PaxInstruments/t400-electronics/eagle/T400 Panel recommendation.pptx

Slot for USB connector

Slot for LCD cable

Slot for USB connector

V groove
