PaxInstruments/t400-electronics/documentation/enclosure-front-default.png

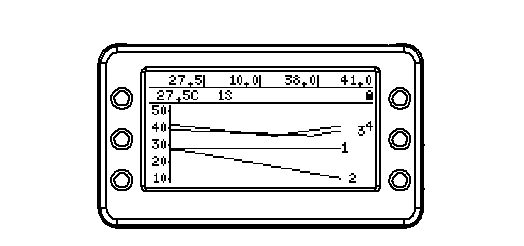
documentation/enclosure-front-default.png
