PaxInstruments/t400-electronics/documentation/u8g_font_fur42n.png

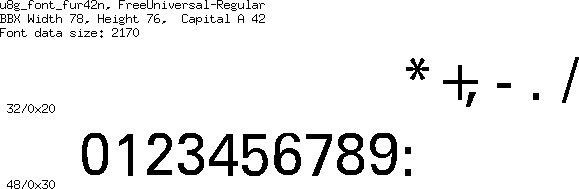
documentation/u8g_font_fur42n.png
