PaxInstruments/t400-electronics/eagle/ProductionNotes.png

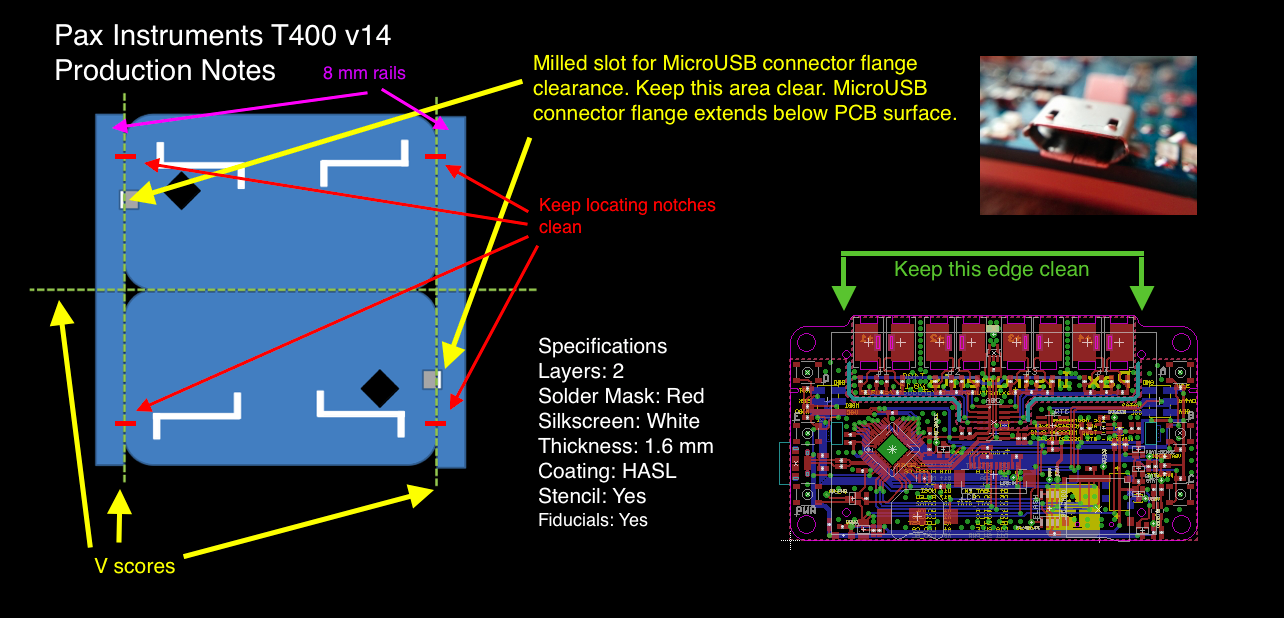
eagle/ProductionNotes.png
