PaxInstruments/t400-electronics/eagle/T400 Rev 0.14/IMG_20151219_102409.jpg

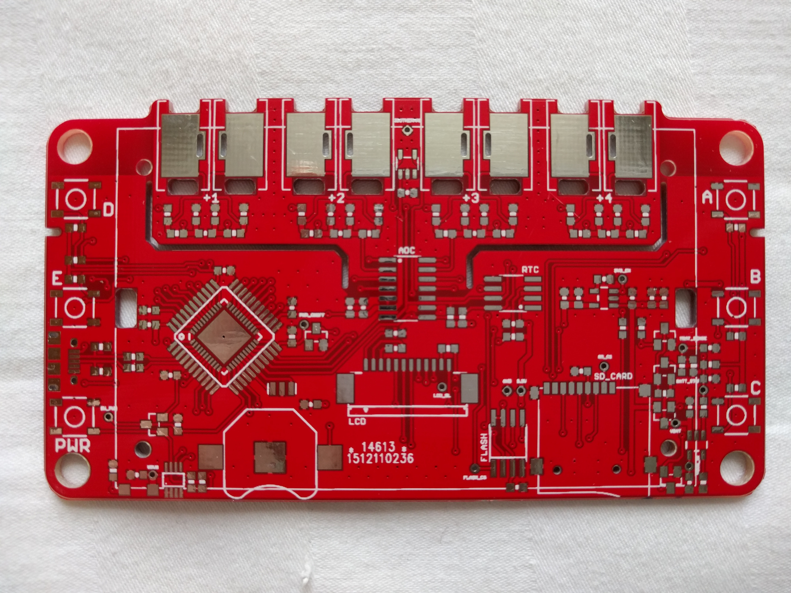
eagle/T400 Rev 0.14/IMG_20151219_102409.jpg
