PaxInstruments/t400-electronics/eagle/T400 Rev 0.14/PaxInstrument-T400-location.png

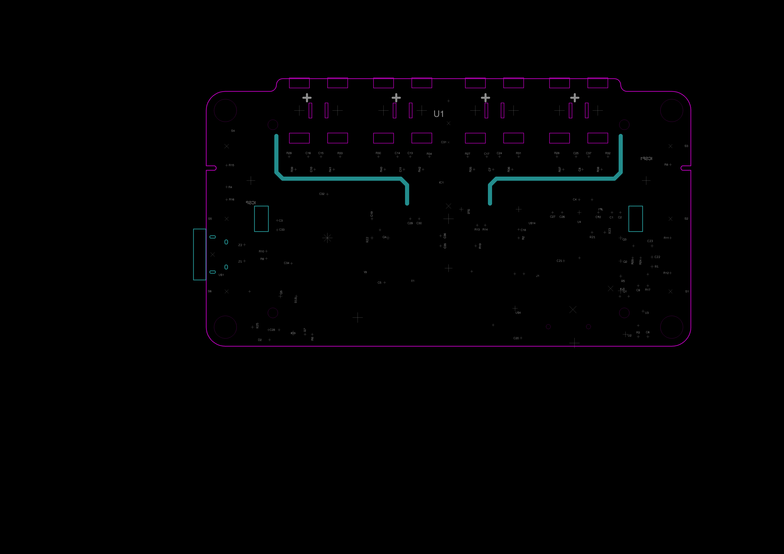
eagle/T400 Rev 0.14/PaxInstrument-T400-location.png
