PaxInstruments/t400-electronics/referenceDesigns/Arduino-leonardo-photo-back-headers.jpg

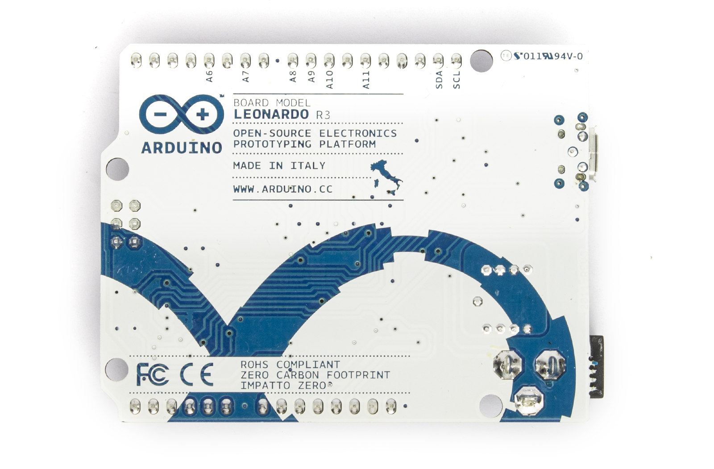
referenceDesigns/Arduino-leonardo-photo-back-headers.jpg
