PaxInstruments/t400-electronics/referenceDesigns/Arduino-leonardo-photo-front-headers.jpg

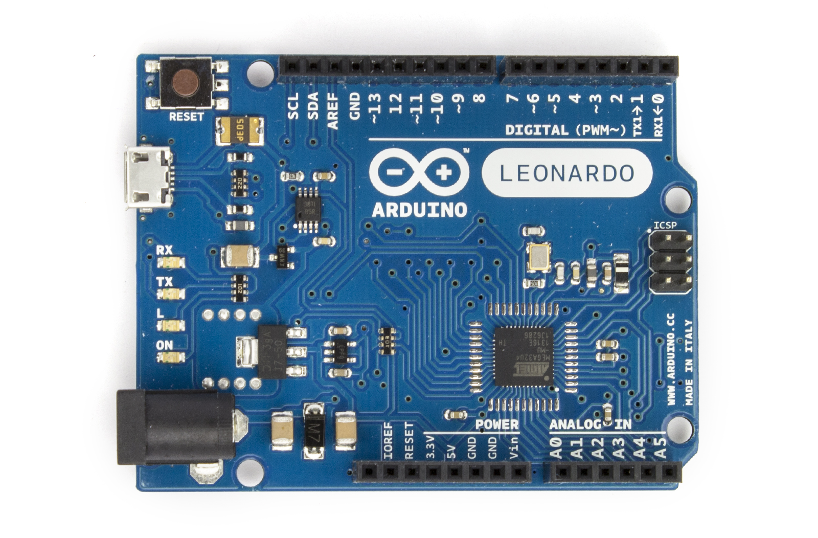
referenceDesigns/Arduino-leonardo-photo-front-headers.jpg
