PaxInstruments/t400-electronics/referenceDesigns/Arduino-leonardo-photo-front-noheaders.jpg

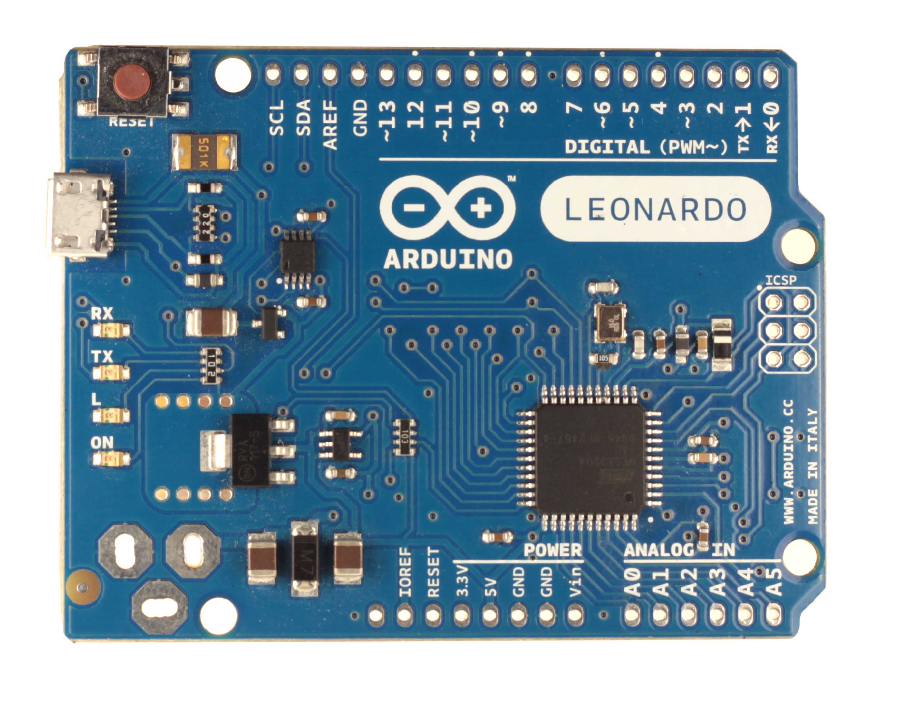
referenceDesigns/Arduino-leonardo-photo-front-noheaders.jpg
