PaxInstruments/t400-electronics/referenceDesigns/Arduino-lilypad-USB-photo-back.jpg

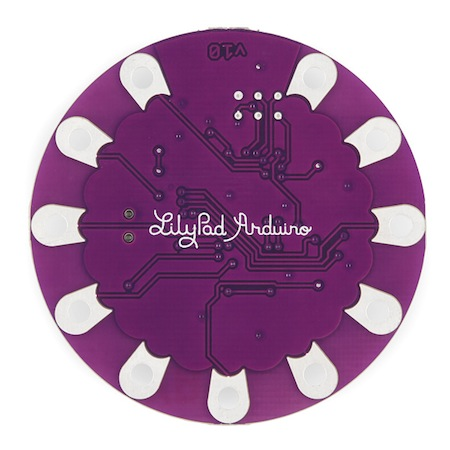
referenceDesigns/Arduino-lilypad-USB-photo-back.jpg
