PaxInstruments/t400-electronics/referenceDesigns/Arduino-lilypad-USB-photo-front.jpg

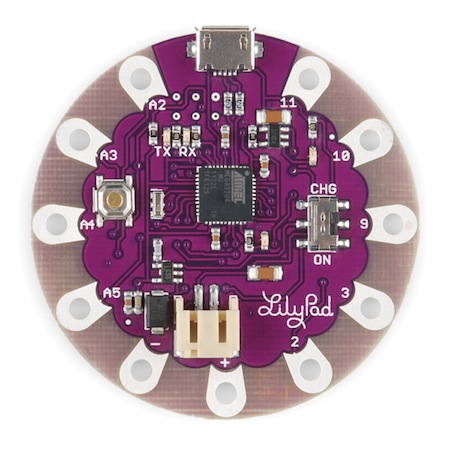
referenceDesigns/Arduino-lilypad-USB-photo-front.jpg
