PaxInstruments/t400-electronics/referenceDesigns/JeeLabs-analog-plug-photo.jpg

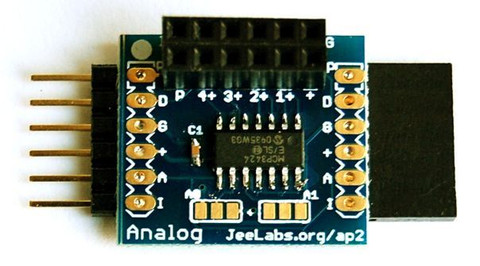
referenceDesigns/JeeLabs-analog-plug-photo.jpg
