PaxInstruments/t400-electronics/referenceDesigns/JeeLabs-jeenode-USB-photo-front.jpg

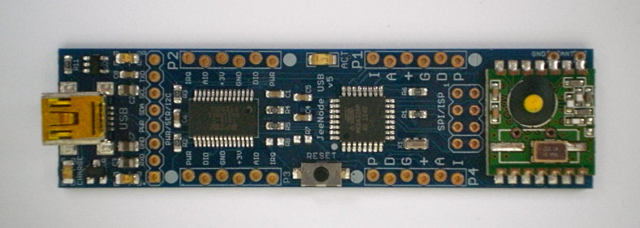
referenceDesigns/JeeLabs-jeenode-USB-photo-front.jpg
