PaxInstruments/t400-electronics/referenceDesigns/JeeLabs-precision-RTC-board.png

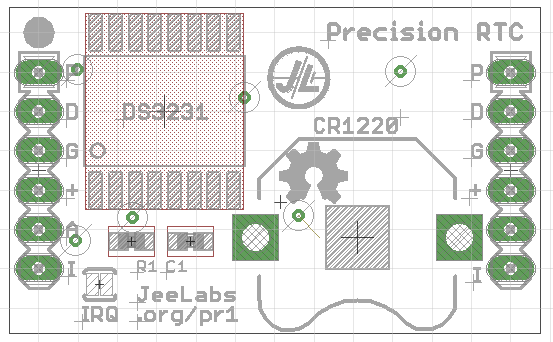
referenceDesigns/JeeLabs-precision-RTC-board.png
