PaxInstruments/t400-electronics/referenceDesigns/JeeLabs-precision-RTC-photo-front-pcb.jpg

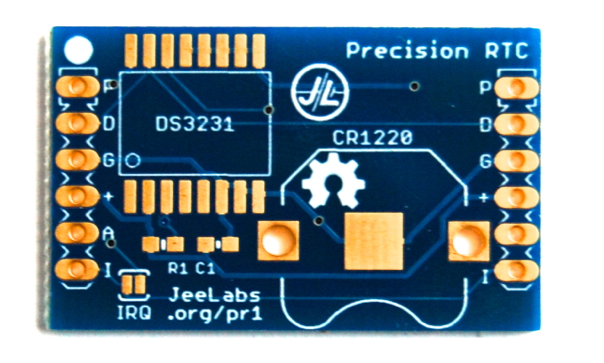
referenceDesigns/JeeLabs-precision-RTC-photo-front-pcb.jpg
