PaxInstruments/t400-electronics/referenceDesigns/JeeLabs-precision-RTC-photo-front.jpg

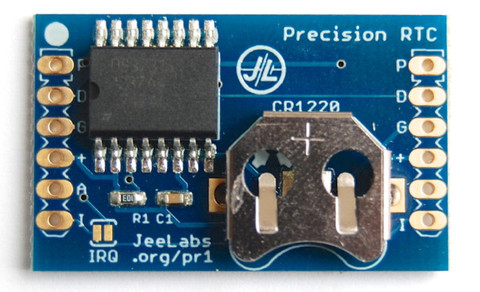
referenceDesigns/JeeLabs-precision-RTC-photo-front.jpg
