PaxInstruments/t400-electronics/referenceDesigns/LukeMiller-TC-mux-board-schematic.png

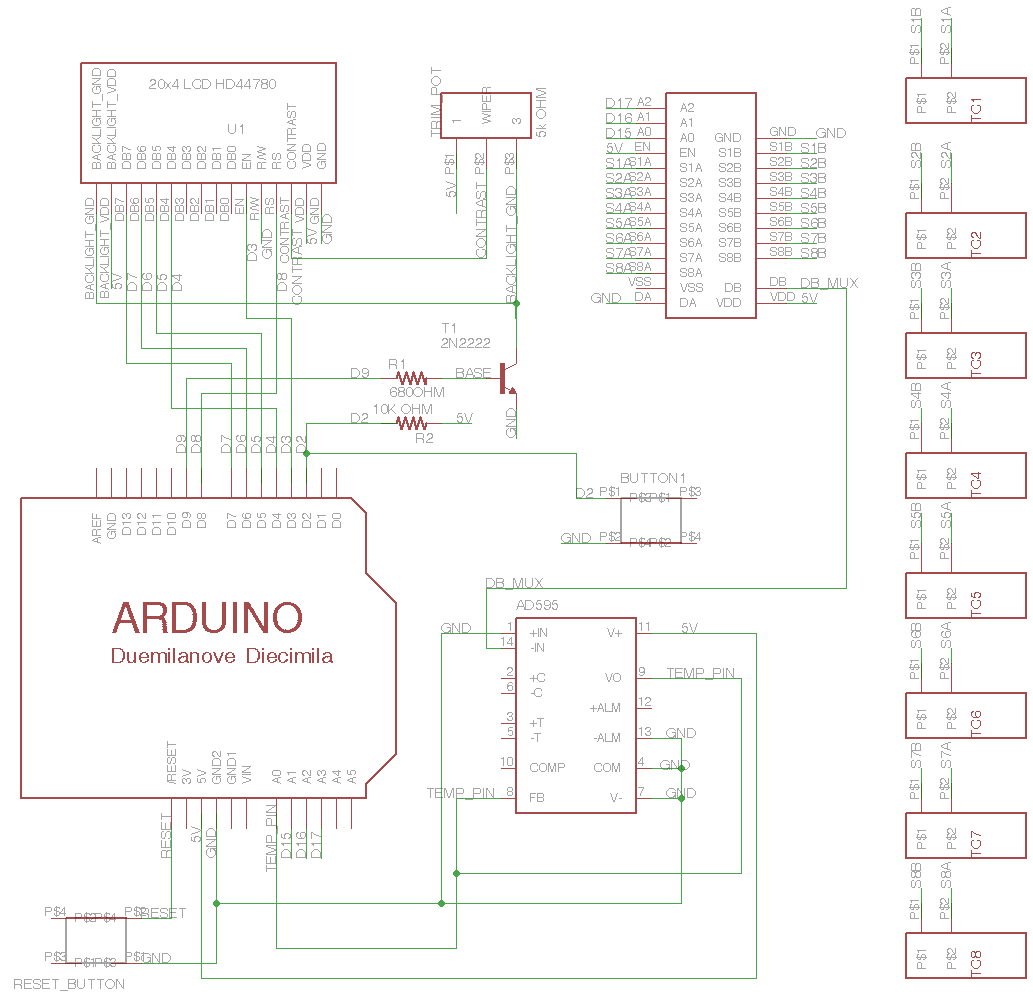
referenceDesigns/LukeMiller-TC-mux-board-schematic.png
