PaxInstruments/t400-electronics/referenceDesigns/MicroPython-board-photo-front-back.jpg

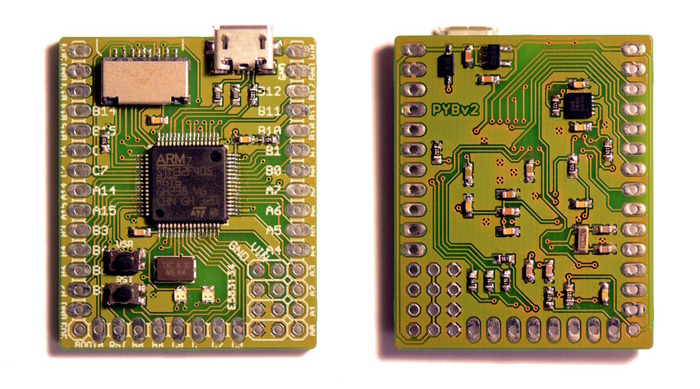
referenceDesigns/MicroPython-board-photo-front-back.jpg
