PaxInstruments/t400-electronics/referenceDesigns/SoftPowerCircuit.png

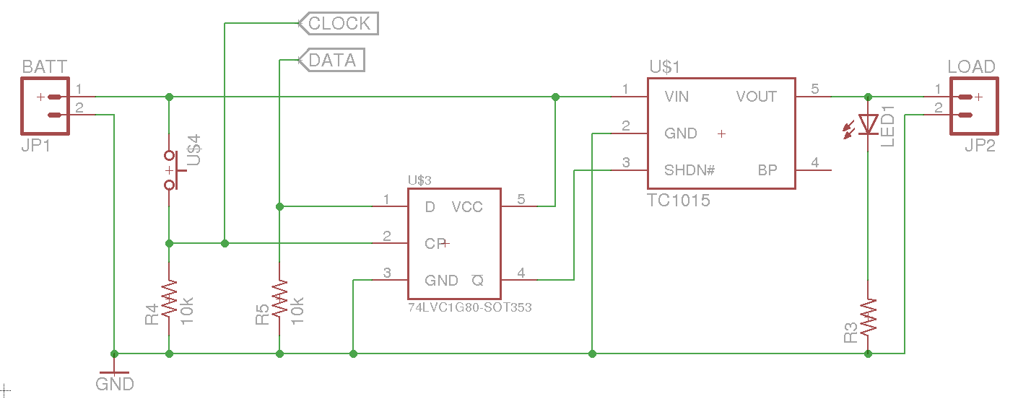
referenceDesigns/SoftPowerCircuit.png
