PaxInstruments/t400-electronics/referenceDesigns/TC4-shield-v5.30-photo-front.jpg

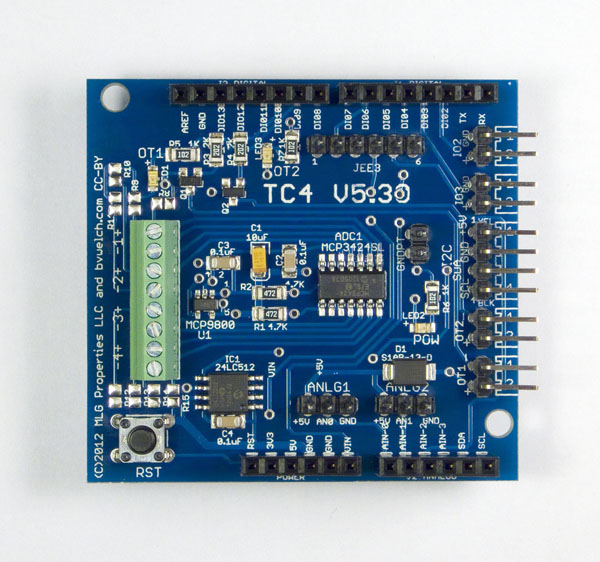
referenceDesigns/TC4-shield-v5.30-photo-front.jpg
