PaxInstruments/t400-electronics/referenceDesigns/TC4C-v1.32-photo.jpg

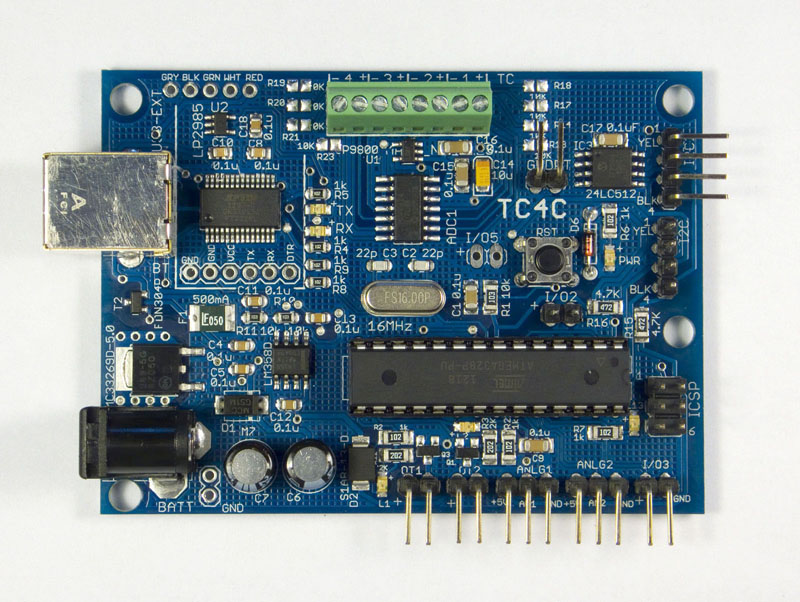
referenceDesigns/TC4C-v1.32-photo.jpg
