PaxInstruments/t400-electronics/referenceDesigns/Kytelabs-BLEduino-BoM.xlsx

Part | Quantity | Digikey # | Description | Package | Pads | Mounting type | Vendor | Descriptor
3.3V Regulator | 1 | 296-18476-1-ND | LP2985-33DBVR | SOT-23 | 5 | SMD | TI | U4
5V Regulator NCP1117-5 | 1 | NCP1117ST50T3GOSCT-ND | NCP1117ST50T3G | SOT-223 | 4 | SMD | ON | U2
3x1 Male Headers | 1 | 929400E-01-03-ND | CONN HEADER MALE 3POS.1" | 0.1" | 0 | Through Hole |  | JP4
1x14 Male Headers | 2 | 929400E-01-14-ND | CONN HEADER MALE 14POS.1" | 0.1" | 14 | Through Hole |  | JP1, JP3
Anti-Static Varistor | 2 | CG0603MLC-05ECT-ND | CG0603MLC-05E | 0603 | 2 | SMD | Bourns Inc. | Z1, Z2
ATMega32u4 | 1 | ATMEGA32U4-MU-ND | ATMEGA328P-MUR | QFN-44 | 45 | SMD | Atmel | U1
ATMega328P | 1 | ATMEGA328P-MURCT-ND | ATMEGA32U4-MU | QFN-32 | 33 | SMD | Atmel | U3
BLE Controller | 1 | MOUSER: 949-NRF8001-R2Q32-T | NRF8001-R2Q32-T | QFN-32 | 33 | SMD | Nordic Semiconductor | NRF8001
BALUN | 1 | NEWARK: 44W4473 | 2450BM14A0002T | 0603 (6 pin) | 6 | SMD | Johanson Technology | B1
CAP 100n Ceramic | 10 | 587-1456-1-ND | 0.1UF 25V 10% 0402 | 0402 | 2 | SMD |  | C1, C2, C6, C9, C10, C11, C18, C22, C30, C31
CAP 15pF Ceramic | 4 | 311-1017-1-ND | 15PF 16V 5% 0402 | 0402 | 2 | SMD |  | C20, C21, C28, C29
CAP 1nF Ceramic | 1 | 311-1036-1-ND | 1000PF 10V 10% 0402 | 0402 | 2 | SMD |  | C27
CAP 1u Ceramic | 3 | 445-4978-1-ND | 1UF 16V 10% 0402 | 0402 | 2 | SMD |  | C5, C4, C7
CAP 1uF Ceramic | 2 | 311-1372-1-ND | 1UF 16V 10% 0603 | 0603 | 2 | SMD |  | C16, C24
CAP 2.2nF Ceramic | 1 | 490-6359-1-ND | 2200PF 25V 5% 0402 | 0402 | 2 | SMD |  | C23
CAP 22p Ceramic | 4 | 311-1018-1-ND | 22PF 16V 5% 0402 | 0402 | 2 | SMD |  | C12, C13, C32, C33
CAP 22u Tantalum (Polarized) | 2 | 511-1465-1-ND | CAP TANT 22UF 10V 20% 1206 | 1206 | 2 | SMD |  | C3, C14
CAP 33nF Ceramic | 1 | 1276-1555-1-ND | 0.033UF 10V 10% 0402 | 0402 | 2 | SMD |  | C17
CAP PI Network | 1 |  | TBD | 0402 | 2 | SMD |  | C8
CAP PI Network | 1 |  | TBD | 0402 | 2 | SMD |  | C15
IND PI Network | 1 |  | TBD | 0402 | 2 | SMD |  | L1
IND 10uH | 1 | 445-3166-1-ND | 10UH 20mA 10% 0603 | 0603 | 2 | SMD |  | L5
IND 15nH | 1 | CI100505-15NJCT-ND | 15NH 20mA 10% 0402 | 0402 | 2 | SMD |  | L6
Crystal 16MHz | 3 | CTX732CT-ND | CRYSTAL 16MHZ 20PF SMD | 3.20mm x 2.50mm | 4 | SMD |  | Y2, Y3, Y4
Crystal 32,768KHz | 1 | 535-9536-1-ND | CRYSTAL 32,768 KHZ 12.5PF SMD | 4.90mm x 1.80mm | 2 | SMD |  | Y5
Diode | 1 | 1N4148WS-FDICT-ND | DIODE 10V SOD-323 | SOD-323 | 2 | SMD |  | D1
Ferrite Bead | 1 | MH2029-070YCT-ND | 1A 0805 | 0805 | 2 | SMD |  | L2
LED Blue | 1 | 475-2816-1-ND | BLUE ~470NM DIFFUSED 0603 | 0603 | 2 | SMD |  | BLE_CONN
LED Green | 1 | 516-1425-1-ND | GREEN ~570NM DIFFUSED 0603 | 0603 | 2 | SMD |  | L
LED Red | 1 | 516-1420-1-ND | RED ~630NM DIFFUSED 0603 | 0603 | 2 | SMD |  | ON
LED Yellow | 2 | 516-2856-1-ND | YELLOW ~587NM DIFFUSED 0603 | 0603 | 2 | SMD |  | RX, TX
Level Converter BSS138 | 3 | BSS138-FDICT-ND | BSS138-7-F | SOT-23 | 3 | SMD | Diodes Inc. | Q1, Q2, Q3
P-FET PMV48XP | 2 | 568-7579-1-ND | PMV48XP,215 | SOT-23 | 3 | SMD | NXP | T1, T2
PTC | 1 | MF-NSMF050-2CT-ND | PTC 500mA | 1206 | 2 | SMD |  | F2
RES 10K | 11 | P10KJCT-ND | 10K J 1/8W 0402 | 0402 | 2 | SMD |  | R1, R2, R4, R9, R12, R14, R18, R21, R22, R23, R24
RES 1K | 5 | P1.0KJCT-ND | 1K J 1/4W 0402 | 0402 | 2 | SMD |  | R5, R6, R7, R8, R19
RES 20K | 1 | P20KJCT-ND | 20K J 1/8W 0402 | 0402 | 2 | SMD |  | R16
RES 22 | 2 | P22JCT-ND | 22R J 1/4W 0402 | 0402 | 2 | SMD |  | R3, R10
RES 22K | 1 | P22KJCT-ND | 22K J 1/8W 0402 | 0402 | 2 | SMD |  | R11
Small Push Button | 1 | CKN10246CT-ND | SWITCH TACTILE KMR2 |  | 4 | SMD |  | RESET
Micro USB Connector | 1 | 609-4618-1-ND | 10118194-0001LF |  | SMD - 5 Through - 4 | SMD/Through-hole | FCI | X2
Don't source or populate items in RED |  |  | Descriptions are only minimum tolerances/requirements. They don't have to match exactly the digikey items.
