PaxInstruments/t400-electronics/graphics/logo.dxf

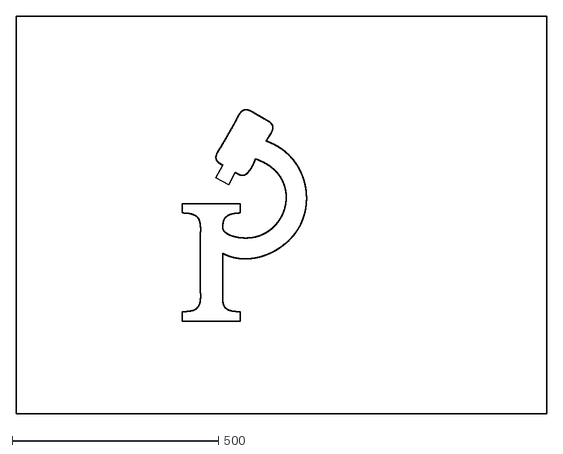
[picture p21: CAD file, 2015-01-25]
graphics/logo.dxf
1284.0 x 964.0
