PaxInstruments/t400-electronics/referenceDesigns/TC4C-v1.32-board.dxf

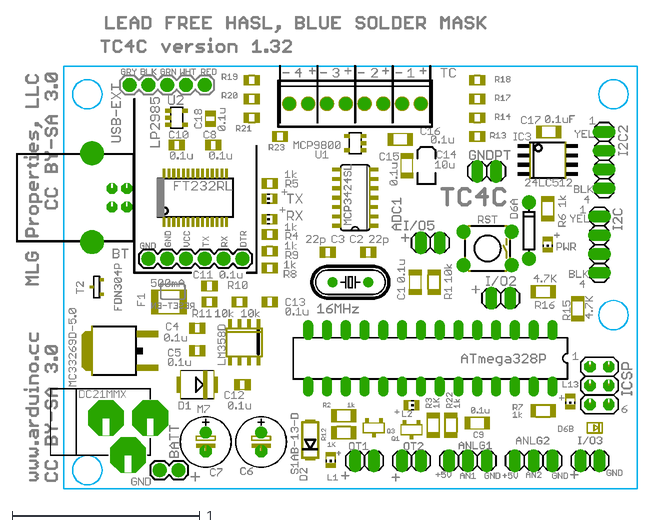
[picture p22: CAD file, 2014-09-02]
referenceDesigns/TC4C-v1.32-board.dxf
3.30 x 2.52
