PaxInstruments/t400-electronics/solidworks/t400-thermo-clip2.STEP

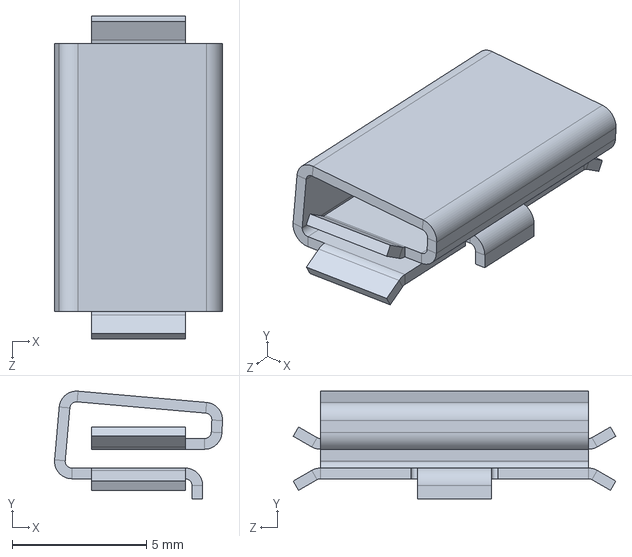
[picture p23: CAD file, 2015-06-18]
solidworks/t400-thermo-clip2.STEP
6.27 x 4.02 x 12.0 mm
