PaxInstruments/t400-electronics/solidworks/old/clip/Clip-05.SLDPRT

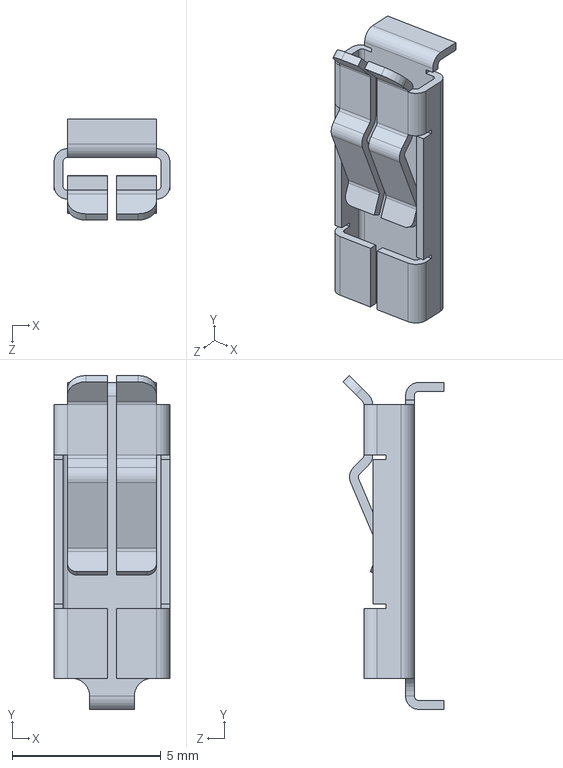
[picture p24: CAD file, 2015-03-29, an earlier design]
solidworks/old/clip/Clip-05.SLDPRT
3.90 x 11.2 x 3.41 mm
