PaxInstruments/t400-electronics/solidworks/old/tc-connector-6/tc-connector-7.SLDPRT

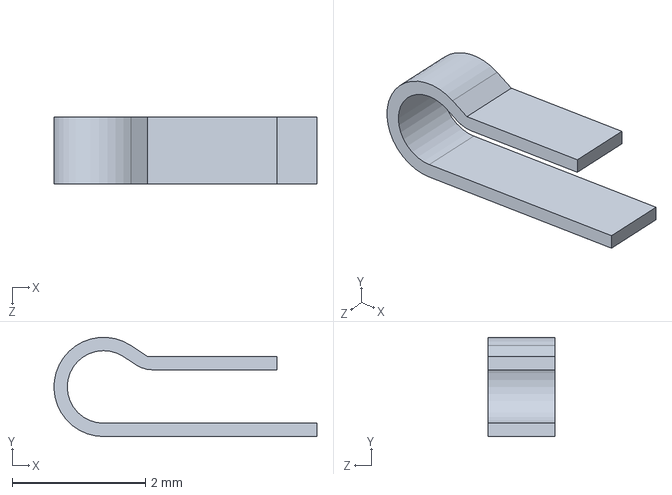
[picture p25: CAD file, 2015-04-19, an earlier design]
solidworks/old/tc-connector-6/tc-connector-7.SLDPRT
3.94 x 1.49 x 1.00 mm
