PaxInstruments/t400-electronics/solidworks/old/tc-connector-7/tc-connector-7.STEP

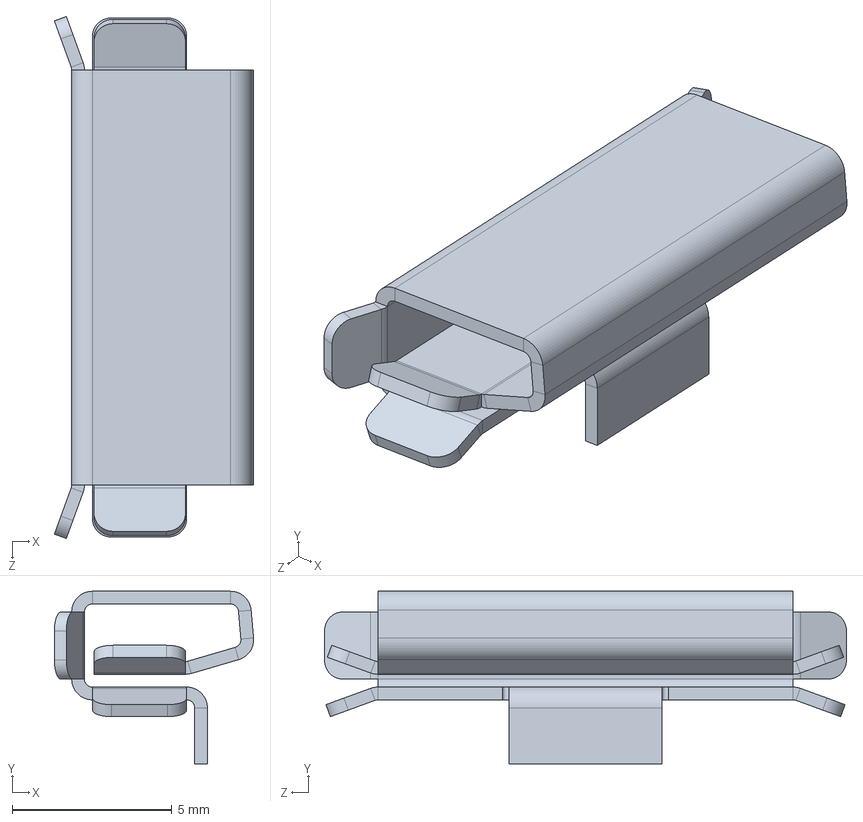
[picture p26: CAD file, 2015-06-18, an earlier design]
solidworks/old/tc-connector-7/tc-connector-7.STEP
6.24 x 5.40 x 16.3 mm
