PaxInstruments/t400-electronics/solidworks/old/clip/Part2.SLDPRT

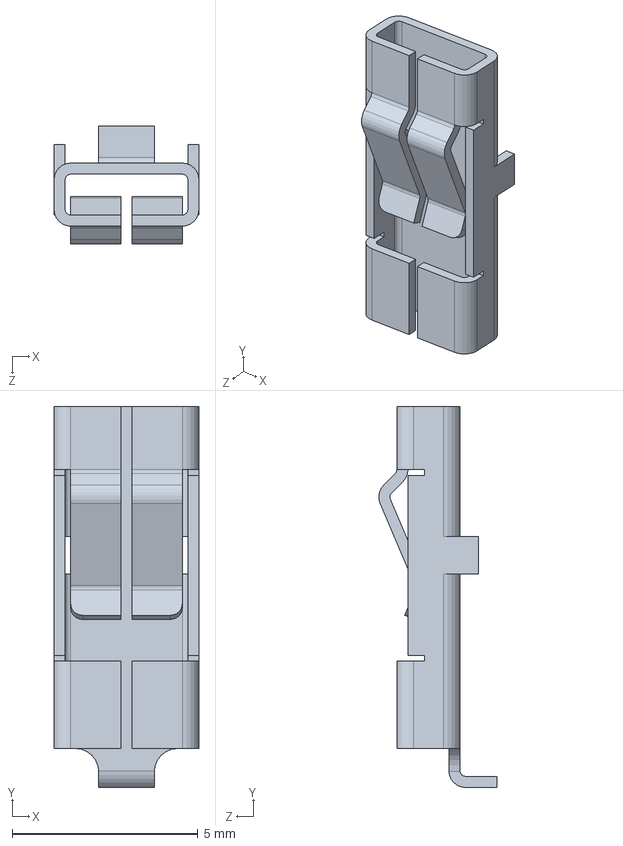
[picture p27: CAD file, 2015-03-29, an earlier design]
solidworks/old/clip/Part2.SLDPRT
3.90 x 10.2 x 3.18 mm
