PaxInstruments/t400-electronics/solidworks/old/tc-connector-5.SLDPRT

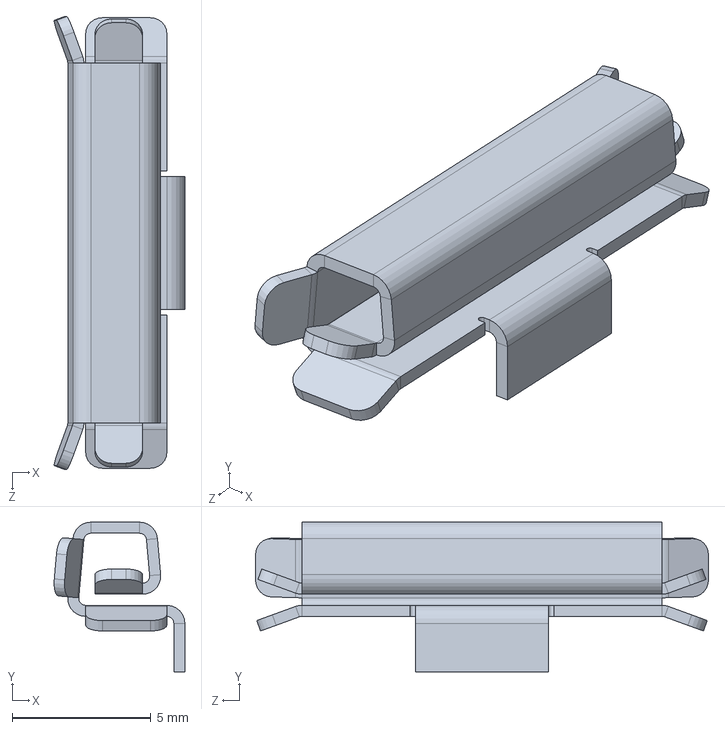
[picture p28: CAD file, 2015-04-19, an earlier design]
solidworks/old/tc-connector-5.SLDPRT
4.72 x 5.40 x 16.3 mm
