PaxInstruments/t400-electronics/solidworks/old/tc-connector-6/tc-connector-6.SLDPRT

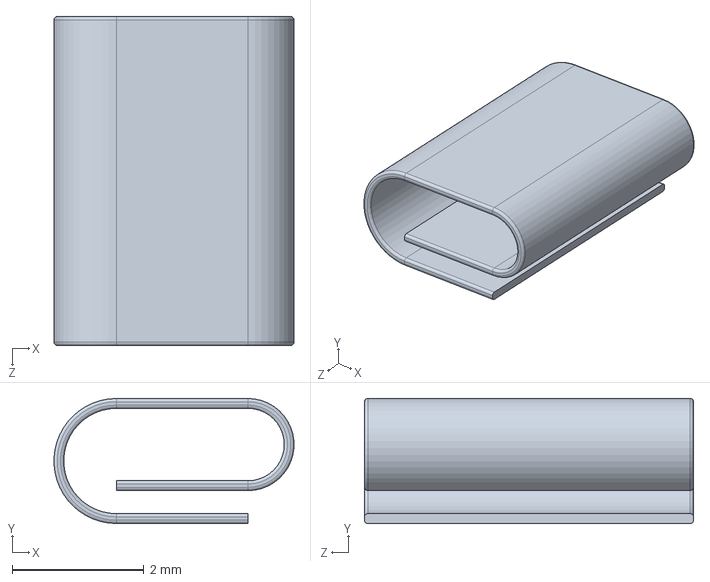
[picture p29: CAD file, 2015-04-19, an earlier design]
solidworks/old/tc-connector-6/tc-connector-6.SLDPRT
3.65 x 1.90 x 5.00 mm
