PaxInstruments/t400-electronics/solidworks/old/tc-connector-7/tube-02.igs

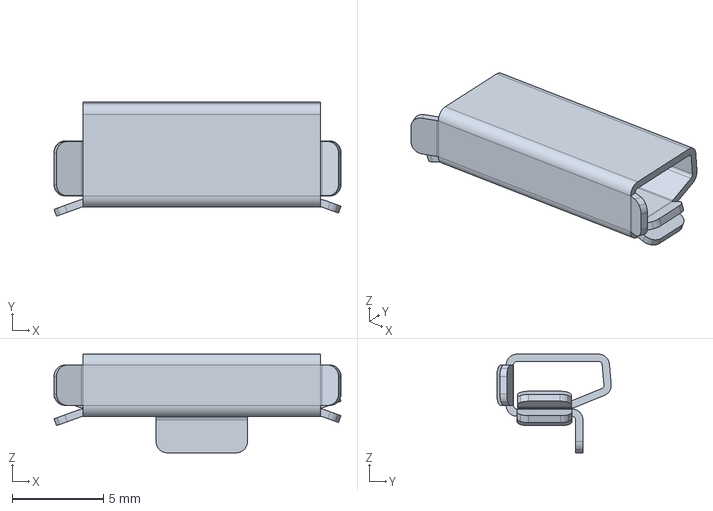
[picture p30: CAD file, 2015-04-19, an earlier design]
solidworks/old/tc-connector-7/tube-02.igs
15.7 x 6.26 x 5.40 mm
