PaxInstruments/t400-electronics/solidworks/old/clip/Clip-03.stp

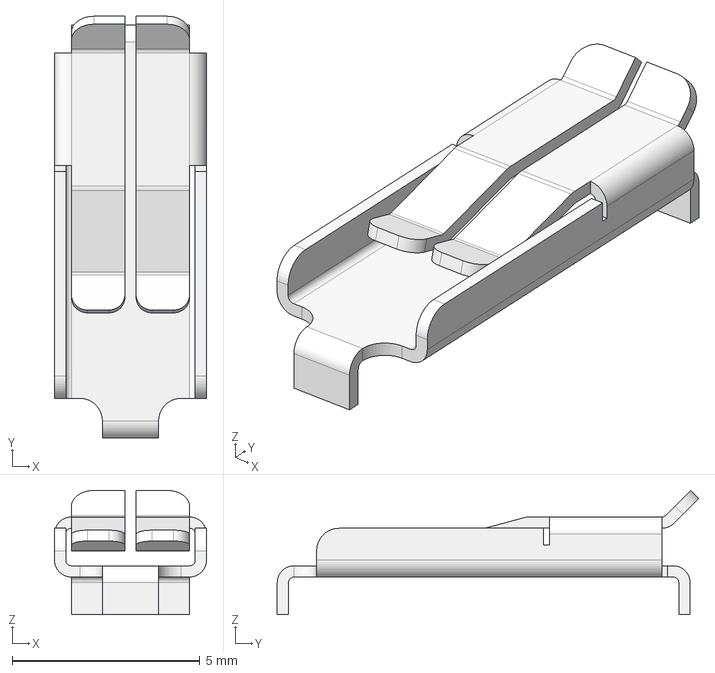
[picture p31: CAD file, 2015-03-19, an earlier design]
solidworks/old/clip/Clip-03.stp
4.05 x 11.2 x 3.31 mm
