PaxInstruments/t400-electronics/solidworks/old/tc-connector-5-iges.SLDPRT

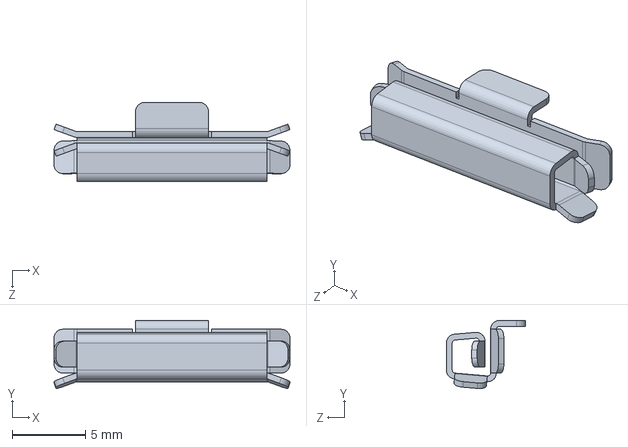
[picture p32: CAD file, 2015-04-08, an earlier design]
solidworks/old/tc-connector-5-iges.SLDPRT
16.2 x 4.66 x 5.42 mm
