PaxInstruments/t400-electronics/solidworks/old/clip/Clip-03-flat.stp

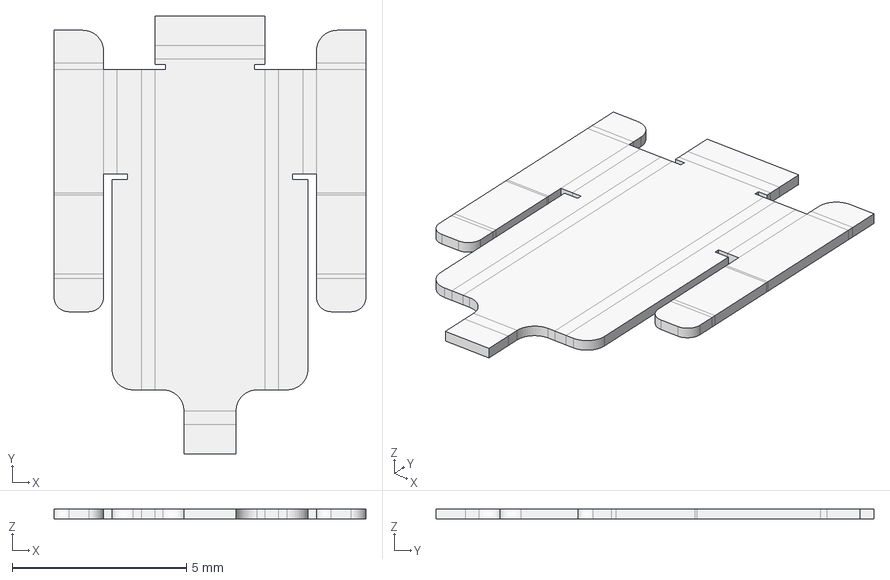
[picture p33: CAD file, 2015-03-19, an earlier design]
solidworks/old/clip/Clip-03-flat.stp
8.96 x 12.6 x 0.3 mm
