PaxInstruments/t400-electronics/solidworks/old/tc-connector-4.SLDPRT

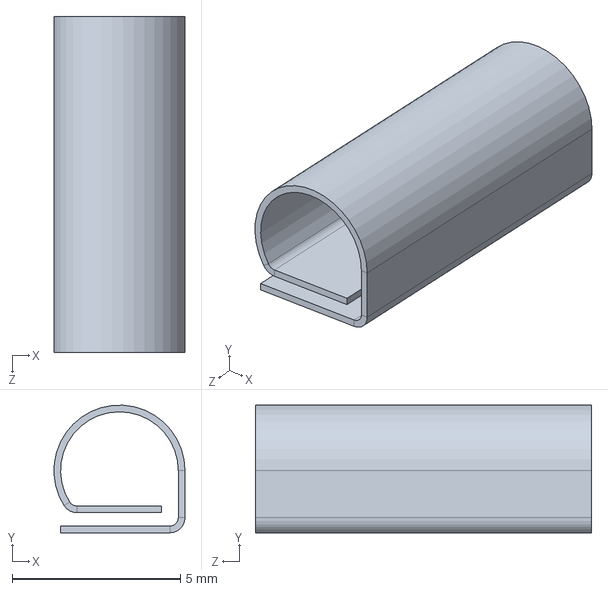
[picture p34: CAD file, 2015-04-04, an earlier design]
solidworks/old/tc-connector-4.SLDPRT
3.90 x 3.80 x 10.0 mm
