PaxInstruments/t400-electronics/solidworks/old/tc-connector-3.SLDPRT

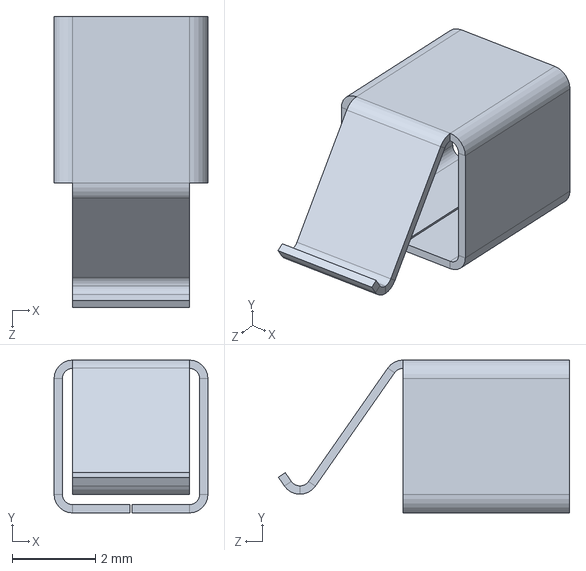
[picture p35: CAD file, 2015-04-04, an earlier design]
solidworks/old/tc-connector-3.SLDPRT
3.70 x 3.68 x 7.00 mm
