PaxInstruments/t400-electronics/(list of files, cad)

Other CAD files:
solidworks/old/tc-connector-g9.SLDPRT
solidworks/old/tc-connector-7/tube-02-STEP-AP-203.stp
solidworks/old/tc-connector-7/tube-02-STEP-AP-214.stp
solidworks/old/clip/Clip-03-flat.igs
solidworks/old/clip/Clip-03.SLDPRT
solidworks/old/clip/Clip-03.igs
solidworks/old/clip/Clip-05.igs
solidworks/old/clip/Clip-05.stl
solidworks/old/tc-connector-2.SLDDRW
solidworks/old/tc-connector-2.SLDPRT
solidworks/old/tc-connector-7/tc-connector-7.SLDPRT
solidworks/old/tc-connector.SLDDRW
solidworks/old/tc-connector.SLDPRT
solidworks/t400-thermo-clip2.SLDDRW
solidworks/t400-thermo-clip2.SLDPRT
solidworks/t400-thermo-clip2.STL
