PaxInstruments/t400-electronics/(threads)

Thread 1 (2014-08-15):

RTC battery holder is large

charlespax, 2014-08-15:
Use a smaller battery is more board space is needed. The current battery holder takes up toom much real estate.

charlespax, 2015-01-25:
Let's called this issue closed. If we need board space, a small RTC battery is an option. For now, if it's not hurting anything, let's leave it be. Closing issue.

Closed 2015-01-25.

Thread 10 (2014-08-25):

Speed up i2c

charlespax, 2014-08-25:
Determine and implement appropriate i2c pullup resistors. See http://dsscircuits.com/index.php/articles/47-effects-of-varying-i2c-pull-up-resistors

charlespax, 2015-01-25:
Notes:
- __ATmega32U4__: 10 pF, can do 100 kHz, slave/master
- __DS2321 RTC__: 10 pF
- __MCP3424 ADC__: 4 pF typical, 10 pF max
- __MCP9800 temperature sensor__: 10 pF

C_total = 40 pF

R_min (for 100 kHz and 400 kHz) = (V_cc - 0.4 V)/(0.003 A) = 1 k
R_max (for 100 kHz) = (1 us)/(C_total) = 25 k
R_max (for 400 kHz) = (0.3 us)/(C_total) = 7.5 k

For best operation in 100 kHz or 400 kHz modes we should use SDA and SCL pullup resistor values between 1k and 6.5 k.

charlespax, 2015-01-25:
We're already at 1.5k, so let's close this one.
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

Closed 2015-01-25.

Thread 14 (2014-08-25):

Use smaller diodes

charlespax, 2014-08-25:
Determine and implement the proper diodes.

samchoy88, 2015-01-09:
I evaluate the LTC4412 suggested by Tsillen, it seem the cost is too high for the circuit. (around USD$2-3 for LTC4412)
Reference: http://www.newark.com/webapp/wcs/stores/servlet/Search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

However, I also agree with him using using Mosfet to replace diode and extend battery life.
He suggested Switching Between Battery and External Power Sources by voltage supervision IC.
http://www.maximintegrated.com/en/app-notes/index.mvp/id/1136

A little bit cost for supervision IC (APX809-44SAG-7) around USD$0.2 http://www.mouser.com/ds/2/115/APX809_APX810-84245.pdf

It help to ensure USB side reach 4.38V and switch from battery power to USB power with delay and delay also avoid unstable/bouncing noise during USB start plug in.

samchoy88, 2015-01-09:
Schottky Diode selection:
Part number: RB161M-20
Forward voltage: 0.28V @ 0.5A
Forward current: 1A
Package: SOD-123
http://www.mouser.com/ds/2/348/rb161m-20-210070.pdf

P-MOSFET selection:
Brand: DIODES
Part number: DMP2035U-7
Resistance Rds: 23mOhm
Continuous Drain Current: 3.6A
Package: SOT-23
http://www.mouser.com/ds/2/115/DMP2035U-464735.pdf

samchoy88, 2015-01-09:
No decoupling cap required for supervision IC (APX809), as it needs fast response while VCC detect failure. The decoupling cap may filter the noise and less response to the VCC change.

The supervision IC has around 200ms delay to ensure the VCC voltage is stable and then switch OFF VBAT (/RST = HIGH). If any unstable voltage within that 200ms delay detected, supervision IC keeps switch ON VBAT (/RST = LOW).

If supervision IC detected VCC drop below Reset Threshold voltage, it switch ON VBAT (/RST = LOW) immediately which act similar to uninterruptible power supply (UPS).

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

charlespax, 2015-01-09:
This looks great to me. If you think we should do it, let's do it.

samchoy88, 2015-01-11:
I think Tsillen suggested good improvement on charging circuit for T400.
Let's try in Rev 0.10.

charlespax, 2015-01-11:
Awesome! Let's do it. Thanks, @Tsillen :-)

charlespax, 2015-01-25:
Done.

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

Closed 2015-01-25.

Thread 17 (2014-08-25):

Custom thermocouple connector

charlespax, 2014-08-25:
Create a custom thermocouple connector. The fuse connectors currently in the prototypes are not a long term solution. Something similar with a more flexible metal should work.

charlespax, 2015-01-25:
It looks like we'll need a custom connector. Let's find a solution after sending out for Electronics version 0.10 boards. See https://github.com/PaxInstruments/t400-electronics/issues/92

samchoy88, 2015-01-27:
Since you have tried the fuse clip from China market and reputable source like "Keystone".
And you experienced some mini thermocouple connectors are slightly different and larger ones will deform the connector such that slightly smaller connectors will then no longer fit snugly in the connector.

Custom connector:
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

Keystone connector:
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

What is the key feature of custom thermocouple connector that made it become durable and will not deform by slightly larger thermocouple connectors?

charlespax, 2015-01-27:
I don't know a key feature. We have to contact factories and see how they can help us.

Tsillen, 2015-01-29:
Probably use something like spring steel. It will keep it's original shape unless you really brute force it.
It might be a better idea to skip the well known thermocouple connector and use another style of connector.

There are plenty low pin-count, long durability and reasonably priced industrial connector available.

charlespax, 2015-03-18:
I'm moving this to the next mileston.

charlespax, 2015-03-19:
Here is Tully's initial proposal:

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

charlespax, 2015-03-19:
My response:

That looks great! I really like this concept :-) I have a few design
ideas we should talk about. I head back to the US Friday, so it would
be great to discuss before then. Today would be great.

Here’s some ideas I had. Just some brainstorming…
- Keyed. Front and back through hole parts can be different sizes, so the connector can be placed in only one orientation. Reduce worker mistakes. See attached
- Chamfered entry way. Small flange on the entry to help guide the male connector into place. Can also have flanges for both the horizontal and vertical. See attached.
- A second springy part at the entry way. Doesn’t have to be super strong. Just enough to keep the male blade flat against the connector.
- One spring tab each direction. This could address the ideas above. The male connector would be pressed down in two places. It could also act as a guide for the male blade contact. It would also make a keyed design obsolete.
- Packaging. I imagine these will be loose packaged and will be placed by hand for the first batch. It would be awesome if we could get these packaged on reels. Maybe we can include any features necessary for package the parts on reels and features for the pick and place machine.

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

I don't think the horizontal tabs are a good idea. They limit how close the connectors can be to each other. They are small and may be difficult to manufacture. The male thermocouple connectors already have rounding on their blade tips that would give the same effect.

Maybe we can make it such that a vertical wall extends the length of the connector. This could help prevent the male connector from moving side to side if twisted laterally.

Here is what the flat pattern could look like:
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

When bent up it could look like this:
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

charlespax, 2015-03-19:
Tully's response:

 made some changes to the design. I haven't thought about these changes very much yet. I will probably make a few more designs and send them all to the tooling company. Basically I need to go to bed and will think about this more.

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

charlespax, 2015-03-19:
It would be nice if we could tighten up  width a bit. It really depends on the manufacturing tolerance of the connector. 3.3 mm would be good.
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

The Omega mini thermocouple connector drawing give 3.17 mm for the largest male connector width. The connectors I have with me measure 3.1 mm and 3.14 mm.
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

We will have to increase the interior height. The Omega specification gives 0.8 mm, but the connectors I have with me measure 0.92 mm and 1.0 mm. The main problem with the off-the-shelf connector we were using was that it would deform when the thicker male connectors were inserted. I want to avoid that here.
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

We need to make contact point much closer to the entrance. The Omega spec gives 12.7 mm as the terminal length, but the connectors I have are 10.4 mm and 10.8 mm.

Maybe we can reverse the insertion direction and extend the tab. This might give us the chamfered entrance and allow us to put the contact point closer to the entrance.
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

We need to make contact point much closer to the entrance. The Omega spec gives 12.7 mm as the terminal length, but the connectors I have are 10.4 mm and 10.8 mm.

Maybe we can reverse the insertion direction and extend the tab. This might give us the chamfered entrance and allow us to put the contact point closer to the entrance.
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

charlespax, 2015-03-24:
Here is the latest version of the clip. It's looking pretty sweet.
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

MLXXXp, 2015-03-24:
If the two contacts that bend upwards, when the pin slides under them, are springy enough to allow many insertions, do you think they will also end up distorting on the bends that join them to the sides?
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

MLXXXp, 2015-03-24:
I don't know if it's possible from a manufacturing standpoint, but perhaps reversing the design, so the split is on the bottom, would be better.

The blue splits become solid and the red is the new split.
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

charlespax, 2015-03-24:
@MLXXXp I imagine the area I circled in green would flex a little, but it shouldn't flex any more than the area I have circled in blue. I think it wouldn't cause any problems, but I haven't done any FEA.

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

charlespax, 2015-03-24:
There may be a problem with how deep the connector inserts into the T400.

Here is the current connector version.
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

The thermocouple would have to go a minimum of 5.7 mm into the connector to make contact. The shortest thermocouple connector I've seen is about 10 mm. Those numbers work well if the male part is fully inserted into the female part.
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

For the T400 a male thermocouple connector must pass through the enclosure and a gap before it inserts into the female connector. In this image the black line marks off the point of contact.
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

We could have an indentation in the top panel, so the male connectors would only have to pass through the thickness of the enclosure. That would get the job done, but isn't the best contact and may not be very secure.
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

We could remove the tab from the entrance of the connector and have two tabs on the sides. This would allow us to hang the connector over the edge and span the gap or part of the gap.
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

This would, however, cause some assembly problems when installing the top panel. I think we could overhang about 1.5 mm without causing problems. Perhaps a combination of wings on the sides and an indentation in the top panel is the solution.

MLXXXp, 2015-03-24:
Why not (perhaps additionally) go with one of your earlier suggestions:

> Maybe we can reverse the insertion direction and extend the tab. This might give us the chamfered entrance and allow us to put the contact point closer to the entrance.

The current design lends itself to this.

tully, 2015-04-03:
I made these models quickly so we can get pricing and know that the supplier can make them. Let me know what tweaking you think they need? These are the pictures I sent to the supplier.
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

charlespax, 2015-04-04:
Looks good. I think we'll have to tweak the 0.776 mm gap for the connector
since the Omega TC connector is specced at 0.8 mm. Can you do FEA on this?
If not, I'll get Nick in it.
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

charlespax, 2015-04-08:
I've uploaded a Solidworks model from Tully's iges file. See tc-connector-5.sldprt.
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

starno, 2015-04-24:
I modified the design until it deflected the appropriate amount given the desired plugin and removing forces.  The best performing shape looks like an e or a 9, thus E9.

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

Check out e35fd20581d6aff1ef34da704d4adacb0f3f28c7 on the enclosure branch

charlespax, 2015-04-25:
Okay, we have a part that @starno and I think will work. The solidworks file can be downloaded directly from https://github.com/PaxInstruments/t400-enclosure/blob/master/Injection%20Molded/t400-thermo-clip2.SLDPRT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. I slightly modified the file to dimensionally constrain the flanges.

@tully if you think this is good, we can send it to the factory. I'd like to make a drawing or whatever the factory needs directly from the solidworks file rather than recreating it in another program. What do you need from me?

charlespax, 2015-04-29:
I've added a drawing to the enclosure repository.
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

charlespax, 2015-05-04:
Here is the connector in the enclosure:
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

Maybe we should make the tab a little longer or at a different angle, so the male contacts don't intersect with the edge of the tab. @starno what do you think?

starno, 2015-05-04:
Good catch, I didn't even notice that possibility.  I think making the hole smaller to avoid jamming on the upper tab is a good fix.

charlespax, 2015-06-18:
I should have samples from the factory in two days.

charlespax, 2015-08-06:
There has been some back and forth with the connector tooling. I had the factory make a few changes and received updated samples. They did a bad job with these samples and I'm working with them to improve.

Here are the images I sent to the factor to correct the issues. On the day they are manufactured I will be sitting at the machine at the factory checking parts. We must get this right.
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

I put three footprints in the [Eagle library](https://github.com/PaxInstruments/PaxInstruments-Eagle-Libraries): a single contact, inside constraint, and outside constraint. The T400 will use the footprint constraining the male connector on the outside, the first image.
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

charlespax, 2015-08-08:
Now I'm just sorting out manufacturing issues. Finally closing this issue.

Closed 2015-08-08.

Thread 27 (2014-08-25):

Pax Instruments logo missing

charlespax, 2014-08-25:
Fix: Add the new scope logo.

samchoy88, 2015-01-07:
This logo should put on PCB?
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

charlespax, 2015-01-07:
Oh no! That's not the logo. I need to get you a proper SVG image.

This is the logo.
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

samchoy88, 2015-01-25:
Do you have higher resolution logo?

I am going to import in PCB, I made the logo from
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

The logo look like below.
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

charlespax, 2015-01-25:
I've added t400-electronics/graphics/ which contains the logo in raster and vector formats.

samchoy88, 2015-01-25:
I made the logo with size 270x270 mil.
it locate at bottom side near battery holder.
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

charlespax, 2015-01-25:
It's in Github. Closing issue.
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

Closed 2015-01-25.

Thread 36 (2014-09-01):

Reduce off state power draw

charlespax, 2014-09-01:
I like your power management circuitry, but I noticed that you currently use a 10k/30k resistor divider for measuring the battery voltage, which would drop >100uA with the device turned off... maybe either increase the resistances or stick a mosfet on the low side. - janekm

mikeselectric stuff provided:
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

See janekm and mikeselectricstuff at http://www.eevblog.com/forum/oshw/pax-instruments-t400-thermocouple-temperature-datalogger/new/?topicseen#new

charlespax, 2015-01-25:
I believe this has been addressed in https://github.com/PaxInstruments/t400-electronics/issues/42. Closing issue.

Closed 2015-01-25.

Thread 37 (2014-09-01):

What test points are needed?

charlespax, 2014-09-01:
There are test points on the thermocouple pads. Where else should they be? This is needed for any test fixture that is made for production.

samchoy88, 2015-01-05:
Currently at Rev 0.9 has following test point:
-GND
-3.3V
-VBUS
-USBVCC
-VBUS_IN
-VBAT

But I think we need more test point and verify following signal:
- BATT_STAT
- VBAT_SENSE
- VBAT_EN
-3V3EN

samchoy88, 2015-01-25:
Test point list in Rev 0.10:
- 3.3V
- GND
- VBAT_SENSE
- LCD_BL
- BATT_STAT
- VBUS_IN
- VBAT
- SD_CS
- FLASH_CS
- SW_PWR
- PWR_ON/OFF
- USBVCC
- VBUS

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

samchoy88, 2015-01-25:
Added ISOTHERMAL GND test point to make sure it connected to normal GND.

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

charlespax, 2015-01-25:
I think we can close this out. If we need other points for the test jig, we'll have to open other issues.

Closed 2015-01-25.

Thread 43 (2014-09-01):

What are the effects of input voltage on the 32u4 internal reference voltage?

charlespax, 2014-09-01:

samchoy88, 2015-01-07:
I double check on Atmega32u4 datasheet.
It seem we connected the AREF to 3.3V of the regulator. It means the MCU ADC conversion is base on 3.3V as reference voltage.
Otherwise, I should connect the AREF to a filter capacitor only and software required to set register using 2.56 internal reference.
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

Should I disconnect the AREF to 3.3V?

charlespax, 2015-01-15:
I was incorrect in my understanding that the AREF is different from the 2.56 V internal reference and they can be used independently. It seems we can select between INTERNAL or AVcc in software. That's probably better than AVcc being hard-wired to VREF. I think you're right and we should hook AREF to a capacitor. @cibomahto what do you think? It affects the software, so I don't want to make a change unless you give the okay.

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

The idea on the table is to use the internal 2.56 V internal reference to partially calibrate the AREF value. From further reading I see that it will not make things generally more accurate. See http://www.skillbank.co.uk/arduino/measure.htm and http://www.re-innovation.co.uk/web12/index.php/en/information/electronics-information/accurate-voltage-measurement

However, the internal 2.56 V internal voltage reference may be useful as a reference for measuring the battery voltage as the battery voltage drops below approximately 3.5 V. As the battery voltage decreases the MIC5219 output voltage will be affected. The problem is that the battery voltage affects the reference voltage from which we are measuring the battery voltage.

MIC5219 output V versus input V:
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

samchoy88, 2015-01-19:
Do you want me disconnect 3.3V from ARef pin and use internal 2.56V reference?

This is Rev 0.8 connection:
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

charlespax, 2015-01-20:
Yeah, let's do it and add the bypass cap.

charlespax, 2015-01-25:
Here is the issue to address this int he firmware: https://github.com/PaxInstruments/t400-firmware/issues/21

samchoy88, 2015-01-25:
Disconnected to 3.3V
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

charlespax, 2015-01-25:
Nice. Closing issue.

samchoy88, 2015-02-06:
In Rev 0.10, the ARef Pin measured 2.508V while software selected internal voltage reference.
However, the ARef Pin measured 3.269V while software selected default voltage reference.
It seem the internal voltage reference has high tolerance then using default voltage reference.

charlespax, 2015-02-06:
@samchoy88 I don't understand what you mean. The internal voltage reference of the ATmega32U4 has a 2.56 V nominal voltage.

samchoy88, 2015-02-06:
As the Reference voltage is critical for calculating the VBAT voltage value.
I expect using internal 2.56V voltage reference. and calculate the VBAT level by ADC x 2.56V / 1023.
However, I found the VBAT value does not match with measuring point.

After checking the circuit and ARef pin, the internal voltage reference only supply 2.508V and causing incorrect result in calculation.

Closed 2015-01-25.

Thread 53 (2014-09-01):

Does the thermocouple filtration circuit affect the ADC readings?

charlespax, 2014-09-01:
Ref. https://github.com/PaxInstruments/t400-firmware/issues/91
Ref. https://github.com/PaxInstruments/t400-firmware/issues/92

samchoy88, 2015-01-07:
I think the filtration circuit give more accuracy on ADC reading. As long wire usually act like antenna and collected lot of electrical noise from appliances.

charlespax, 2015-01-08:
There are 500R resistors in series with the thermocouples. Do these affect the readings at all? What if the the two resistors on a thermocouple are not perfectly matched?

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

samchoy88, 2015-01-08:
If my calculation is correct
Vi = ADC Differential input voltage
V1 = positive input
V2 = negative input
R = resistor value
Delta R = resistor tolerance
V = Thermocouple Voltage
I = Current flow in/out ADC

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

As a result, the ADC voltage affected by resistor tolerance show as follow:
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

I think the current flow is very low (below 1uA), the effect may not significant
Or we can resistor with lower tolerance (Higher price) to reduce the effect by resistor tolerance.
Below is the reference of chip resistor price and tolerance.
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

charlespax, 2015-01-08:
The big question is, what is the value of I when taking a measurement?

V = V_i (dR + dR)
V = V_i +/- I*(dR + dR)
V = V_i +/- 2I*dR
dR = 10% = 1/10
V = V_i +/- 2I(Ohm)/10
V = V_i +/- 2I(Ohm)/10
I = 1 A, error = +/- 0.2 V
I = 1 mA, error = +/- 0.2 mV
I = 1 uA, error = +/- 0.2 uV
I = 1 pA, error = +/- 0.2 pV

samchoy88, 2015-01-09:
The input impedance usually very high for ADC input.
Here are the electrical characteristics of MCP3424, the impedance is 2.25M/PGA. (PGA = 1, 2, 4, 8)
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

I expect the thermalcouple generate below 1V (I guess) , the maximum current flow is (neglect 500 resistor in series in the calculation)
I = 1V / (2.25M/8)
I = 3.56uA.

As a result dR = 500*10% = 50
Error = 2*I*dR
Error = 2*(50)*(3.56uA)
Error = 0.356mV

If you choose R with 1%, Error will significantly improved to Error = 0.0356mV
If you choose R with 0.1%, Error will improved to Error = 3.56uV
If you choose R with 0.05%, Error will improved to Error = 1.78uV

*Remark above calculation base on themercouple is 1V output

charlespax, 2015-01-09:
As a rough estimate we can say it's 20 °C/mV (http://www.pyromation.com/Downloads/Data/emfk_c.pdf), which gives us
```
+/-1% resistor,  Error = +/-0.0356mV, +/-0.73 °C
+/-0.1% resistor, Error = +/-3.56uV, +/-0.073 °C
+/-0.05% resistor, Error = +/-1.78uV, +/-0.0356°C
```
Does that sound right?

samchoy88, 2015-01-09:
After I saw the thermal-couple temperature-Voltage table, I found the voltage within -6.5mV (-270°C) ~ 55mV (1370°C) which is far lower then I expect 1V output.

Vt =  thermal-couple output voltage.
PGA = ADC gain
Base on the measuring range:
Error = 2 x (Vt/(2.25M / PGA)) x dR

charlespax, 2015-01-09:
So what is the maximum error due to the resistors?

samchoy88, 2015-01-25:
In the table, at temperature 25°C the voltage should be 1mV.
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

V-Error = 2 x (Vt/(2.25M / PGA)) x dR

Vt = 1mV
PGA = 8
R = 500 Ohm
R-tolerance = 10%, 1%,  0.1%
dR = R x R-tolerance

V-Error = 3.56uV x R-tolerance
Therefore R-tolerance = 10%, V-Error = +/-0.356uV,
Therefore R-tolerance = 1%, V-Error = +/-35.6nV
Therefore R-tolerance = 0.1%, V-Error = +/-3.56nV

at 25°C, we can say it's increase or decrease 1°C cause around 0.04mV increase or decrease.
it means 0.04mV per °C.
therefore, Temp. Error = V-Error / (0.04mV/°C)
therefore R-tolerance = 10%, Error = +/-0.356uV, Temp. Error = +/-0.0089°C
therefore R-tolerance = 1%, Error = +/-35.6nV, Temp. Error = +/-0.00089°C
therefore R-tolerance = 0.1%, Error = +/-3.56nV, Temp. Error = +/-0.000089°C

However, you may find the Temp. Error is proportional to Vt.
That means Temp. error will be magnify when measurement temperature goes extreme High/Low.

charlespax, 2015-01-25:
Okay. Let's use 1% resistors or better in manufacturing. Closing issue.

samchoy88, 2015-04-24:
I check on the available of resistors, it seem 499 ohm has more available in market.
I would like to change component value from 500 Ohm to 499 Ohm, to avoid shortage of supplier.
This value change only affect the cut-off frequency a little bit (500 Ohm with 318.31Hz cut-off freq. and 499Ohm with 318.94Hz cut-off freq).

Part number: TNPW0603499RBEEA
Tolerance: 0.1% (498.501 ~ 499.499 Ohm)
Temperature Coefficient: 25ppm/K

http://www.mouser.com/ds/2/427/tnpw_e3-64594.pdf

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

charlespax, 2015-04-24:
A wonderful idea! Let's do it.

Thread 59 (2014-09-02):

Properly ground isothermal plane

charlespax, 2014-09-02:
Review the grounding on the isothermal plane. The thermocouple filtration links to it.

samchoy88, 2015-01-07:
The PCB design should have better planning and avoid noise affecting ADC.
It may require to place the regulator in better position.
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

Reference: http://www.silabs.com/Support%20Documents/TechnicalDocs/an203.pdf

charlespax, 2015-01-08:
In addition to regulator placement should be be isolating GND and ISOTHERMAL with a resistor, inductor, both, something else, or nothing at all?

samchoy88, 2015-01-09:
It seem the Analog ground and Digital ground connected by 0 Ohm resistor.
But the resistor should place nearby Power supply and close to device with mixed signal.

charlespax, 2015-01-25:
These two issues are not pretty much the same https://github.com/PaxInstruments/t400-electronics/issues/123.

charlespax, 2015-01-25:
Done. Closing issue.

Closed 2015-01-25.

Thread 68 (2014-09-02):

Add both QFN and TQFP footprints for the 32u4

mhenstell, 2014-09-02:
32u4's are hard to source for some reason, adding both footprints gives you some flexibility in component sourcing.

samchoy88, 2015-01-08:
per our discussion at lunch, here are the stock and price of ATmega32U4 in most distributors.
Reference link: https://octopart.com/partsearch#!?q=ATmega32U4

ATmega32U4-AU = TQFP package
Atmega32U4-MU = QFN package
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

charlespax, 2015-01-08:
Nice! It looks like we can kill the QTFP footprint as the QFN package will be available enough for us.

samchoy88, 2015-01-22:
Updated board components placement in Rev 0.10. More space are allow for TQFP package.

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

charlespax, 2015-01-22:
Beautiful!

charlespax, 2015-02-09:
This was implemented in Electronics version 0.10. Moving to that milestone.

Closed 2015-01-08.

Thread 71 (2014-09-04):

Battery charging and consumption

Tsillen, 2014-09-04:
What happens when the usb is connected and the battery is charging while the device is on?
I did some simulations in LTSPICE.

When using a generic diode you consume around 390mW (500mA load) in diode D2 (see pax sch).
PIC : http://imgur.com/A0nauZE
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

I looked in your design and I saw you use a schottky diode to lower the thermal effect.
So I went to LTSPICE again and used an generic schottky diode Diodes inc. B560C (~ the same specs as the one you chose). And i ran the simulation again. Now the consumption is dramatically lowered but still 191mW of heat (500mA load).
PIC: http://imgur.com/yfGBdWy
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

Because i'm going to have the same issue in my OpenBL-5C project (see my github) I went and looked for an solution.

What came up in my mind is to use some mosfets. When the USB is plugged in one mosfet goes in on mode thus running the rest of the circuit of the 5V from the usb. A second mosfet is then activated to break the connection between the battery and the 3.3V regulator.
To make this more clear see pic:

I tried a circuit with an pmos and an nmos but it wasn't an success. Another solution would be to use 2 comperators, the first one is high when the usb is connected, the second one is used to invert the low signal (when usb is not connected) to an high signal so simple and inexpensive n channel mosfets can be used. But this is quite complicated...

So I went on google and i found a chip that does it for you :
http://www.maximintegrated.com/en/app-notes/index.mvp/id/1136
or:
http://www.linear.com/product/LTC4412

If something like this is implemented in the design the battery life will be improved slightly and maybe even the measuring accuracy (everything that heats inside the case effects the accuracy).

I hope this can help you improve the design.

charlespax, 2015-01-25:
I believe this is addressed in Electronics version 0.10. Closing issue.
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

Closed 2015-01-25.

Thread 74 (2014-09-08):

Leakage current in battery Vbat_EN circuit

Tsillen, 2014-09-08:
The Vbat_en pin is (i assume) used to enable the measuring of the battery voltage.
When a microcontroller pin is low it is not 0V or (GND) but somewhere around 0.4 - 0.7V .
When the battery is at 3.7V and vbat_EN pin is low. There is a leakage current of ~120uA.
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

The same goes for when the Vbat_en pin is high. It is around micro vcc +0.5V.
This has a leakage current of -60uA worst case.
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

One could fix this by using a logic level mosfet to enable / disable the voltage measurement.

charlespax, 2015-01-25:
The Atmega32U4 datasheet indicates the I/O input leakage current is 1 uA. This is fine. Closing issue.

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

Closed 2015-01-25.

Thread 79 (2014-11-25):

Micro SD card does not reach enclosure edge

charlespax, 2014-11-25:
The SD card should be at the enclosure edge when it is inserted. We will probably need a new connector.

starno, 2015-01-02:
I decided to change the overhang to 0.7mm from the PCB edge.  The long side of the connector was cutting it a little too close to the enclosure edge.

0.79mm:
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

0.7mm:
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

charlespax, 2015-01-07:
Good call. I can see it's a bit close in the SLA print.

samchoy88, 2015-01-16:
I have a little bit confuse on the SD card hang out distance.
Current the Card lock position is at 3.64mm away from the side of PCB.
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

charlespax, 2015-01-16:
@samchoy88 you are correct. The topic of this issue is the clearance between the inside of the enclosure and the Sd card slot. They were a little too close.

charlespax, 2015-02-09:
I think this is solved in Electronics version 0.10. Let's revisit it in Electronics version 0.11 if it's a problem. See the footprint verification issue (https://github.com/PaxInstruments/t400-electronics/issues/145). Closing issue.

Closed 2015-02-09.

Thread 92 (2014-12-12):

What thermocouple connector to use?

charlespax, 2014-12-12:
We need a good solution for the thermocouple connector.

I've been using these for prototyping. I like that they have good thermal contact with the board. The major issue with this is that it deforms. Some mini thermocouple connectors are slightly different and larger ones will deform the connector such that slightly smaller connectors will then no longer fit snugly in the connector.
http://item.taobao.com/item.htm?spm=a1z09.2.9.200.riN5jg&id=19117501866&_u=n1ohf9gofd01
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

Keystone has one that could be good. I have tested similar ones from Taobao and have experienced the same deformation issue. We have ordered samples to see if the issue exists in the connector from a more reputable source like Keystone. I am, however, concerned about the thermal contact.
http://www.mouser.hk/ProductDetail/Keystone-Electronics/3546/?qs=sGAEpiMZZMsQtlBhqKq43eLjyZA2RfTM
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

Here is a mechanical drawing.
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

The Keystone connector also comes in a double housing I think would work.
http://www.mouser.sg/ProductDetail/Keystone-Electronics/3550-2/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

Here is a mechanical drawing
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

We can use a custom connector (https://github.com/PaxInstruments/t400-electronics/issues/17) if we can't find the right thing on the market. Here is the SolidWorks files in the repo.
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

For reference, here is a mini thermocouple connector drawing from the datasheet in git.
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

charlespax, 2015-01-25:
We'll use the Keystone connector for Electronics version 0.10 then seek out a custom solution. Closing issue.

Custom connector issue: https://github.com/PaxInstruments/t400-electronics/issues/17

Closed 2015-01-25.

Thread 97 (2014-12-21):

Align 2x3 headers and enclosure cutouts

charlespax, 2014-12-21:
For history see https://github.com/PaxInstruments/t400-electronics/issues/86.

charlespax, 2015-01-03:
I think there is a good spot for the headers to go. In the Enclosure version 0.1 (SLA) print I cut out the cutout and continued cutting to the wall at the top of that area.

You can see i this image where a connected header cable could sit.
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

And here is the header seated on the board in that same spot inside the enclosure.
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

And here is the header on the board without the enclosure back.
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

I think we would be okay if we moved the thermal isolation slots a bit.

samchoy88, 2015-01-05:
Please advice the location of the connector on the PCB.

From the image I estimated the location of the connector, It seem a little bit difficult to move thermal isolation slots a bit, as the slot and the component at top side around 1mm distance. It is not suggest to place component too close to the slot.
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

charlespax, 2015-01-06:
Can we move that component?

samchoy88, 2015-01-08:
Those components are thermocouple circuit, it has little bit space to move inside.

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

charlespax, 2015-01-08:
Cool. Please nudge things around, so we can move the slot and get the header in there.

samchoy88, 2015-01-15:
After I fixed the issue - Longer soler pads on 2x3 header footprint #122. The footprint pad size is larger than the component. the header cannot place on the position/orientation suggested by @charlespax.
- Horizontal orientation made not enough space for the signal to the header
- Separation between thermal-couple are fixed and not recommend to move. This made the slot can move very limited distance. (see below pictures)
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

charlespax, 2015-01-15:
It sounds like a feature we chose for the test rig is affecting the T400 design in a negative way. Any compromise that needs to be done should happen in the test rig. Rather than using the SIM connector we can figure our something else like individual spring contacts.

@samchoy88 can you place the 2x3 header in the desired location if we went back to the original footprint?

samchoy88, 2015-01-25:
Header position updated in Rev 0.10(unit = mm)
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

charlespax, 2015-01-25:
Cool. Closing issu.e

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

Closed 2015-01-25.

Thread 105 (2014-12-22):

LCD cable connector

charlespax, 2014-12-22:
We are changing the LCD cable from 0.5 mm pin pitch to 1.0 mm pin pitch. The appropriate connector should be placed on the board. See https://github.com/PaxInstruments/t400-electronics/issues/96

charlespax, 2015-01-19:
I tested that samples today and  everything works fine. It does seem like the contrast is a little different though.

charlespax, 2015-01-23:
We have four samples of the new LCDs, so we'll have them for Electronics version 0.10. Moving to the Electronics version 0.10 milestone.

charlespax, 2015-01-25:
Done.

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

Closed 2015-01-25.

Thread 108 (2014-12-23):

LCD backlight resistor

charlespax, 2014-12-23:
I made a mistake in calculating the LCD backlight resistor value. The backlight resistor value=(VLED-3.1V)/60mA, where VLED is the supply voltage for LED backlight.

I think we should change the resistor to a value that achieves the highest brightness while not exceeding the maximum current the ATmega32U4 can drain on the connected pin.

From the manufacturer engineer, "If the power supply for LED is 3.3V, R19 of your main board can be  3.3 ohm to 5.1 ohm. Of course you can use a larger resistor in order to reduce the power consumption with lower LED brightness."

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

Oh well, what's an order of magnitude among friends?

charlespax, 2015-01-25:
Implemented. Closing issue.
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

Closed 2015-01-25.

Thread 109 (2014-12-23):

Backlight brightness levels

charlespax, 2014-12-23:
I think if the LCB_BL line is on a PWM channel, we can support multiple backlight brightness levels. On Electronics version 0.9 LCD_BL is on PF7, which does not support PWM.

To implement this the LCD_BL pin will have to be swapped with something attached to a PWM pin.

This photo shows some PWM pin options.
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

charlespax, 2015-01-25:
@samchoy88 can you get LCD_BL on one of the PWM channels in Electronics version 0.10? Otherwise, we'll have to address this int he next board revision.

samchoy88, 2015-01-25:
Assigned LCD_BL to D6. (PWM available)
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

charlespax, 2015-01-25:
Cool. Closing issue.

charlespax, 2015-02-16:
Tested and working on 0.10 PCB.

Closed 2015-01-25.

Thread 111 (2014-12-23):

Thermocouple connector milled slots close to footprint edge

charlespax, 2014-12-23:
I think there is potential for the thermocouple connector milled slots to cut too much into the footprint of connector and break the connection. It really depends on how everything is soldered together. This may not even be the final connector or footprint. we should keep an eye on this.

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

charlespax, 2015-01-25:
This didn't seem to be a problem in Electronics version 0.9. Closing issue.

Closed 2015-01-25.

Thread 113 (2014-12-24):

Super capacitor as RTC backup

charlespax, 2014-12-24:
There is potential for using a super capacitor as the RTC backup rather than a battery. This has been discussed in issue https://github.com/PaxInstruments/t400-electronics/issues/1.

charlespax, 2015-01-23:
This is still a cool idea, but right now we're sticking with the battery. Moving to Electronics version :-)

charlespax, 2015-08-08:
Will not do. Closing issue.

Phoenix1747, 2018-05-27:
The problem with rechargable batteries is that you need relatively complicated charging curcuits. For the super caps, you need a diode and a resistor, that's it basically. Also there are already super caps with [6.8mm diameter, but 0.3F(!) capacitance](https://datasheet.lcsc.com/szlcsc/0-3F-3-3V_C122504.pdf). This would give you 10 times as much backup time (41 days!) at only double the diameter.

Closed 2015-08-08.

Thread 114 (2014-12-24):

Button interrupt review

charlespax, 2014-12-24:
Some of the buttons may need to be connected to interrupt pins to ensure the device can operate in logging and not logging states. We should do a review to confirm buttons are connected to interrupt pins where necessary.

In Rev 0.9 PCB, button connection assignment as below:
SW_A (Logging start/stop) ---- PIN21 (TXD/INT3) PD3 interrupt INT3
SW_B (Logging deltaT) ---- PIN20 (RXD/INT2) PD2 interrupt INT2
SW_C (C,F,K) ---- PIN32 (ICP3/CLK0/OC4A) PC7
SW_D (Toggle channel) ---- PIN40 (ADC1) PF1
SW_E (Backlight ON/OFF) ---- PIN41 (ADC0) PF0

Review in t400-firmware https://github.com/PaxInstruments/t400-firmware/issues/109

For previous discussion see https://github.com/PaxInstruments/t400-electronics/issues/60

charlespax, 2015-01-25:
@cibomahto can you confirm that all the buttons are connected in a way the Firmware will function while logging and while sleeping?

charlespax, 2015-01-26:
Here is the pinmap for the potentially relevant pins. For a full pinmap see https://github.com/PaxInstruments/t400-electronics/issues/142.

Arduino | ATmega32U4 | T400
---|---|---
D0 | 20 | SW_B
D1 | 21 | SW_A
D5 | 31 | BATT_STAT
D7 | 1 | RTC_INT
D13 | 32 | SW_C
A0, D18 | 36 | DATA2
A1, D19 | 37 | DATA1
A2, D20 | 38 | SW_D
A3, D21 | 39 | SW_E
A4, D22 | 40 | SW_PWR

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

charlespax, 2015-01-26:
@samchoy88 let's order it. Closing issue.

charlespax, 2015-01-26:
Issue for attaching all buttons to interrupt pins for the next version: https://github.com/PaxInstruments/t400-electronics/issues/143

Closed 2015-01-26.

Thread 115 (2014-12-30):

Electronics version 0.9 assembly and testing

charlespax, 2014-12-30:
In this thread we discuss assembly and testing of Electronics version 0.9.

charlespax, 2015-01-25:
This is not necessary for the Electronics version 0.10 boards. Removing form milestone.

charlespax, 2015-04-29:
Old. Closing issue.

Closed 2015-04-29.

Thread 116 (2014-12-30):

SW_PWR cannot detect button action

samchoy88, 2014-12-30:
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

I found the voltage at SW_PWR pin as below:
Button pressed: above 4V
Button released: above 1.2V

Arduino - digitalRead(SW_PWR) cannot detect the button released at 1.2V
I changed the R6 (10K) becomes 2K that can solve the issue.

charlespax, 2015-01-06:
On Electronics version 0.9 hardware I changed R6 from whatever value it was to 2k. With a 2k resistor in place I measured the voltage between GND and the point indicated below. With the button unpressed I get 3.269 V. With the button pressed I get 3.287 V.
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

Note that SW_PWR pin is Arduino digital 17, which is normally RXLED. I think our problem may be come from here. Perhaps the bootloader defines this as an output and sets it to HIGH. In the Blinkytape bootloader @cibomahto  disables RXLED and TXLED. Which bootloader did you flash onto these boards, the LilyPad Arduino USB in the Arduino IDE?

charlespax, 2015-01-25:
Problem should be solved int he new soft power circuit.

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

Closed 2015-01-25.

Thread 117 (2014-12-30):

JP1 made circuit operate at 3.6V instead of 3.3V

samchoy88, 2014-12-30:
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

I found the circuit operate at 3.6V instead of 3.3V and suspect the power circuit has some problem.
Finally found the short circut of JP1 not only made the circuit always ON, it also inject 5V to MCU I/O pin (PWR_ONOFF) and made the whole circuit voltage rise to 3.6V

charlespax, 2015-01-03:
Cool. Let's keep that resistor on the component side and have it populated. Maybe we unpopulated it later, but this is a good default for now.

charlespax, 2015-01-23:
@samchoy88 is this still an issue or is it addressed in Electronics version 0.10?

samchoy88, 2015-01-25:
addressed in Rev 0.10

samchoy88, 2015-01-25:
addressed in Rev 0.10

charlespax, 2015-01-25:
Cool. Closing issue.

Closed 2015-01-25.

Thread 118 (2015-01-04):

Power on/off output low

charlespax, 2015-01-04:
Power on/off goes output low and turns the system off all the time.

(From our discussion at lunch.)

samchoy88, 2015-01-05:
As the PWR_ONOFF pin set as output Low initially, it cause the systemturn off after JP1 has been shorted.
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

I may change circuit design to prevent this issue.

charlespax, 2015-01-05:
Background: the purpose of having JP1 in this design is to aid development by having an easy way to keep the device always using hardware rather than software.

If the jumper is not shorted and the power switched is pressed, the system will boot and set PWR_ONOFF to HIGH. Then the system will stay on until PWR_ONOFF is set to LOW.

If the jumper is shorted and PWR_ONOFF is set to LOW, logic input A will be LOW. If there were no 1k resistor in series with JP1, there would be a short, which is bad.

If the jumper is shorted and PWR_ONOFF is set to HIGH, logic input A is always HIGH. No problems in this case.

I think we need a jumper that can short logic input A to VBUS and a resistor between PWR_ONOFF and logic input A. In this case the Jumper can be shorted to VBUS and always keep logic input A HIGH. PWR_ONOFF can be high or low and not be shorted to GND because there would be a resistor.

samchoy88, 2015-01-16:
#134

charlespax, 2015-01-16:
How was it modified? Screenshot please.

samchoy88, 2015-01-16:
Changed logic gate to NAND gate. All switch and jumper pin will trigger the circuit by Low level.

Before:
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

After:
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

charlespax, 2015-01-16:
Beautiful :-)

MLXXXp, 2015-01-16:
I thought you were going to increase the value of the pullups from 10K to 100K, as per comments in issue #134.

samchoy88, 2015-01-16:
You're correct.
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

charlespax, 2015-01-16:
Done. Closing issue.

Closed 2015-01-16.

Thread 119 (2015-01-04):

Resistors are close to RTC battery

charlespax, 2015-01-04:
There are resistors that are a little too close to the RTC battery connector.

(From our discussion at lunch.)

samchoy88, 2015-01-05:
Yes, I feel a little bit danger around the RTC battery connector.
Short circuit may happen.
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

charlespax, 2015-01-05:
Agreed. let's fix this in Electronics version 0.10.

samchoy88, 2015-01-25:
Less component place nearby RTC battery in Rev 0.10 board.
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

charlespax, 2015-01-25:
Closing issue.

Closed 2015-01-25.

Thread 120 (2015-01-04):

Resistors are close together

charlespax, 2015-01-04:
There are some resistors that are a bit close together. Switching to 0603 (https://github.com/PaxInstruments/t400-electronics/issues/121) should solve this.

(From our discussion at lunch.)

samchoy88, 2015-01-05:
Yes, I found the resistor are too close at the area of 3.3Reg part. It made a little bit difficult to solder by hand.
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

samchoy88, 2015-01-05:
Yes, I found the resistor are too close at the area of 3.3Reg part. It made a little bit difficult to solder by hand.
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

charlespax, 2015-01-05:
Let's increase the distance in Electronics version 0.10.

samchoy88, 2015-01-07:
Switched to 0603 resistor and capacitor does not improve much on space.
They looks almost compatible to each other.
Capacitor in Yellow is 0805, Green is 0603

It seem I need to find a better place and space for these circuit.

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

samchoy88, 2015-01-25:
More space between resistors in Rev 0.10
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

charlespax, 2015-01-25:
Closing issue.

Closed 2015-01-25.

Thread 121 (2015-01-04):

Switch to 0603

charlespax, 2015-01-04:
Maybe we should switch from 0805 to 0603.

(From our discussion at lunch.)

charlespax, 2015-01-23:
Moving to the Electronics version 0.10 milestone. @samchoy88 are we still fully moving to 0603 or are you leaving some components at 0805?

samchoy88, 2015-01-25:
All caps and resistors using 0603 package in Rev 0.10 currently.
Last update (8c606fb) fixed all caps and resistors to 0603 (No 0805 package anymore).

charlespax, 2015-01-25:
Okay, closing issue.

Closed 2015-01-25.

Thread 122 (2015-01-04):

Longer solder pads on 2x3 header footprint

charlespax, 2015-01-04:
If we use the SIM card connector, we may want to make the 2x3 header footprint longer, so they do not have to be aligned perfectly.

samchoy88, 2015-01-05:
the programming port will apply larger pad that fit with SIM card connector:
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

charlespax, 2015-01-05:
Cool. Let's get this in Electronics version 0.10.

samchoy88, 2015-01-07:
Library changed but not significant.

Before:
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

After:
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

samchoy88, 2015-01-22:
Due to limitation of the space, we give up the longer pads on 2x3 header footprint.
Changed back to normal size.

charlespax, 2015-01-22:
Moving issue to Electronics version :-)

charlespax, 2015-08-08:
Will not do. Closing issue.

Closed 2015-08-08.

Thread 123 (2015-01-04):

Inductor between isothermal plane and GND

charlespax, 2015-01-04:
Maybe we should use an inductor between the isothermal plane and ground.

(From our discussion at lunch.)

samchoy88, 2015-01-05:
Currently the Analog ground and Digital ground are connected by Ferrite Bead which can supresses high frequency noise pass though it. Hope it helps.

charlespax, 2015-01-05:
The most recent version in git still has a 10k resistor. The prototype board you made have the ferrite bead instead?

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

samchoy88, 2015-01-05:
Yes, the prototype board I made have the Ferrite bead instead. Let see the result.

charlespax, 2015-01-05:
Let's make the change for Electronics version 0.10. If it doesn't work out, we can revert.

charlespax, 2015-01-12:
From our conversation we have decided to use a zero ohm resistor. We should make a component for the library that is a resistor pad set with a trace linking them.

samchoy88, 2015-01-15:
I found the ground should use zero resistor instead.
However, the isothermal ground (Analog ground) and Normal ground should connect near power supply.
However, I cant find a good position for the power supply to achieve this. Any suggestion on this?
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

charlespax, 2015-01-15:
Whether the device is powered via USB or battery all the power goes through the 3.3 V regulator circled in the image below. Maybe I don't fully understand the concept, but I don't think the charging portion has much to do with this.

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

Can we run a trace from the isothermal ground to near the 3.3 V regulator?

samchoy88, 2015-01-15:
Here is the schematic for reference
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

As you can see the system can power by 2 different source, USB and Battery.
- You will find the current pass through the bottom part to charge battery and battery past through the bottom part back to regulator and supply the whole circuit by 3.3V.
- Besides, the analog GND must past through the noise digital GND to get back power supply (orange path). This made the Analog part noise and it may affect accuracy of the reading.

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

here is my suggestion:
- Move the all noisy digital component (SD card and Flash) to left hand side.
- RTC and its battery move to right hand side and made more space for regulator, charger

charlespax, 2015-01-15:
I see no problem with moving the SD card and flash to the left side. However, we need feedback from @starno. @starno what do you think?

What will happen with the BL-5C batter connector? Will that get moved to the left side too? That would require significant work on the enclosure, but is doable. @starno any thoughts on this part?

samchoy88, 2015-01-16:
Why BL-5C connector move together with SD-card connector?

charlespax, 2015-01-16:
It doesn't have to. It jus sounded like you wanted to move the battery connector too because it is part of the power system on the right side.

samchoy88, 2015-01-16:
Yes, the battery connector at bottom right side is OK. As the circuit density is low and it seem great for Analog GND and Digital GND connect together.

charlespax, 2015-01-25:
These two issues are not pretty much the same https://github.com/PaxInstruments/t400-electronics/issues/59

samchoy88, 2015-01-25:
Power distribution
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

samchoy88, 2015-01-25:
Isothermal plane connect to Normal GND by a short wire.

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

charlespax, 2015-01-25:
Cool. Closing issue.

Closed 2015-01-25.

Thread 125 (2015-01-04):

Remove fiducials

charlespax, 2015-01-04:
Maybe we should remove the fiducials on the T400 PCBs.

(From our discussion at lunch.)

samchoy88, 2015-01-05:
The fiducials marks will be on the breakaway of the panel.

charlespax, 2015-01-05:
Sounds good. Let's remove them in Electronics version 0.10.

charlespax, 2015-01-23:
No fiducials on the current version in git. Closing issue.
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

Closed 2015-01-23.

Thread 126 (2015-01-04):

Panel design

charlespax, 2015-01-04:
We should make a panel design. We will need the PCBA house requirements.

This is a design we should have in-house and not something internal to the PCBA house.

(From our discussion at lunch.)

samchoy88, 2015-01-05:
Understand we want the panel design are the same after we switched to another PCB factory.
Stick with the plan like this?
If there is any comment, please feel free to let me know.
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

samchoy88, 2015-01-05:
Here are the information for panel design.
http://blogs.mentor.com/tom-hausherr/blog/2011/06/23/pcb-design-perfection-starts-in-the-cad-library-part-19/

charlespax, 2015-01-23:
This is for production. Moving to Electronics version 1.0 (production).

Thread 127 (2015-01-04):

PCB manufacturer information

charlespax, 2015-01-04:
We should try to keep the PCB manufacturer information off our boards or move the information to a reasonable location. We should talk to our PCBA house about this.

Maybe there is a way to define that location in the GERBER files.

(From our discussion at lunch.)

samchoy88, 2015-01-05:
As the information give factory identify the order in low Qty PCB manufacturing.
If we work on panel design, those information may be on the breakaway part.

charlespax, 2015-01-23:
This is for production. Moving to Electronics version 1.0 (production)

Thread 128 (2015-01-04):

Use smaller ICs

charlespax, 2015-01-04:
Maybe we should move to small ICs.

(From our discussion at lunch.)

samchoy88, 2015-01-05:
RTC smallest package is SO-8 which is currently use in Rev 0.9
ADC (MCP3424) currently using SO-14 <6x8.65mm>, we can switch to TSSOP-14 <6.4x5mm>
But switching smaller IC is not effective to reduce size in board. As the SD-card and RTC battery connector are too large compare with those IC.
May be we should back to issue RTC battery holder is large #1

charlespax, 2015-01-05:
Agreed. Moving this to the "Electronics version :-)" milestone.

charlespax, 2015-08-08:
Will not do. Closing issue.

Closed 2015-08-08.

Thread 129 (2015-01-04):

Test pad size

charlespax, 2015-01-04:
Maybe we should have larger test pads to aid in programming jig alignment.

(From our discussion at lunch.)

samchoy88, 2015-01-05:
the programming port will apply larger pad that fit with SIM card connector:
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

charlespax, 2015-01-23:
@samchoy88 what are your thoughts on this? We should have a decision for Electronics version 0.10.

samchoy88, 2015-01-25:
Here is the drill size of the test pad.
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

This is the reference test point component dimension:
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

http://www.keyelco.com/category.cfm/Test-Points-color-keyed-Thru-Hole-Mount/Compact-Style/p/518/id/521/c_id/746

charlespax, 2015-01-25:
We only need a through hole test hook for a ground test point. The rest only need to be large enough to make contact with the test jig.

samchoy88, 2015-01-25:
Here is the sample test pin on the Rev 0.9.
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

Mounting holes at the corner will handle all test point alignment.

samchoy88, 2015-01-25:
Pogo pin work great on test point of Rev 0.9 board.
The pogo pin is sharp and narrow then the other (round head)

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

samchoy88, 2015-01-25:
Pogo pin reference:
http://www.pccp.com.tw/images/ccp/Tradition_Probes/P-25.pdf

charlespax, 2015-01-25:
Okay, closing issue.

Closed 2015-01-25.

Thread 130 (2015-01-06):

Electronics version 0.9 stopped working

charlespax, 2015-01-06:
I have two Electronics version 0.9 assembled boards from @samchoy88. I've have been flashing them via USB as I develop T400 testing firmware. One board mysteriously stopped working. Now the second board is not recognized by OSX. When I plug in each board I get the following error after running `sudo dmesg`.

```
USBF:    1613.173    The IOUSBFamily is having trouble enumerating a USB device that has been plugged in.  It will keep retrying.  (Port 1 of Hub at 0x14000000)
USBF:    1613.474    The IOUSBFamily was not able to enumerate a device.
USBF:    1614. 30    The IOUSBFamily is having trouble enumerating a USB device that has been plugged in.  It will keep retrying.  (Port 1 of Hub at 0x14000000)
USBF:    1614. 30    The IOUSBFamily gave up enumerating a USB device after 10 retries.  (Port 1 of Hub at 0x14000000)
USBF:    1614. 30    The IOUSBFamily was not able to enumerate a device.
```

samchoy88, 2015-01-06:
Can you re-program the MCU by ICSP port with LilyPad Arduino USB bootloader?

charlespax, 2015-01-07:
I cannot reprogram the bootloader with any of my programmers on my OSX machine or on another Windows machine.

On one of the boards I removed the 32u4 and soldered on a new one. I successfully flashed the bootloader via ICSP.

I think there is a problem with the power being supplied from the wall. I can sometime feel a buzz on my computer. From now on I will not plug the T400 into my computer while it is plugged into the wall.

samchoy88, 2015-01-07:
It seem the computer is not grounded properly.
http://apple.stackexchange.com/questions/10545/is-it-bad-that-my-macbook-air-is-passing-me-electricity

charlespax, 2015-01-08:
Running on battery power I just killed another board! It seemed to happen after I accidentally released the SW_PWR button while the firmware was uploading.

A note from debugging yesterday: On a working board D+ and D- are not connected. On bad boards D+ and D- had a measurable resistance between them. When I get home I'll check the resistance between D+ and D- on the board I just killed.

charlespax, 2015-01-23:
I think this whole thing was a ICSP programmer issue. Closing.

Closed 2015-01-23.

Thread 131 (2015-01-08):

Add SD_CS test point

charlespax, 2015-01-08:
Test jig needs this to test the SPI SD card.

charlespax, 2015-01-16:
Done. Closing issue.
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

Closed 2015-01-16.

Thread 132 (2015-01-08):

Add FLASH_CS test point

charlespax, 2015-01-08:
Test jig needs this to test SPI flash chip.

charlespax, 2015-01-16:
Done. Closing issue.
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

Closed 2015-01-16.

Thread 134 (2015-01-09):

New soft power circuit

samchoy88, 2015-01-09:
I would like to implement the following soft power circuit and solve below issue:
- JP1 made circuit operate at 3.6V instead of 3.3V #117
- SW_PWR cannot detect button action #116

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

I choose NAND gate instead of OR gate and made all input pulled up by 10K resistor.
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

charlespax, 2015-01-09:
My only concern is pullup resistor on PWR_ONOFF is drawing 0.33 mA while the device is just sitting there.

Here's what the power on sequence looks.
```
A   B   Y
H   H   L   <-- SW_PWR is not pressed, device is off. Device if off.
H   L   H   <-- SW_PWR is pressed, device is off. User presses and holds the power button.
L   L   H   <-- SW_PWR is pressed, device is on. Device boots up and enables power. User is still holding power button.
L   H   H   <-- SW_PWR is not pressed, device is on. User releases power button.
```

samchoy88, 2015-01-09:
I think it can be 100K for pull up, as it only connect a logic which has high input impedance.

charlespax, 2015-01-09:
Cool. Let's make that change in Electronics version 0.10.

charlespax, 2015-01-16:
Done. Closing issue.
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

Closed 2015-01-16.

Thread 136 (2015-01-15):

Solar charging

charlespax, 2015-01-15:
A Kickstarter community member suggests "Can you add some solar cells and use rechargeable batteries to allow long duration measurements and not having to worry about energy source."

charlespax, 2015-01-15:
Solar charging would be cool. I think it would be best to have a system where the screen and device and be orientated for best usage while the solar panel can be placed in direct sunlight.

I think a solar powered battery pack connected to the microUSB port would be perfect for this.

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

Let's circle back to this idea in a future product.

Tsillen, 2015-01-15:
The next product will probably have a more energy efficient design. Thus depending on the mode it is in it can increase battery life dramatically (several months to even a year of battery life).

charlespax, 2015-01-15:
Especially if it doesn't have an LCD. Then we can integrate it all in one enclosure.

Tsillen, 2015-01-15:
Even with a display. As you can electronically disconnect it completely with an mosfet. Thus making the power draw of the lcd pretty much zero.

Closed 2015-01-15.

Thread 137 (2015-01-16):

LCD connector 1.0 mm footprint

charlespax, 2015-01-16:
We need a footprint for an appropriate LCD connector for the LCD with a 1.0 mm pitch cable. The one in the image below should be good, but we need it to be 12 pins.

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

samchoy88, 2015-01-19:
Original LCD it has 12 pins only.
However you are replacing the 16 pins 1mm Pitch connector.
Please kindly advice the signal assignment on new 16 pins 1mm Pitch connector connector.

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

charlespax, 2015-01-19:
The connector is 12 pins. The 16 pin connector is a good template from which you can make a new connector.

samchoy88, 2015-01-19:
OK, I follow this part number dimension for reference
P/N: FH12-12S-1SH

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

charlespax, 2015-01-23:
We have four samples of the new LCDs, so we'll have them for Electronics version 0.10. Moving to the Electronics version 0.10 milestone.

samchoy88, 2015-01-25:
Both of the 1mm and 0.5 mm connector are in the PCB now.
See #140

charlespax, 2015-01-25:
It's in Github. Closing issue.
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

charlespax, 2015-01-25:
We should remove the 0.5 mm footprint when we have the custom LCD production run. See https://github.com/PaxInstruments/t400-electronics/issues/141.

charlespax, 2016-05-10:
See also https://github.com/PaxInstruments/t400-electronics/issues/162

Closed 2015-01-25.

Thread 138 (2015-01-16):

Adjust the thermal-couple connector width

samchoy88, 2015-01-16:
It seem the thermal couple connector is a little bit lose,

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

I try to reduce the distance between connector (+) and (-), around 11mm ~ 12mm.

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

samchoy88, 2015-01-16:
See this improvement in Library
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

charlespax, 2015-01-16:
For the male mini thermocouple connector we have (8 mm center-to-center) + (2.4 mm/2) + (3.17 mm/2) = 10.785 mm edge-to-edge. That is at least 1.11 mm of play side-to-side. And if we look at the Keystone connector there appears to already be enough extra room. @samchoy88 how do you feel about reducing that 12 mm to 10.75 or 11 mm?

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

And when you change the footprint make sure the centerline of the foot print meets the centerline of the male thermocouple connector. The blades are different widths, so there will be an offset.

samchoy88, 2015-01-19:
As the thermal-couple has different size of terminal. (Positive pole is smaller then Negative pole).  Do you think we should apply the same size connector? (To avoid user plug in connector inversely)

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

Positive terminal: (3549 - For 0.110 tab)
http://www.keyelco.com/product.cfm/Horizontal-Entry/Horizontal-Entry-Mini-Auto-Blade-Fuse-Clip/p/398/id/399/c_id/546/product_id/303

Negative terminal: (3572 - For 0.187 tab)
http://www.keyelco.com/product.cfm/Horizontal-Entry/3572/p/398/id/399/c_id/604/product_id/683

charlespax, 2015-01-19:
No have will come from plugging in backwards. The top panel is keyed, so a user cant do it. However, there is no harm in using two different width connectors as long as they work. The small connectors I've tried tend to deform. If you have connectors that work, I'm open to trying them in the next board revision.

samchoy88, 2015-01-19:
OK, I only apply the terminal: (3572 - For 0.187 tab)
http://www.keyelco.com/product.cfm/Horizontal-Entry/3572/p/398/id/399/c_id/604/product_id/683

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

However, the connector width is 5.64mm, the minimum side to side (2 terminals) width is 11.4mm (connector touch together). I made the connector side to side 12.2mm, reserved 0.8mm margin for extension while tab inserted.

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

charlespax, 2015-01-25:
Looks good. Closing issue.
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

samchoy88, 2015-01-26:
I just print it out and verify the board again.
Do you think the connector are too close together?
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

charlespax, 2015-01-26:
The connectors in Electronics version 0.10 will be fine as long as we can make a gap. We can put Kapton tape to ensure there is no electrical connection.

In Electronics version 0.11 we are moving to a custom connector (https://github.com/PaxInstruments/t400-electronics/issues/17), so this is not an issue we will face in production.

Closed 2015-01-26.

Thread 139 (2015-01-22):

PCB mounting holes

charlespax, 2015-01-22:
The PCB standoffs on the enclosure now have a shoulder to secure the PCB more firmly (https://github.com/PaxInstruments/t400-enclosure/issues/64). This requires enlarging the PCB mounting holes. The keepout area on the PCB is the same, so this should not require any change to the layout or routing.

charlespax, 2015-01-22:
@starno What are the new dimensions of the PCB mounting hole?

starno, 2015-01-22:
4.5mm diameter in the same location

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

samchoy88, 2015-01-25:
Current mounting holes are 5.08mm diameter.
Is that OK?

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

charlespax, 2015-01-25:
That screenshot shows a 2.54 mm hole. I don't understand.

samchoy88, 2015-01-25:
Sorry, I made misunderstand on the value.
here is the corrected drill size
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

charlespax, 2015-01-25:
Looks good. When we manufacture the PCB we'll have to make sure the holes are not plated, which would reduce their diameter. Closing issue.

Closed 2015-01-25.

Thread 140 (2015-01-23):

Two LCD connector footprints

charlespax, 2015-01-23:
**NOTE: This is a nice-to-have feature, not a requirement. This feature is purely to aid testing and should not in any way compromise the production design.**

@samchoy88, if possible, it would be good to include both LCD connector footprints on the Electronics version 0.10 PCB. We only have four samples of the 1.0 mm pin pitch LCD, which would limit us to four active units for Electronics version 0.10. By including the second footprint we can have as many units as we like.

This is a quick and dirty illustration of what the PCB could look like. It would be best to not have the connector hanging off the board, but can if that's what it takes to get the footprint on there.
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

charlespax, 2015-01-23:
If this doesn't work out for Electronics version 0.10, I can just roll an extended PCB that has the connector. This would be just for software development.

samchoy88, 2015-01-25:
Done
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

charlespax, 2015-01-25:
Looks good. Closing issue. We should remove the 0.5 mm footprint when we have the custom LCD production run. See https://github.com/PaxInstruments/t400-electronics/issues/141.
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

Closed 2015-01-25.

Thread 141 (2015-01-25):

Remove unused 0.5 mm LCD connector

charlespax, 2015-01-25:
In Electronics version 0.10 we kept the 0.5 mm and 1.0 mm LCD connector footprints for the transition from stock to custom LCD connector. Once we have the full  production run we can remove the 0.5 mm footprint.

See https://github.com/PaxInstruments/t400-electronics/issues/137

samchoy88, 2015-03-14:
removed unused 0.5 mm LCD connector in PCB layout. and remaining 1mm LCD connector footprint.
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

charlespax, 2015-03-14:
Perfect. I just got word that the new LCDs are in. We'll have plenty to work with.

charlespax, 2015-03-18:
The LCD factory is shipping the LCDs today.

Looks done to me. Closing issue.

Closed 2015-03-18.

Thread 142 (2015-01-25):

Review Arduino pinmap on silkscreen

charlespax, 2015-01-25:
Make sure the Arduino pinmap on the silkscreen is accurate. This should be the last issue addressed before ordering PCBs.

samchoy88, 2015-01-25:
Here is the silkscreen and schematic on Rev 0.10:

Pin map silkscreen position:
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

Pin Map on silk screen:
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

Pin map on Schematic:
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

charlespax, 2015-01-25:
Here is the Arduino Leonardo pinmap. Does everything match? Is the silkscreen accurate?
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

samchoy88, 2015-01-26:
Are you sure the above pin mapping suitable for our project?
As I found T400 dos not connect UVcc to +5V and datasheet of ATmega32u4 also suggest not connect +5V to UVcc while I/O using 3.0V to 3.6V.

Reference: (Page 256) http://www.atmel.com/images/doc7766.pdf
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

charlespax, 2015-01-26:
The image I reference above is for the Arduino Leonardo. It is only used to correlate between physical pins on the ATmega32U4 and their Arduino digital/analog designations.

Don't worry about it, I'll take care of this issue.

charlespax, 2015-01-26:
ATmega32U4 | Arduino
---|---
1 | D7
2 |
3 |
4 |
5 |
6 |
7 |
8 | RXLED
9 | SCK
10 | MOSI
11 | MISO
12 | D11
13 | RESET
14 |
15 |
16 | XTAL2
17 | XTAL1
18 | D3, SCL
19 | D2, SDA
20 | D0
21 | D1
22 | TXLED
23 |
24 |
25 | D4
26 | D12
27 | D6
28 | D8
29 | D9
30 | D10
31 | D5
32 | D13
33 |
34 |
35 |
36 | A0
37 | A1
38 | A2
39 | A3
40 | A4
41 | A5
42 |
43 |
44 |

samchoy88, 2015-01-26:
Yes, the Digital and Analog pin mapping are match with T400

charlespax, 2015-01-26:
Here is the pinmap for the current version of the T400

Arduino | ATmega32U4 | T400
---|---|---
D0 | 20 | SW_B
D1 | 21 | SW_A
D2 | 19 | SDA
D3 | 18 | SCL
D4 | 25 | LCD_A0
D5 | 31 | BATT_STAT
D6 | 27 | LCD_BL
D7 | 1 | RTC_INT
D8 | 28 | LCD_CS
D9 | 29 | VBAT_SENSE
D10 | 30 | VBAT_EN
D11 | 12 | FLASH_CS
D12 | 26 | LCD_RST
D13 | 32 | SW_C
D14 | 11 | MISO
D15 | 9 | SCK
D16 | 10 | MOSI
D17 | 8 | SD_CS
A0, D18 | 36 | DATA2
A1, D19 | 37 | DATA1
A2, D20 | 38 | SW_D
A3, D21 | 39 | SW_E
A4, D22 | 40 | SW_PWR
A5, D23 | 41 | PWR_ONOFF

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

charlespax, 2015-01-26:
All good. Closing issue.

Closed 2015-01-26.

Thread 143 (2015-01-26):

Connect buttons to interrupt pins

charlespax, 2015-01-26:
We should connect each button and RTC_INT to an interrupt pin. This will give us the highest flexibility in user interface design.

In Electronics version 0.10 the interrupt pins available for swapping are __PCINT4__ on LCD_CS, __PCINT5__ on VBAT_SENSE, __PCINT6__ on VBAT_EN, __PCINT7__ on FLASH_CS, and __PCINT0__ on SD_CS.

Item | Function | Interrupt | Note
---|---|---|---
__RTC_INT__ | Wake for readings | __INT6__ | Requires interrupt
__SW_A__ | Logging start/stop | __INT3__ | Requires interrupt
__SW_B__ | Logging interval | __INT2__ | Probably does not need interrupt
__SW_C__ | Temperature units | none | Should probably have interrupt
__SW_D__ | Toggle channels | none | Should probably have interrupt
__SW_E__ | Backlight | none | Should probably have interrupt
__SW_PWR__ | Power | none | Should probably have interrupt

For a full pin map of Electronics version 0.10 see https://github.com/PaxInstruments/t400-electronics/issues/114.

cibomahto, 2015-01-26:
The only place where it really matters if the pin can generate an input is when the processor is in sleep mode. When the device is running, it makes more sense to use a single timer interrupt to poll all of the buttons, to make the debounce routine more effective.

From the manual, here is the list of interrupt sources that can be used to wake the processor:

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

As noted above, RTC_INT, SW_A, and SW_B are all connected to dedicated hardware interrupts (INTx) as well as pin change interrupts (PCINTx), so they are fine, and the other pins cannot be used to wake the processor. They happen to overlap for the Atmega32u4, but the two interrupt methods are separate peripherals- the pin change one will make an interrupt whenever the pin changes state (high-to-low and low-to-high), while the hardware interrupt can trigger on a low-to-high, high-to-low, or whenever the value is low. Either peripheral will work for waking up the t400.

The other buttons, also as noted above, aren't connected to an interrupt source and could not be used to wake the device from sleep.

cibomahto, 2015-01-26:
Here are the pins with external interrupt capability:

PB0: PCINT0
PB1: PCINT1
PB2: PCINT2
PB3: PCINT3
PB4: PCINT4
PB5: PCINT5
PB6: PCINT6
PB7: PCINT7
PD0: INT0
PD1: INT1
PD2: INT2
PD3: INT3
PE6: INT6

From a software perspective, it's cumbersome to have to deal with both types at the same time, but it's not a showstopper.

cibomahto, 2015-01-26:
Also note that the only interrupt that's capable of waking the system from sleep in the lowest power mode (all clocks off) is INT6, so placing the RTC interrupt on that line was a good call.

charlespax, 2015-01-26:
The table indicates "INT6,INT3:0 and pin change" can wake the processor. For example the ADC can only wake the processor from Idle and ADCNRM. Am I reading the table wrong?

cibomahto, 2015-01-27:
You are reading it correctly. Some of the peripherals are disabled in some of the sleep modes, so they can't be used to turn on the processor.

Also, detecting pin change interrupts while in the power down mode will slightly increase power usage, as a clock has to be enabled for the pin change peripheral to work. The INT6 pin's 'low' interrupt can work without a clock. Those details shouldn't matter with this design, because the difference should be small compared to the small amount that the rest of the peripherals use.

charlespax, 2015-01-29:
It looks like we'll never use the lowest level interrupt for RTC_INT. We would need at least one button on the same level, so a user can stop logging.

charlespax, 2015-02-04:
It looks like we can get all the buttons and the RTC_INT pin on interrupts. Let's do this for the next version.

charlespax, 2015-03-18:
Did this make it into the most recent board revision?

samchoy88, 2015-04-18:
Here are the pins with external interrupt capability:

PB0: PCINT0
PB1: PCINT1
PB2: PCINT2
PB3: PCINT3
PB4: PCINT4
PB5: PCINT5
PB6: PCINT6
PB7: PCINT7
PD0: INT0
PD1: INT1
PD2: INT2
PD3: INT3
PE6: INT6

Below is the pin assignment of the layout in Rev 0.12

Item | Function | Interrupt | Note
---|---|---|---
__RTC_INT__ | Wake for readings | __INT6__ | PE6
__SW_A__ | Logging start/stop | __INT3__ | PD3
__SW_B__ | Logging interval | __INT2__ | PD2
__SW_C__ | Temperature units | __PCINT4__ | PB4
__SW_D__ | Toggle channels | __PCINT5__ | PB5
__SW_E__ | Backlight | __PCINT6__ | PB6
__SW_PWR__ | Power | __PCINT0__ | PB0

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

charlespax, 2015-04-18:
Amazing!

Closed 2015-04-18.

Thread 144 (2015-02-01):

MicroSD card overhang

charlespax, 2015-02-01:
The MicroSD card connector overhangs the PCB a little too much and interferes with the enclosure (https://github.com/PaxInstruments/t400-enclosure/issues/79). We need to bring it back a little bit.

samchoy88, 2015-02-27:
Updated SD card position. The long side of the connector overhang to 0.7mm from the PCB edge
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

Closed 2015-03-01.

Thread 145 (2015-02-01):

MicroSD card footprint

charlespax, 2015-02-01:
The MicroSD card connector does not match the component we have been prototyping with. We should make a new footprint that matches the component we will use in production.

The footprint should also indicate the centerline of the MicroSD card slot on the Measures layer.

charlespax, 2015-02-09:
See also https://github.com/PaxInstruments/t400-electronics/issues/79. Make sure the card positions are correct.

samchoy88, 2015-03-14:
According to the T-flash connect spec. I found Seedstuido library has slightly different on the pad.
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

Below picture is the T-flash connector in Seedstuido library.
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

The pin 4 should align to the line in below picture. And I updated component in Pax instrument library.
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

charlespax, 2015-03-18:
This change made it into the most recent board order, right? If so, we can close this and open another issue if it is still a problem.

Closed 2015-03-18.

Thread 146 (2015-02-02):

Electronics version 0.10 assembly and testing

samchoy88, 2015-02-02:
Tests
- [x] Program bootloader at Arduino Lilypad USB
- [x] New Soft power circuit
- [x] New battery charging circuit
- [x] RTC
- [x] MCP9800 temperature sensor
- [x] LCD
- [x] SD card
- [x] SPI flash
- [x] Buttons
- [x] ADC

samchoy88, 2015-02-02:
LCD test using U8g LCD library required to add following code:
at beginning - U8GLIB_PI13264 u8g(15, 16, 8, 4, 12);
In setup - u8g.setContrast(200);

samchoy88, 2015-02-05:
Discovered SW_A always short to GND in a board.
Finally found out there is a short circuit under MCU (QFN package and hand soldering).

samchoy88, 2015-02-06:
Experienced charging detected issue, please see:
Charging status unstable while No battery installed #147

charlespax, 2015-04-29:
Old. Closing issue.

Closed 2015-04-29.

Thread 147 (2015-02-06):

Charging status unstable while No battery installed

samchoy88, 2015-02-06:
MCU detected charging status unstable while no battery installed.
I check on the BATT_STAT test point seem stable at 2.5V but 3.4V at STAT pin of the charger IC.
May be the the voltage level is in marginal level and cause unstable.

samchoy88, 2015-02-06:
Changed the resistor from 10K to 100K and it seem stable now.
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

charlespax, 2015-02-06:
Based on a forum post I read (http://www.microchip.com/forums/m670010.aspx), we may need to add some capacitance on the battery terminals near the MCP73831. "I added another 4,7 µF ceramic capacitor, closer to the MCP73831 (right on the pins actually) and that seems to work too. So I guess it was some instability between the battery charger and the LDO."
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

samchoy88, 2015-02-06:
I found the battery disconnected made the charger IC not in Hi-Z status. It switch between Hi-Z and GND.

samchoy88, 2015-02-06:
This issue is different from forum post (http://www.microchip.com/forums/m670010.aspx).
As it has problem with battery charger IC supply to LDO directly and causing unstable voltage supply to circuit.
But my problem is the STAT pin give unstable signal when No battery connected.

samchoy88, 2015-02-06:
Fixed problem by this circuit. adding low pass filter and pull up resistor.
The 2k resistor and 10uF act as a low pass filter to avoid unstable signal from charging IC.
As I/O pin D5 do not have internal pull up resistor when act as an INPUT pin. A 10K resistor added externally.
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

charlespax, 2015-02-06:
Is there anything related to VBAT, VBAT_SENSE, or VBAT_EN floating that is causing this?

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

charlespax, 2015-02-06:
Okay, cool. When we're connected to USB the current drawn when STAT is low doesn't matter. When we are not connected to USB power STAT is Hi-Z, so the current draw should be negligible. Nice.

Can we close this issue?

samchoy88, 2015-02-06:
Problem fixed.

Closed 2015-02-06.

Thread 148 (2015-02-06):

LCD quality issue

samchoy88, 2015-02-06:
One of the LCD sample has broken line.
I think this is quality issue of LCD factory.
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

charlespax, 2015-02-06:
Does this LCD have the 0.5 mm pitch cable or the 1.0 mm pitch cable?

Was the LCD this way the first time you turned it on or did it happen later?

samchoy88, 2015-02-06:
This is 1mm pitch cable. This happen after few turn on.

charlespax, 2015-02-06:
Okay, I just want to be clear before I talk to the manufacturer. The first time you turned on the LCD it had no problems, correct? Then you turned it off and back on a few times and it was still okay, correct? Then you turned it on again and the LCD was bad, correct?

charlespax, 2015-04-29:
I haven't seen this again. I'm moving this to the production milestone, so we can make indicate the PCBA factory should check for this.

Tsillen, 2015-10-06:
this is probably the zebra connector

Thread 149 (2015-02-06):

Battery life time first test

samchoy88, 2015-02-06:
This is a first test on battery life time.

Reset RTC time before battery lifetime test.

Below picture show the devices non-stop running for 23 hours and 38 minutes.
Here is the configure in software:
- No sleep and update LCD every 3 seconds
- LCD back-light always ON
- (1st Line) Read RTC
- (2nd Line) temperature sensor
- (3rd Line) 4 channels of ADC
- (4th Line) checking key press
- (5th line) Check battery charging status and analog reading of battery level

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

samchoy88, 2015-02-06:
No flash and SD card reading in this test

charlespax, 2015-04-29:
Old. Closing issue.

Closed 2015-04-29.

Thread 150 (2015-02-09):

SPI bus design

charlespax, 2015-02-09:
I'm posting this application note about SPI bus design. I don't think we need this for the T400 thought. Moving to Ice box. http://hackaday.com/2014/11/25/better-spi-bus-design/

samchoy88, 2015-03-14:
It looks great and better design to avoid unexpected failure on SPI bus.

samchoy88, 2015-03-14:
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

Here are the reference reason of this design.
1. Add Pullup Resistors for Chip Select & Reset Signals:
Without a pullup resistor, the second device can "hear" and respond to the communication taking    place on the first device, if that second device's chip select pin is not pulled up.

2. Verify tri-state behavior on MISO: use a tri-state buffer chip if necessary.
Most SPI chips will tri-state (effectively disconnect) their MISO pin when their chip select signal is high (inactive). However, some chips do not have proper MISO tri-state behavior.

3. Protect bus access with SPI.beginTransaction(settings) and SPI.endTransaction().
Newer versions of Arduino's SPI library support transactions.  Transactions give you 2 benefits:
Your SPI settings are used, even if other devices use different settings
Your device gains exclusive use of the SPI bus.  Others will not disturb you.

charlespax, 2015-08-08:
Will not do. Closing issue.

Closed 2015-08-08.

Thread 151 (2015-02-12):

Silkscreen on ICSP header misleading

cibomahto, 2015-02-12:
The reset pin is labeled '3V3_EN', it should be 'RESET'

charlespax, 2015-02-12:
Oh boy! Let's fix this in the next revision.

samchoy88, 2015-02-27:
Corrected
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

Closed 2015-02-27.

Thread 152 (2015-02-12):

Improve power on/off design

cibomahto, 2015-02-12:
The V.10 board I received seems to have this issue, not sure if it was present beforehand-

The 3.3V line hovers at 1.7V when it should be in an off state (3V3EN is low). It appears there is voltage leaking through somewhere. I tried the following:

Cut SW_PWR connection to 32U4 (near the 32u4)
Cut PWR_ONOFF connection to 32U4 (near the 32u4)
Cut VBUS connection to 32U4 (near the 32u4)
Pull R20
Pull R47
Cut 3.3V line after regulator

With the above changes made, the 3.3V line stays at 0V.

The well-labeled, accessible test points were super useful in debugging this.

Afterwards, I replaced VBUS and re-connected the 3.3V line, and the voltage output is still clean (0V). I re-installed SW_PWR and PWR_ONOFF, and the issue returned- 3.3V hovered at a high voltage again.

I tried creating a voltage divider (replace R6 and R7 with 10K resistors, place a 100k resistor between SW_PWR and the 32u4, and PWR_ONOFF and the 32u4), but this didn't help- the voltage on the 3.3V line is still .7V. when it should be 0V.

I think the problem is leakage through the processor I/O pins, and the solution is that they can't be connected directly to those connections as they currently are (this is probably an issue for VBAT_SENSE, VBAT_STAT and VBAT_EN as well)

One solution, for the power circuit, is to go back to the OR gate design. I'd prefer to see a latched design, but the OR one should still work (I'll check a V.9 board tomorrow).

charlespax, 2015-02-14:
I'm in my phone right now, so it is difficult to dig into this, but here are my thoughts.

- Which resistors are R6, R7, R20, and R47? I can only view the PDF and they aren't labeled.
- would it make sense that we have current leaking though the internal pull up resistors? We have VBUS connected to PWR_ONOFF and SW_PWR by the 100k pullup resistors, which are then connected to 3.3V inside the MCU by the internal pull up resistors on those lines (I think).
- If that is the problem, can we disable the internal pull up resistors or use pins that maybe do not have pull up resistors?
- Is this problem happening when the unit is off and not plugged into USB?

charlespax, 2015-02-14:
When the battery is connected and USB is not connected VBAT_SENSE and VBAT_EN are also connected to VBAT/VBUS through the 5k and 10k resistors. If SW_PWR and PWR_ONOFF are causing problems, VBAT_SENSE and VBAT_EN should be causing problems too, right?

charlespax, 2015-02-14:
I reread you comment and see you already mentioned those pins.

I suppose having 3.3V hover above 0V is a problem only if it is draining the battery in a meaningful way.  Maybe we should tap into VBUS and see if any current is being drawn.

charlespax, 2015-02-14:
If we leave things as they are, what is our power drain on the battery? It only matters if it matters.

charlespax, 2015-02-14:
We could potentially run the MCU 3.3V through a MOSFET and cut off current from draining to the 3.3V line. I wonder how much, if any, current would then drain through the MCU to ground.

charlespax, 2015-02-14:
I don't know what the solution is or if we can just leave things as they are, but we should address this in the next board revision. Moving to Electronics version 0.11.

cibomahto, 2015-02-15:
I should be more clear- this prevents the processor from turning off the regulator.

cibomahto, 2015-02-15:
It's not a good design to pull pins higher than Vbus (and Vbus is 0V at that time).

I'm pretty sure the previous circuit worked fine, so I would suggest re-testing a V.9 board to see the power on/off circuits work correctly. I blew up the 3.3v regulator on my v.10 board during this testing and stole it from the v.9 board, so I unfortunately don't have the parts around to retest that :-/.

charlespax, 2015-02-16:
@samchoy88 this sounds like a pretty serious issue. What are you thoughts?

samchoy88, 2015-02-16:
I discuss the issue with Matt, please don't mind the 3.3V regulator blew up in testing.
However, the circuit have many issue in most I/O pin connected to non-3.3V.
As the power may leak to/from I/O during sleep and operating.

Matt suggest to re-design / take special care of those pins.

Here are the list of I/O with issue or potential issue:
- BATT_STAT
- VBAT_SENSE
-VBAT_EN
- POR_ONOFF
- SW_PWR

samchoy88, 2015-02-16:
Here is the solution to improve battery measure circuit.
http://www.microbuilder.eu/Tutorials/Fundamentals/MeasuringBatteryVoltage.aspx

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

(Reference from microBuilder.eu)
This example extends on the basic voltage divider by allowing you to enable or disable the divider with a simple GPIO pin (BATTSENS_EN).
Q1 is a P-Channel MOSFET that will selectively allow the battery current to flow throw the voltage divider and into the ADC.
Q2 is an NPN Transistor that will turn the P-Channel MOSFET (Q1) 'on' or 'off'.  The extra transistor is necessary because the battery voltage may well be above the maximum level that the GPIO pin can handle, which would almost certainly damage the MCU if they were connected directly.

By setting the GPIO line high, the transistor (Q2) will open the flow of current through the MOSFET (Q1), allowing you to safely measure the current battery voltage on the ADC line.  By setting the GPIO line low, you shut off the flow of current to the ADC and the voltage divider and can be certain that you are not needlessly using any of the battery's stored energy.

charlespax, 2015-02-16:
Are able to use the same part number as we already have in the design?
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

samchoy88, 2015-02-16:
The P-MOSFET can be replace by the DMP2035U-7.
Beside, the mosfet we are using has low leakage current.
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

samchoy88, 2015-03-04:
Added Mosfet to isolate the MCU (operate at 3.3V) and USB/Li-Po Battery (operate at 5V / 4.2V).

Updated Battery detect circuit
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

Updated Soft power circuit
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

charlespax, 2015-03-04:
Nice. Closing issue

Closed 2015-03-04.

Thread 153 (2015-02-14):

Electronics development documentation

charlespax, 2015-02-14:
It would be good to document our process for designing electronics. This can include the process, code/design guidelines, release process's checklist, and other information.

charlespax, 2015-02-14:
Things to document:

## Design guidelines

- Add Pax Instruments logo to silkscreen
- Add pinmap to silkscreen
- Add PCB version to silkscreen
- Component placement grid
- Routing grid
- Schematic layout grid
- Schematic device guidelines
- Naming conventions

## Design rules

- DRU files for each type of PCB we might use (e.g. prototype, production, etc.).
- Matrix of PCB manufacturer capabilities. DirtyPCBs, OSHPark, etc..

## Release process

- Steps to release a PCB version
- Verify the silkscreen
- Ensure the PCB version on the silkscreen matches is true
- Ensure pinmap in silkscreen is accurate
- Make Gerber files
- Make schematic PDF
- Update release notes
- Commit all changes
- Make branch in github

## Ordering

- How to order PCBs
- Can PCB ordering be automated?

Thread 154 (2015-02-19):

PCB locating feature

charlespax, 2015-02-19:
We have introduced a PCB locating feature into the enclosure to aid the assembly process and secure the PCB. See https://github.com/PaxInstruments/t400-enclosure/issues/80

The PCB needs corresponding slots milled into the sides. @starno can you give @samchoy88 some dimensions for this?

starno, 2015-02-27:
@samchoy88 the slots are symmetrical on the pcb.  the center on each slot is 15.28mm from the top edge of the PCB:
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
and each slot is 2mm long and 0.9mm wide:
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
The end of each slot is round matching the milling bit that cuts it.  I'd assume a 0.9mm round there.

samchoy88, 2015-02-27:
Added slot on each side.
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

starno, 2015-02-28:
looks good

charlespax, 2015-03-01:
Awesome! Let's close this.

Closed 2015-03-01.

Thread 155 (2015-02-21):

QFN thermal pad

charlespax, 2015-02-21:
The ATmega32U4 QFN thermal pad has a single via to transfer heat from the MCU to the bottom side. Should we add more vias?

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

Tsillen, 2015-02-21:
no need

charlespax, 2015-02-21:
[citation needed]

Tsillen, 2015-02-21:
You could add up all the loads and calculate the temperature rise etc... but that is a lot of work.
The TQFP version does not have any over heating issues as shown by arduino using that format on their products.

I see that you have a few IO and some busses etc. The current draw of the chip will be (very)low. In that case no extra "cooling" is needed.

But if you really want add a few more via's to it. It won't do you any good as it might make the reflow process work less good due to the increased thermal resistance that the big bottom pad will have.,

charlespax, 2015-03-15:
Cool. Let's leave things as they are. Moving to ice box.

charlespax, 2015-08-08:
Will not do. Closing issue.

Closed 2015-08-08.

Thread 156 (2015-02-22):

Internal analog reference voltage

charlespax, 2015-02-22:
We now use the ATmega32U4 internal reference voltage (https://github.com/PaxInstruments/t400-firmware/issues/21), but @samchoy88 may have found a problem.

Comment from @samchoy88 in https://github.com/PaxInstruments/t400-electronics/issues/43:
_As the Reference voltage is critical for calculating the VBAT voltage value. I expect using internal 2.56V voltage reference. and calculate the VBAT level by ADC x 2.56V / 1023. However, I found the VBAT value does not match with measuring point. After checking the circuit and ARef pin, the internal voltage reference only supply 2.508V and causing incorrect result in calculation._

charlespax, 2015-04-29:
@samchoy88 this has been implemented, correct?

MLXXXp, 2015-04-29:
The ATmega32U4 datasheet specifies that the internal reverence is typically 2.56V but can vary between 2.4V and 2.8V. See page 385:
http://www.atmel.com/images/doc7766.pdf

If you need a more precise reference value, for battery measurement and other purposes, you may have to measure and calibrate each individual unit by storing the measured reference voltage (as measured on the AREF pin) in the internal EEPROM, and use the stored value for calculations. If you do this, it would be nice to allow users to re-calibrate their unit by entering a new value, using a menu item, that they measured themselves.

The other option is to use a more precise external reference connected to the AREF pin.

charlespax, 2015-08-06:
@samchoy88 how should we address this?

MLXXXp, 2015-08-06:
I don't have Eagle installed, so I can't look at your latest schematic. If you're still using a Micrel MIC5219 to provide 3.3V then note that its output is specified to be within 1% (or 2% over the full temperature range). If this tolerance is sufficient for your purposes, you could tie this 3.3V output to the AREF pin for use as a reference.

If you need to be more precise, then as I've said, you could add a better external reference or allow for software calibration.

If it's just the battery voltage that you need to measure accurately (not other things relative to the reference) then another option is to add a potentiometer in the resistor divider that provides VBAT_SENSE, to allow hardware calibration. However, if you decide to calibrate each unit, I think software calibration would be preferred.

If you decide to use 3.3V or other higher external reference voltage, then you should also consider changing the values of the VBAT_SENSE resistor divider to take advantage of the larger range. With a 3.3V reference, using 18.7K on the high side and 34K on the low side will give a nice 5mV per step from the ADC.

samchoy88, 2015-08-12:
The battery voltage below 3.6V could be consider as low battery.
We can consider the battery level is always higher than 3.3V.
I will apply MLXXXp suggestion and use AVCC (regulated 3.3V) as ADC reference and using 18.7K on the high side and 34K on the low side will give a nice 5mV per step from the ADC.
Besides, a capacitor also added between ADC input and ground as noise filter.
See below update circuit:
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

MLXXXp, 2015-08-12:
A couple of notes:

1. The divider resistors should be 1% tolerance or better. Since 18.7 and 34.0 are EIA E96 (1%) values, whatever you buy probably will be, but unless all your resistors are specified as 1%, you should probably specifically mark these ones to be (at least) 1%, just to be safe.

2. The added 0.1uF capacitor will take some time to charge and settle after switching on Q2. Make sure you add a delay in your software to allow for this before starting the ADC conversion. Also make sure the ADC is enabled with the VBAT_SENSE input selected during this time, to allow the internal sample/hold capacitor to settle as well.

cibomahto, 2015-08-15:
Testing this, might want something a little higher than .1uF since there seems to be some noise spikes on the signal.

samchoy88, 2015-08-18:
For the resistors, we are using 1% value in general. Only the thermocouple part using 0.1% resistors.
(please see issue: Does the thermocouple filtration circuit affect the ADC readings? #53)

For the capacitor at VBAT_SENSE, I put 1uF as current design. Please turn on MOSFET with longer duration before taking ADC value.

samchoy88, 2015-08-18:
Schematic changed.
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

samchoy88, 2015-09-20:
18.7K and 34K resistors can be replace by value 11K and 20K resistors to achieve 50mV per ADC step with 3.3V ADC reference.

MLXXXp, 2015-09-20:
11K and 20K give exactly the same ratio as 18.7K and 34K, so either set will work pretty much identically.

Closed 2015-08-26.

Thread 157 (2015-02-25):

Isothermal plane vias

charlespax, 2015-02-25:
We have only a handful of vias thermally linking the top and bottom layers of the isothermal plane. I think we should have more. Maybe drop them on a 0.1 inch grid.

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

samchoy88, 2015-02-27:
More via added.
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

charlespax, 2015-02-27:
Looks good. Closing issue.

Closed 2015-02-27.

Thread 158 (2015-02-25):

Isothermal plane lateral heat transfer

charlespax, 2015-02-25:
There are two traces on the bottom later going up to the MCP9800. These traces create a vertical cutout on the bottom layer of the isothermal plane. If we run these traces on the top layer as much as we can, we can get better thermal conductivity between the left and right sides.

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

samchoy88, 2015-02-27:
Made these trace running on top layer now.
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

charlespax, 2015-02-27:
Nice. Closing issue.

Closed 2015-02-27.

Thread 159 (2015-03-19):

Battery charge controller

charlespax, 2015-03-19:
Maybe we should change the MCP73831 or how the STAT is connected.

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

cibomahto, 2015-03-19:
MCP73832 has a open drain output, maybe we should use that one isntead

cibomahto, 2015-03-19:
Otherewise there's a chance that VBUS_IN gets connected to STAT output through the MCP73831

charlespax, 2015-04-29:
@samchoy88 this has been addressed, right?

samchoy88, 2015-06-04:
Yes...this problem has been addressed....In Rev0.12 the board is using MCP73832T-2DCI/OT which is variance of MCP73831 with open drain output. But the circuit still keep Rev 0.12, as we can DNP or replace by 0 Ohm resistors.

Closed 2015-06-17.

Thread 160 (2015-03-20):

Bug in soft Power circuit

samchoy88, 2015-03-20:
As previous soft power circuit (using OR gate or NAND gate) required MCU running in application circuit and keep enable 3.3V regulator operate. But it required user press and hold Power button until MCU running application program, otherwise it system fail to start while user release button in bootloader program.

In order to turn on 3.3V regulator instantly, I changed the logic gate to SR Flip-Flop and using MOSFET to isolate the 5V and 3.3V. User can turn ON 3.3V regulator once they press the power button. SR Flip-Flop will hold the 3.3V regulator working until Flip-Flop received the high signal from MCU (inverses to Logic LOW by N-MOSFET for RST input at Flip-Flop) and turn SR Flip-Flop output LOW and off the regulator. (See below circuit)

Soft power circuit:
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

In practical, once user pressed power button and turn ON 3.3V regulator. Then the I/O (SW_PWR) that turn off Flip-Flop will raise voltage a little bit (around 60mV). This voltage level just meet Vgs and trigger MOSFET ON to give RST signal and turn OFF 3.3V regulator immediately.

That means the power will turn ON while I pressed the button, but it also turn off immediately when I release.

samchoy88, 2015-03-22:
Put a 10K pull low resistor at Q4 MOSFET gate can eliminate the bug.

charlespax, 2015-03-22:
It looks like the functions of SW_PWR and PWR_ONOFF are reversed. SW_PWR is

charlespax, 2015-03-22:
put signal to the MCU

samchoy88, 2015-04-03:
Bug fixed:
1. Identified the short of JP1 cannot not hold 3.3V always ON. Updated R21 position.
2. fixed the bug in reversed signal name between SW_PWR and PWR_ONOFF
3. Added the pull down resistor for mosfet and prevent noise trigger during initial stage

Before:
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

After:
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

charlespax, 2015-04-04:
Do you think we can close this?

Closed 2015-04-18.

Thread 161 (2015-03-23):

MCP9800 part number

charlespax, 2015-03-23:
We should specify which MCP9800 version we are using. It should be MCP9800A0 which gives and i2c address of 000. If we don't specify this, we may end up getting MCP9800A5, which has an address of 101.

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

samchoy88, 2015-04-03:
Updated schematic.
Clearly mark down the part number in schematic and its relationship between I2C slave address.

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

charlespax, 2015-04-04:
Great. Can we close this?

Closed 2015-04-18.

Thread 162 (2015-03-26):

LCD connector

charlespax, 2015-03-26:
The current LCD connector is not very good for hand soldering. It would be nice to find a better one. We may alternatively change the footprint, giving a larger pad such that a soldering iron can transfer heat to the pad.

It would also be nice to have a flip top version rather than one that is pressed in parallel to the board.

charlespax, 2015-04-08:
We also discussed a flip top connector, but I think it's not available in this pin pitch.

If we change the footprint such that the pads are more exposed, we should be able to hand solder more easily. @samchoy88 did you change the footprint?

samchoy88, 2015-04-08:
I made change for Electronics version 0.12.
I took FH12-12S-1SH(55) FPC flip-lock connector as component reference.

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

Extended the pads at the side for hand soldering easily and adapt to both flip-lock or insert lock connector.

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

charlespax, 2015-04-09:
Awesome! I think this is going to make assembly easier, especially with that flash chip next to the LCD connector. Closing issue.

Closed 2015-04-09.

Thread 163 (2015-04-06):

Battery charging rate

charlespax, 2015-04-06:
I believe the battery charging IC is set to charge at 500 mA. That doesn't leave anything for running the device if USB power is limited to 500 mA on the host side. Maybe we should change the configuration resistor such that the battery charges at 480 mA.

If I have a battery with a very low charge installed in the T400 and the T400 is powered on, the device will turn off when the USB is inserted into power. I believer the battery charger is taking all available current from the USB power and leaving none for running the MCU. After changing for a few moments plugging into USB does not power off the T400.

This is probably a problem for any charge level less than what will operate the T400. I suggest we reduce the battery charging rate by an appropriate amount.

samchoy88, 2015-04-08:
According to the datasheet MC73831, the current programming resistor should be 2.08K (round up to 2.1K) Ohms for 480mA charging current limit.
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

charlespax, 2015-04-08:
If we use 2.1k 1% resistors, the charge current can range from 473.9 mA to 478.5 mA. Using 5% resistors might be okay too. Using 10% resistors would put us in the danger zone. Please specify 1% resistors.

1%
1000/(2.1 + 0.01) = 473.9336492891
1000/(2.1 - 0.01) = 478.4688995215

5%
1000/(2.1 + 0.05) = 465.1162790698
1000/(2.1 - 0.05) = 487.8048780488

10%
1000/(2.1 + 0.1) = 454.5454545455
1000/(2.1 - 0.1) = 500

samchoy88, 2015-04-08:
More information will be provided in schematic.
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

MLXXXp, 2015-04-08:
Charles,
Your calculations are wrong. You don't just add 0.01 to get 1% of 2.1K. Likewise for 5% and 10%

1%
1000/(2.1 + 0.021) = 471.475719
1000/(2.1 - 0.021) = 481.000481

5%
1000/(2.1 + 0.105) = 453.514739229
1000/(2.1 - 0.105) = 501.253132832

10%
1000/(2.1 + 0.21) = 432.9004329
1000/(2.1 - 0.21) = 529.100529101

MLXXXp, 2015-04-08:
There is also a fairly large tolerance for charge current in the MCP73831 itself. See the *Current Regulation (Fast Charge Constant-Current)* section on page 3 of the datasheet.

Plus, there's some variation of charge current based on supply voltage and ambient temperature. See *FIGURE 2.6* on page 7 and *FIGURE 2.7* on page 8 of the datasheet.

http://ww1.microchip.com/downloads/en/DeviceDoc/20001984g.pdf

charlespax, 2015-04-09:
Oh crap! I meant to multiply 2.1 by those numbers. I feel really foolish right now :-(

Anyway, what should be the value of the PROG resistor to ensure our charge rate doesn't exceed 480 mA?

MLXXXp, 2015-04-09:
From what I can tell, the range of values given in the *Current Regulation (Fast Charge Constant-Current Mode)* section of the datasheet already takes into account voltage variations over the desired operating range, so we don't have to additionally refer to the graph in *FIGURE 2.6*.

Basically, it seems that the actual charge current can vary by +/- 10% of the value calculated. This is for ambient temperatures from -5°C to +55°C, but *FIGURE 2.8* indicates that charge current only goes lower outside this range, so it's not of concern.

So, to guarantee that the charge current doesn't exceed 480mA, we have to take 480mA as being 10% higher than the typical charge current. 480mA / 1.1 = 436mA.

Using the formula for the PROG resistor: 1000 / 436 = 2.2936

Then there's the tolerance of the resistor to take into account. Since the chip itself can vary by 10%, I'd specify a 1% tolerance resistor to minimize any further variance. So, 2.2936 would be the low side of the 1% tolerance range. 2.2936 / 0.99 = 2.3168

The closest EIA 1% value would be 2.32K

With a 2.32K resistor the typical charge current would be 1000 / 2.32 = 431mA

The highest and lowest possible charge currents, using 10% for the chip and 1% for the resistor would be:
Maximum 479mA
Minimum 384mA

charlespax, 2015-04-18:
Thanks, @MLXXXp nice work. @samchoy88 should we go with the 2.32K resistor then? What are your thoughts?

samchoy88, 2015-04-20:
I agree with @MLXXXp calculation, I have no problem to change the resistor to 2.32K.
For my understanding, most USB power supply can support 10% tolerance. It means the supplier can supply up to 550mA. Besides, the power consumption of the system is not significant compared with charging current. But it help to avoid power supply shut down when charging.

charlespax, 2015-04-20:
Great. Let's do it.

samchoy88, 2015-04-20:
Updated.
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

Closed 2015-04-20.

Thread 164 (2015-04-08):

LCD connector placement

charlespax, 2015-04-08:
In the next revision I would like to move the LCD connector a little closer to the top as indicated by the yellow box below. This should relieve some pressure on the LCD cable that is contributing to the LCD lifting issue (https://github.com/PaxInstruments/t400-enclosure/issues/105). Is this possible?

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

charlespax, 2015-04-18:
Looks complete. Closing issue.

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

Closed 2015-04-18.

Thread 166 (2015-04-08):

Battery reverse polarity protection

charlespax, 2015-04-08:
I would like to know if the T400 power system is protected against connecting a battery with reverse polarity. This is relevant to a situation where a user is hacking the device to run off an external power source via the battery connector or if they operate the device without an enclosure and use the wrong battery.

If USB power is connected, what happens if a battery is connected with reverse polarity?

If USB power is disconnected, what happens if a battery is connected with reverse polarity?

samchoy88, 2015-04-09:
If USB power is connected, what happens if a battery is connected with reverse polarity?
If USB power is disconnected, what happens if a battery is connected with reverse polarity?

Both of the above case will result to short circuit. But short circuit only happen in MCP73831 battery charger. As MOSFET Q1 do not turn on and it becomes the barrier of the reverse current.

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

samchoy88, 2015-04-09:
I can add a P-MOSFET to prevent the battery polarity reversed. But it still contribute a little bit power lost and cost in circuit.
http://www.ti.com/lit/an/slva139/slva139.pdf

Besides, there is a protection circuit inside BL-5C battery.
See issue: Does the BL-5C have internal protection? #46

charlespax, 2015-04-09:
We can keep things as they are as long as nothing is going to blow up.

charlespax, 2015-04-29:
Closing issue.

Closed 2015-04-29.

Thread 167 (2015-04-16):

LCD connector solder paste layer

charlespax, 2015-04-16:
The solder paste does not extend for the entire pad. Is this in purpose?

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

samchoy88, 2015-04-18:
It is a mistake while creating library.
This issue fixed in Rev 0.12
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

Closed 2015-04-18.

Thread 168 (2015-04-20):

Update material list

samchoy88, 2015-04-20:
Update the attribute of each component on schematic except those resistors and capacitors.
Remaining 2 components has unknow part number or manufacturer.
- Unknow manufacturer of LG132643-DW
- Unknow manufacturer and Part no. of BL-5C battery connector

charlespax, 2015-04-24:
The LCD is a custom manufactured part based on the LG132643-DW. You can list the manufacturer as Pax Instruments and the part number of PI132643FFDWHUV-P1

Did you get the battery connector part number from the guy in the HQB booth?

samchoy88, 2015-04-24:
They only gave me the name of the connect in Chinese - "77电池座". And it is really common in market with the part number "BC-4-3P" for 3.0MM pitch 7.7MM 3P seat height of 77 Battery Battery Connector.
So, I will mark it in description as "Right angle battery connector, 3P, Pitch=3mm, 7.7mm height"
part number is "BC-4-3P"

charlespax, 2015-08-06:
Is the material list finished? Can we close this?

samchoy88, 2015-08-10:
Yes, all critical parts (except the common parts i.e resistors and capacitors) must have the following attribute:
1. MF (Manufacturer / Supplier / Brand)
2. MPN (Manufacturer Part number)
Additional note may provide in schematic. see below example:
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

These attributes also exist in BOM list
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

charlespax, 2015-08-11:
Done. Closing issue

Closed 2015-08-11.

Thread 169 (2015-04-26):

MCU VBAT_SENSE on PD6 is not Analog Pin A10

samchoy88, 2015-04-26:
I got incorrect analog reading from analogRead(VBAT_SENSE);
I finally found the MCU component in schmatic created by sparkfun named the pin PD6 incorrectly.
someone posted the issue on Arduino forum and find the mistake too.
http://forum.arduino.cc/index.php?topic=82992.0
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

samchoy88, 2015-04-26:
Just required to correct the schematic of PD6 pin become D12/A11

charlespax, 2015-04-27:
Did you change this in our part library and update the schematic and silkscreen?

samchoy88, 2015-06-04:
Not yet change on schematic and silkscreen, please confirm to change

charlespax, 2015-06-17:
Yes, please make our parts correct.

samchoy88, 2015-08-10:
According to the pin assignment in pins_arduino.h.
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

the part library corrected as follow:
Before:
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

After:
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

Closed 2015-08-11.

Thread 170 (2015-04-29):

Thermocouple connector footprint

charlespax, 2015-04-29:
We need a footprint for the thermocouple connector (https://github.com/PaxInstruments/t400-electronics/issues/17).

The connector should overhang the PCB a bit. @starno can you give dimensions for this? The PCB will need a slot for the vertical tab and a cutout for the 30 degree angled tab on the back.

This should go on the next revision.

Here is the part drawing.
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

MLXXXp, 2015-04-29:
Should the cutout for the 30 degree angled tab be plated through and around, and exposed on the solder mask, to allow the tab to be soldered? This could give more mechanical strength to the clip to board bond.

charlespax, 2015-04-29:
Here is a bottom view of the connector.
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

I imagine the footprint in the image below. The vertical tab would be a milled slot that is plated through. The two slots for the 30 degree tabs would be milled and unplated. The area under the connector would be a solder pad, some of which would stick out a little from the connector to aid hand soldering.
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

I don't think there would be any harm in plating the thirty degree slots, but I don't think they would be soldered in the SMD process. I think I would want that area clear of solder, so it doesn't interfere with the male connector. I think if someone hand soldered the thirty degree slot area from the bottom, it would be fine. Not really sure what's best.

starno, 2015-05-04:
Ok, with the latest rev connector, a **1.5mm overhang** off the top edge of the PCB will give ~0.5mm clearance between the top panel and connector inlet.
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

Lets go with 1.5mm off the board.  (distance does not include the bent inlet portion)

charlespax, 2015-05-04:
Here is a technical drawing. There should be enough information to make a footprint.
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

samchoy88, 2015-06-04:
What is the part number of this clip?

charlespax, 2015-06-17:
Manufacturer: Pax Instruments
Product number: 1024
Link: http://paxinstruments.com/products/sku1024/

samchoy88, 2015-06-18:
1024 TC connector is ready in Pax instrument library
See https://github.com/PaxInstruments/PaxInstruments-Eagle-Libraries
Footprint locate In the PaxInstruments-Connectors.lbr

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

Preview Footprint on T400 PCB.
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

charlespax, 2015-06-18:
When I was on my phone I thought you used the old design files in the electronics repository. Now that I look at the first post of this issue I see the correct drawing. I think everything should be good then. I'll order these boards right away. Thanks, Sam.

Closed 2015-06-18.

Thread 171 (2015-04-29):

Pax Instruments Eagle library

charlespax, 2015-04-29:
We should move each part to the appropriate library in the Pax Instruments Eagle library repository (https://github.com/PaxInstruments/PaxInstruments-Eagle-Libraries)

charlespax, 2015-04-29:
The SparkFun stuff should be moved into PaxInstruments-SparkFun.lrb, which has a description providing attribution to SparkFun. This will solve issue https://github.com/PaxInstruments/t400-electronics/issues/35.

All the other libraries are for parts created by Pax Instruments and are in the public domain.

samchoy88, 2015-08-12:
Updated below library:
- Connectors
- Digital IC
- DiscreteSemi
- Electromechanical
- Power IC
- Boards
- Display

Closed 2015-08-26.

Thread 172 (2015-04-30):

Fuse temperature

charlespax, 2015-04-30:
The fuse gets pretty hot. We should select a different value such that any heat generated by the PTC fuse is negligible.

Revision 0.12 of the PCB was installed in the enclosure with a mostly discharged battery. After allowing the battery to charge for about thirty minutes I opened the enclosure and took several thermal images. The highest recorded temperature of the PTC fuse was 151 C.
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

After letting the case sit open for a few minutes the temperature decreased to 132 C
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

During this time the ADC was approximately 86 C. We should check to see how this temperature can affect the ADC readings.
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

Even with the high temperature of the PTC the temperature across the isothermal plane was at a consistent 83.5 C. I believe this demonstrates the effectiveness of the thermal isolation slots and the thermal conductivity of the isothermal plane.
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
(Thermography is so cool!)

samchoy88, 2015-06-04:
We are using MF-MSMF050 fuse in this circuit.
This is the specification of the fuse
http://www.mouser.com/ds/2/54/mfmsmf-72300.pdf
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

It seem the resistance is relatively low 0.15Ohms ~ 1 Ohms.
When it is charging, it raise temperature to 151 Fahrenheit (66 Celcius).
If it is necessary to reduce the internal heat source, I recommend not to use fuse.
As all  PTC Resettable Fuses using similar technology to cut off circuit when temperature raise to certain level.

Besides, the Time to Trip is relatively long (around 1 second @ 2.5A current). Some of the components may damaged within that period.
That means the fuse protection may not effective.

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

charlespax, 2015-06-17:
Is it safe to remove the Fuse? If so, we should remove it.

samchoy88, 2015-08-05:
I think we should remove it.

charlespax, 2015-08-06:
Okay, let's remove it.

samchoy88, 2015-08-12:
I think this case can be close after removed the fuse

samchoy88, 2015-08-25:
Fuse removed in Rev 0.13
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

Closed 2015-08-25.

Thread 173 (2015-05-26):

Blade connector test

charlespax, 2015-05-26:
I want to take the Keystone connector and make a footprint that is very close together. Close enough such that the thermocouple cannot move left to right.

charlespax, 2015-08-08:
Will not do. Closing issue.

Closed 2015-08-08.

Thread 175 (2015-06-03):

TEMP_INT breakout

charlespax, 2015-06-03:
We can breakout the TEMP_INT pin on the MCP9800 by adding a single pin header.

Probably shouldn't do this. Adding to icebox.

charlespax, 2015-08-08:
Will not do. Closing issue.

Closed 2015-08-08.

Thread 176 (2015-06-03):

USB charging negotiation

charlespax, 2015-06-03:
Is there anything that needs to be done to negotiate the USB charge rate?

samchoy88, 2015-06-16:
It is possible to negotiate with USB host to get 2 Amps current (otherwise only 500mA available).
But it also made the charger IC and battery increase temperature rapidly.

charlespax, 2015-08-06:
We can only do up to 500 mA.
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

Closed 2015-08-06.

Thread 178 (2015-06-03):

RTC battery

charlespax, 2015-06-03:
We need to select a battery part number for the RTC battery. We need to confirm it works with the electronics.

samchoy88, 2015-08-09:
The following brand are the reliable brand/suppliers in Asia region.

Brand: GPI Int'l Ltd
http://www.gpbatteries.it/allegati/datasheet/specialistiche/litio/103123_CR1620.pdf

Brand: Maxell
http://www.maxell.com.tw/images/uploads/2014/10/CR1620_DataSheet_e.pdf

Brand: Panasonic
http://industrial.panasonic.com/lecs/www-data/pdf2/AAA4000/AAA4000CE45.pdf

charlespax, 2015-08-09:
Please order samples of the batteries you think we should use.

samchoy88, 2015-08-12:
Purchased some 1220 batteries and test and Currently testing below brand
Brand: Sony
Part number: CR1220
http://www.sony.net/Products/MicroBattery/cr/pdf/cr1220.pdf

Brand: Maxell
http://biz.maxell.com/files_etc/9/cr/en/CR1220_DataSheet_e.pdf

charlespax, 2015-08-26:
Please add a note to the part that it takes a CR1220 battery.

samchoy88, 2015-08-27:
Added note in schematic
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

Closed 2015-08-27.

Thread 179 (2015-08-08):

Thermocouple connector placement

charlespax, 2015-08-08:
The thermocouple connectors must move closer to the top panel (https://github.com/PaxInstruments/t400-enclosure/issues/107). We could probably have the connectors hang over the PCB, but it would be best to extend the PCB top edge a little.

samchoy88, 2015-08-09:
How much I can extend at the upper edge?

charlespax, 2015-08-09:
You cannot extend the entire upper edge. About 70 mm to 74 mm of the top edge can be extended because it will have to fit inside the top panel recess as seen in the image below.
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

You can extend it between 2.5 to 2.75 mm as seen in this image.
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

samchoy88, 2015-08-10:
Thermo-clip hang out a little bit (below 2.7mm), but I worry the clip and conflict with the LCD stand at both left and right side.
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

charlespax, 2015-08-11:
I will continue work on the connector footprint. I've looked at the spacing using the physical LCD, PCB, and connectors I have, so I'm 100% confident that we can make a footprint that works. I will make another test PCB that includes several versions of the this area of the T400 board, each with a different footprint. Let's hold off on ordering 0.13 PCBs until I can test the new thermocouple connectors on the new test PCB. The factory says we'll have new samples tomorrow. I'll make the test PCB today and order it for rush delivery. I should have it Thursday or Friday.

charlespax, 2015-08-11:
I've updated the TC connector in the Eagle Library repo to tighten up the Dimensions. I checked it on the T400 PCB, but did not commit the changes. If this footprint works, it would look like this:
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

I've added another footprint test PCB to the repo to get the TC contacts as close as possible. We'll see which is best once we have the connectors this week and the test PCBs come in.
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

Don't worry about changing the TC connector on the T400 PCB right now. I'll let you know the results of the new test PCB. In the mean time you can continue work on the T400. Any changes to the footprint will be small and only have trivial, if any, affects on the layout.

samchoy88, 2015-08-12:
Look better now.
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

Closed 2015-08-26.

Thread 180 (2015-08-08):

Logo

charlespax, 2015-08-08:
We should add a better logo to the board. One that has Pax Instruments built into it. See https://github.com/PaxInstruments/PaxInstruments-Eagle-Libraries/issues/4

Closed 2015-12-16.

Thread 182 (2015-08-08):

Verify PCB version

charlespax, 2015-08-08:
Verify the silkscreen has the correct PCB version.

samchoy88, 2015-08-25:
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

Closed 2015-08-25.

Thread 183 (2015-08-10):

Connect MCU VBUS pin to USB connector - VBUS_IN

samchoy88, 2015-08-10:
Firmware using VBUS pin on MCU to detect USB power supply connection status.
see below battery status defined in t400-firmware/t400/functions.h
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

charlespax, 2015-08-11:
Can we close this?

samchoy88, 2015-08-11:
OK

Closed 2015-08-11.

Thread 184 (2015-08-13):

Move SW_PWR off of PB0/SS

cibomahto, 2015-08-13:
SW_PWR unfortunately needs to be moved off of PB0(SS), since the SS pin cannot be used as an input while the hardware SPI port is enabled. It's actually best to avoid PB0 completely, since it is toggled uncontrollably when the SPI port is initialized. I was able to get the power circuit working correctly by making these changes:

Move SW_POWER to PB7 (D11)
Move POWER_ONOFF to PD5 (TXLED/D30)

samchoy88, 2015-08-18:
According to current design, PB7 assigned to switch OFF system by I/O pin (PWR_ONOFF).
If we avoid using PB0/SS pin, is it OK to change using PD5 as the control pin?
I saw Matt released issue (Procedure for modding V12 board to act like a V13 board #190).
And give instruction on "Disonnect PWR_ONOFF from PB7 and connect to PD5", but it already assign as TXLED in Arduino.

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

Potential problem may raise after this change, I hope this issue confirmed once again in here.

samchoy88, 2015-08-18:
Since we still have 2 reserved I/O pin.
We can use A0 or A1 pin as PWR_ONOFF output pin and control device OFF.
This avoid using TXLED (Pin 22 <PD5>) and RXLED (Pin 8 <PB0>).

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

cibomahto, 2015-08-18:
Please follow my suggestion exactly. I've already modified the board design and bootloader in arduino so that TXLED can be used as D30.

Closed 2015-08-26.

Thread 185 (2015-08-13):

Clock frequency

charlespax, 2015-08-13:
The firmware could use some extra clock cycles to get things done. We may be able to kick things up to 12 MHz on our 3.3V or even overclock at 16 MHz.

charlespax, 2015-08-13:
The datasheet gives us maximum frequency versus Vcc:

To calculate the max clock frequency we use:
m = (16 - 8)/(4.5 - 2.7)      // m = 4.44444
x=3.6 V
Fmax =m × (x-2.7) + 8      // Fmax = 12 MHz, at 3.3 V Fmax = 10.6666 MHz

charlespax, 2015-08-13:
Based on this information and my conversation with Matt, I want to change the clock to 12 MHz.

MLXXXp, 2015-08-13:
I'm pretty sure that you have to run at either 8MHz or 16MHz if you want to use full-speed USB.

See sections 6.1.5 and 21.4 in the ATmega32U4 datasheet.

charlespax, 2015-08-13:
Good call. I think I saw something about that in the datasheet. I'll give it another look and cite the information. Removing from milestone 13 for now.

cibomahto, 2015-08-13:
Good catch. Bummer that 12MHz isn't an option! It seems we need full-speed USB to do CDC-ACM.

charlespax, 2015-08-13:
Is there a place in the datasheet that explicitly states this? I wonder if the internal oscillator can be used for the USB prescaler.

charlespax, 2015-08-14:
For Full Speed operation the USB controller requires a 48 MHz signal from the internal PLL, which would require a signal from an external clock source for Full Speed. The internal RC can be used as input to the PLL only in Low Speed USB operation.

Looking at the PLL prescaler, PLL, and PLL postscaler, there just isn't a way to multiply/divide to get the 48 MHz to the USB. It looks like we're stuck with 8MHz

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

Closed 2015-08-14.

Thread 186 (2015-08-13):

Move RTC_INT to PD3(INT3) and SW_B to PE6(INT6)

cibomahto, 2015-08-13:
INT6 is a special interrupt that needs to be configured as level sensitive in order work as a wakeup source for the processor. Unfortunately, the 1Hz reference signal from the RTC is a square wave with 50% duty cycle, so connecting it to INT6 and enabling the level sensitive interrupt means that the processor is stuck servicing this interrupt for 50% of the time (the alternative is to turn off level sensitivity and never sleep the processor)

I’d like to move RTC_INT off on INT6 and onto INT3, to mitigate the weirdness of INT6 as much as possible. This will push the issue to SW_B, where we can mitigate it with a workaround (disable the INT6 source as soon as it is triggered, and only re-enable it when going back to sleep).

Combining this and #184, the new interrupt table is:

PB0: PCINT0: (can’t use, SS)
PB1: PCINT1: (can’t use, SCK)
PB2: PCINT2: (can’t use, MOSI)
PB3: PCINT3: (can’t use, MISO)
PB4: PCINT4: SW_C
PB5: PCINT5: SW_D
PB6: PCINT6: SW_E
PB7: PCINT7: SW_PWR
PD0: INT0: (can’t use, SCL)
PD1: INT1: (can’t use, SDA)
PD2: INT2: RTC_INT
PD3: INT3: SW_B
PE6: INT6: SW_A

I’ll mod my Rev12 board tomorrow to verify that these changes will work.

cibomahto, 2015-08-13:
Here's a logic capture of what's happening:

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

cibomahto, 2015-08-13:
And note that we can't disable the INT6 interrupt to get around this, because it would prevent RTC_INT from being able to wake the processor up again later (or we'd have to keep the processor awake 50% of the time, while the 1Hz signal is asserted).

The user isn't likely to hold SW_B down for long periods of time, so putting the disable-then-reeenable-before-sleep workaround should work fine.

samchoy88, 2015-08-18:
According to the suggested Pin assignment

PB4: PCINT4: SW_C
PB5: PCINT5: SW_D
PB6: PCINT6: SW_E
PB7: PCINT7: SW_PWR
PD2: INT2: RTC_INT
PD3: INT3: SW_B
PE6: INT6: SW_A

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

the PCB layout would be like this.
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

Is that possible to have some flexible on pin assignment?
PB4: PCINT4: RTC_INT
PB5: PCINT5: SW_D
PB6: PCINT6: SW_E
PB7: PCINT7: SW_C
PD2: INT2: SW_B
PD3: INT3: SW_A
PE6: INT6: SW_PWR

then the PCB layout may be much better
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

cibomahto, 2015-08-18:
Two issues:
1. RTC_INT must be on INT2 or INT3 so that it has it's own interrupt vector. all of the PCINT interrupts share a single vector.
2. Understand that this will be a couple more hours of software work to change and verify the button interrupts.

samchoy88, 2015-08-18:
OK, that make sense.

charlespax, 2015-09-28:
This did not get done int version 0.13  :-(

charlespax, 2015-10-07:
The firmware and electronics match and are connected properly.

Closed 2015-10-07.

Thread 187 (2015-08-14):

AT90USB microcontroller

charlespax, 2015-08-14:
The AT90USB series should be considered for the next hardware generation.

The [Industruino](https://industruino.com/page/home) has an ATmega32U4 and AT90USB1286 version for each of their products. They have have [AT90USB1286 board definition files](https://github.com/Industruino/Board-definition-files) for the Arduino IDE ready to go.

## Operating frequency
The AT90USB has the same operating clock limitations as the ATmega32U4 (https://github.com/PaxInstruments/t400-electronics/issues/185). Running it at 3.3 V we would likely have to operate at 8 MHz to stay within specification and also use Full Speed USB.
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

cibomahto, 2015-08-14:
For comparison, the Freescale ARM chips are <$2.5 in quantity 500 (lowest i've paid was $1.40), and can run at 48MHz in those conditions, have 16k of ram, and 32-128k flash.

charlespax, 2015-08-14:
Okay, I changed "next hardware generation" to "T400-based development kit". The next generation will certainly be ARM. However, the ATmega32U4 and AT90USB218 appear to be nearly identical.

At a minimum we are releasing a dev kit based on the ATmega32U4. Hopefully, we can drop in the AT90USB128 with only trivial changes, so we can get something out the door quickly. Otherwise, I'd just go with the 32u4. I want to get people hacking with minimal effort.

charlespax, 2015-12-18:
Here is the AT90USB pin out with the ATmega32U4 pins noted.
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

Thread 188 (2015-08-14):

Add 4.7k pulldown to VBUS input

cibomahto, 2015-08-14:
Unfortunately, when USB is disconnected and the device is powered from battery, there is a small amount of leakage through the battery charging circuit that leaves a residual voltage of 3.7V or so on the VUSB line. This prevents the VUSB input on the processor from being able to determine if the device is plugged in or not.

The most straightforward thing to do here is add a small pulldown resistor to bleed this current down. VUSB needs to be <1.4V for the processor to detect it as disconnected. Some quick experimentation shows that a 4.7k resistor drops the voltage to .37v, which means it creates a load of ~80uA on the battery at all times. Increasing the resistance to 11k raises the voltage to .8v but only drops the load to 72uA, so sticking with something around 4.7k is probably the best compromise between detection capability and battery life.
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

charlespax, 2015-09-28:
Version 0.13 has a 10k resistor. Change this to 4.7k.

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

Closed 2015-10-03.

Thread 189 (2015-08-15):

Suggestion: depopulate or remove external pullups on the buttons

cibomahto, 2015-08-15:
External pullups are usually only necessary when the traces from button to processor input are long, or expected to be subject to large amounts of external noise. Neither of these seems to apply here, and the internal resistors should work fine for the buttons.

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

samchoy88, 2015-08-17:
I think these resistors keep in PCB layout but DNP in material list.

charlespax, 2015-08-17:
Yes, Sam, let's keep them in the design as DNP. It can be useful to have them there in other derivative designs. For example, to make the LCD shield I just copied the Eagle files and removed a bunch of parts. It would be good to now have to add them back later. However, if we run into an issue we can solve by removing them, we should remove them. I made a note for production https://github.com/PaxInstruments/t400-electronics/issues/191

Closed 2015-08-17.

Thread 190 (2015-08-15):

Procedure for modding V12 board to act like a V13 board

cibomahto, 2015-08-15:
This is required to test the latest firmware:
1. Add 4.7k resistor between VUSB and ground (#188)
2. Disconnect SW_B from PD3(INT3) and connect RTC_INT in its place (#186)
3. Disconnect RTC_INT from PE6(INT6) and connect SW_B in its place (#186)
4. Disonnect PWR_ONOFF from PB7 and connect to PD5 (#184)
5. Disconnect SW_PWR from PB0(SS) and connect to PB7 (#184)
6. Connect VUSB to net VBUS_IN (#183)
7. Not shown: Change R20 to 18.7K and R24 to 34K (#156)
8. Not shown: Add capacitor between VBAT_SENSE and ground (#156)
9. Optional: Remove R16, R15, R8, R11, R12 (pull-ups are enabled in firmware) (#189)

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

cibomahto, 2015-08-16:
Original images were messed up
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

charlespax, 2015-10-03:
In step 2, SW_B is actually connected to PD2(INT2). This is in the schematic, the picture you uploaded, and the datasheet.
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

To correct step 2, 2. RTC_INT will be connected to PD2(INT2) and SW_B will be connected to PE6(INT6).

cibomahto, 2015-10-09:
Ok, that sounds correct.

Closed 2015-10-03.

Thread 191 (2015-08-17):

DPN pull-up resisors

charlespax, 2015-08-17:
The firmware enables the 32u4 internal pullup resistors. We should DNP R16, R15, R8, R11, R12 in production.
See https://github.com/PaxInstruments/t400-electronics/issues/189#issuecomment-131687633

samchoy88, 2015-08-18:
Added "Populate" attribute in pull-up resistor, this will show in BOM list
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

Closed 2015-08-18.

Thread 192 (2015-08-22):

USB connector

charlespax, 2015-08-22:
We are using a through hole USB connector. There is another connector that has through hole supports, but surface mount contacts. We should figure out which one to use. We should stick with the through hole version for now and change to the SMT version in production. Sending to ice box.

charlespax, 2015-10-04:
Done long ago.

Closed 2015-10-04.

Thread 193 (2015-08-26):

Vias under thermocouple connectors

charlespax, 2015-08-26:
I'm concerned about the vias under the thermocouple connectors. We are using tented vias, but if there is an error or if we switch to untended vias, there could be a short. I would like to remove the four vias under the connectors.

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

samchoy88, 2015-08-27:
Removed Via under connector
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

charlespax, 2015-08-31:
This has not been committed to github. Reopening.

Closed 2015-08-31.

Thread 194 (2015-08-26):

Traces through LCD slots

charlespax, 2015-08-26:
There are some traces going through or too close to the slots the LCD clips into. These should be moved.

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

samchoy88, 2015-08-31:
Fixed
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

charlespax, 2015-08-31:
This has not been committed to github. Reopening.

samchoy88, 2015-08-31:
Yes, generate Gerber file to make sample

Closed 2015-08-31.

Thread 195 (2015-08-26):

Silkscreen overlap

charlespax, 2015-08-26:
The thermocouple channel labels are cutoff by some components. These can be moved a up a little.
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

samchoy88, 2015-08-31:
Fixed
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

Closed 2015-08-31.

Thread 196 (2015-08-26):

Logo update

charlespax, 2015-08-26:
Please update to the square logo in the Aesthetics library, 0.5 inch if it fits, but 0.25 inch is fine too.

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

samchoy88, 2015-08-31:
Updated
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

charlespax, 2015-08-31:
This has not been committed to github. Reopening.

Closed 2015-08-31.

Thread 198 (2015-09-27):

Buttons are swapped

charlespax, 2015-09-27:
The version 0.13 PCB I have differs from the modified 0.12 board (https://github.com/PaxInstruments/t400-electronics/issues/190). The record buttons appears to be swapped with the interval button.

charlespax, 2015-10-03:
This seems to be fine. I made a note in the t400.h pin definitions on which pins to switch between 0.12-mod and 0.13.

cibomahto, 2015-10-09:
This seems fine. The INT6 input is goofy but the workaround should be effective either way.

Closed 2015-10-03.

Thread 199 (2015-09-27):

System does not power down

charlespax, 2015-09-27:
The version 0.13 PCB I have does not stay powered down. When the unit is on I press the power button. Then the LCD clears and the backlight turns off. Then data appears on the screen again and the backlight is off. The system still reads and displays temperature data and graphs.

The system appears to not reset. The data on the screen is persistent.

charlespax, 2015-10-04:
On 0.13 PWR_ONOFF is connected to PD5, which is TX LED. I think the issue may be related to that. On 0.12 nothing was connected to this pin. We may need to change something in the bootloader to use the TX LED pin.

charlespax, 2015-10-04:
Just a bad solder joint between the QFN ATmega32U4 and the PCB. I tossed a QTFP package on there and all is well.

Closed 2015-10-04.

Thread 202 (2015-09-27):

Isothermal plate

charlespax, 2015-09-27:
Add a metal plate to the bottom of the isothermal plane. Adhere with thermal adhesive.

Possibly bolt it to the PCB. Drill and tap the plate. Drill the PCB.

charlespax, 2015-10-04:
It looks like we don't need this. Closing.

Closed 2015-10-04.

Thread 208 (2015-10-04):

MicroSD card power draw

charlespax, 2015-10-04:
I may have damaged a MicroSD card. Now when I put it in the T400 it get very hot. Running version 0.13 PCB. The eekoo cards are bad. Just review the schematic and see if anything could go wrong. maybe there is a collision with different things pulling high/low the SPI lines.

charlespax, 2015-12-16:
Just shitty SD cards.

Closed 2015-12-16.

Thread 209 (2015-10-04):

Recording delay

charlespax, 2015-10-04:
On my 0.13 board the logging start/stop does not always work. It looks like I have to press start/stop, then another button, then start/stop will be responsive again.

charlespax, 2015-10-06:
Seems like a firmware issue. Moving to https://github.com/PaxInstruments/t400-firmware/issues/189.

Closed 2015-10-06.

Thread 210 (2015-10-04):

Temperature jump

charlespax, 2015-10-04:
Sometimes the temperature reading jumps up a few dozen to a few hundred degrees. This seems to happen when plugging or unplugging the thermocouple.

Tsillen, 2015-10-06:
Just use a low pass filter in software or disable the input for x time when it is detected.

charlespax, 2015-12-16:
I'm going to dump this in the ice box. Will not fix in the shipped version since it does not affect normal operation.

Thread 211 (2015-10-06):

MicroSD card heating

charlespax, 2015-10-06:
I have some eekoo 1 GB cards I've been testing. So far two of them have gotten very hot. T400 issue or crappy MicroSD cards?

Tsillen, 2015-10-06:
There is no reason why an SD card should get hot. I would advice testing with some decent quality ones like Sandisk or Kingston.

Worst case you might want to check which voltage you are providing for the SD cards. Maybe it is to high or even oscillation.

charlespax, 2015-10-06:
The other ones I have are fine. It's only been the eekoo ones. But I'll also look into this further to ensure it's not the circuit. Don't worry though, we'll ship with a reputable brand :-)

Tsillen, 2015-10-06:
Good. If you have questions about whatever just ask me on skype: tsillen

charlespax, 2015-12-16:
Shitty MicroSD cards. This has not appeared again.

Closed 2015-12-16.

Thread 212 (2015-10-06):

Switch bouncing

charlespax, 2015-10-06:
The switches seem to bounce. See https://github.com/PaxInstruments/t400-firmware/issues/189 for background. Let's figure this out.

charlespax, 2015-10-06:
Without any modification these are typical SW_B keypresses:
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

I tossed a 0.1 uF cap between SW_B and GND. All presses look like this:
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

charlespax, 2015-10-06:
There is a problem during power on. There is a quick spike in power, probably transferring from bootloader to firmware. This is triggering the record function such that the device is already recording when the screen comes on.

In the screenshot below a 0.1 uF installed SW_B. The red area shows the device powering down. The green area is the device powering on. There's also a few button presses to the right.
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

Here is the same process with a 0.47 uF cap installed. There is still a small spike, but it is not triggering the record function.
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

charlespax, 2015-10-06:
It's only causing a problems when connected to the Oscope.

charlespax, 2015-10-06:
Okay. I have to add caps to between each switch and GND. Populate the 10 pullup resistors.

charlespax, 2015-12-16:
I have put the latest revision on the scope and have not seen this issue. I think maybe there was either a software problem of the issue was due to the soft power logic circuit, which has been changed. Closing issue.

Closed 2015-12-16.

Thread 215 (2016-01-04):

Battery holder alternatative

charlespax, 2016-01-04:
There is a compatible battery holder available all over Shenzhen, it's just a little longer. Let's move the battery holder up a bit, so we can use it. Otherwise, it would interfere with the enclosure. This would also solve #214 .

Thread 218 (2016-04-10):

Battery draw

charlespax, 2016-04-10:
It has been reported that the battery can be drained to zero. http://community.paxinstruments.com/t/t400-battery-life/149. Investigate this and determine what changes may need to be made to the circuit in future revisions.

Questions:
- How much will the T400 drain the battery before it powers off?
- What is the leakage current on all the components connected to the battery?

Here are the relevant schematic sections:
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

Originally posted in https://github.com/PaxInstruments/t400-firmware/issues/203

slowcoder, 2016-05-20:
As per the datasheet for the DW01z in the BL-5C battery, it has "Overdischarge protection".

This means that if the cell voltage drops below a safe value, the cell is disconnected from the external connectors on the pack for safety.
Meaning, the _battery pack_ will measure 0V, but the actual cell-voltage is higher (should be 2.4V when the protection kicks in)

Once charging commences, the protection will disconnect, and the cell is connected to the external connectors again.

Thread 219 (2016-05-19):

MCP73831 Note

charlespax, 2016-05-19:
Make sure the MCP73831 is specified in the schematic and BoM. Otherwise, there would be charge problems.

slowcoder, 2016-05-19:
That would probably be which version of the MCP73831 you intend to be used. The different MCP73831-X chips have different CC->CV thresholds (4.2V, 4.35V, etc)

samchoy88, 2016-12-10:
The exactly part number should be in Eagle schematic
The part number is MCP73832T-2DCI/OT
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

charlespax, 2016-12-11:
I've updated the library device and labwiz schematic to "MCP73831/2"

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

Closed 2016-12-11.
