PaxInstruments/t400-electronics/referenceDesigns/PaxInstruments-T400-0.7.pdf

R19 C³⁵ | C³⁶
USB | Battery charging | Soft power | 3.3 V regualtor

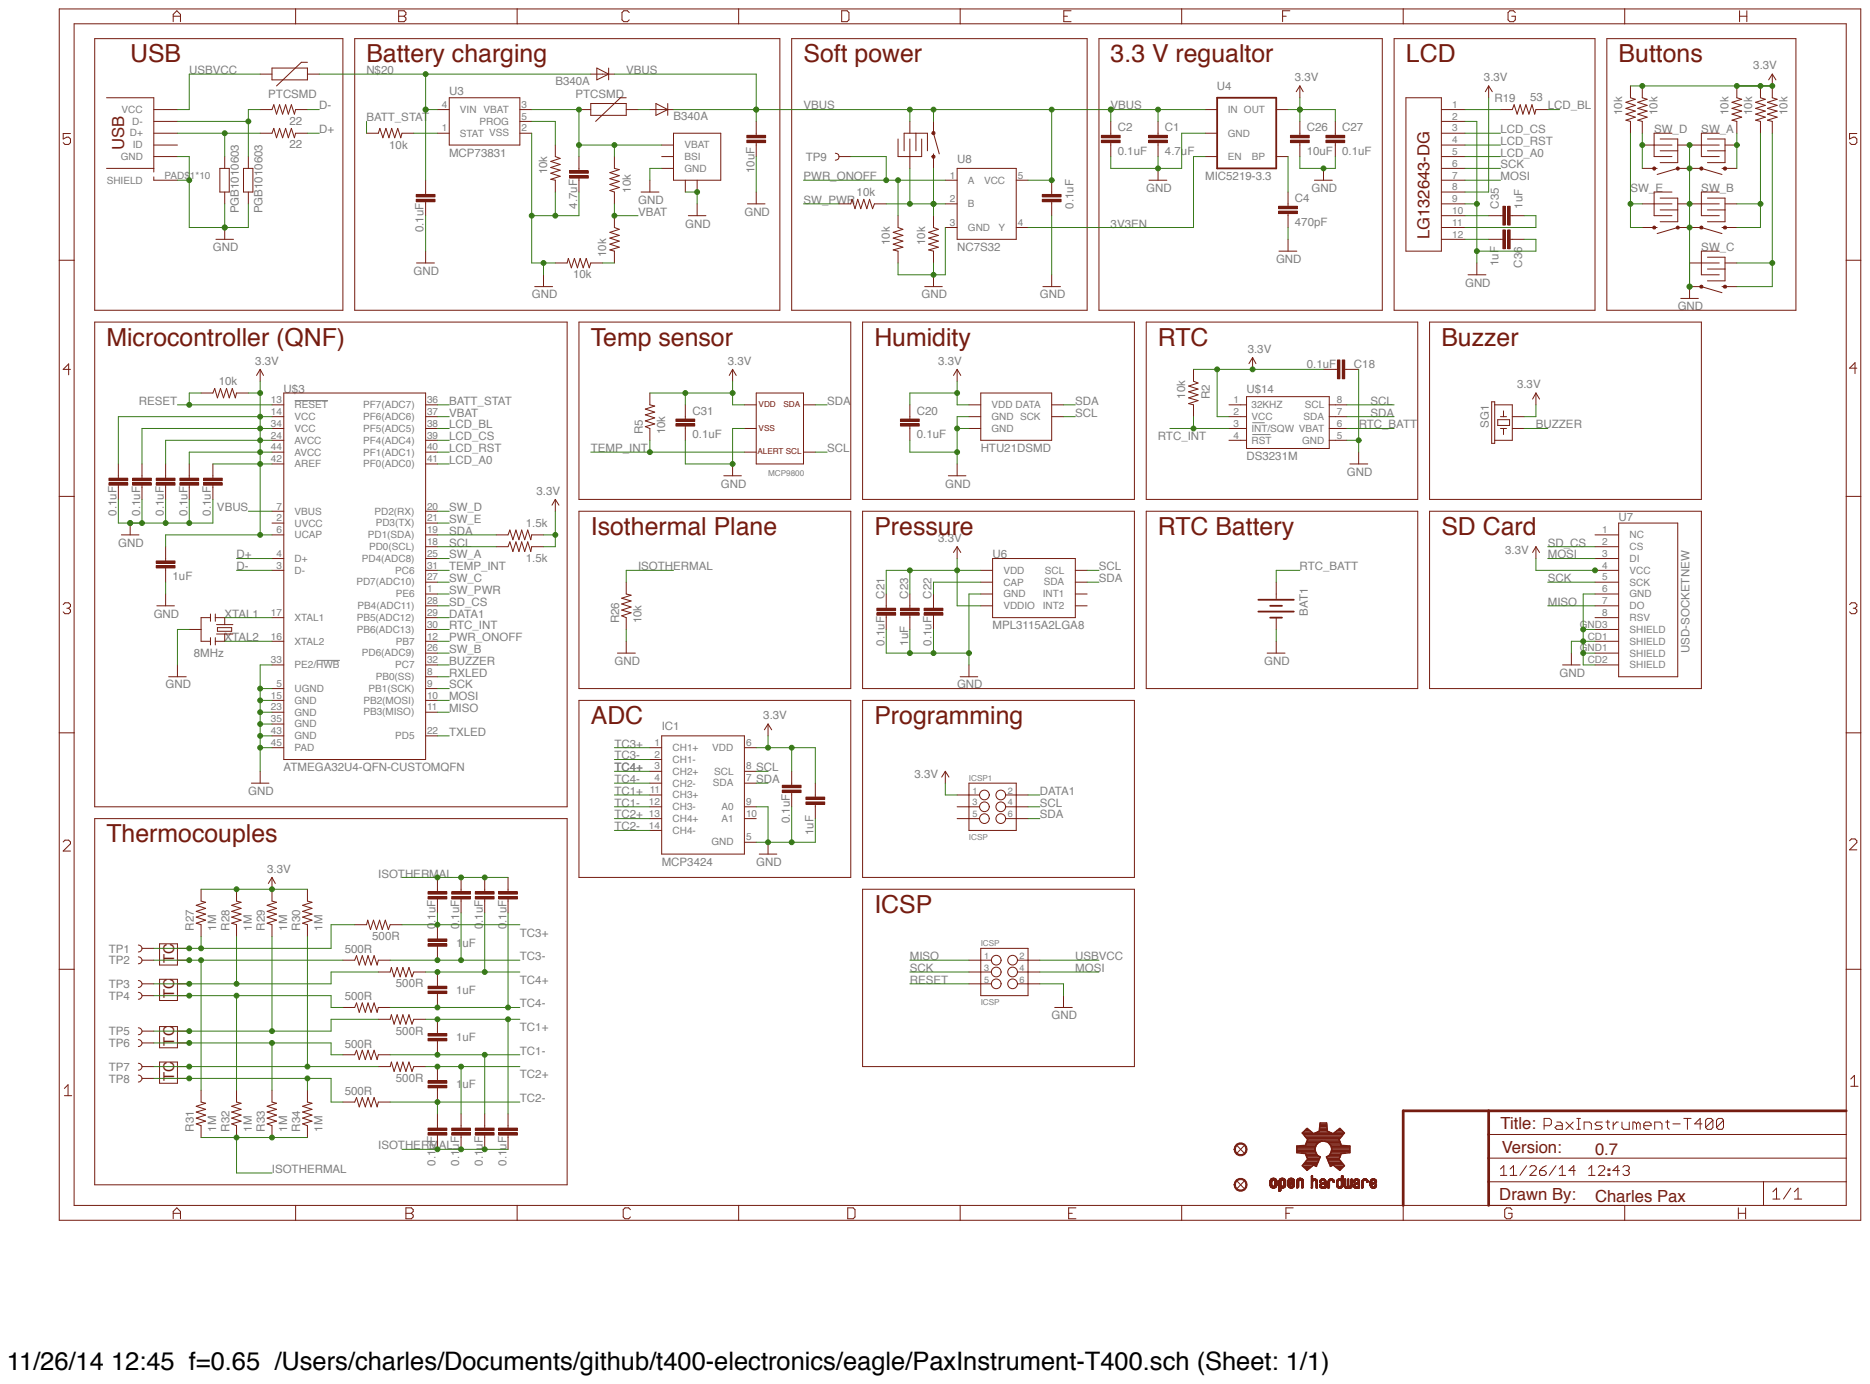
[picture p55: page 1]

Drawn By: Charles Pax

11/26/14 12:45 f=0.65 /Users/charles/Documents/github/t400-electronics/eagle/PaxInstrument-T400.sch (Sheet: 1/1)
