PaxInstruments/t400-electronics/referenceDesigns/PaxInstruments-T400-0.8.pdf

R19 C³⁵ | C³⁶
USB | Battery charging | Soft power | 3.3 V regulator

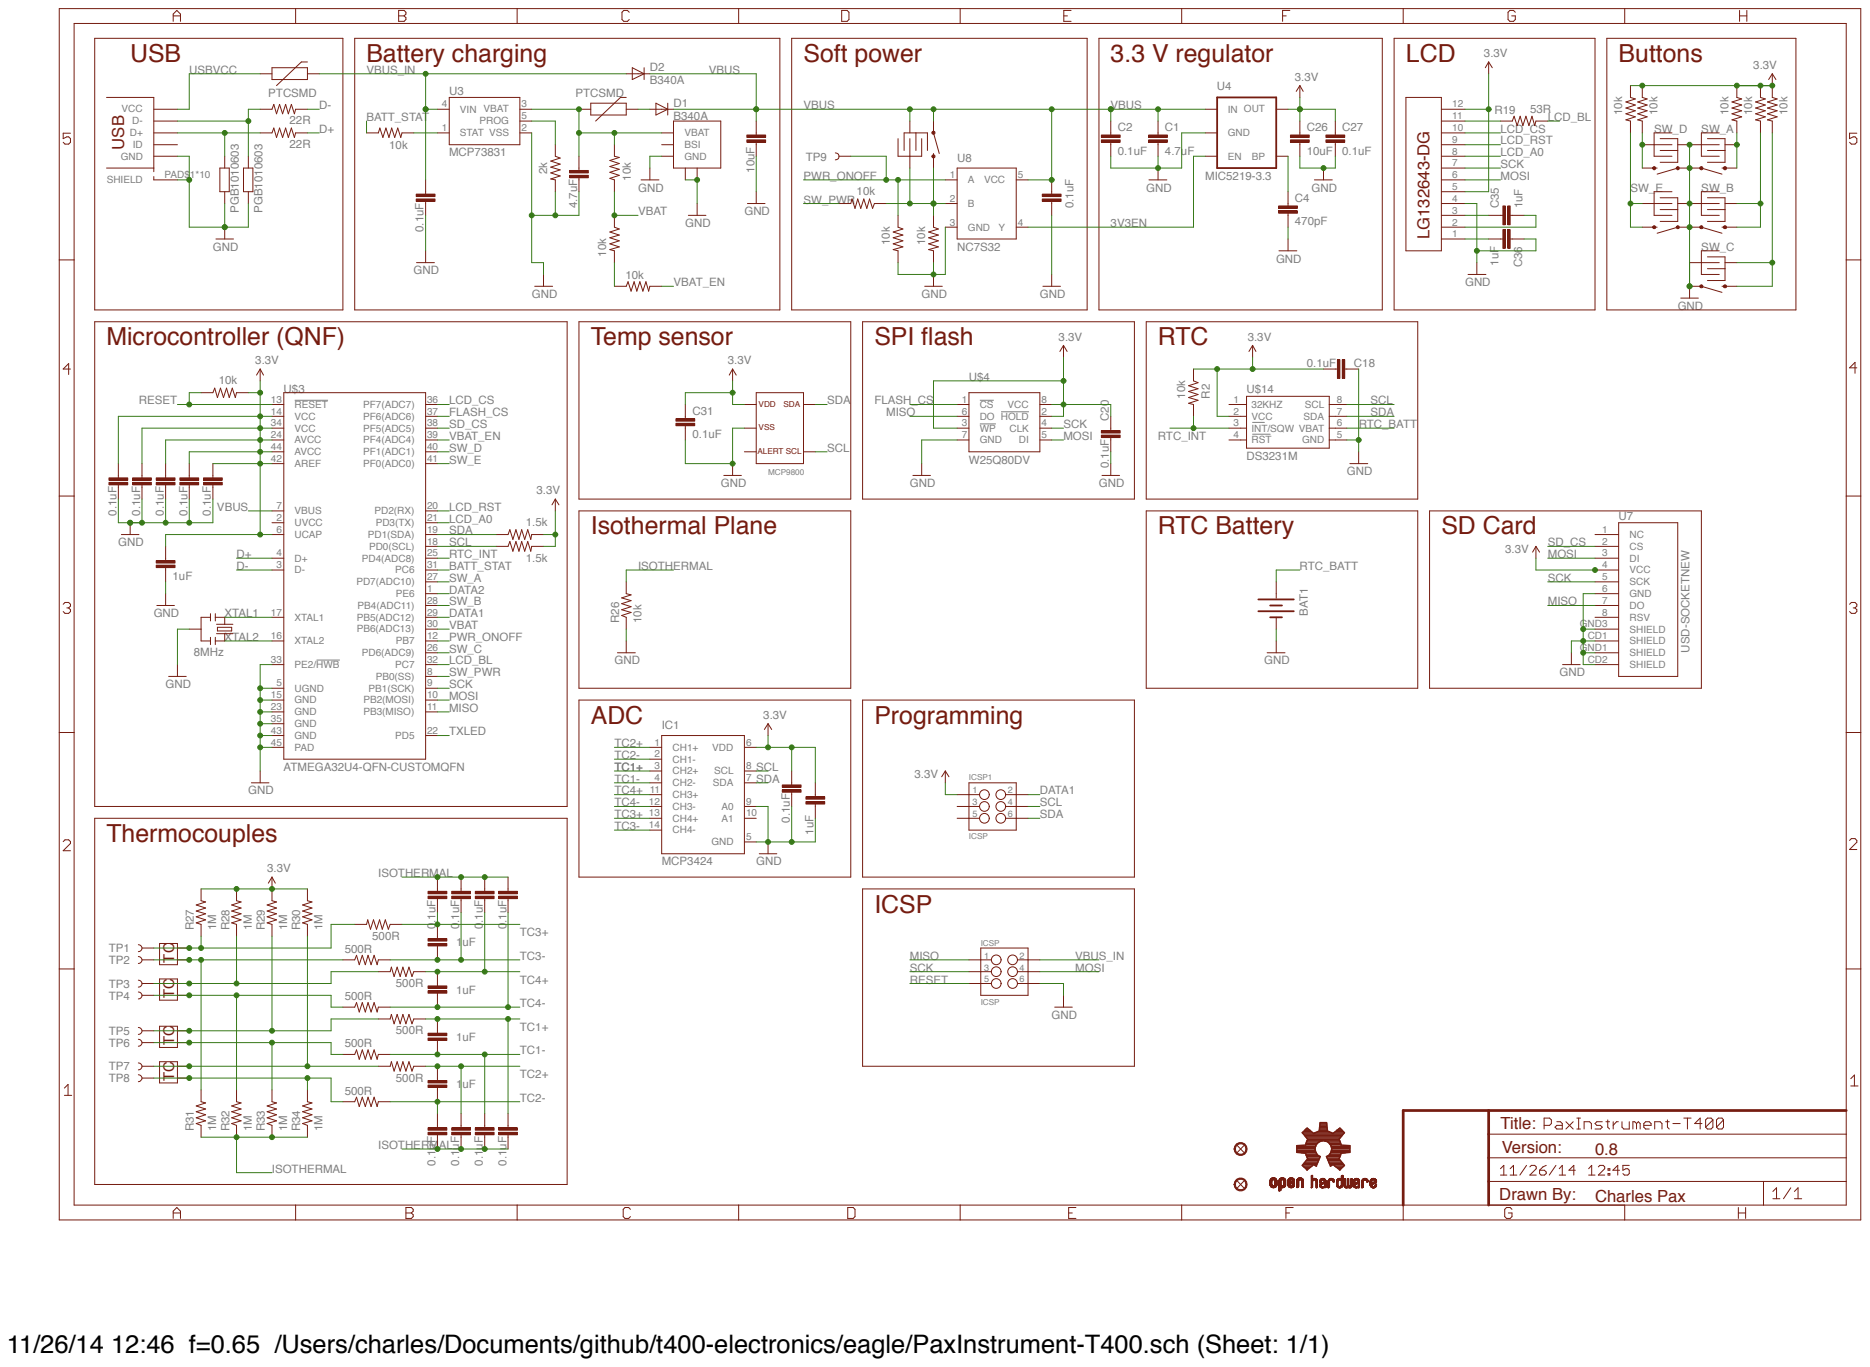
[picture p56: page 1]

11/26/14 12:46 f=0.65 /Users/charles/Documents/github/t400-electronics/eagle/PaxInstrument-T400.sch (Sheet: 1/1)
