PaxInstruments/t400-electronics/referenceDesigns/MicroPython-board-schematic.pdf

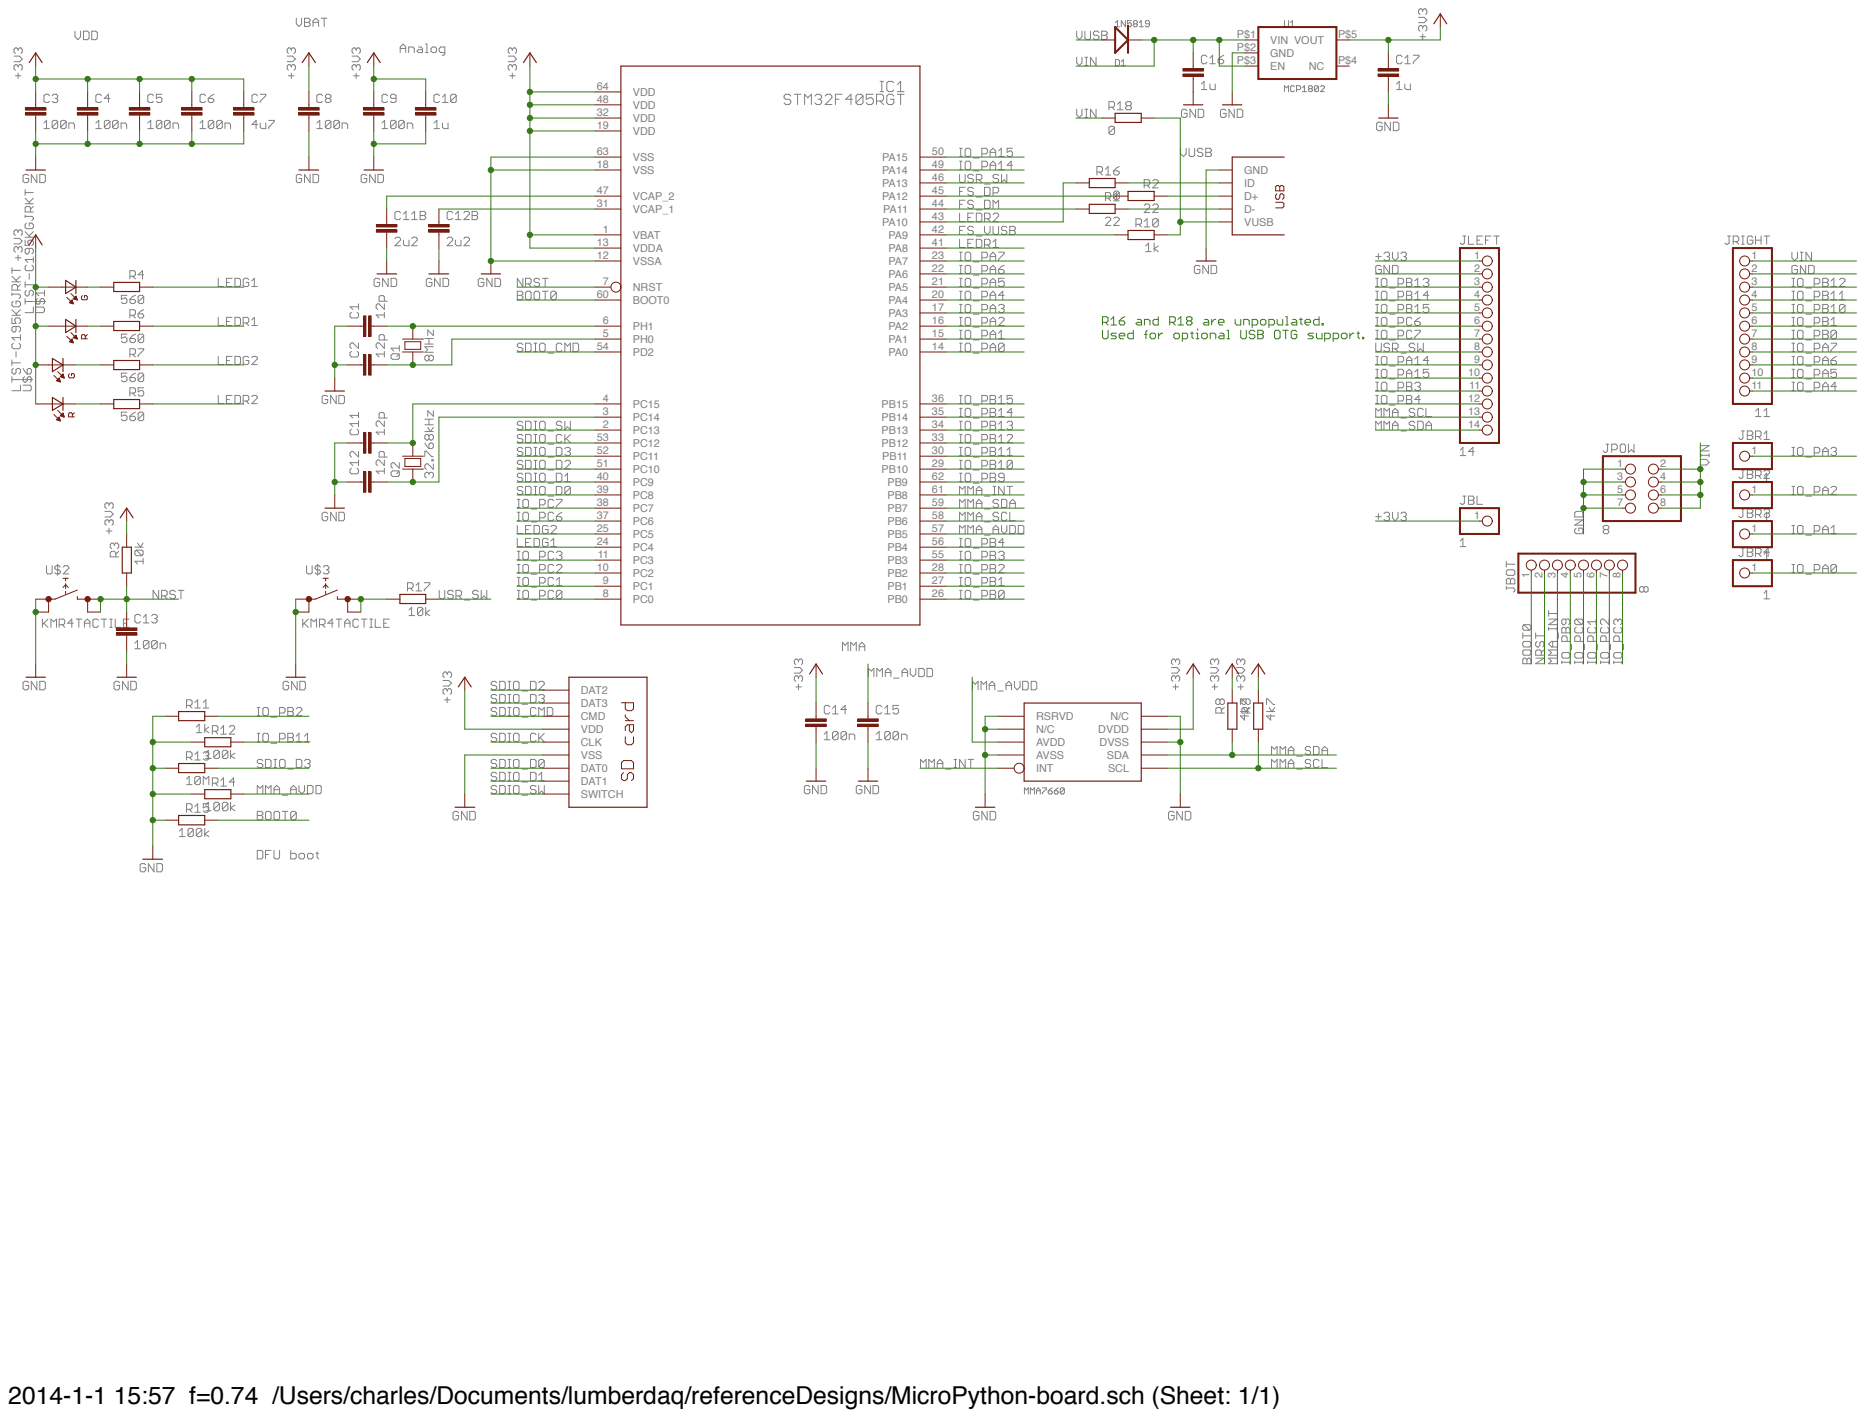
[picture p57: page 1]
VBAT 1; NRST 7; VSSA 12; VDDA 13; VSS 18; VDD 19; VCAP_1 31; VDD 32; VCAP_2 47; VDD 48; BOOT0 60; VSS 63; VDD 64; DAT2 DAT3 CMD VDD CLK VSS DAT0 DAT1 SWITCH; RSRVD N/C AVDD AVSS; INT; SCL; SDA; DVSS; DVDD; VIN P$1 GND P$2; VOUT; VUSB; GND

2014-1-1 15:57 f=0.74 /Users/charles/Documents/lumberdaq/referenceDesigns/MicroPython-board.sch (Sheet: 1/1)
