PaxInstruments/t400-electronics/referenceDesigns/PaxInstruments-T400-0.1.pdf

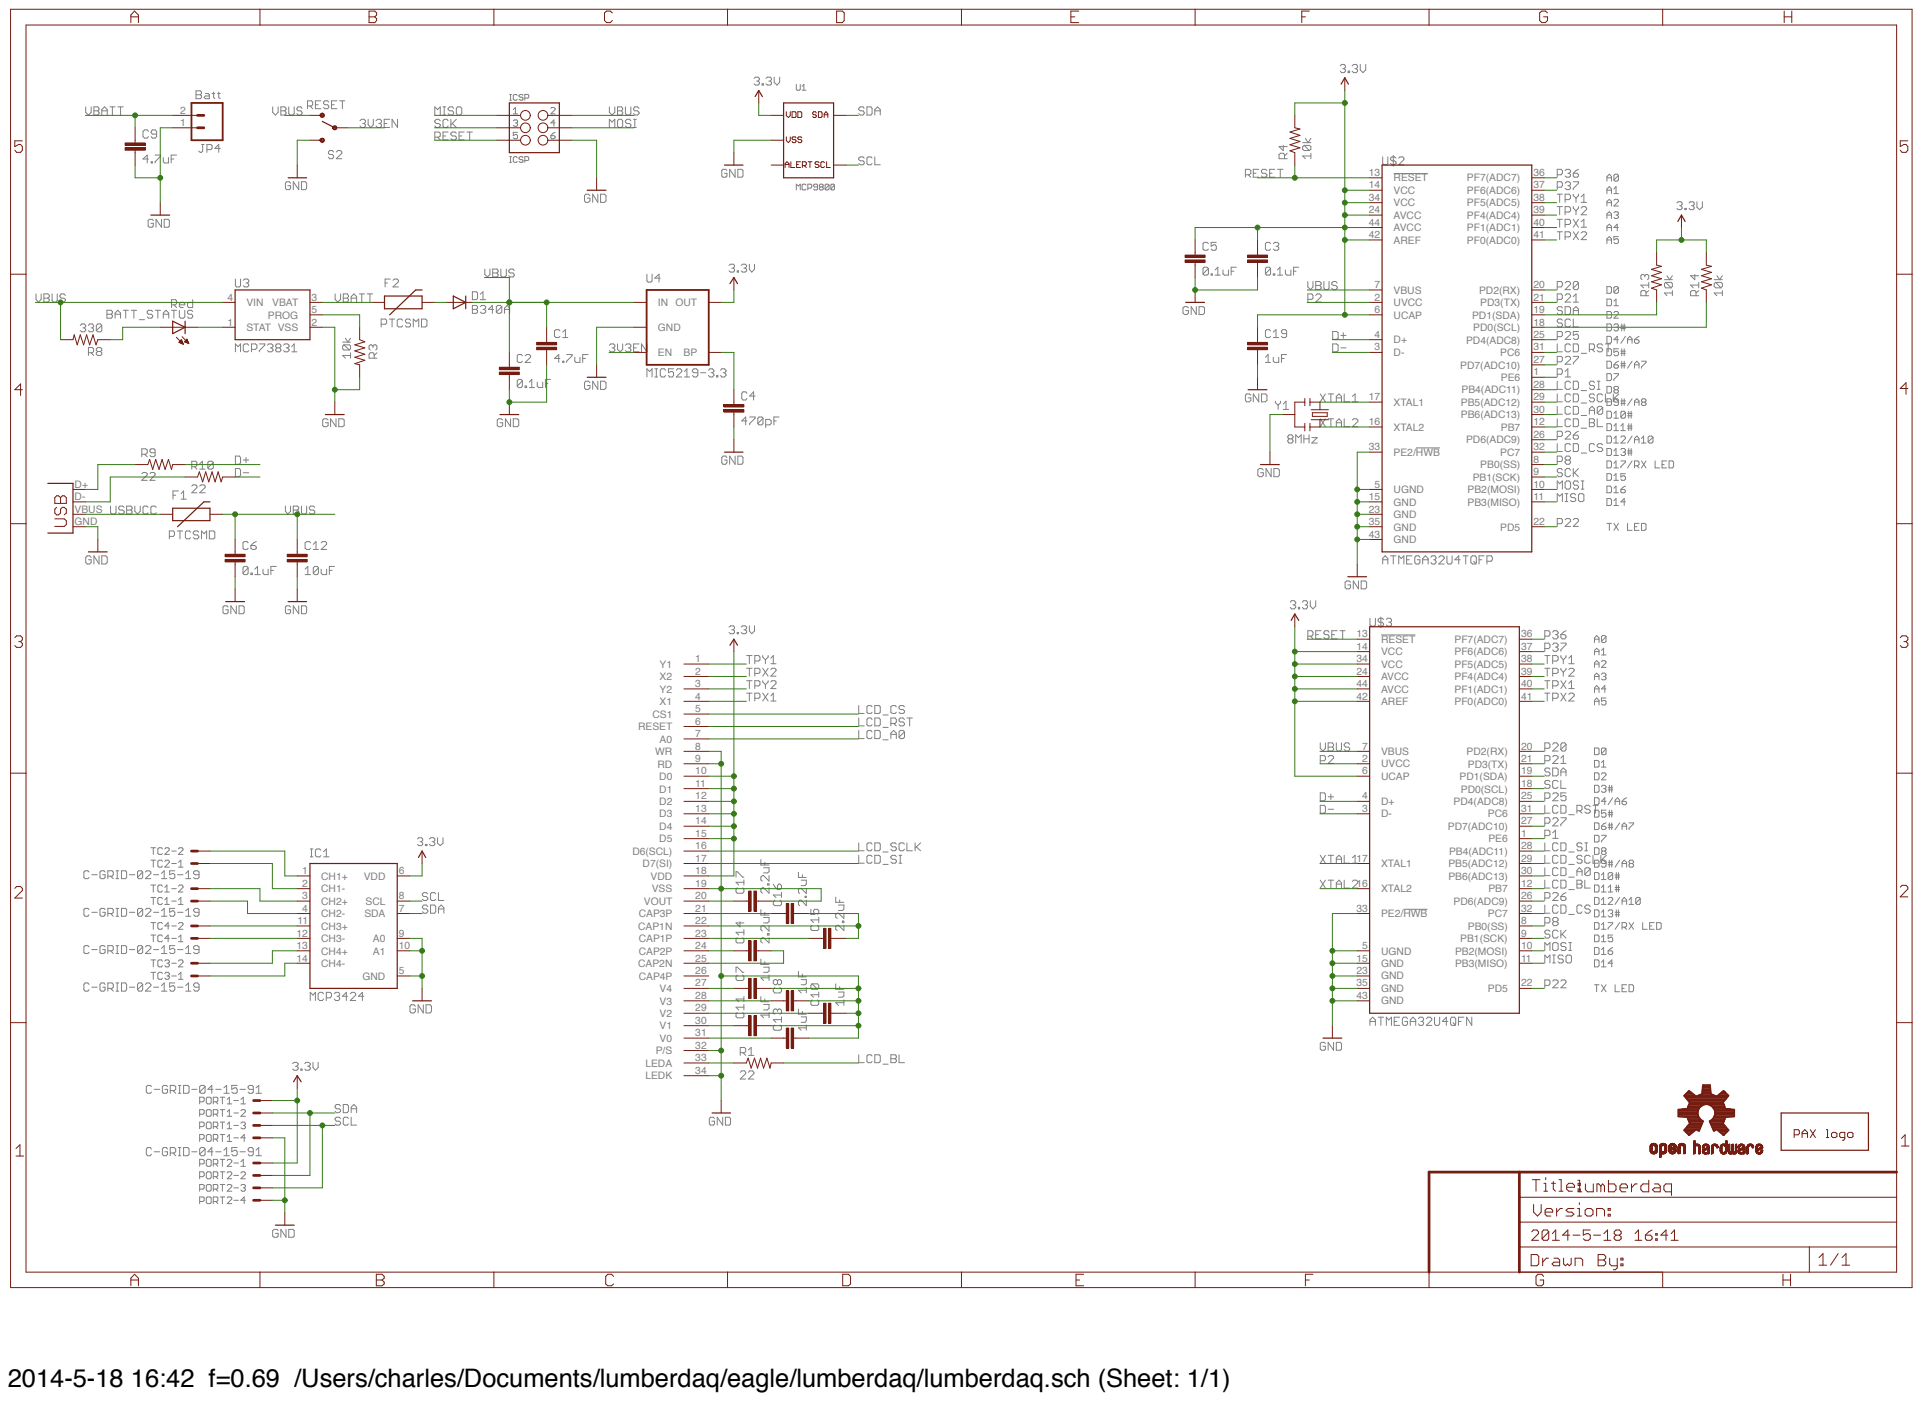
[picture p58: page 1]
GND; OUT; VIN 4; STAT 1; VBAT; PROG; VSS; D+ D- VBUS GND; RESET 13; AREF 42; AVCC 24 AVCC 44; GND 15 GND 23 GND 35 GND 43; PB1(SCK); PB2(MOSI); PB3(MISO); PB4(ADC11); PB5(ADC12); PB6(ADC13); PD0(SCL); 18 PD1(SDA); PD4(ADC8); PD6(ADC9); PD7(ADC10); PE2/HWB 33; PF0(ADC0); 41 PF1(ADC1); 40 PF4(ADC4); 39 PF5(ADC5); 38 PF6(ADC6); 37 PF7(ADC7); UCAP 6; UGND 5; UVCC 2; VBUS 7; VCC 14 VCC 34; XTAL1 17; XTAL2 16; RESET; D6(SCL); VDD; VOUT; CAP3P; CAP1N; CAP1P; CAP2P; CAP2N; CAP4P; LEDA; LEDK; SDA; SCL

2014-5-18 16:42 f=0.69 /Users/charles/Documents/lumberdaq/eagle/lumberdaq/lumberdaq.sch (Sheet: 1/1)
