PaxInstruments/t400-electronics/referenceDesigns/Sparkfun-PowerCell.pdf

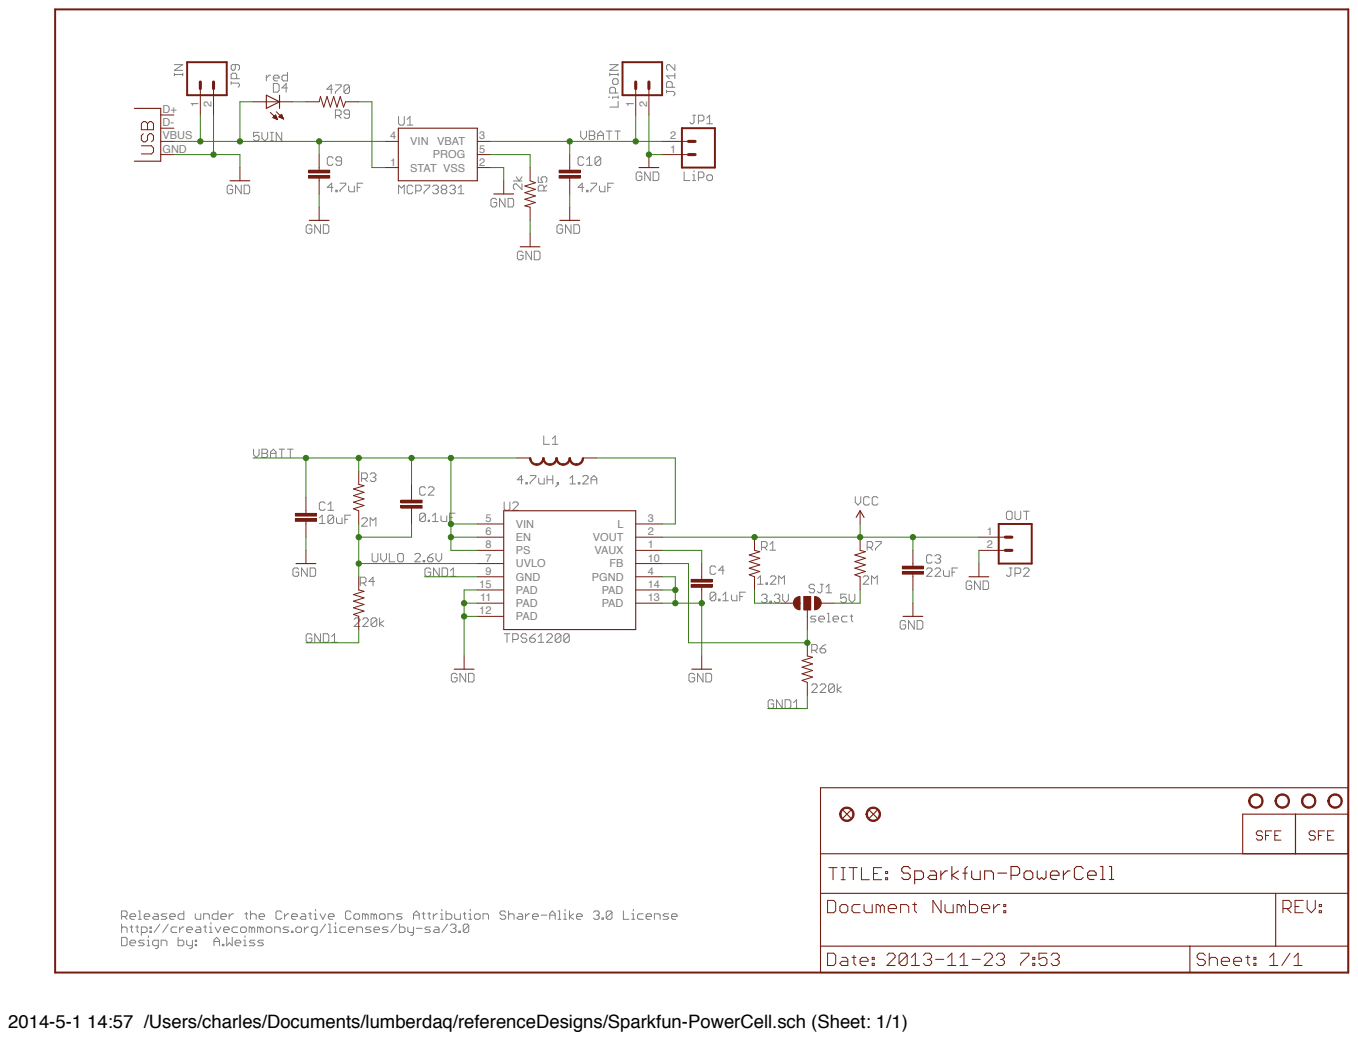
[picture p60: page 1]
VIN 4; STAT 1; VBAT; PROG; VSS; D+ D- VBUS GND; GND 9; PAD 15 PAD 11; PAD 12; PAD; 13 PAD; 14 PGND; UVLO 7; VAUX; VIN 5; VOUT

2014-5-1 14:57 /Users/charles/Documents/lumberdaq/referenceDesigns/Sparkfun-PowerCell.sch (Sheet: 1/1)
