PaxInstruments/t400-electronics/referenceDesigns/Sparkfun-Weather Shield.pdf

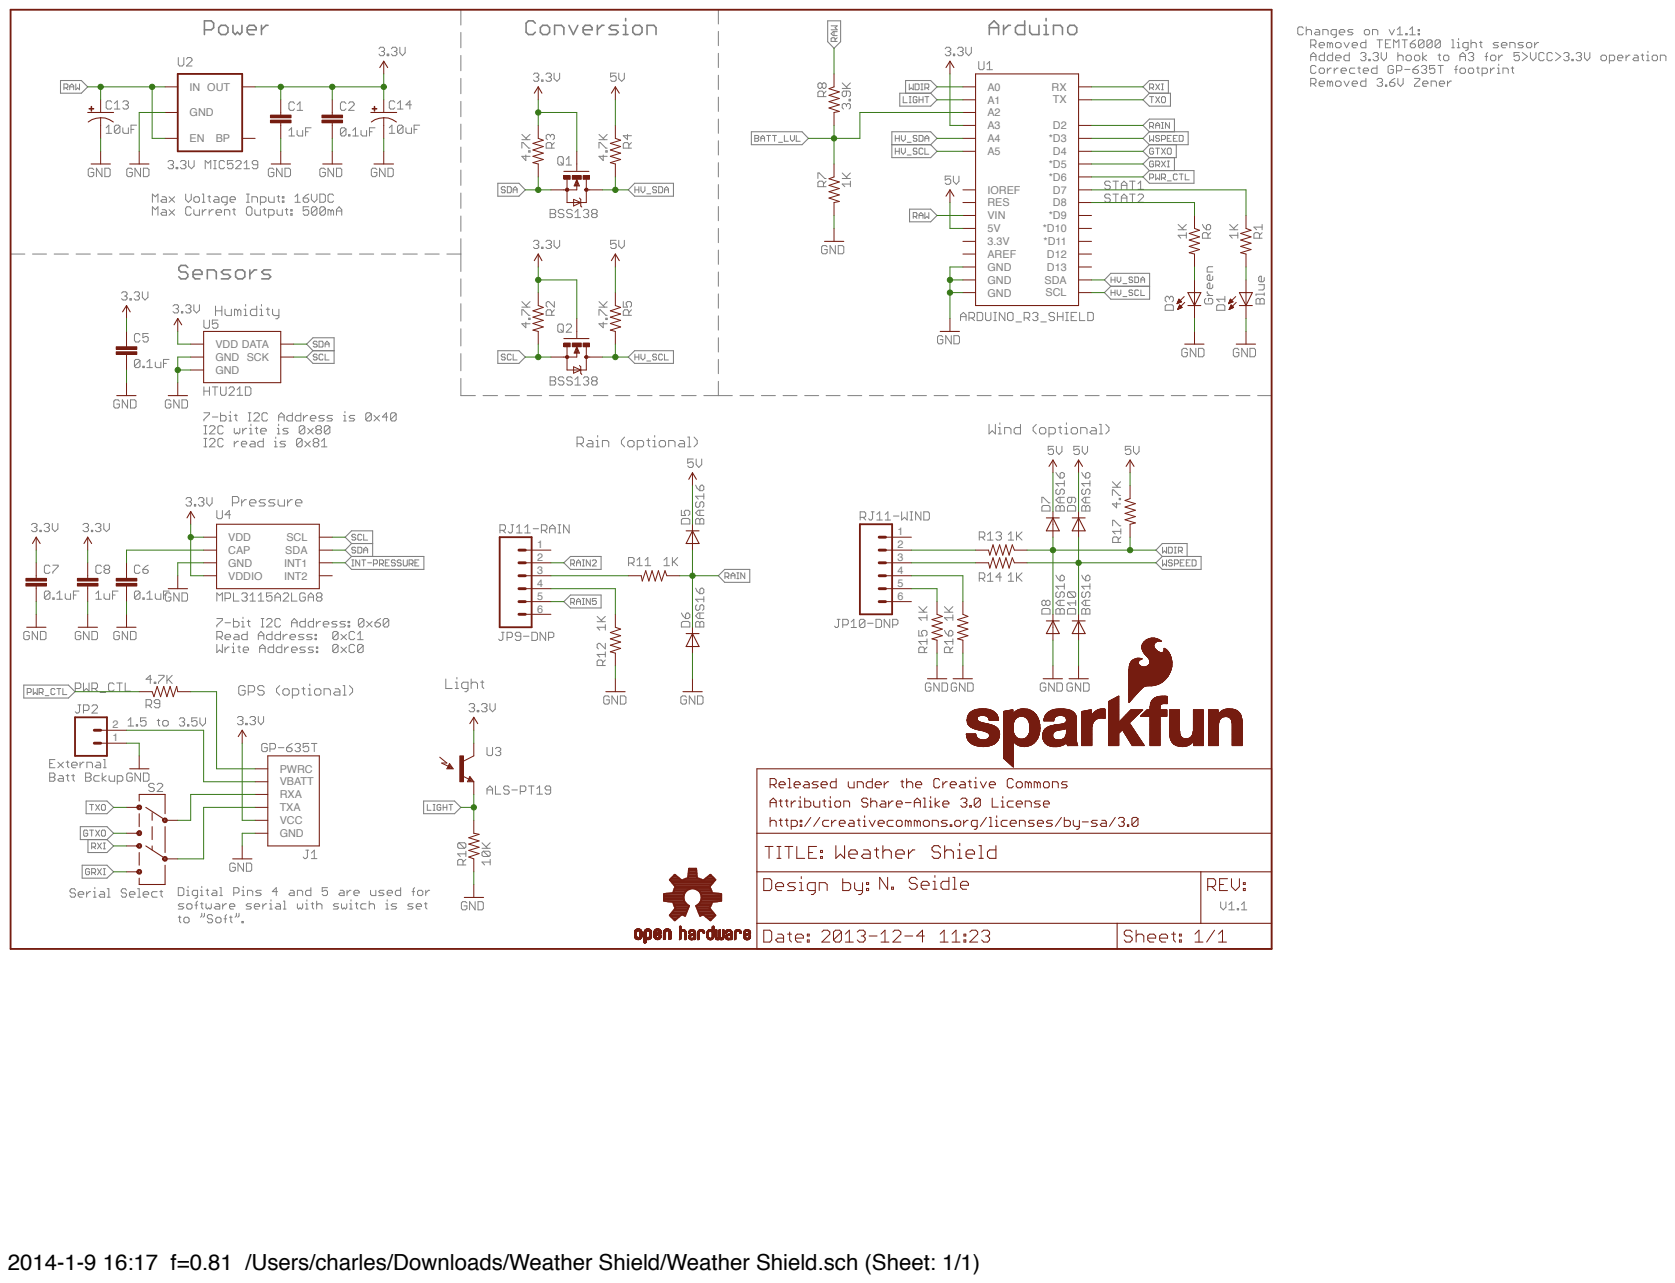
[picture p61: page 1]
GND; OUT; VDD CAP GND VDDIO; SCL SDA INT1 INT2; SCK; DATA; VDD; VIN; RES; AREF GND GND GND; IOREF; SDA SCL; VCC; TXA; RXA; VBATT; PWRC

2014-1-9 16:17 f=0.81 /Users/charles/Downloads/Weather Shield/Weather Shield.sch (Sheet: 1/1)
