PaxInstruments/t400-electronics/referenceDesigns/Arduino-lilypad-USB-schematic.pdf

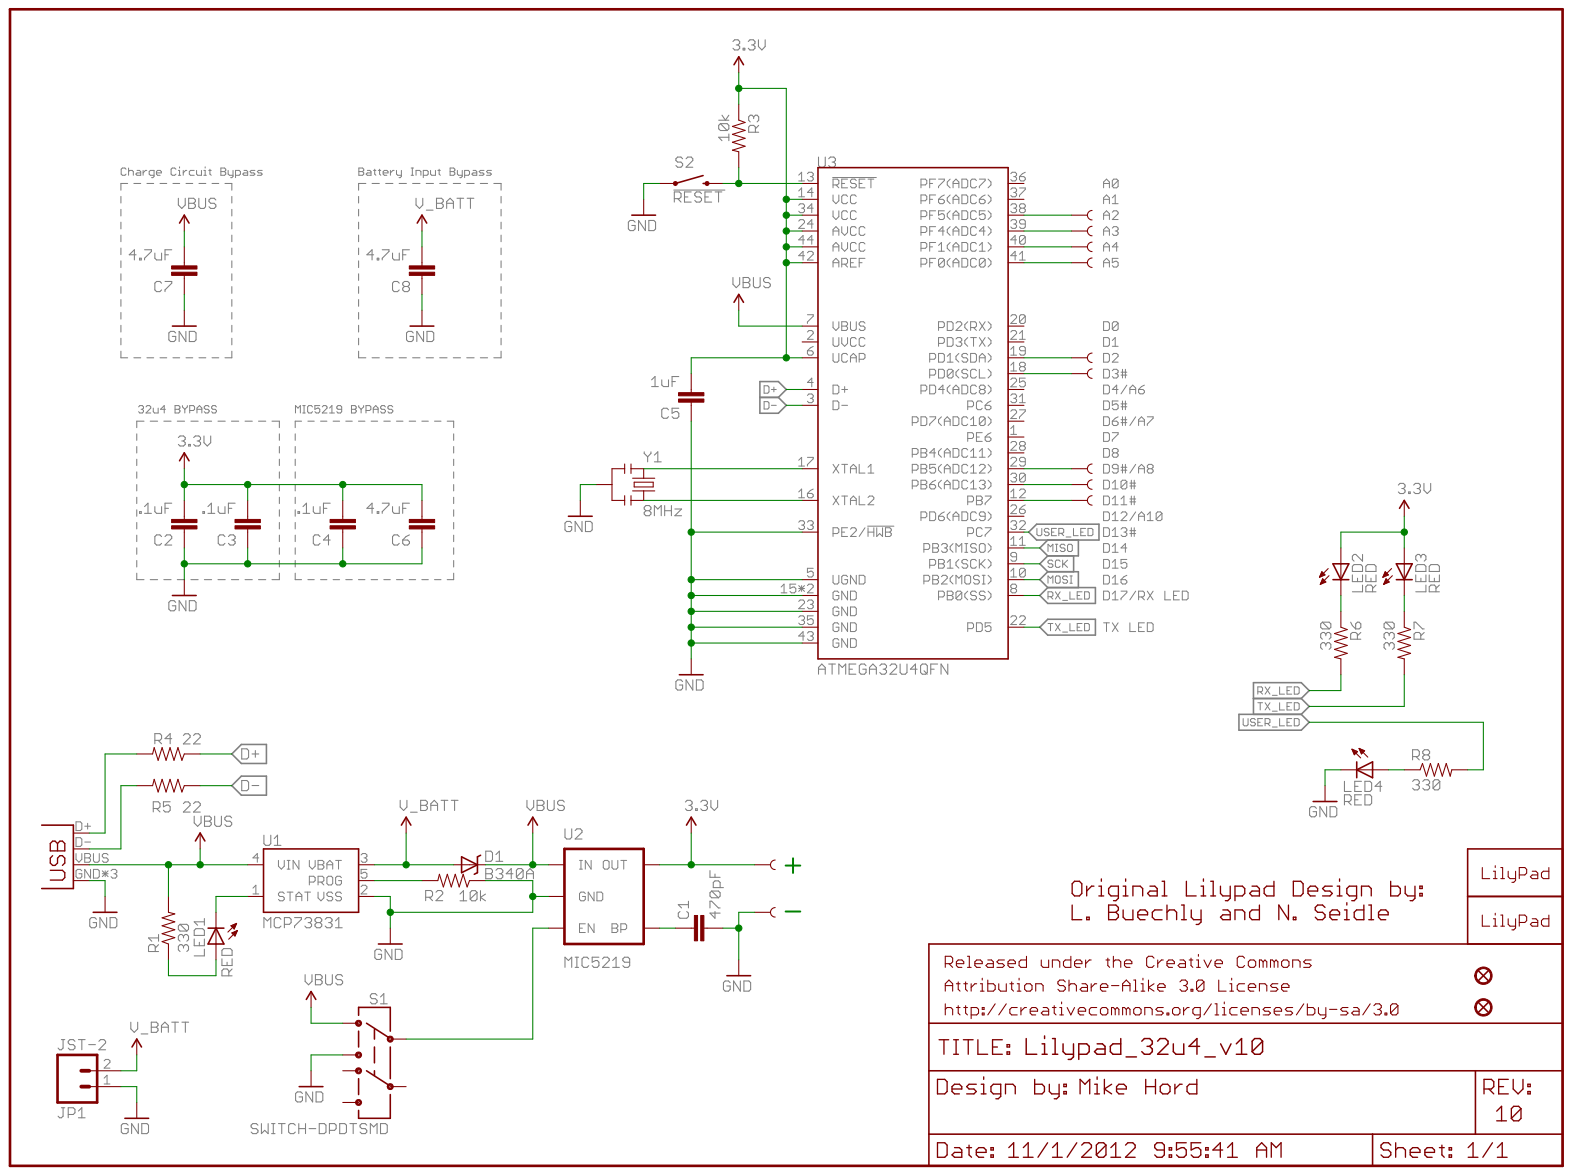
[picture p62: page 1]
