PaxInstruments/t400-electronics/referenceDesigns/JeeLabs-analog-plug-schematic.pdf

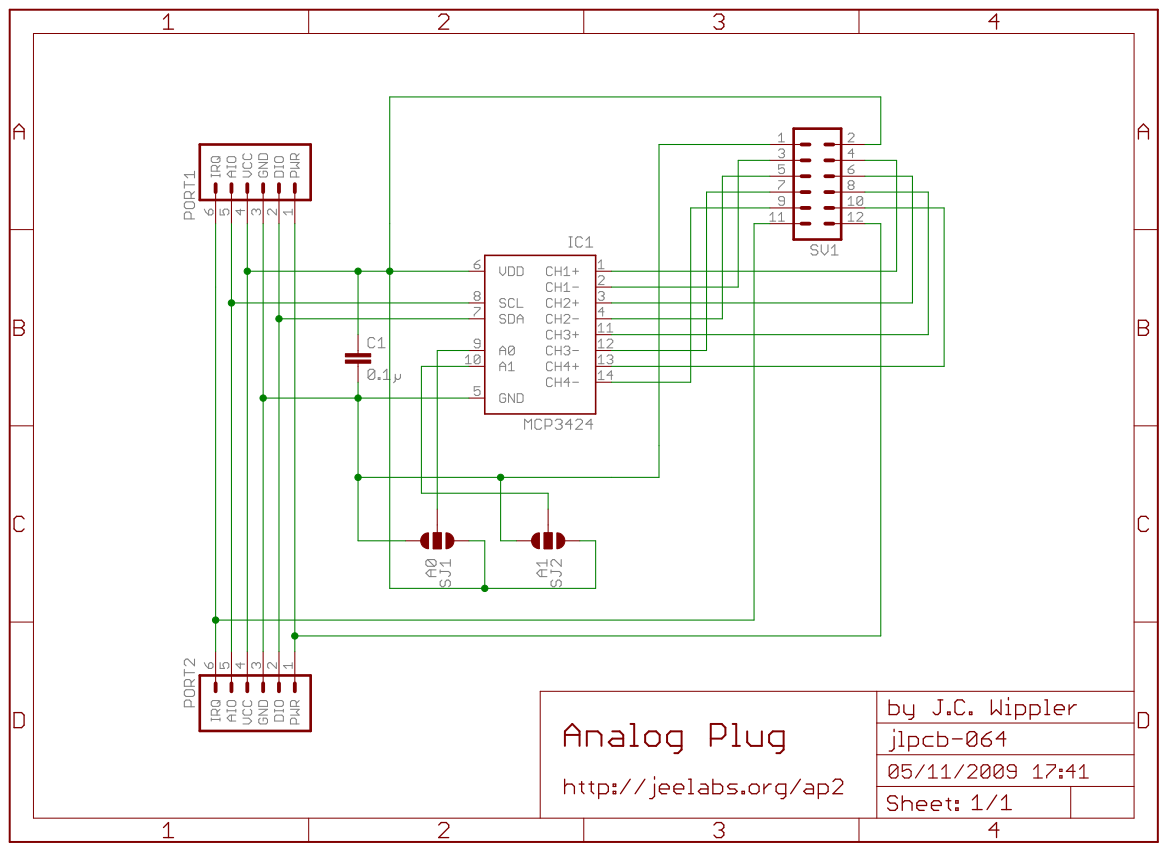
[picture p63: page 1]
