PaxInstruments/t400-electronics/referenceDesigns/JeeLabs-jeenode-USB-schematic.pdf

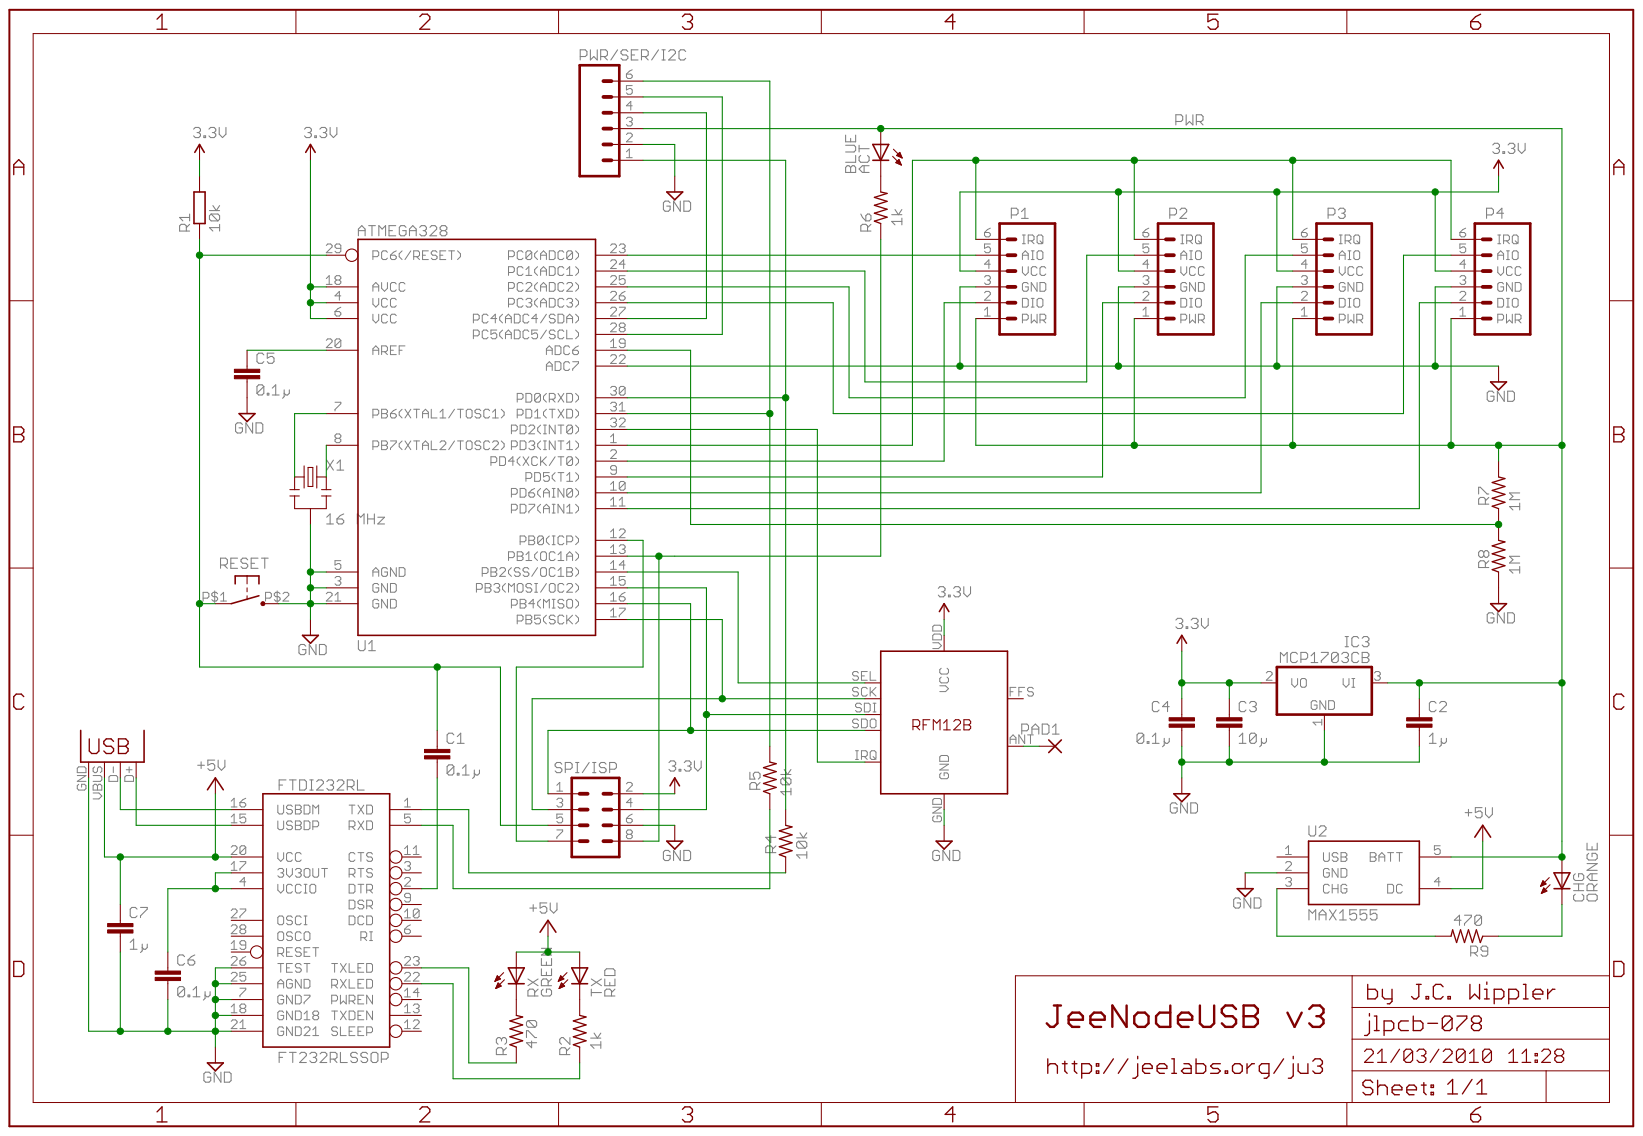
[picture p64: page 1]
