PaxInstruments/t400-electronics/referenceDesigns/JeeLabs-precision-RTC-schematic.pdf

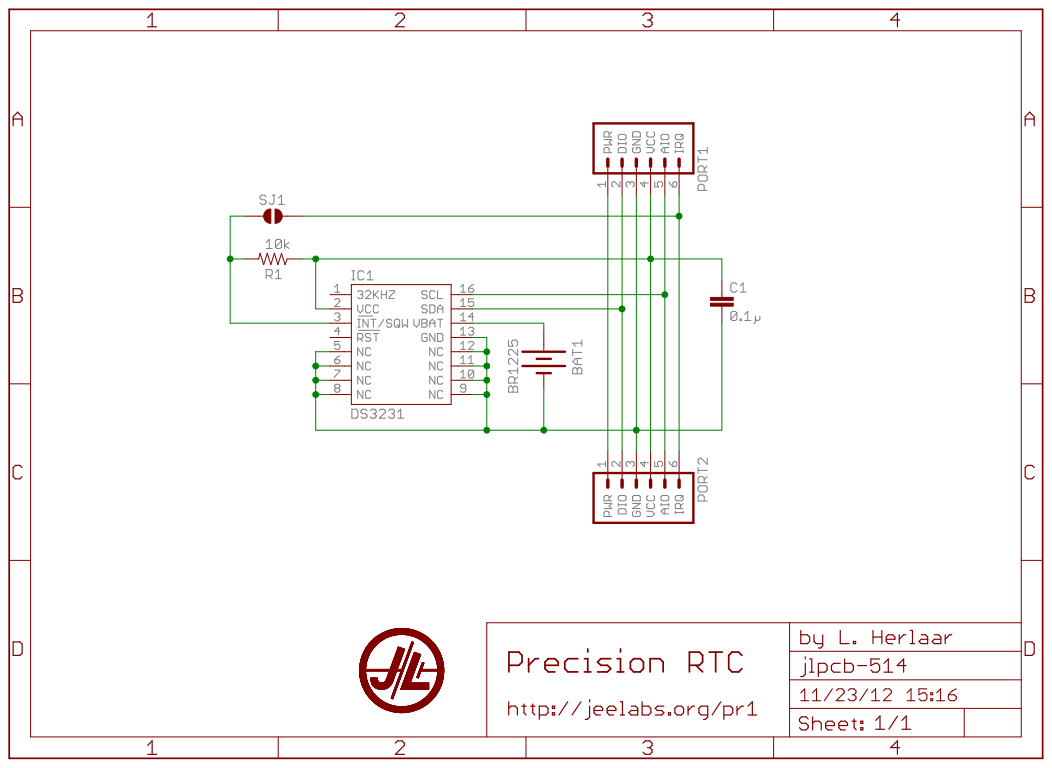
[picture p65: page 1]
