PaxInstruments/t400-electronics/referenceDesigns/Seeeduino-stalker-schematic.pdf

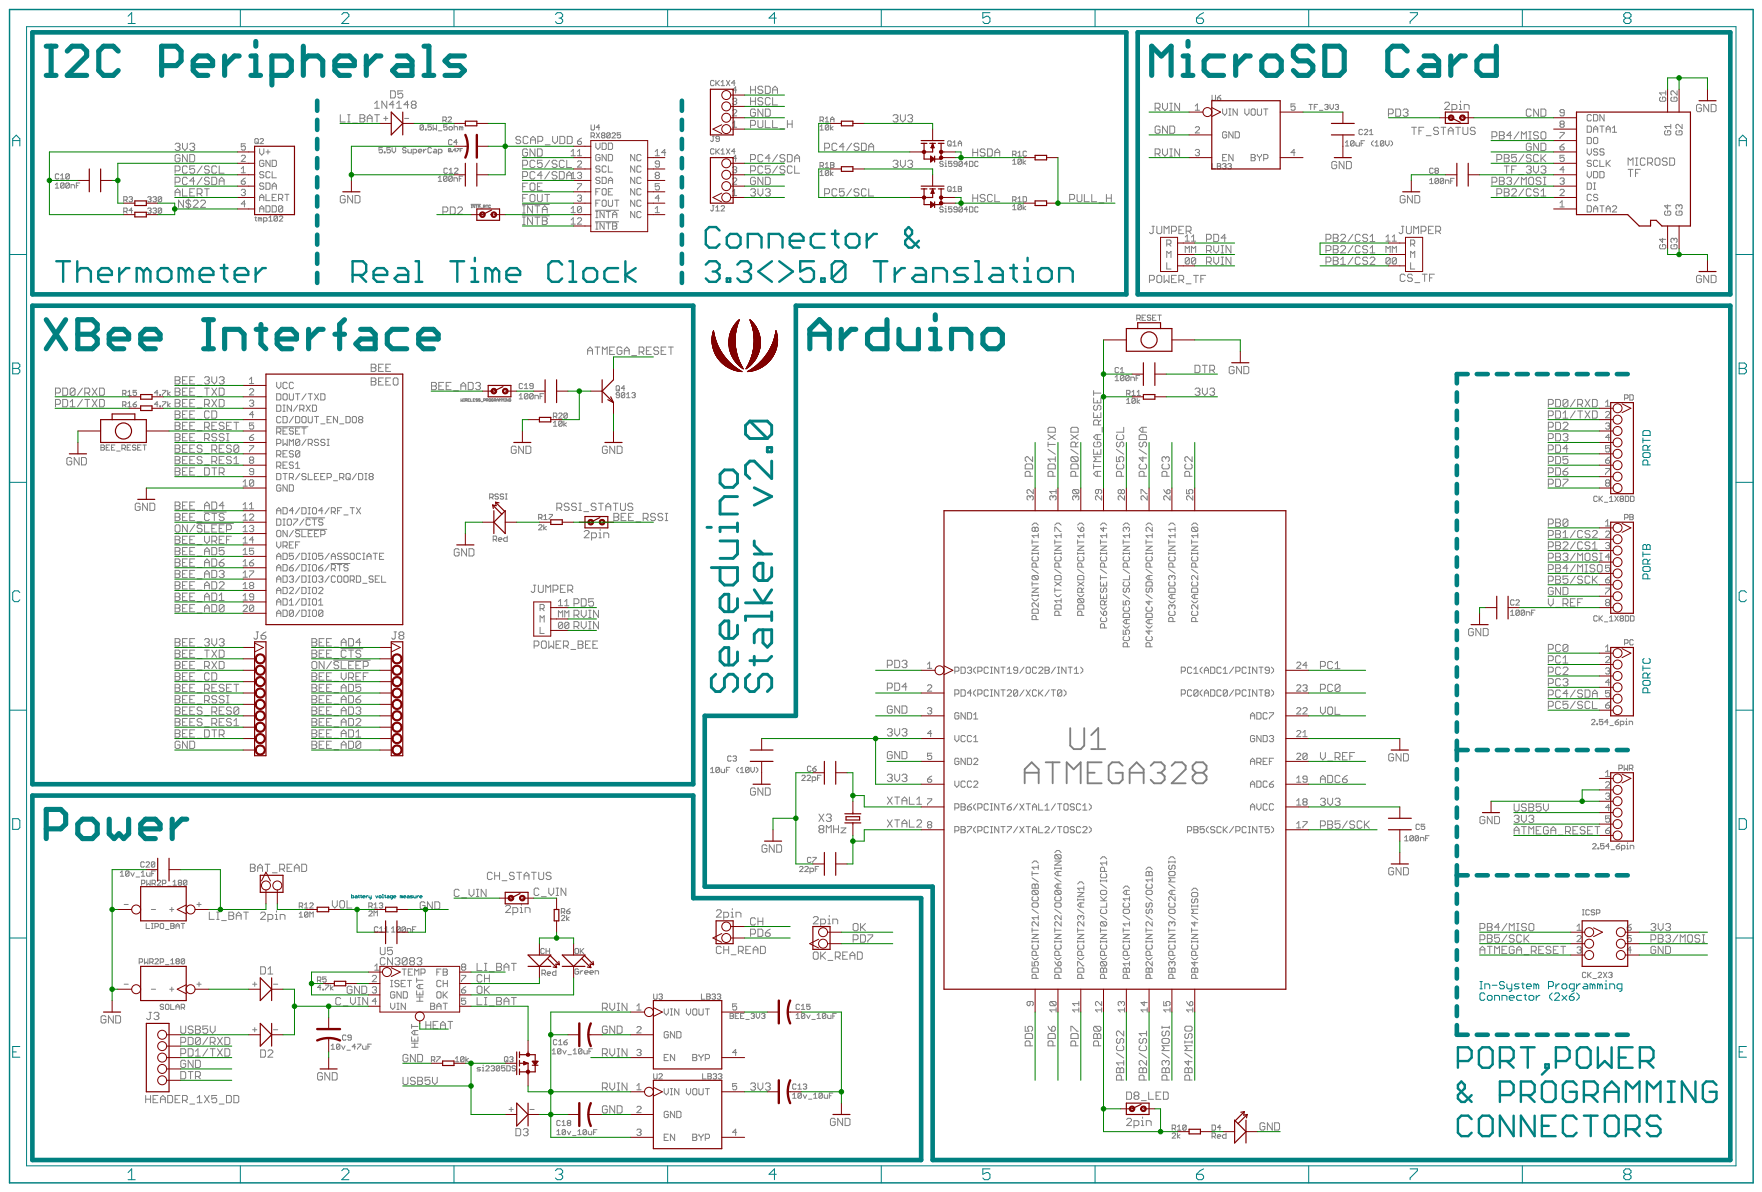
[picture p66: page 1]
