PaxInstruments/t400-electronics/referenceDesigns/Sparkfun-Buzzer-v15-schematic.pdf

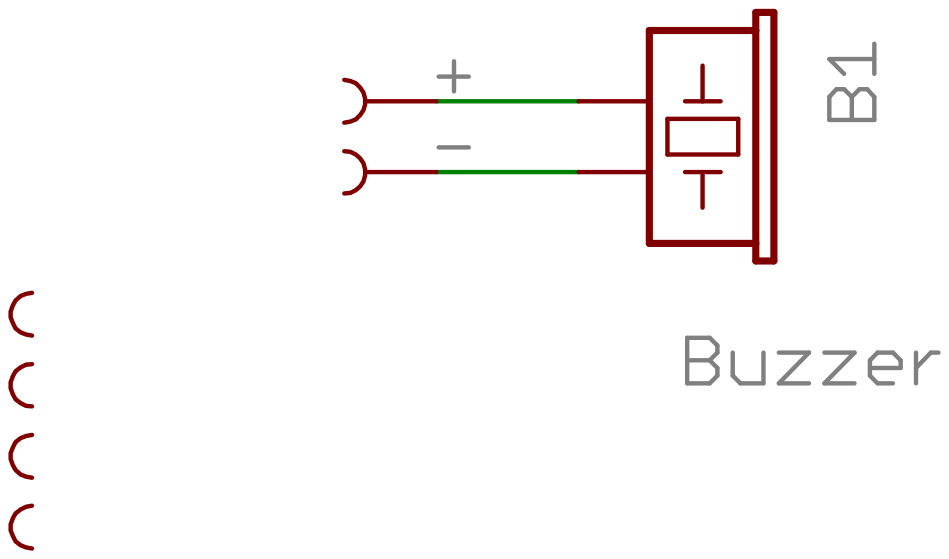
[picture p67: page 1]
