PaxInstruments/t400-electronics/referenceDesigns/Sparkfun-SD-breakout-schematic.pdf

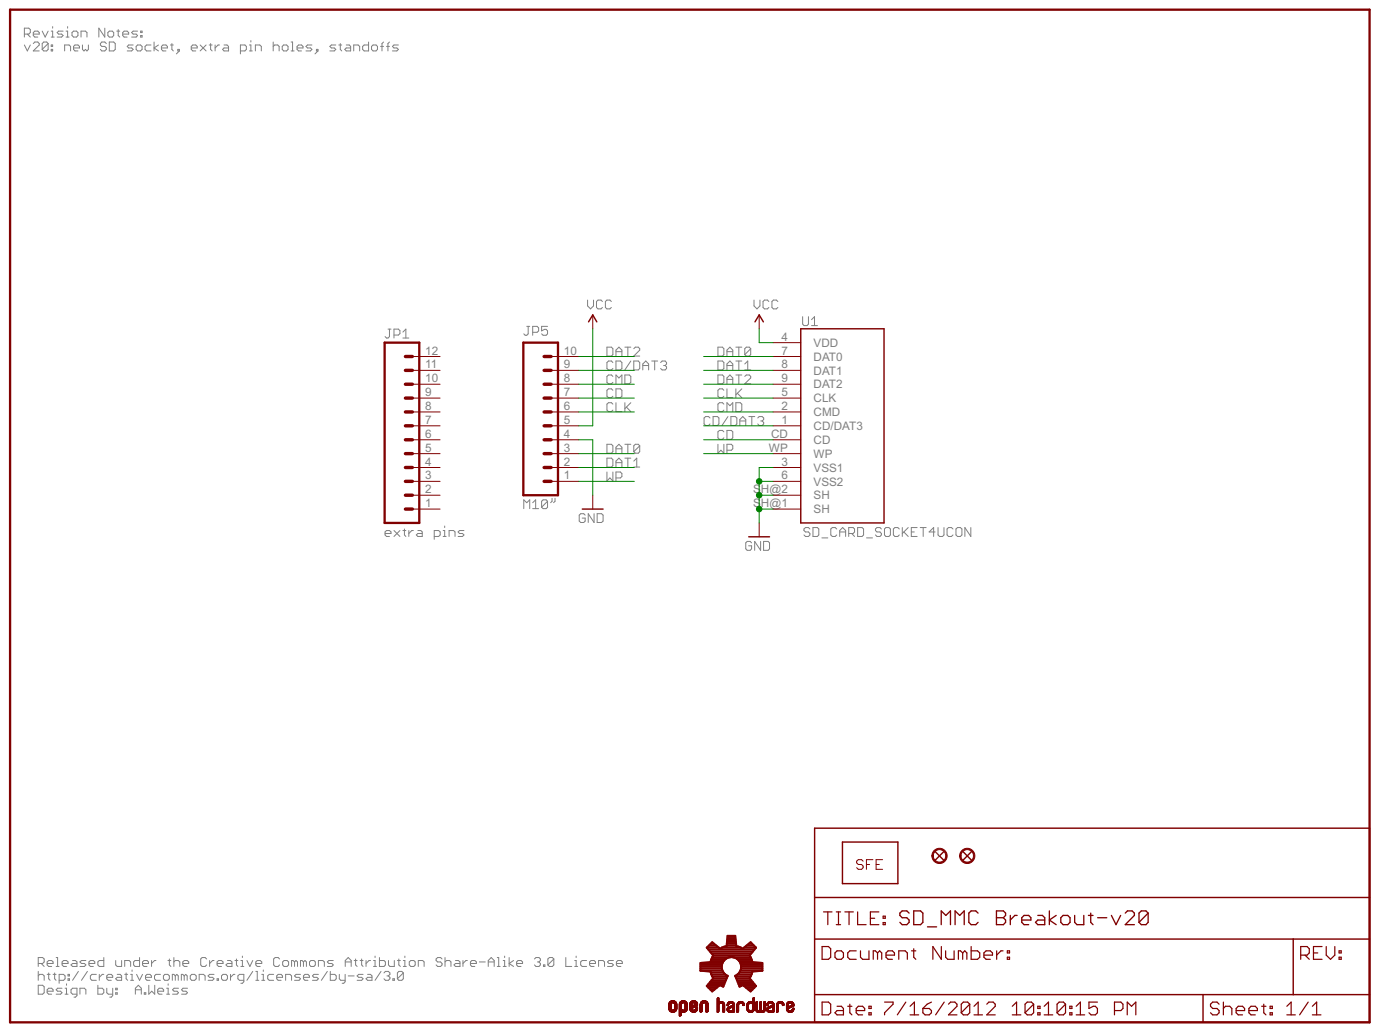
[picture p68: page 1]
