PaxInstruments/t400-electronics/solidworks/t400-thermo-clip2.PDF

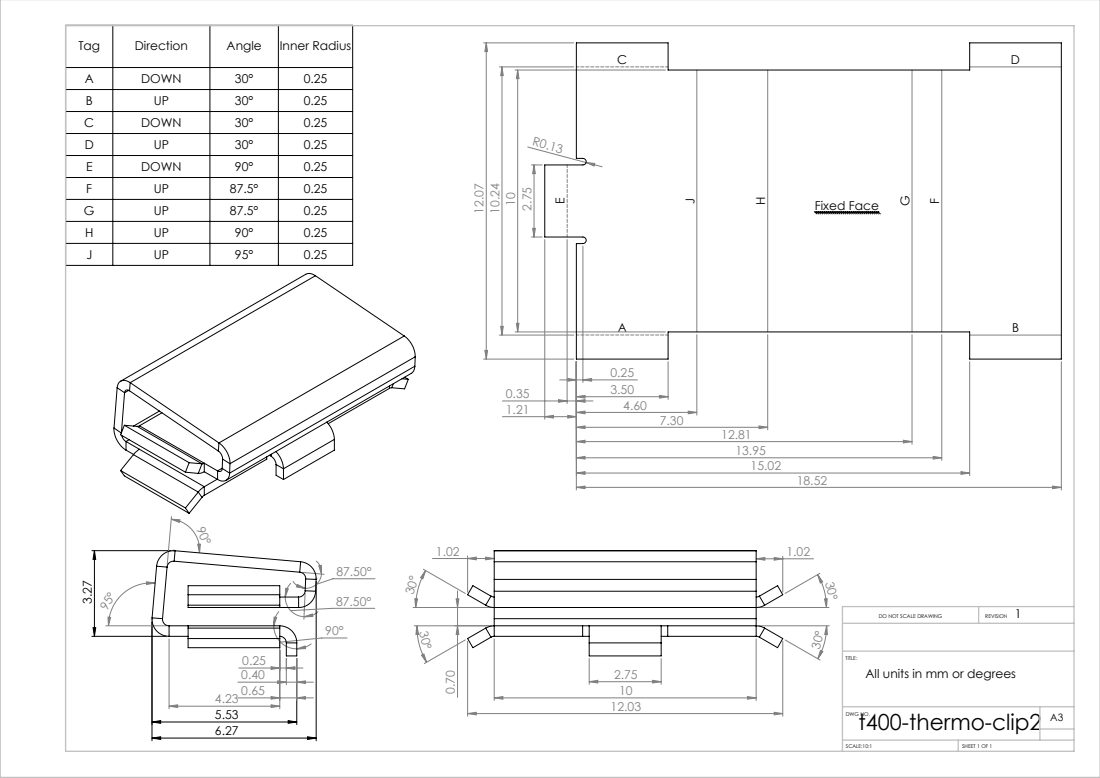
[picture p69: page 1]
Fixed Face; SCALE:10:1; SHEET 1 OF 1; DO NOT SCALE DRAWING; REVISION 1

Tag | Direction | Angle | Inner Radius

A | DOWN | 30° | 0.25
B | UP | 30° | 0.25
C | DOWN | 30° | 0.25
D | UP | 30° | 0.25
E | DOWN | 90° | 0.25
F | UP | 87.5° | 0.25
G | UP | 87.5° | 0.25
H | UP | 90° | 0.25
J | UP | 95° | 0.25

TITLE:
All units in mm or degrees
t400-thermo-clip2 A3
DWG NO.
