PaxInstruments/t400-electronics/eagle/T400 Rev 0.14/PaxInstrument-T400.pdf

S4 | S3

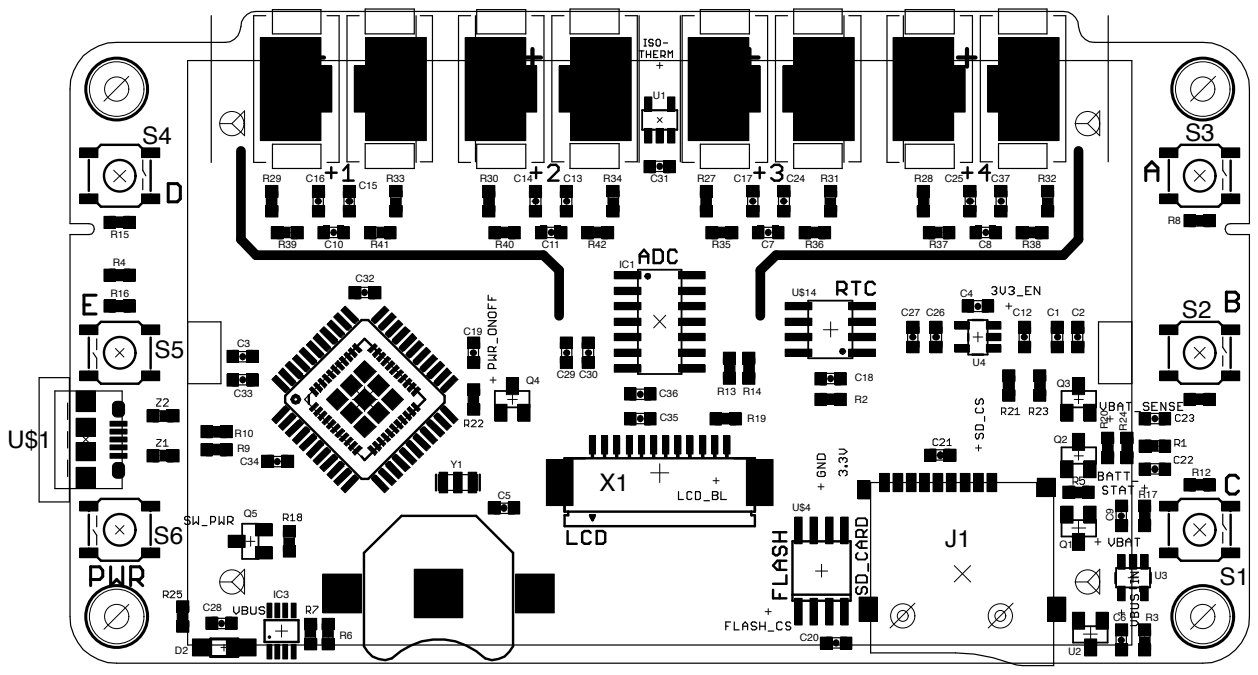
[picture p70: page 1]
