PaxInstruments/t400-electronics/eagle/T400 Rev 0.13/PaxInstrument-T400 schematic.pdf

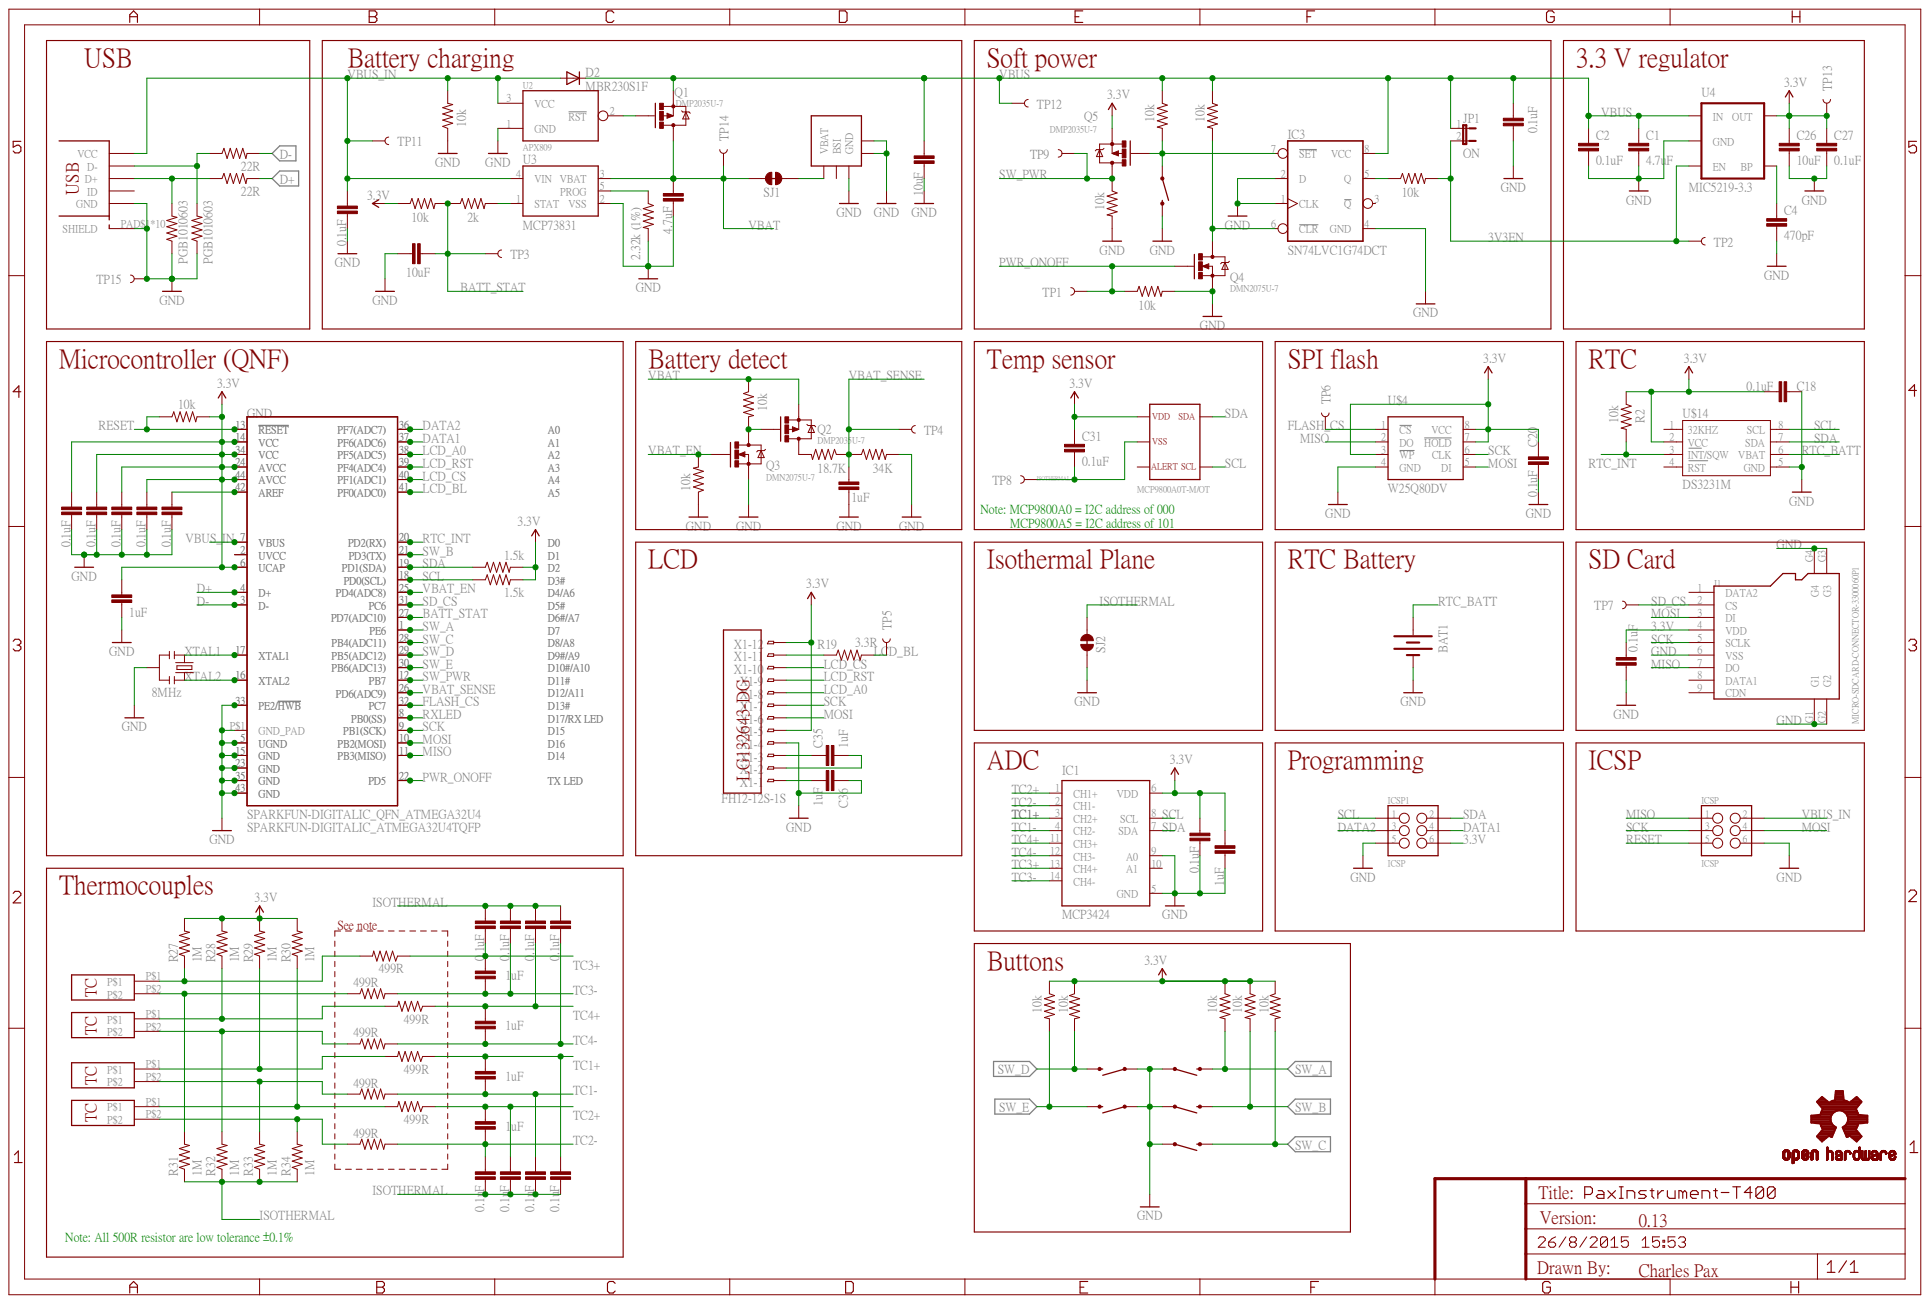
[picture p71: page 1]

Note: MCP9800A0 = I2C address of 000 MCP9800A5 = I2C address of 101
Isothermal Plane

Drawn By: Title: Version:

Note: All 500R resistor are low tolerance ±0.1%
