PaxInstruments/t400-electronics/solidworks/old/tc-connector-2.PDF

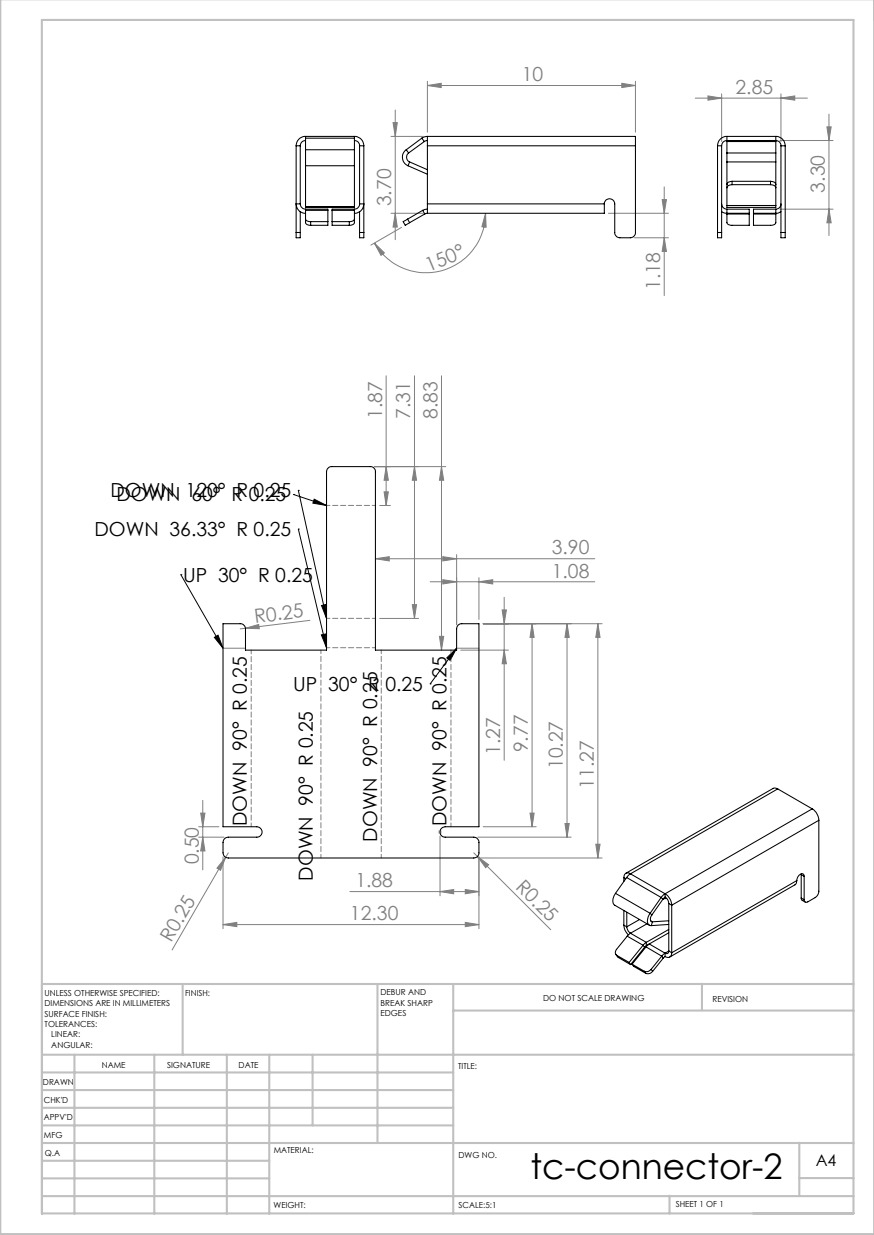
[picture p72: page 1]
DOWN 120° R 0.25 DOWN 60° R 0.25 DOWN 36.33° R 0.25; DOWN 90° R 0.25; SCALE:5:1; SHEET 1 OF 1; DO NOT SCALE DRAWING; REVISION; DEBUR AND BREAK SHARP; UNLESS OTHERWISE SPECIFIED:; FINISH:

DIMENSIONS ARE IN MILLIMETERS
SURFACE FINISH:
TOLERANCES:
LINEAR:
ANGULAR:

NAME | SIGNATURE | DATE | | | | TITLE:
Q.A | | | | MATERIAL: | tc-connector-2 WEIGHT: DWG NO. | A4

DRAWN
CHK'D
APPV'D
MFG
