PaxInstruments/t400-electronics/solidworks/old/clip/Clip-05-drawing.pdf

1 | 4
6

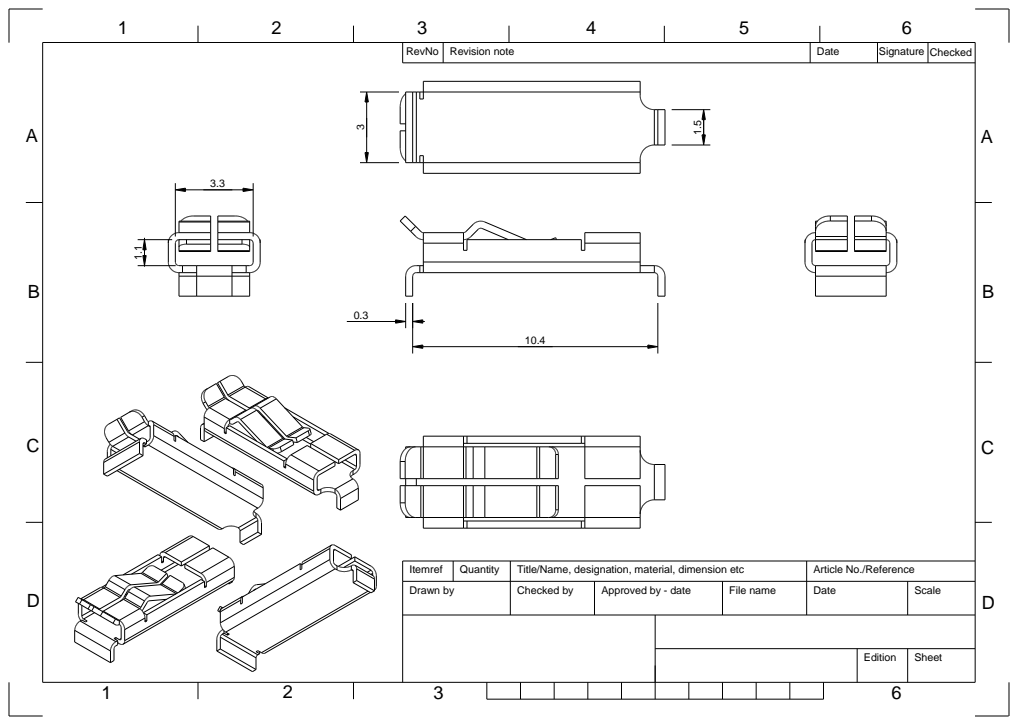
[picture p73: page 1]
RevNo; Itemref; Scale; Revision note; Checked; Sheet; Quantity; Edition; Date; Drawn by; Signature; File name

Title/Name, designation, material, dimension etc
Checked by

Article No./Reference
Date

Approved by - date
