PaxInstruments/t400-electronics/eagle/T400 Rev 0.13/PaxInstrument-T400 Component position.pdf

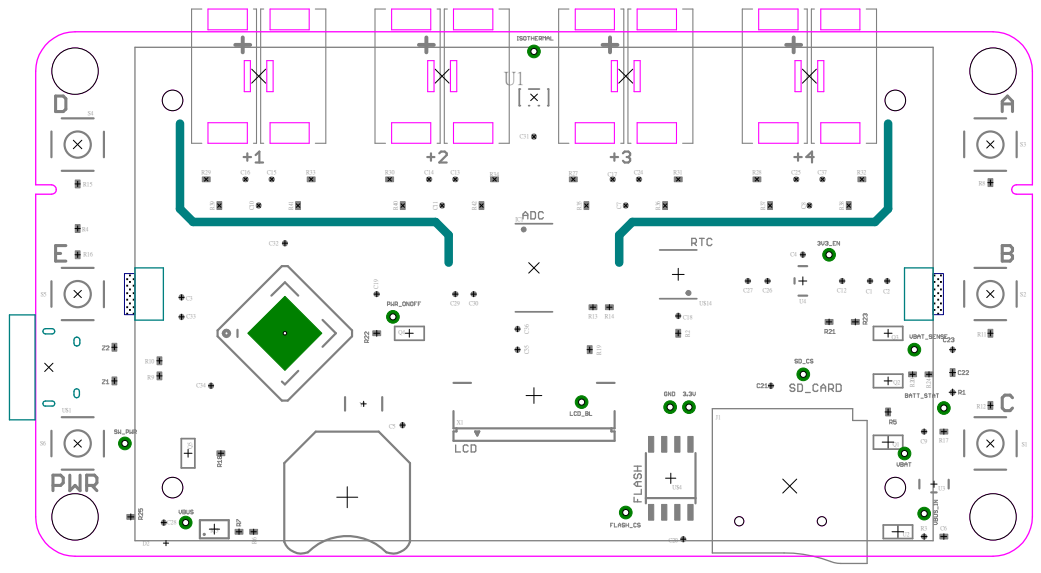
[picture p74: page 1]
