PaxInstruments/t400-electronics/eagle/T400 Rev 0.11/PaxInstrument-T400 Component position.pdf

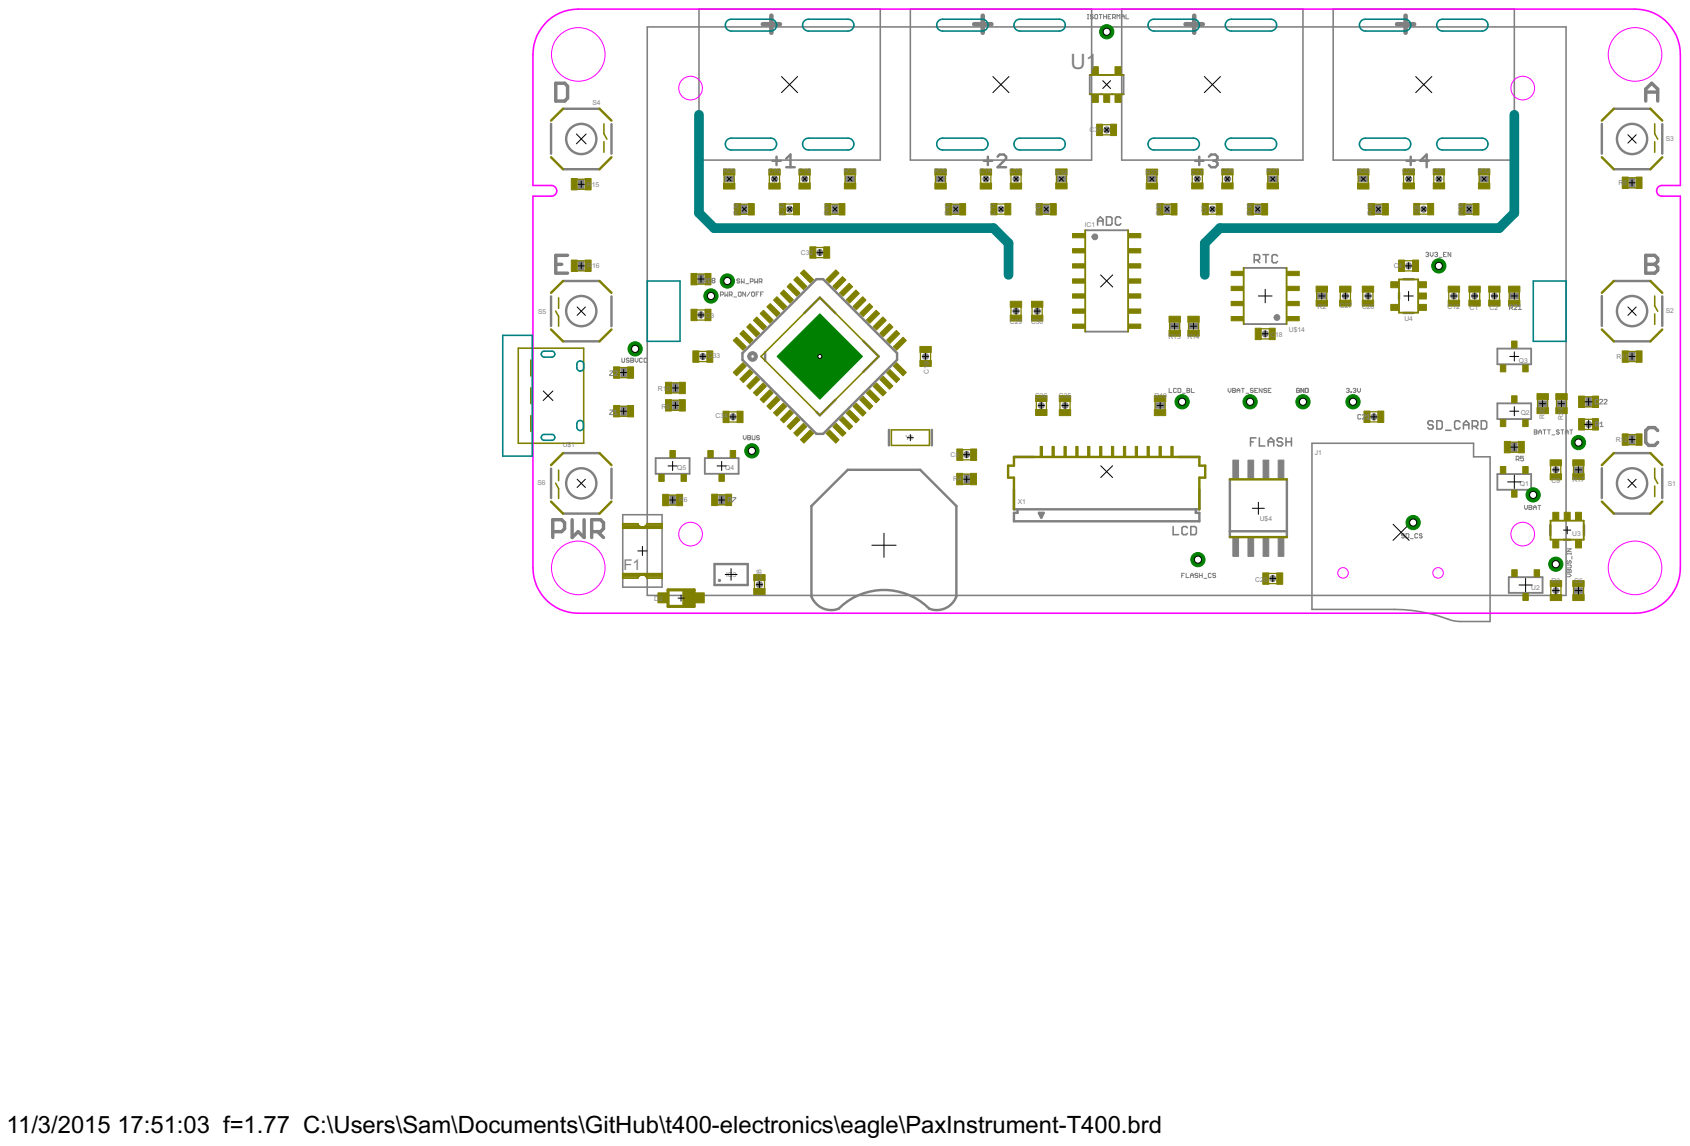
[picture p75: page 1]

11/3/2015 17:51:03 f=1.77 C:\Users\Sam\Documents\GitHub\t400-electronics\eagle\PaxInstrument-T400.brd
