PaxInstruments/t400-electronics/eagle/T400 Rev 0.11/PaxInstrument-T400 schematic.pdf

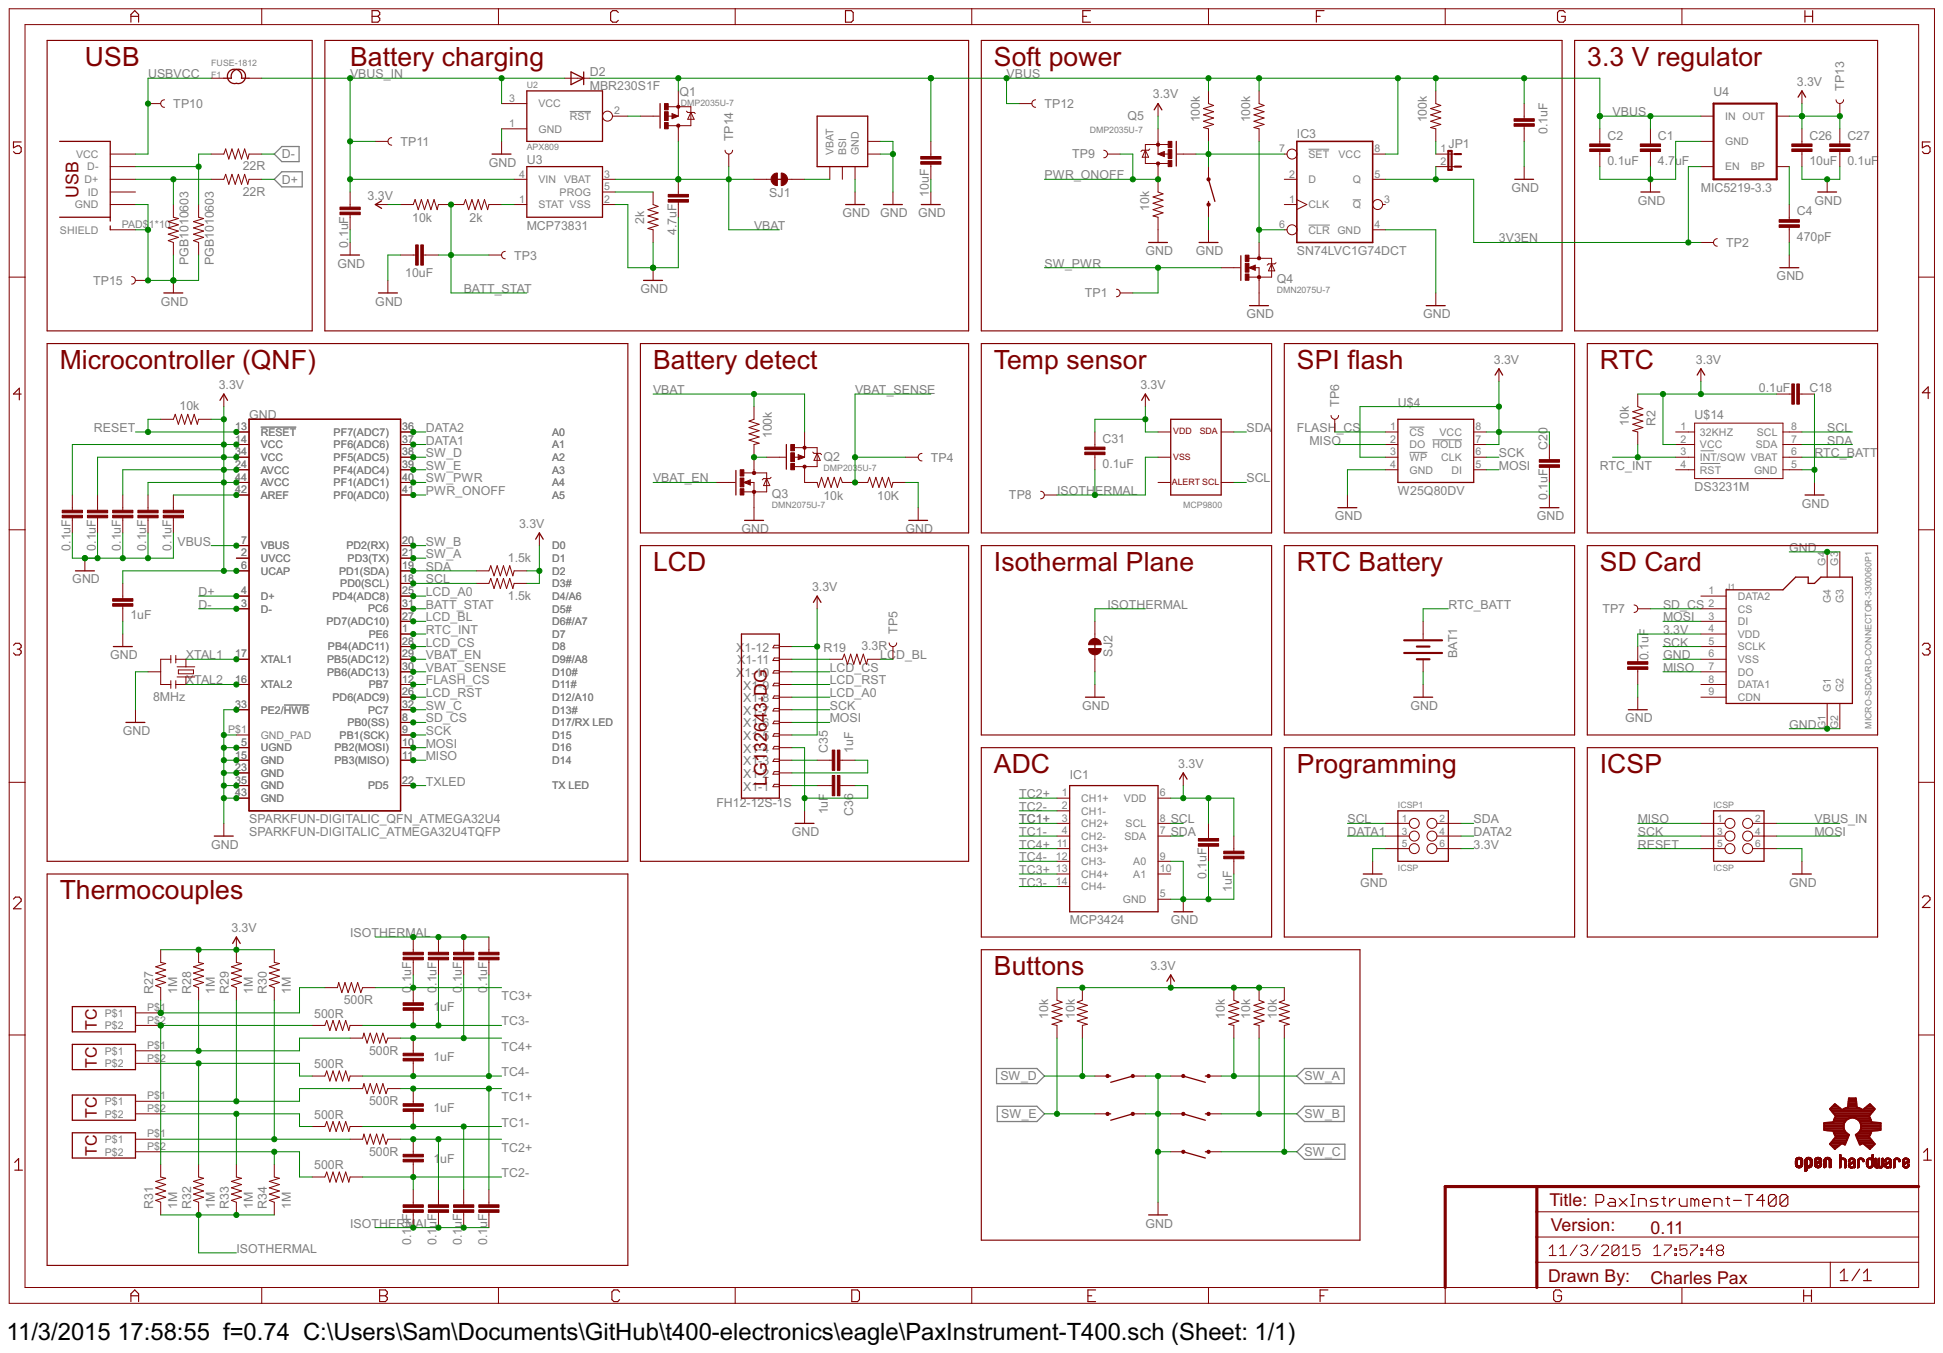
[picture p76: page 1]

Drawn By: Title: Version:

11/3/2015 17:58:55 f=0.74 C:\Users\Sam\Documents\GitHub\t400-electronics\eagle\PaxInstrument-T400.sch (Sheet: 1/1)
