PaxInstruments/t400-electronics/eagle/T400 Rev 0.13/PaxInstrument-T400 bottom layout.pdf

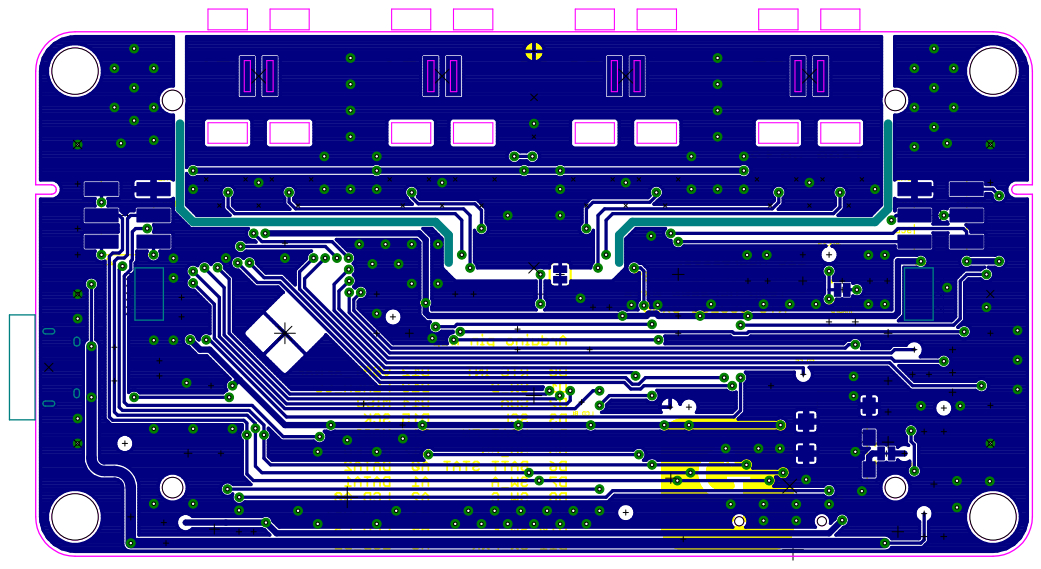
[picture p77: page 1]
