PaxInstruments/t400-electronics/eagle/T400 Rev 0.13/PaxInstrument-T400 top layout.pdf

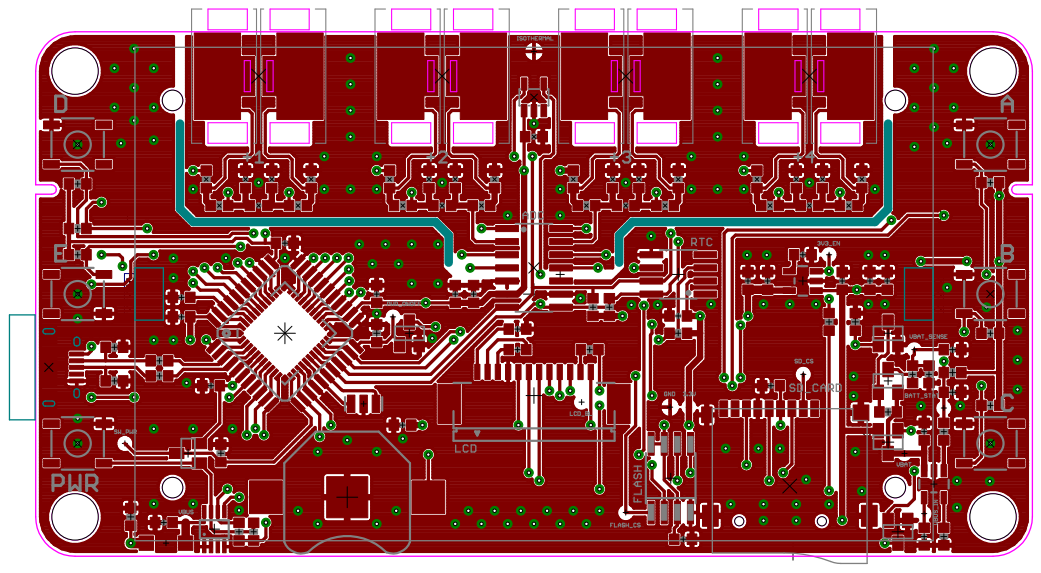
[picture p78: page 1]
