PaxInstruments/t400-electronics/eagle/T400 Rev 0.11/PaxInstrument-T400 Bottom Layout.pdf

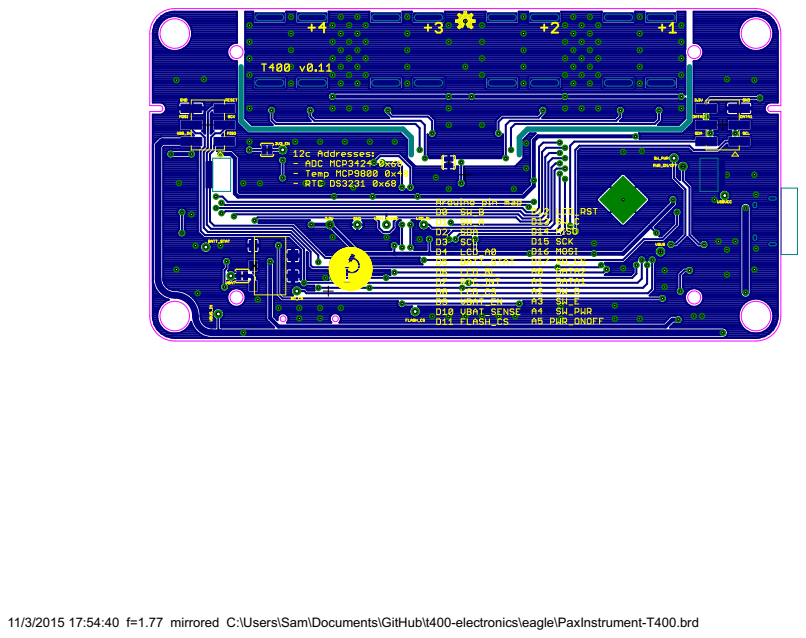
[picture p79: page 1]

11/3/2015 17:54:40 f=1.77 mirrored C:\Users\Sam\Documents\GitHub\t400-electronics\eagle\PaxInstrument-T400.brd
