PaxInstruments/t400-electronics/eagle/T400 Rev 0.9/PaxInstrument-T400.pdf

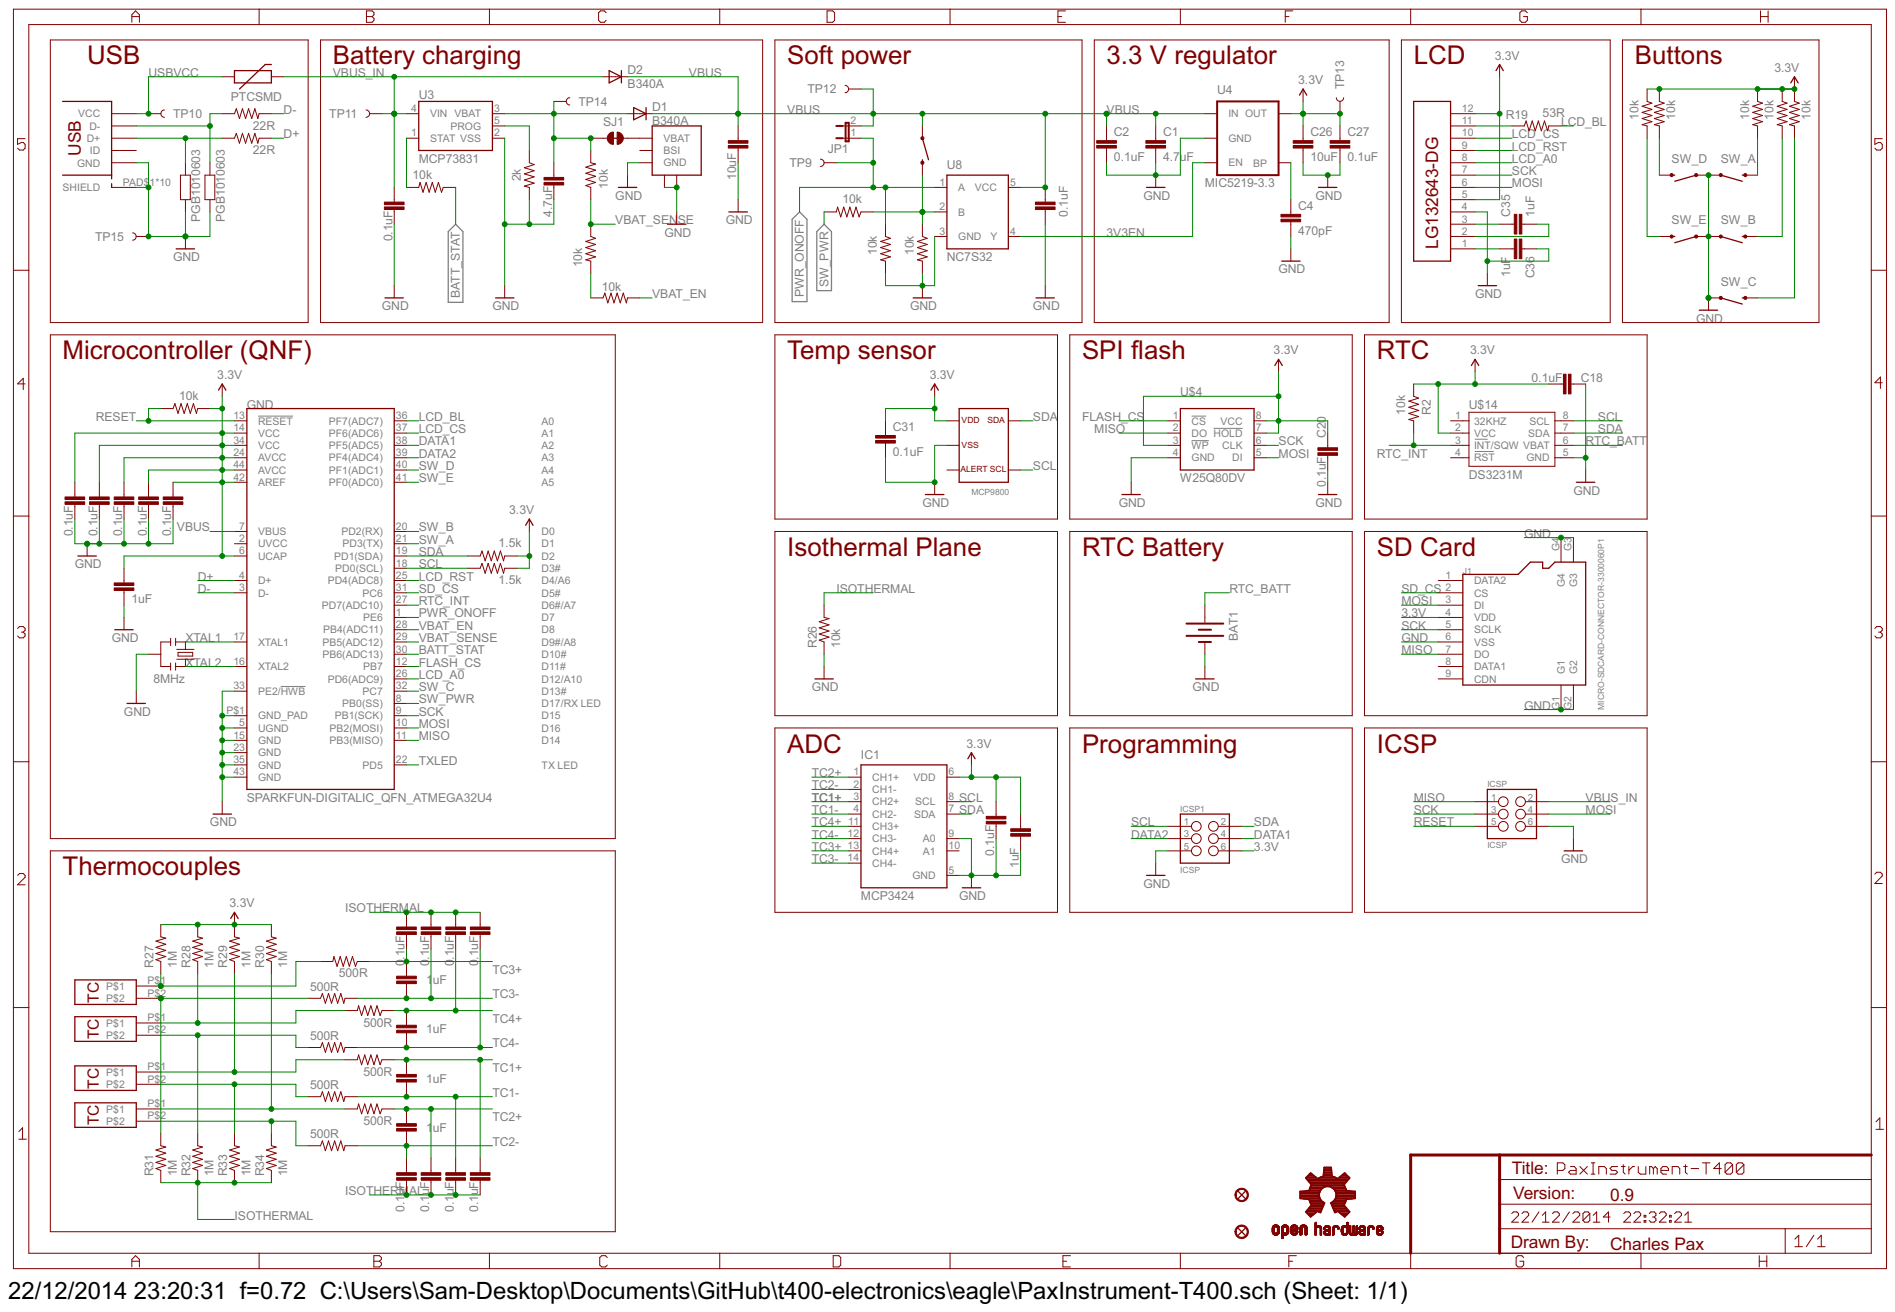
[picture p80: page 1]

Drawn By: Title: Version:

22/12/2014 23:20:31 f=0.72 C:\Users\Sam-Desktop\Documents\GitHub\t400-electronics\eagle\PaxInstrument-T400.sch (Sheet: 1/1)
