PaxInstruments/t400-electronics/eagle/T400 Rev 0.12/PaxInstrument-T400.brd

## EAGLE design eagle/T400 Rev 0.12/PaxInstrument-T400.brd (2015-04-20, an earlier design)

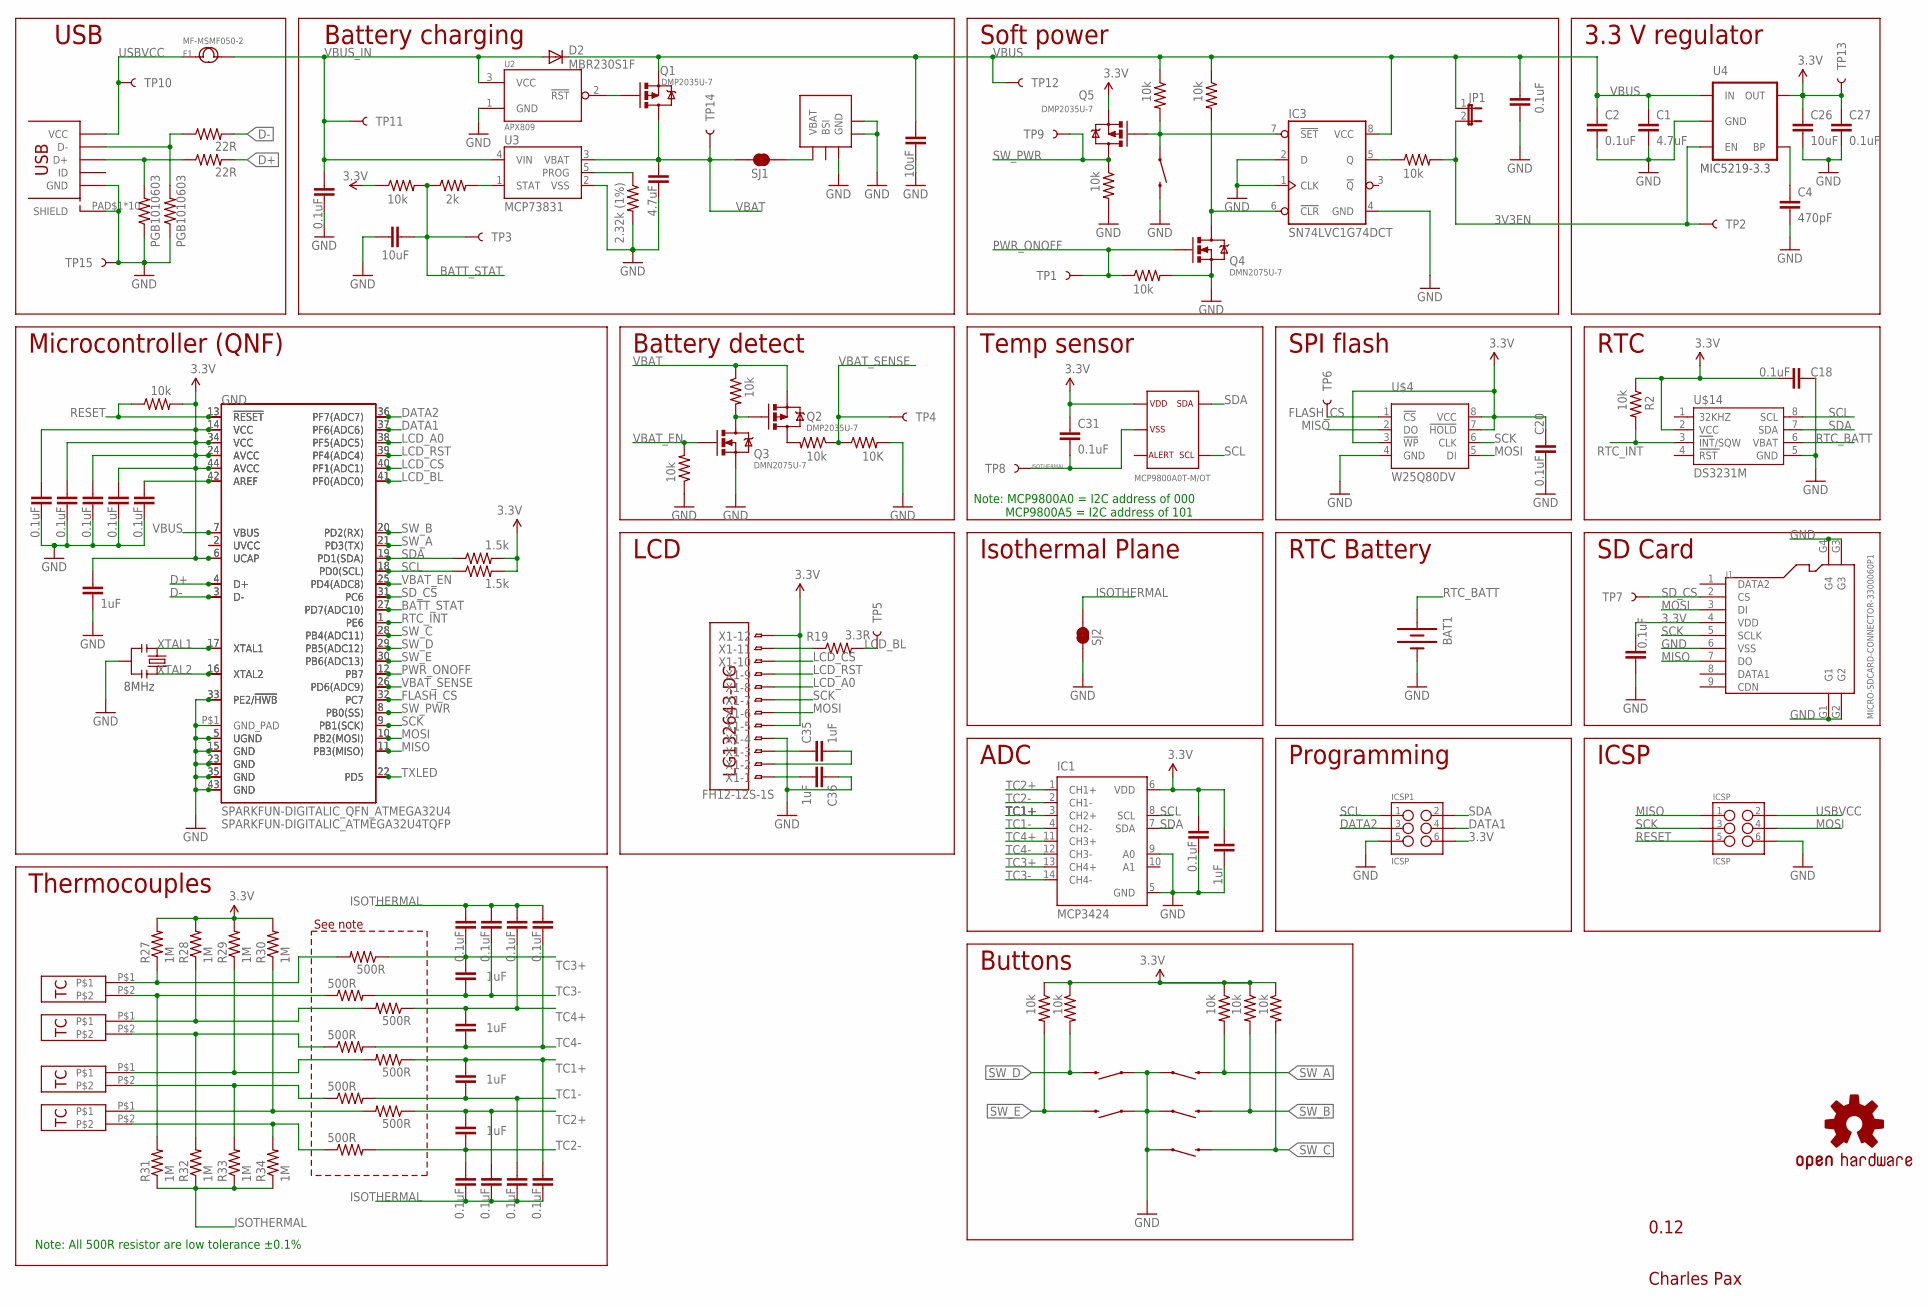
[picture p84: schematic PaxInstrument-T400.sch]

Parts:
BAT1: BATTERY12MM; BATTCON_12MM; MPN 3000TR
C1, C9: 4.7uF; SPARKFUN-CAPACITORS_0603-CAP
C2, C3, C5, C6, C13, C14, C15, C16, C17, C18, C20, C21, C24, C25, C27, C28, C29, C31, C32, C33, C34, C37: 0.1uF; SPARKFUN-CAPACITORS_0603-CAP
C4: 470pF; SPARKFUN-CAPACITORS_0603-CAP
C7, C8, C10, C11, C19, C30, C35, C36: 1uF; SPARKFUN-CAPACITORS_0603-CAP
C12, C22, C26: 10uF; SPARKFUN-CAPACITORS_0603-CAP
D2: MBR230S1F; SOD123; MPN MBR230S1F-7
F1: FUSE-1812; F1812; MPN MF-MSMF050-2
GND: SPARKFUN-DIGITALIC_QFN_ATMEGA32U4; SPARKFUN-DIGITALIC_SPARKFUN-DIGITALIC_QFN-44; MPN ATMEGA32U4-MU
IC1: MCP3424; SO14; MPN MCP3424-E/SL
IC3: SN74LVC1G74DCT; SSOP8; MPN SN74LVC1G74DCTR
ICSP, ICSP1: ICSP; SPARKFUN-CONNECTORS_2X3_SMT_POSTS_PAXINSTRUMENT; MPN 95278-101A06LF
J1: MICRO-SDCARD-CONNECTOR-3300060P1; 9P-SMD-W-RING; MPN ST-TF-003A
JP1: JUMPER-2SMD-NO; SJ_2S-NO; MPN N/A
LOGO1: OSHW-LOGOS; OSHW-LOGO-S; MPN N/A
Q1, Q2, Q5: DMP2035U-7; SOT23; MPN DMP2035U-7
Q3, Q4: DMN2075U-7; SOT23; MPN DMN2075U-7
R1, R2, R4, R5, R6, R7, R8, R11, R12, R15, R16, R18, R20, R21, R22, R23: 10k; SPARKFUN-RESISTORS_0603-RES
R3: 2.32k (1%); SPARKFUN-RESISTORS_0603-RES
R9, R10: 22R; SPARKFUN-RESISTORS_0603-RES
R13, R14: 1.5k; SPARKFUN-RESISTORS_0603-RES
R17: 2k; SPARKFUN-RESISTORS_0603-RES
R19: 3.3R; SPARKFUN-RESISTORS_0603-RES
R24: 10K; SPARKFUN-RESISTORS_0603-RES
R27, R28, R29, R30, R31, R32, R33, R34: 1M; SPARKFUN-RESISTORS_0603-RES
R35, R36, R37, R38, R39, R40, R41, R42: 500R; SPARKFUN-RESISTORS_0603-RES; MPN RN732ATTD5000B25
S1, S2, S3, S4, S5, S6: SWITCH-MOMENTARY-2SMD; TACTILE_SWITCH_SMD; MPN RS-187R05A2-DS MT RT
SJ1, SJ2: JUMPER-PAD-2-NC_BY_TRACE; PAD-JUMPER-2-NC_BY_TRACE_YES_SILK; MPN N/A
TP1: PWR_ONOFF; TP_15TH; MPN N/A
TP2: 3V3_EN; TP_15TH; MPN N/A
TP3: BATT_STAT; TP_15TH; MPN N/A
TP4: VBAT_SENSE; TP_15TH; MPN N/A
TP5: LCD_BL; TP_15TH; MPN N/A
TP6: FLASH_CS; TP_15TH; MPN N/A
TP7: SD_CS; TP_15TH; MPN N/A
TP8: ISOTHERMAL; TP_15TH; MPN N/A
TP9: SW_PWR; TP_15TH; MPN N/A
TP10: TEST-POINTTP_15TH_THRU; TP_15TH; MPN N/A
TP11: VBUS_IN; TP_15TH; MPN N/A
TP12: VBUS; TP_15TH; MPN N/A
TP13: 3.3V; TP_15TH; MPN N/A
TP14: VBAT; TP_15TH; MPN N/A
TP15: GND; TP_15TH; MPN N/A
U1: MCP9800; SOT23-5L; MPN MCP9800A0T-M/OT
U2: APX809; SOT23; MPN APX809-44SAG-7
U3: MCP73831; SOT23-5; MPN MCP73832T-2DCI/OT
U4: MIC5219-3.3V; SOT23-5; MPN MIC5219-3.3YM5 TR
U$1: USB_MICROSMT+THRUHULE; USB_MICRO_THRUHOLE; MPN 10118194-0001LF
U$2: BL-5C-CONNECTOR
U$3: SPARKFUN-DIGITALIC_ATMEGA32U4TQFP; SPARKFUN-DIGITALIC_SPARKFUN-DIGITALIC_TQFP44; MPN ATMEGA32U4-AU
U$4: W25Q80DV; CHARLESPAX_SOIC8M; MPN W25Q80DVSSIG-ND
U$5: LG132643-DG; MPN LG132643-DW
U$10, U$11, U$12, U$13: CHARLESPAX_TC-MINI-CONNECTOR; MPN 3572
U$14: DS3231M; SOIC8; MPN DS3231MZ+
X1: FH12-12S-1S; FH12-12S-1SH; MPN FH12-12S-1SH(55)
Y1: RESONATORSMD; RESONATOR-SMD; MPN CSTCE8M00G52-R0
Z1, Z2: PGB1010603; SPARKFUN-RESISTORS_0603-RES; MPN PGB1010603NRHF

Connections:
3.3V: C5.1, C18.1, C19.1, C20.2, C21.2, C26.1, C27.1, C29.1, C30.1, C31.1, C32.1, C33.1, C34.1, GND.6 (UCAP), GND.14 (VCC), GND.24 (AVCC), GND.34 (VCC), GND.44 (AVCC), IC1.6 (VDD), ICSP1.6, J1.4 (VDD), Q5.2 (S), R1.1, R2.1, R4.2, R8.1, R11.1, R12.1, R13.2, R14.2, R15.1, R16.1, R27.2, R28.2, R29.2, R30.2, TP13.P$1, U1.1, U4.5 (OUT), U$3.6 (UCAP), U$3.14 (VCC), U$3.24 (AVCC), U$3.34 (VCC), U$3.44 (AVCC), U$4.3 (!WP), U$4.7 (!HOLD), U$4.8 (VCC), U$14.2 (VCC), X1.5, X1.12
3V3EN: JP1.2, R21.2, TP2.P$1, U4.3 (EN)
BATT_STAT: C22.1, GND.27 (PD7(ADC10)), R1.2, R17.1, TP3.P$1, U$3.27 (PD7(ADC10))
D+: GND.4 (D+), R9.2, U$3.4 (D+)
D-: GND.3 (D-), R10.2, U$3.3 (D-)
DATA1: GND.37 (PF6(ADC6)), ICSP1.4, U$3.37 (PF6(ADC6))
DATA2: GND.36 (PF7(ADC7)), ICSP1.3, U$3.36 (PF7(ADC7))
FLASH_CS: GND.32 (PC7), TP6.P$1, U$3.32 (PC7), U$4.1 (!CS)
GND: BAT1.GND (-), C1.2, C2.2, C3.2, C4.2, C5.2, C6.2, C9.2, C12.2, C18.2, C19.2, C20.1, C21.1, C22.2, C26.2, C27.2, C28.2, C29.2, C30.2, C32.2, C33.2, C34.2, C36.1, GND.5 (UGND), GND.15 (GND), GND.23 (GND), GND.33 (PE2/!HWB), GND.35 (GND), GND.43 (GND), GND.P$1 (GND_PAD), IC1.5 (GND), IC1.9 (A0), IC3.1 (CLK), IC3.2 (D), IC3.4 (GND), ICSP.6, ICSP1.5, J1.6 (VSS), J1.G1, J1.G2, J1.G3, J1.G4, Q3.2 (S), Q4.2 (S), R3.2, R18.2, R22.2, R23.1, R24.2, S1.1, S2.1, S3.1, S4.1, S5.1, S6.3 (2), SJ2.1, TP15.P$1, U2.1 (GND), U3.2 (VSS), U4.2 (GND), U$1.PAD$1 (SHIELD), U$1.PAD$2 (SHIELD), U$1.PAD$3 (SHIELD), U$1.PAD$4 (SHIELD), U$1.PAD$5 (SHIELD), U$1.PAD$6 (SHIELD), U$1.PAD$7 (SHIELD), U$1.PAD$8 (SHIELD), U$1.PAD$9 (SHIELD), U$1.PAD$10 (SHIELD), U$1.PIN$5 (GND), U$2.P$3 (GND), U$2.P$4, U$2.P$5, U$3.5 (UGND), U$3.15 (GND), U$3.23 (GND), U$3.33 (PE2/!HWB), U$3.35 (GND), U$3.43 (GND), U$4.4 (GND), U$14.5 (GND), X1.4, Y1.2, Z1.1, Z2.1
ISOTHERMAL: C13.2, C14.2, C15.2, C16.2, C17.1, C24.1, C25.1, C31.2, C37.1, R31.1, R32.1, R33.1, R34.1, SJ2.2, TP8.P$1, U1.2
LCD_A0: GND.38 (PF5(ADC5)), U$3.38 (PF5(ADC5)), X1.8
LCD_BL: GND.41 (PF0(ADC0)), R19.2, TP5.P$1, U$3.41 (PF0(ADC0))
LCD_CS: GND.40 (PF1(ADC1)), U$3.40 (PF1(ADC1)), X1.10
LCD_RST: GND.39 (PF4(ADC4)), U$3.39 (PF4(ADC4)), X1.9
MISO: GND.11 (PB3(MISO)), ICSP.1, J1.7 (DO), U$3.11 (PB3(MISO)), U$4.2 (DO)
MOSI: GND.10 (PB2(MOSI)), ICSP.4, J1.3 (DI), U$3.10 (PB2(MOSI)), U$4.5 (DI), X1.6
unnamed: C4.1, U4.4 (BP)
unnamed: R17.2, U3.1 (STAT)
unnamed: R19.1, X1.11
unnamed: R31.2, R36.1, U$10.P$2
unnamed: R3.1, U3.5 (PROG)
unnamed: SJ1.2, U$2.P$1 (VBAT)
unnamed: R27.1, R35.2, U$10.P$1
unnamed: Q1.1 (G), U2.2 (!RST)
unnamed: R29.1, R39.2, U$12.P$1
unnamed: R33.2, R41.1, U$12.P$2
unnamed: C3.1, GND.42 (AREF), U$3.42 (AREF)
unnamed: R34.2, R42.1, U$13.P$2
unnamed: GND.2 (UVCC), U$3.2 (UVCC)
unnamed: Q2.3 (D), R20.2
unnamed: IC3.7 (!SET), Q5.1 (G), R6.2, S6.1
unnamed: Q2.1 (G), Q3.3 (D), R5.2
unnamed: IC3.6 (!CLR), Q4.3 (D), R7.2
unnamed: IC3.5 (Q), R21.1
unnamed: R10.1, U$1.PIN$2 (D-), Z2.2
unnamed: R9.1, U$1.PIN$3 (D+), Z1.2
unnamed: R32.2, R38.1, U$11.P$2
unnamed: R28.1, R37.2, U$11.P$1
unnamed: C35.1, X1.3
unnamed: C35.2, X1.2
unnamed: C36.2, X1.1
unnamed: R30.1, R40.2, U$13.P$1
PWR_ONOFF: GND.12 (PB7), Q4.1 (G), R22.1, TP1.P$1, U$3.12 (PB7)
RESET: GND.13 (!RESET), ICSP.5, R4.1, U$3.13 (!RESET)
RTC_BATT: BAT1.PWR@1 (+), U$14.6 (VBAT)
RTC_INT: GND.1 (PE6), R2.2, U$3.1 (PE6), U$14.3 (INT/SQW)
SCK: GND.9 (PB1(SCK)), ICSP.3, J1.5 (SCLK), U$3.9 (PB1(SCK)), U$4.6 (CLK), X1.7
SCL: GND.18 (PD0(SCL)), IC1.8 (SCL), ICSP1.1, R14.1, U1.4, U$3.18 (PD0(SCL)), U$14.8 (SCL)
SDA: GND.19 (PD1(SDA)), IC1.7 (SDA), ICSP1.2, R13.1, U1.5, U$3.19 (PD1(SDA)), U$14.7 (SDA)
SD_CS: GND.31 (PC6), J1.2 (CS), TP7.P$1, U$3.31 (PC6)
SW_A: GND.21 (PD3(TX)), R8.2, S3.3 (2), U$3.21 (PD3(TX))
SW_B: GND.20 (PD2(RX)), R11.2, S2.3 (2), U$3.20 (PD2(RX))
SW_C: GND.28 (PB4(ADC11)), R12.2, S1.3 (2), U$3.28 (PB4(ADC11))
SW_D: GND.29 (PB5(ADC12)), R15.2, S4.3 (2), U$3.29 (PB5(ADC12))
SW_E: GND.30 (PB6(ADC13)), R16.2, S5.3 (2), U$3.30 (PB6(ADC13))
SW_PWR: GND.8 (PB0(SS)), Q5.3 (D), R18.1, TP9.P$1, U$3.8 (PB0(SS))
TC1+: C10.1, C16.1, IC1.3 (CH2+), R39.1
TC1-: C10.2, C15.1, IC1.4 (CH2-), R41.2
TC2+: C11.1, C14.1, IC1.1 (CH1+), R40.1
TC2-: C11.2, C13.1, IC1.2 (CH1-), R42.2
TC3+: C7.1, C17.2, IC1.13 (CH4+), R35.1
TC3-: C7.2, C24.2, IC1.14 (CH4-), R36.2
TC4+: C8.1, C25.2, IC1.11 (CH3+), R37.1
TC4-: C8.2, C37.2, IC1.12 (CH3-), R38.2
TXLED: GND.22 (PD5), U$3.22 (PD5)
USBVCC: F1.1, ICSP.2, TP10.P$1, U$1.PIN$1 (VCC)
VBAT: C9.1, Q1.3 (D), Q2.2 (S), R5.1, SJ1.1, TP14.P$1, U3.3 (VBAT)
VBAT_EN: GND.25 (PD4(ADC8)), Q3.1 (G), R23.2, U$3.25 (PD4(ADC8))
VBAT_SENSE: GND.26 (PD6(ADC9)), R20.1, R24.1, TP4.P$1, U$3.26 (PD6(ADC9))
VBUS: C1.1, C2.1, C12.1, C28.1, D2.C, GND.7 (VBUS), IC3.8 (VCC), JP1.1, Q1.2 (S), R6.1, R7.1, TP12.P$1, U4.1 (IN), U$3.7 (VBUS)
VBUS_IN: C6.1, D2.A, F1.2, TP11.P$1, U2.3 (VCC), U3.4 (VIN)
XTAL1: GND.17 (XTAL1), U$3.17 (XTAL1), Y1.1
XTAL2: GND.16 (XTAL2), U$3.16 (XTAL2), Y1.3

Notes on the sheet:
MIC5219-3.3
8MHz
ADC
USB
Battery charging
Soft power
3.3 V regulator
RTC
LCD
Buttons
Microcontroller (QNF)
ICSP
Temp sensor
0.12
Programming
Isothermal Plane
Thermocouples
RTC Battery
Charles Pax
SPI flash
SD Card
Battery detect
Note: MCP9800A0 = I2C address of 000 MCP9800A5 = I2C address of 101
Note: All 500R resistor are low tolerance ±0.1%
See note

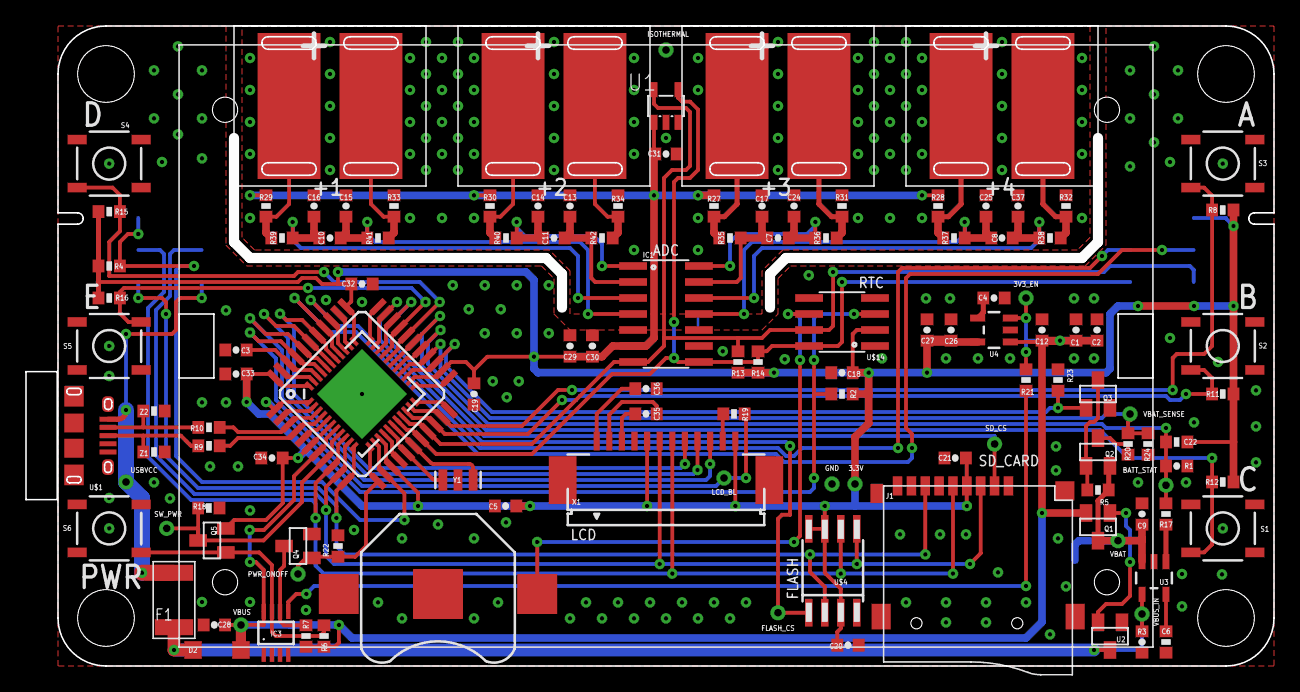
[picture p85: board PaxInstrument-T400.brd from above]

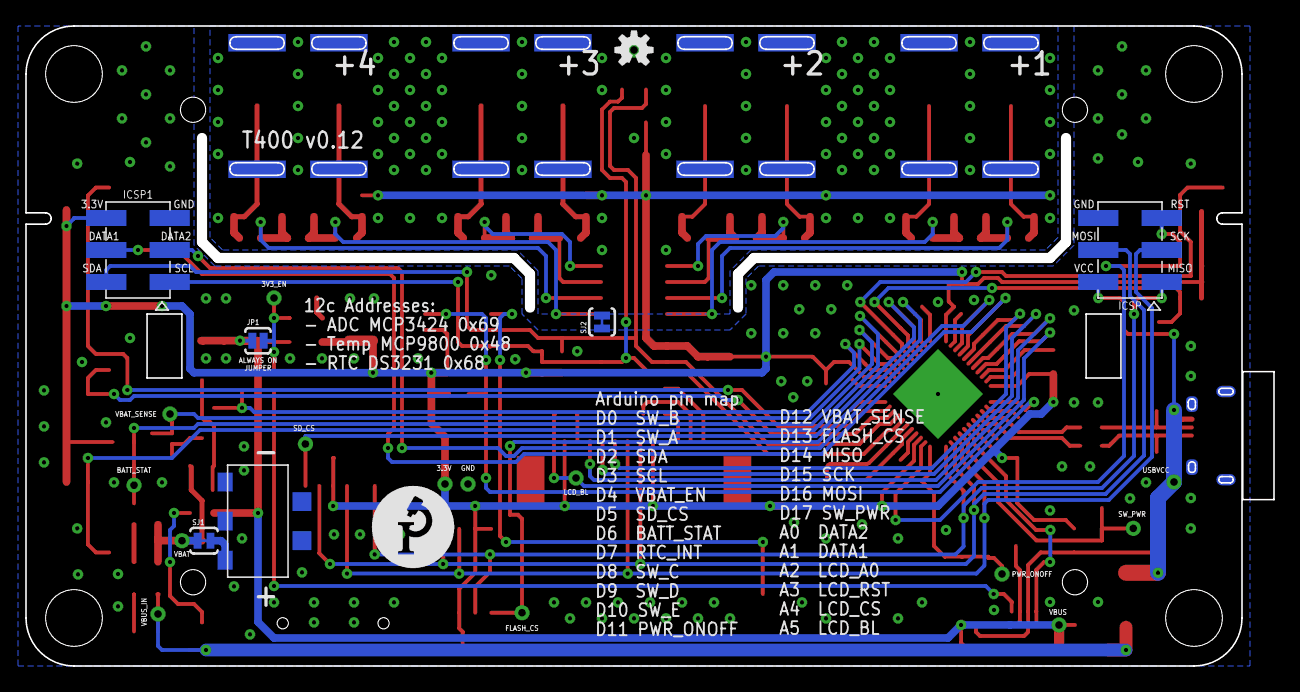
[picture p86: board PaxInstrument-T400.brd from below]

Board: 2 copper layers, 99.1 x 50.8 mm, 134 parts (12 on the bottom side), 73 nets.

Other parts of the board:
U$6: PAXINSTRUMENT_LOGO
