PaxInstruments/t400-electronics/eagle/tc connector test spacing/tc connecor test spacing.brd

## EAGLE design eagle/tc connector test spacing/tc connecor test spacing.brd (2015-07-31)

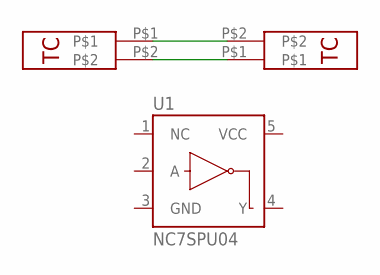
[picture p87: schematic tc connecor test spacing.sch]

Parts:
U1: NC7SPU04; SC70
U$1: TC-MINI-INSIDE; TC-CLIP-INSIDE
U$2: TC-MINI-OUTSIDE; TC-CLIP-OUTSIDE

Connections:
unnamed: U$1.P$1, U$2.P$2
unnamed: U$1.P$2, U$2.P$1

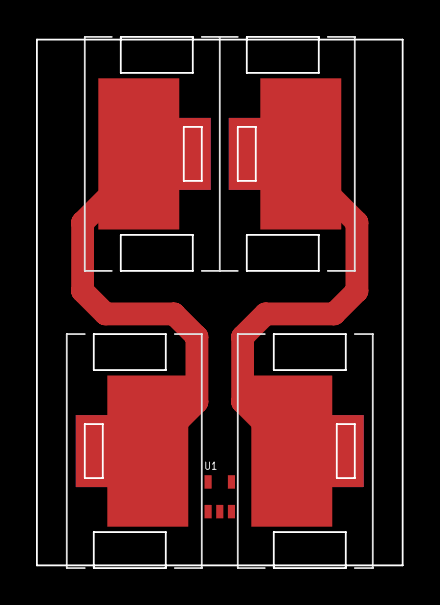
[picture p88: board tc connecor test spacing.brd from above]

Board: 2 copper layers, 20.3 x 29.2 mm, 3 parts (0 on the bottom side), 2 nets.
