PaxInstruments/t400-electronics/referenceDesigns/Sparkfun-SD-breakout.brd

## EAGLE design referenceDesigns/Sparkfun-SD-breakout.brd (2014-09-02)

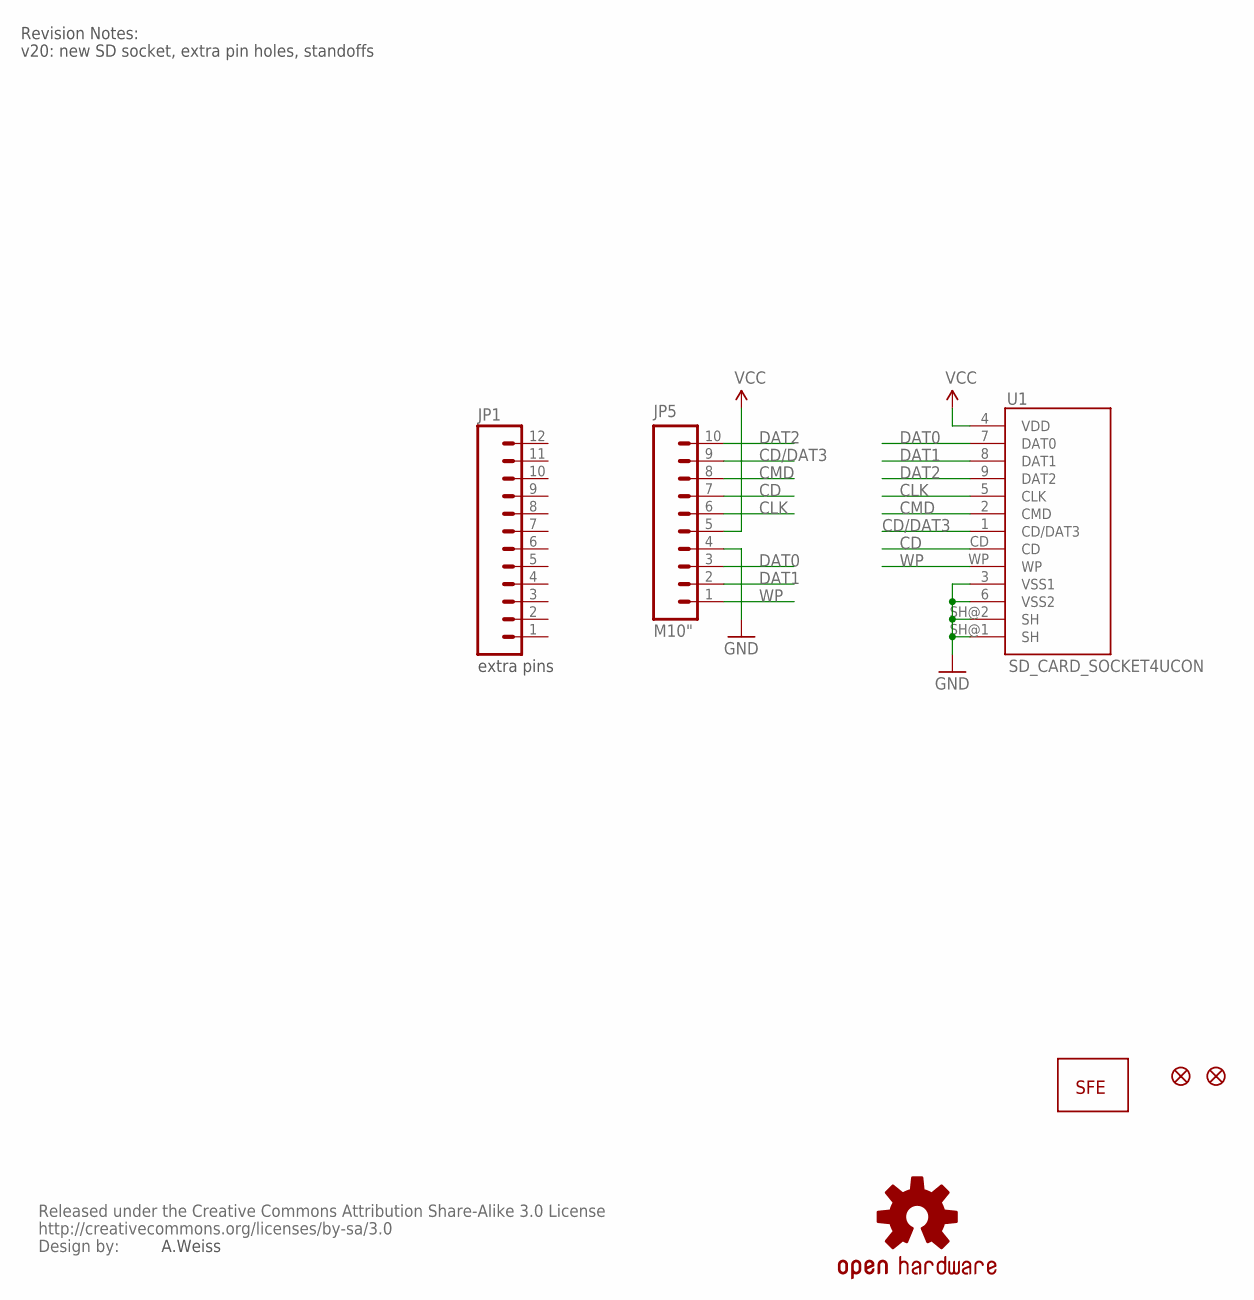
[picture p89: schematic Sparkfun-SD-breakout.sch]

Parts:
JP1: M12POGOPIN_HOLES_ONLY; 1X12_HOLES_ONLY
JP2, JP3: FIDUCIALUFIDUCIAL; MICRO-FIDUCIAL
JP5: M10"; 1X10
U1: SD_CARD_SOCKET4UCON; SDCARD_4UCONN
U$1: LOGO-SFENEW; SFE-NEW-WEBLOGO
U$2: CREATIVE_COMMONS
U$3: OSHW-LOGOS; OSHW-LOGO-S

Connections:
CD: JP5.7, U1.CD
CD/DAT3: JP5.9, U1.1 (CD/DAT3)
CLK: JP5.6, U1.5 (CLK)
CMD: JP5.8, U1.2 (CMD)
DAT0: JP5.3, U1.7 (DAT0)
DAT1: JP5.2, U1.8 (DAT1)
DAT2: JP5.10, U1.9 (DAT2)
GND: JP5.4, U1.3 (VSS1), U1.6 (VSS2), U1.SH@1 (SH), U1.SH@2 (SH)
VCC: JP5.5, U1.4 (VDD)
WP: JP5.1, U1.WP

Notes on the sheet:
A.Weiss
Revision Notes:
v20: new SD socket, extra pin holes, standoffs
extra pins

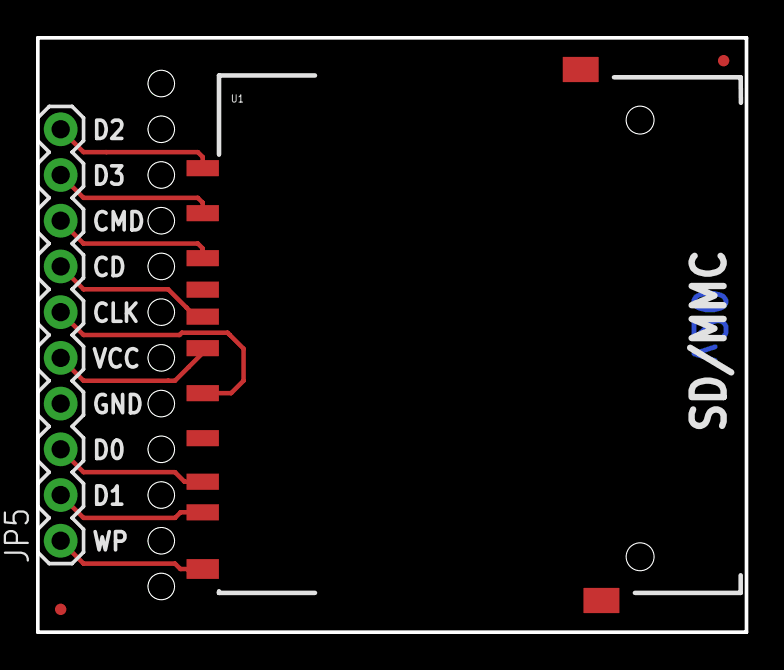
[picture p90: board Sparkfun-SD-breakout.brd from above]

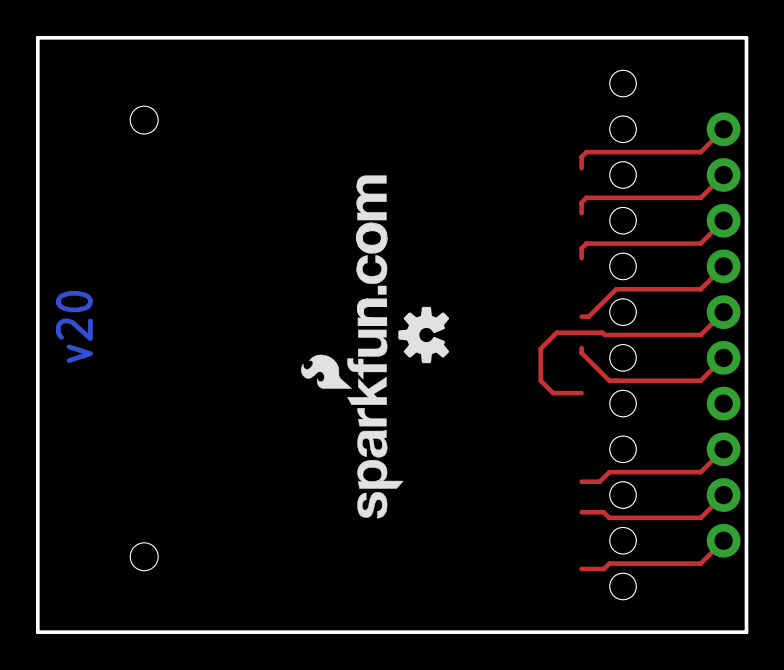
[picture p91: board Sparkfun-SD-breakout.brd from below]

Board: 2 copper layers, 39.4 x 33.0 mm, 8 parts (3 on the bottom side), 10 nets.
