PaxInstruments/t400-electronics/referenceDesigns/Kytelabs-BLEduino.brd

## EAGLE design referenceDesigns/Kytelabs-BLEduino.brd (2014-09-02)

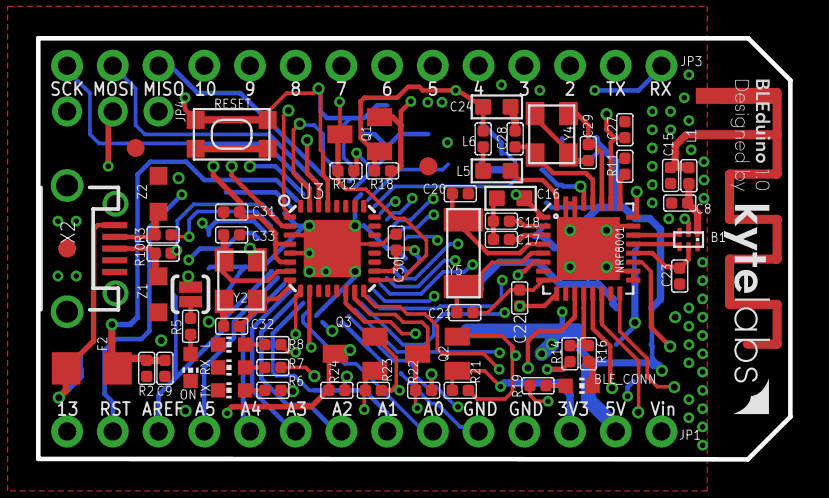
[picture p92: board Kytelabs-BLEduino.brd from above]

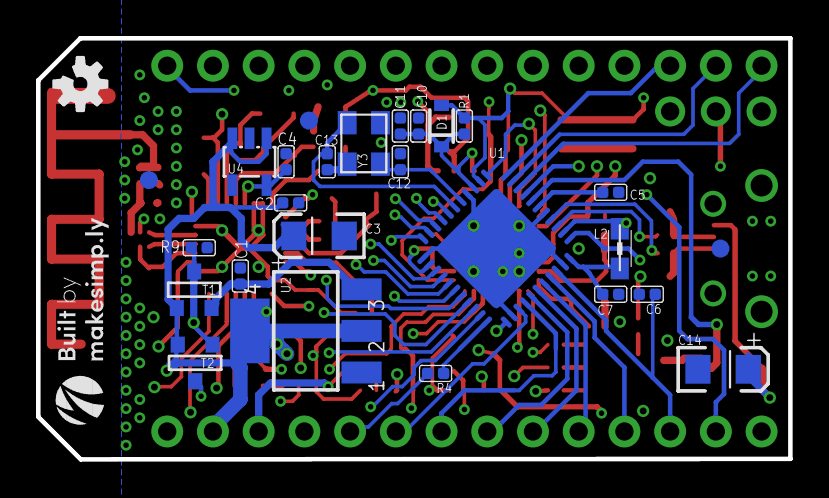
[picture p93: board Kytelabs-BLEduino.brd from below]

Board: 6 copper layers, 41.8 x 23.4 mm, 94 parts (27 on the bottom side), 77 nets.

Parts:
ANT1: ANTENNA; RN-ANT
B1: BALUN0603; BALUN-0603
BLE_CONN: blue; CHIP-LED0603
C1, C2, C6, C9, C10, C11, C30, C31: 100n; C0402
C3, C14: 22u; EIA3216
C4, C5, C7: 1uF; C0402
C8, C15: n/a; C0402
C12, C13: 22pF; C0402
C16, C24: 1uF; C0603
C17: 33nF; C0402
C18, C22: 100nF; C0402
C20, C21, C28, C29: 15pF; C0402
C23: 2.2nF; C0402
C27: 1nF; C0402
C32, C33: 22p; C0402
D1: SOD-323
F2: R1206
JP1, JP3: 1X14-CB
JP4: 1X03-CLEANBIG
L: green; CHIP-LED0603
L1: n/a; L0402
L2: MH2029-300Y; 0805
L5: 10uH; L0603
L6: 15nH; L0402
NRF8001: FITNESSDEVICE_NRF8001; FITNESSDEVICE_QFN-32
ON: red; CHIP-LED0603
Q1, Q2, Q3: BSS138; SOT23
R1, R2, R4, R9, R12, R14, R18, R21, R22, R23, R24: 10K; R0402
R3, R10: 22; R0402
R5, R6, R7, R8, R19: 1K; R0402
R11: 22K; R0402
R16: 20K; R0402
RESET: SPST_TACT-KMR2; KMR2
RX: yellow; CHIP-LED0603
SILK_1: V3_KYTELABS_TOP
SILK_2: V3_MAKESIMPLY_BOTTOM
SJ1: SOLDERJUMPERNC2; SJ_2S-NOTRACE
T1: FDN340P/PMV48XP; SOT-23
T2: PMV48XP; SOT-23
TX: yellow; CHIP-LED0603
U1: ATMEGA32U4-XUMU; QFN44ML7X7
U2: NCP1117-5; LINEAR_SOT223
U3: ATMEGA8/168/328MLF; MLF32X-W/HEAT
U4: LP2985-33DBVR; SOT23-DBV
U$1: OSHW-LOGO-S
U$12, U$27, U$37: FIDUCIAL; FIDUCIAL_1MM
U$28, U$29, U$53: FIDUCIAL1X2; FIDUCIAL-1X2
X2: SPARKFUN_USB-MICROB
Y2, Y4: 16MHz; CRYSTAL-3.2-2.5
Y3: 16MHz KX-7; CRYSTAL-3.2-2.5
Y5: Y5; FITNESSDEVICE_CRYSTAL-ABS10
Z1, Z2: CG0603MLC-05E; CT/CN0603

Connections:
3V3: C4.1, C16.1, C22.2, C24.1, C27.1, JP1.12, L6.2, NRF8001.1, NRF8001.9, NRF8001.24, NRF8001.26, NRF8001.29, Q1.1, Q2.1, Q3.1, R18.2, R21.2, R23.2, U4.5
+5V: C2.1, C3.A, C10.1, C11.1, C30.1, C31.1, D1.1, JP1.13, L2.1, R1.1, R12.1, R22.1, R24.1, SJ1.1, T1.2, T2.3, U1.2, U1.14, U1.24, U1.34, U2.2, U2.4, U3.4, U3.6, U3.18, U4.1, U4.3
+VIN: C1.1, T2.2, U2.3
A0: JP1.9, U1.36
A1: JP1.8, U1.37
A2: JP1.7, U1.38
A3: JP1.6, U1.39
A4: JP1.5, U1.40
A5: JP1.4, U1.41
AREF: C6.1, JP1.3, U1.42
AVCC: C7.1, L2.2, U1.44
BLE_ACTIVE: NRF8001.6, U3.9
BLE_MISO: JP4.3, Q3.3, R24.2, U3.16
BLE_MISO_SHIFTED: NRF8001.14, Q3.2, R23.1
BLE_MOSI: JP4.2, Q2.3, R22.2, U3.15
BLE_MOSI_SHIFTED: NRF8001.13, Q2.2, R21.1
BLE_RDNY: NRF8001.16, U3.1
BLE_REQN: R14.1, U3.14
BLE_REQN_SHIFTED: NRF8001.12, R14.2, R16.2
BLE_RESET: NRF8001.19, U3.2
BLE_SCK: JP4.1, Q1.3, R12.2, U3.17
BLE_SCK_SHIFTED: NRF8001.11, Q1.2, R18.1
D0/RX: JP3.14, U1.20
D1/TX: JP3.13, U1.21
D2/SDA: JP3.12, U1.19
D3/SCL: JP3.11, U1.18
D4*: JP3.10, U1.25
D5*: JP3.9, U1.31
D6*: JP3.8, U1.27
D7: JP3.7, U1.1
D+: R10.2, X2.D+, Z1.1
D-: R3.2, X2.D-, Z2.1
GND: ANT1.GND, B1.2, BLE_CONN.C, C1.2, C2.2, C3.C, C4.2, C5.2, C6.2, C7.2, C8.2, C9.2, C10.2, C11.2, C12.1, C13.1, C14.C, C15.2, C16.2, C17.2, C18.2, C20.2, C21.2, C22.1, C23.1, C24.2, C27.2, C28.2, C29.2, C30.2, C31.2, C32.2, C33.2, JP1.10, JP1.11, L.C, NRF8001.8, NRF8001.17, NRF8001.18, NRF8001.23, NRF8001.30, NRF8001.31, NRF8001.EP, ON.C, R2.1, R4.2, R9.1, R11.2, R16.1, RESET.2, RESET.4, RX.C, TX.C, U1.5, U1.15, U1.23, U1.35, U1.43, U1.EXP, U2.1, U3.3, U3.5, U3.21, U3.HEAT, U4.2, X2.GND, Y2.2, Y2.4, Y3.2, Y3.4, Y4.1, Y4.3, Z1.2, Z2.2
HWB: R4.1, U1.33
IO8: JP3.6, U1.28
IO9*: JP3.5, U1.29
IO10*: JP3.4, U1.30
IO11*: U1.12, U3.31
IO12*: U1.26, U3.30
IO13*: JP1.1, R8.1, U1.32
MISO: JP3.3, U1.11
MOSI: JP3.2, U1.10
unnamed: C33.1, U3.7, Y2.1
unnamed: R7.2, RX.A
unnamed: ON.A, R5.2
unnamed: R6.2, TX.A
unnamed: C32.1, U3.8, Y2.3
unnamed: R19.2, U3.10
unnamed: L.A, R8.2
unnamed: BLE_CONN.A, R19.1
unnamed: ANT1.FEED, C15.1, L1.2
unnamed: C18.1, NRF8001.2
unnamed: R5.1, SJ1.2
unnamed: L5.1, NRF8001.32
unnamed: L5.2, L6.1
unnamed: C17.1, NRF8001.3
unnamed: C20.1, NRF8001.4, Y5.P$1
unnamed: C21.1, NRF8001.5, Y5.P$2
unnamed: B1.5, C23.2, NRF8001.20
unnamed: B1.3, NRF8001.22
unnamed: B1.4, NRF8001.21
unnamed: B1.1, C8.1, L1.1
unnamed: NRF8001.25, R11.1
unnamed: C28.1, NRF8001.28, Y4.4
unnamed: C29.1, NRF8001.27, Y4.2
RD_N: R3.1, U1.3
RD_P: R10.1, U1.4
RESET: D1.2, JP1.2, R1.2, RESET.1, RESET.3, U1.13, U3.29
RXLED/SS: R7.1, U1.8
SCK: JP3.1, U1.9
TXLED: R6.1, U1.22
UCAP: C5.1, U1.6
VIN: JP1.14, R9.2, T1.3, T2.1
VUSB: C9.1, F2.1, R2.2, T1.1, U1.7
VUSBD: C14.A, F2.2, X2.VBUS
XTAL1: C13.2, U1.17, Y3.3
XTAL2: C12.2, U1.16, Y3.1
