PaxInstruments/t400-electronics/referenceDesigns/Arduino-lilypad-USB.brd

## EAGLE design referenceDesigns/Arduino-lilypad-USB.brd (2014-09-02)

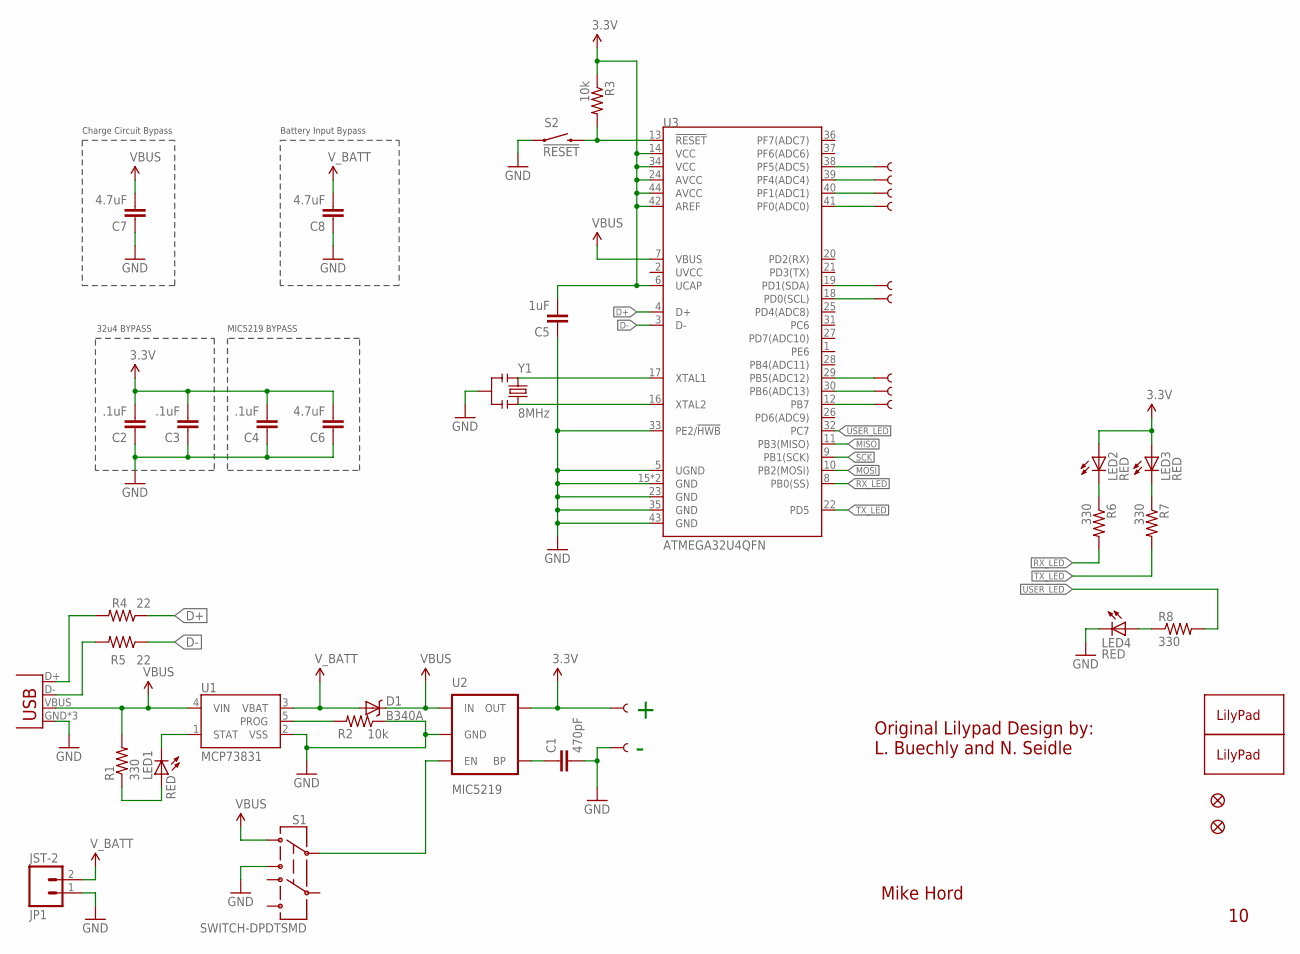
[picture p94: schematic Arduino-lilypad-USB.sch]

Parts:
+: SEWTAP9; PETAL-LONG-1-2SIDE
-: SEWTAP9; PETAL-LONG-1-2SIDE
A2, A3, A4, A5: SEWTAP9; PETAL-LONG-1-2SIDE
C1: 470pF; 0603-CAP
C2, C3, C4: .1uF; 0603-CAP
C5: 1uF; 0603-CAP
C6: 4.7uF; 0603-CAP
C7, C8: 4.7uF; 1206
D1: B340A; SMA-DIODE
D5, D6, D9, D10, D11: SEWTAP9; PETAL-LONG-1-2SIDE
JP1: JST-2; JST-2-SMD
JP2, JP3: FIDUCIALUFIDUCIAL; MICRO-FIDUCIAL
LED1, LED2, LED3, LED4: RED; LED-0603
R1, R6, R7, R8: 330; 0603-RES
R2, R3: 10k; 0603-RES
R4, R5: 22; 0603-RES
S1: SWITCH-DPDTSMD; AYZ0202
S2: !RESET; TACTILE_SWITCH_SMD
U1: MCP73831; SOT23-5
U2: MIC5219; SOT23-5
U3: ATMEGA32U4QFN; QFN-44
U$1: LOGO-LPLPA; LOGO-LPA
U$13: LOGO-LPLP; LOGO-LILYPAD
X1: USB-MICROB
Y1: 8MHz; RESONATOR-SMD

Connections:
3.3V: +.1, C2.2, C3.2, C4.2, C5.2, C6.2, LED2.A, LED3.A, R3.1, U2.5 (OUT), U3.6 (UCAP), U3.14 (VCC), U3.24 (AVCC), U3.34 (VCC), U3.42 (AREF), U3.44 (AVCC)
5V: C7.2, D1.C, R1.2, S1.1, U1.4 (VIN), U2.1 (IN), U3.7 (VBUS), X1.VBUS
D+: R4.1, U3.4 (D+)
D-: R5.1, U3.3 (D-)
GND: -.1, C1.2, C2.1, C3.1, C4.1, C5.1, C6.1, C7.1, C8.1, JP1.1 (2), LED4.C, R2.1, S1.3, S2.1, U1.2 (VSS), U2.2 (GND), U3.5 (UGND), U3.15 (GND), U3.23 (GND), U3.33 (PE2/!HWB), U3.35 (GND), U3.43 (GND), U3.EPAD (GND), X1.GND, X1.MT1 (GND), X1.MT2 (GND), Y1.2
MISO: U3.11 (PB3(MISO))
MOSI: U3.10 (PB2(MOSI))
unnamed: LED2.C, R6.1
unnamed: S1.2, U2.3 (EN)
unnamed: LED1.A, R1.1
unnamed: LED1.C, U1.1 (STAT)
unnamed: U3.17 (XTAL1), Y1.1
unnamed: R2.2, U1.5 (PROG)
unnamed: U3.16 (XTAL2), Y1.3
unnamed: C1.1, U2.4 (BP)
unnamed: D11.1, U3.12 (PB7)
unnamed: D10.1, U3.30 (PB6(ADC13))
unnamed: D9.1, U3.29 (PB5(ADC12))
unnamed: D5.1, U3.19 (PD1(SDA))
unnamed: D6.1, U3.18 (PD0(SCL))
unnamed: A5.1, U3.41 (PF0(ADC0))
unnamed: A4.1, U3.40 (PF1(ADC1))
unnamed: A3.1, U3.39 (PF4(ADC4))
unnamed: A2.1, U3.38 (PF5(ADC5))
unnamed: LED4.A, R8.1
unnamed: R5.2, X1.D-
unnamed: R4.2, X1.D+
unnamed: LED3.C, R7.1
RESET: R3.2, S2.3 (2), U3.13 (!RESET)
RX_LED: R6.2, U3.8 (PB0(SS))
SCK: U3.9 (PB1(SCK))
TX_LED: R7.2, U3.22 (PD5)
USER_LED: R8.2, U3.32 (PC7)
V_BATT: C8.2, D1.A, JP1.2 (1), U1.3 (VBAT)

Notes on the sheet:
32u4 BYPASS
MIC5219 BYPASS
Mike Hord
Original Lilypad Design by:
L. Buechly and N. Seidle
Charge Circuit Bypass
Battery Input Bypass

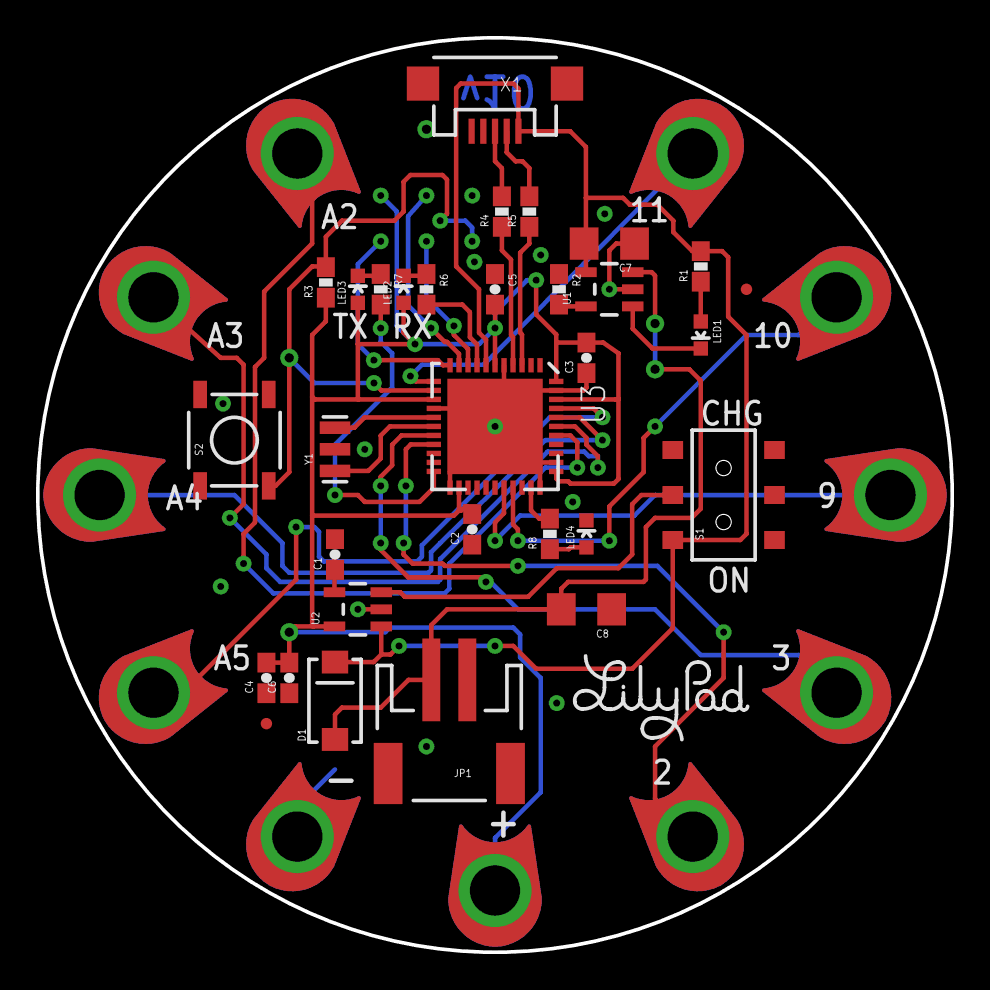
[picture p95: board Arduino-lilypad-USB.brd from above]

Board: 2 copper layers, 50.8 x 50.8 mm, 44 parts (1 on the bottom side), 31 nets.
