PaxInstruments/t400-electronics/referenceDesigns/Sparkfun-Weather Shield.brd

## EAGLE design referenceDesigns/Sparkfun-Weather Shield.brd (2014-09-02)

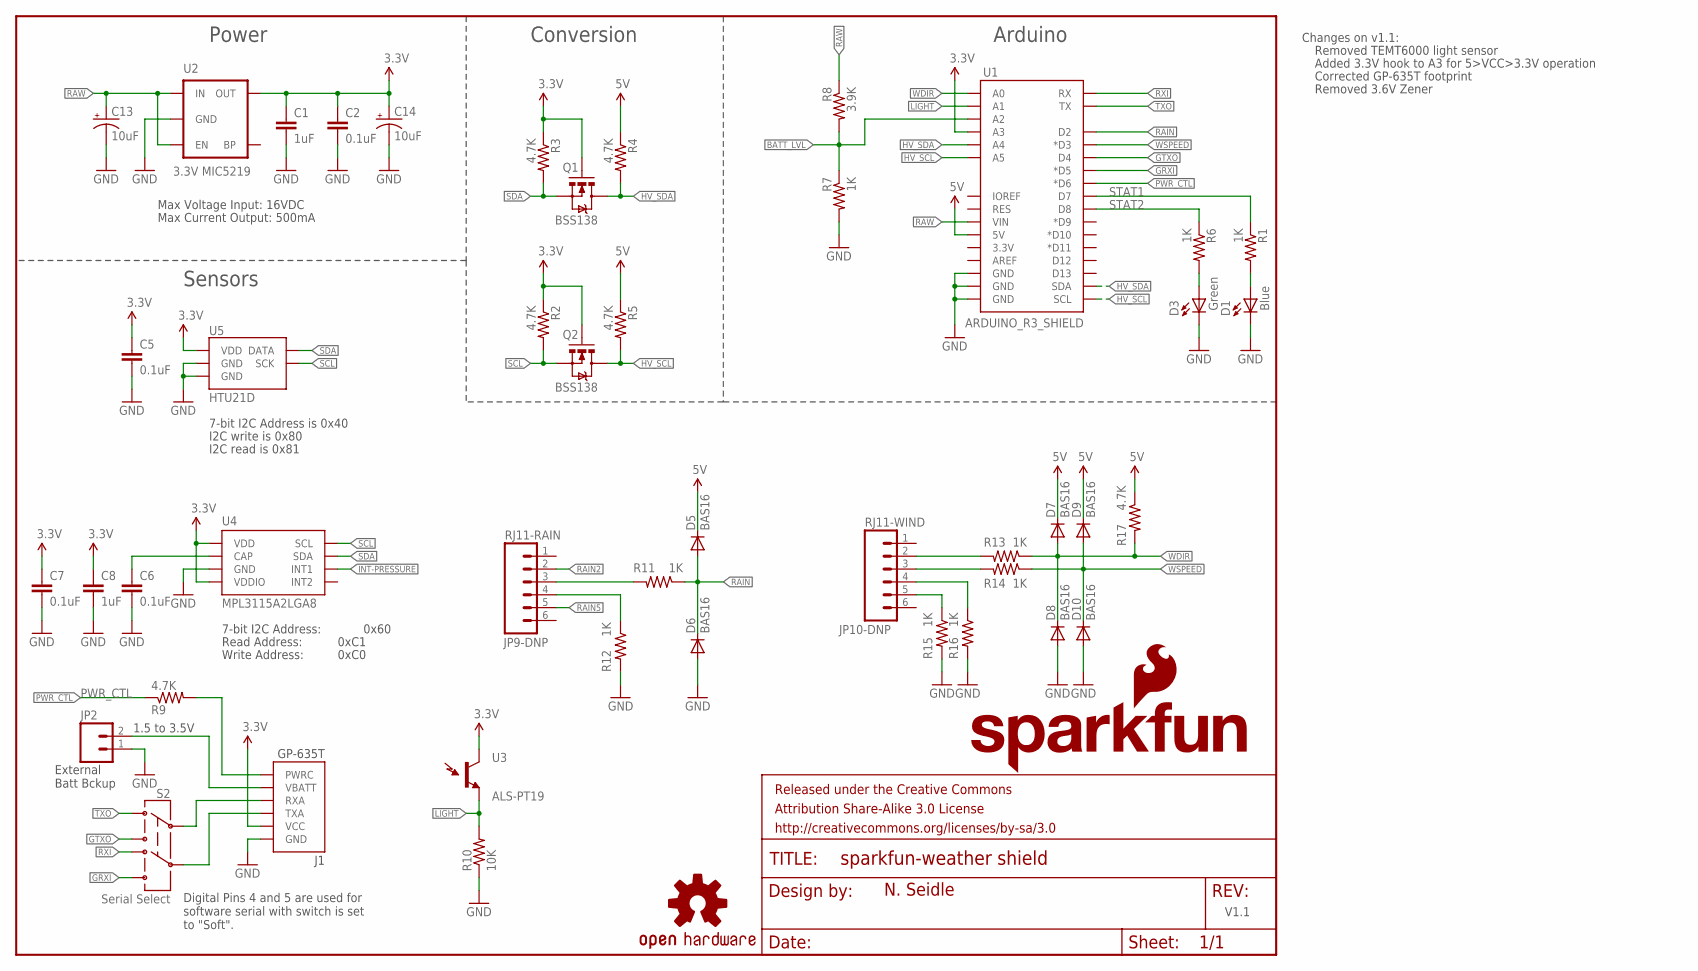
[picture p96: schematic Sparkfun-Weather Shield.sch]

Parts:
C1, C8: 1uF; 0603-CAP
C2, C5, C6, C7: 0.1uF; 0603-CAP
C13, C14: 10uF; EIA3216
D1: Blue; LED-0603
D3: Green; LED-0603
D5, D6, D7, D8, D9, D10: BAS16; SOD-323
FRAME1: FRAME-LETTER; CREATIVE_COMMONS
J1: GP-635T
JP2: External Batt Bckup; 1X02
JP9-DNP: RJ11-RAIN; RJ11-6
JP10-DNP: RJ11-WIND; RJ11-6
LOGO1: OSHW-LOGOM; OSHW-LOGO-M
LOGO2: SFE_LOGO_NAME_FLAME.1_INCH; SFE_LOGO_NAME_FLAME_.1
Q1, Q2: BSS138; SOT23-3
R1, R6, R7, R11, R12, R13, R14, R15, R16: 1K; 0603-RES
R2, R3, R4, R5, R9, R17: 4.7K; 0603-RES
R8: 3.9K; 0603-RES
R10: 10K; 0603-RES
S2: Serial Select; AYZ0202
U1: ARDUINO_R3_SHIELD; UNO_R3_SHIELD
U2: 3.3V MIC5219; SOT23-5
U3: ALS-PT19
U4: MPL3115A2LGA8; LGA8
U5: HTU21D

Connections:
3.3V: C1.1, C2.1, C5.1, C7.1, C8.1, C14.A (+), J1.2 (VCC), Q1.1 (G), Q2.1 (G), R2.1, R3.1, U1.A3, U2.5 (OUT), U3.C (C1), U4.1 (VDD), U4.4 (VDDIO), U5.VDD
3V_PWR_CTL: J1.6 (PWRC), R9.2
5V: D5.1 (C), D7.1 (C), D9.1 (C), R4.1, R5.1, R17.1, U1.5V
BATT_LVL: R7.1, R8.2, U1.A2
GND: C1.2, C2.2, C5.2, C6.2, C7.2, C8.2, C13.C (-), C14.C (-), D1.C, D3.C, D6.2 (A), D8.2 (A), D10.2 (A), J1.1 (GND), JP2.1, R7.2, R10.1, R12.2, R15.2, R16.2, U1.GND@0 (GND), U1.GND@1 (GND), U1.GND@2 (GND), U2.2 (GND), U4.3 (GND), U5.7 (GND), U5.GND
GPS-RX: J1.4 (RXA), S2.2
GPS-TX: J1.3 (TXA), S2.5
GRXI: S2.6, U1.D5 (*D5)
GTXO: S2.3, U1.D4
HV_SCL: Q2.3 (D), R5.2, U1.A5, U1.SCL
HV_SDA: Q1.3 (D), R4.2, U1.A4, U1.SDA
INT-PRESSURE: U4.6 (INT1)
LIGHT: R10.2, U1.A1, U3.E (E1)
unnamed: JP10-DNP.3, R14.2
unnamed: JP10-DNP.2, R13.2
unnamed: D1.A, R1.2
unnamed: JP9-DNP.3, R11.2
unnamed: C6.1, U4.2 (CAP)
unnamed: D3.A, R6.2
unnamed: JP9-DNP.4, R12.1
unnamed: JP10-DNP.5, R15.1
unnamed: JP10-DNP.4, R16.1
PWR_CTL: R9.1, U1.D6 (*D6)
RAIN: D5.2 (A), D6.1 (C), R11.1, U1.D2
RAIN2: JP9-DNP.2
RAIN5: JP9-DNP.5
RAW: C13.A (+), R8.1, U1.VIN, U2.1 (IN), U2.3 (EN)
RXI: S2.4, U1.RX
SCL: Q2.2 (S), R2.2, U4.8 (SCL), U5.SCK
SDA: Q1.2 (S), R3.2, U4.7 (SDA), U5.DATA
STAT1: R1.1, U1.D7
STAT2: R6.1, U1.D8
TXO: S2.1, U1.TX
V_BATT: J1.5 (VBATT), JP2.2
WDIR: D7.2 (A), D8.1 (C), R13.1, R17.2, U1.A0
WSPEED: D9.2 (A), D10.1 (C), R14.1, U1.D3 (*D3)

Notes on the sheet:
Max Voltage Input: 16VDC
Max Current Output: 500mA
N. Seidle
Read Address:
Write Address:
7-bit I2C Address:
0x60
0xC1
0xC0
7-bit I2C Address is 0x40
I2C write is 0x80
I2C read is 0x81
1.5 to 3.5V
External Batt Bckup
Sensors
Power
Conversion
Arduino
Changes on v1.1:
Removed TEMT6000 light sensor
Added 3.3V hook to A3 for 5>VCC>3.3V operation
Corrected GP-635T footprint
Removed 3.6V Zener
V1.1
Digital Pins 4 and 5 are used for software serial with switch is set to "Soft".

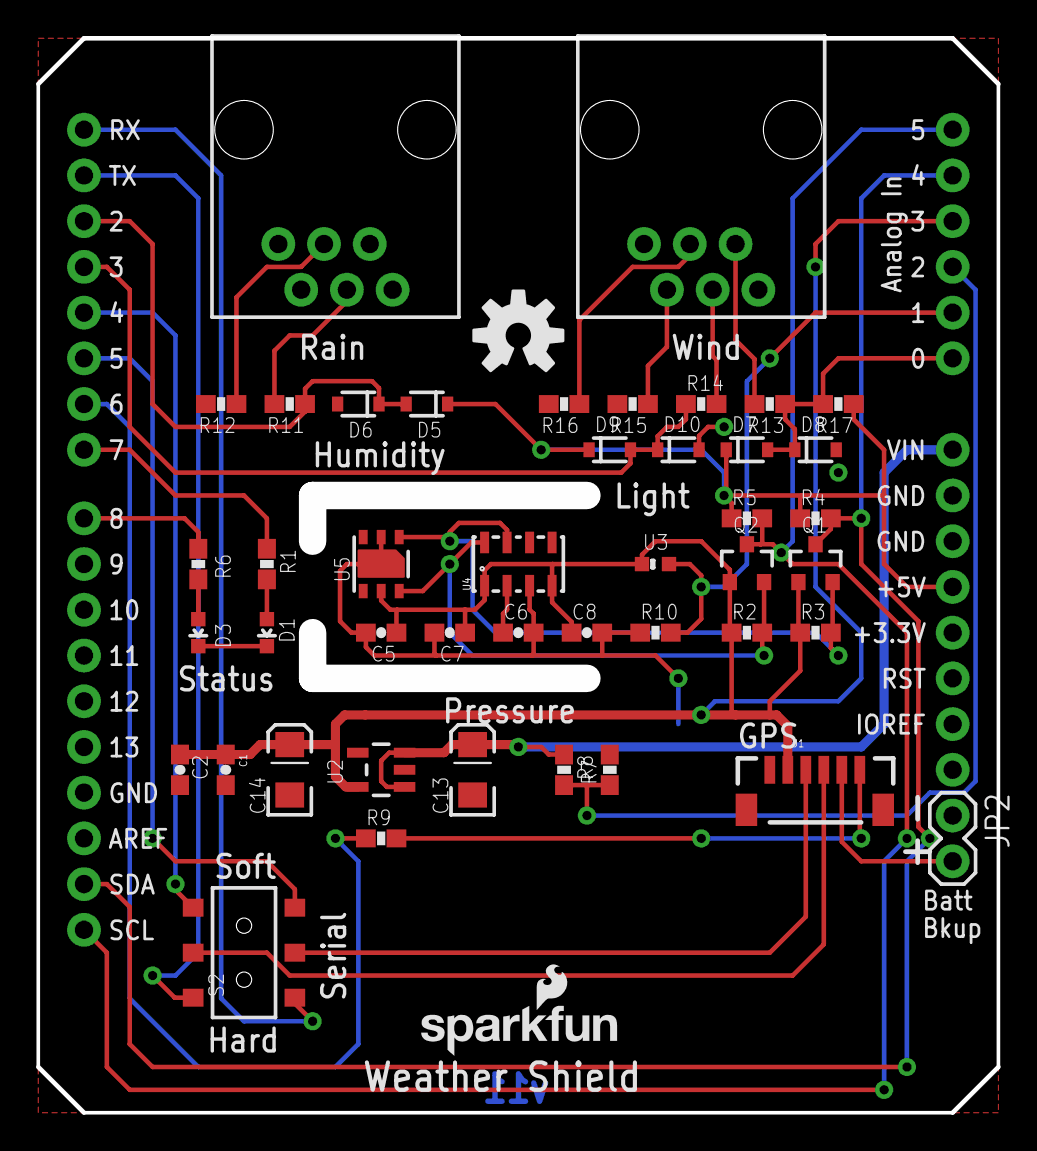
[picture p97: board Sparkfun-Weather Shield.brd from above]

Board: 2 copper layers, 53.3 x 59.7 mm, 48 parts (0 on the bottom side), 33 nets.
