PaxInstruments/t400-electronics/referenceDesigns/BlinkyLabs-BlinkyBoard.brd

## EAGLE design referenceDesigns/BlinkyLabs-BlinkyBoard.brd (2014-09-02)

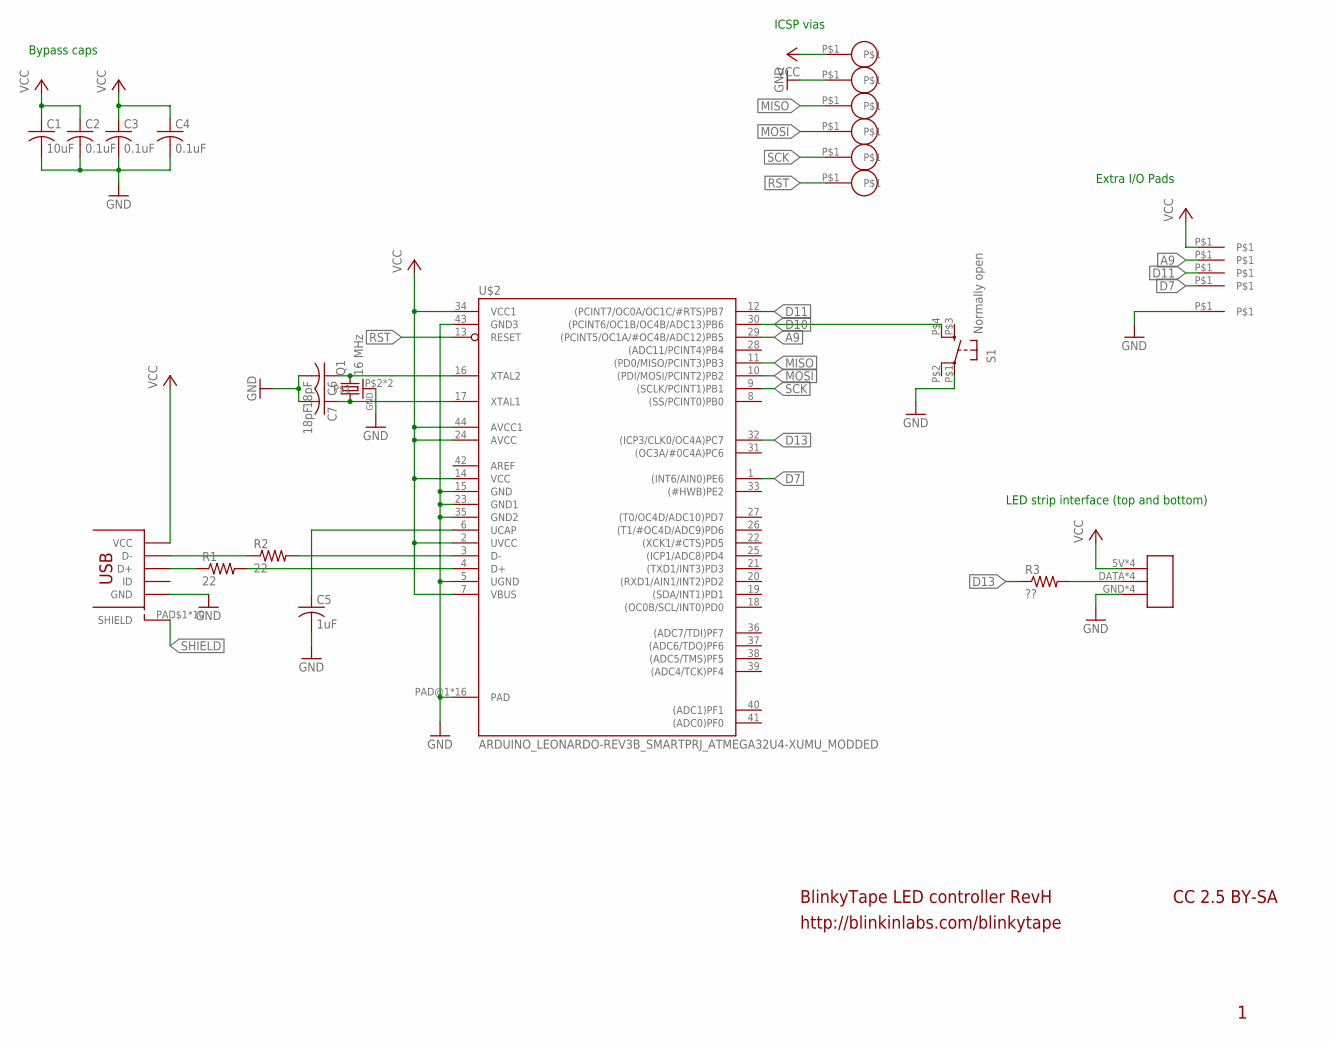
[picture p98: schematic BlinkyLabs-BlinkyBoard.sch]

Parts:
C1: 10uF; C0603K
C2, C3, C4: 0.1uF; CAP_0402_KEMET_MEDIAN
C5: 1uF; CAP_0402_KEMET_MEDIAN
C6, C7: 18pF; CAP_0402_KEMET_MEDIAN
Q1: 16 MHz; CRSYTAL_2520
R1, R2: 22; RES_0402_KEMET_MEDIAN
R3: ??; RES_0402_KEMET_MEDIAN
S1: Normally open; GLOWBOARD_KMR211G_SWITCH
U$1, U$3, U$5, U$6, U$7, U$8: TEST_VIA; TEST_VIA_.5MM
U$2: ARDUINO_LEONARDO-REV3B_SMARTPRJ_ATMEGA32U4-XUMU_M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; QFN44ML_7X7_LONGLEADS_MOD
U$4: MICRO_USBSMT+THRUHULE; MICRO_USB_FCI_THRUHOLE
U$9: WS2812B_CONNECTOR
U$10, U$11, U$12, U$13, U$14: TEST_PAD_SMT

Connections:
A9: U$2.29 ((PCINT5/OC1A/#OC4B/ADC12)PB5), U$11.P$1
AREF: U$2.42 (AREF)
D7: U$2.1 ((INT6/AIN0)PE6), U$10.P$1
D10: S1.P$4 (S1), U$2.30 ((PCINT6/OC1B/OC4B/ADC13)PB6)
D11: U$2.12 ((PCINT7/OC0A/OC1C/#RTS)PB7), U$14.P$1
D13: R3.P$1 (1), U$2.32 ((ICP3/CLK0/OC4A)PC7)
D+: R1.P$2 (2), U$2.4 (D+)
D+_IN: R1.P$1 (1), U$4.PIN$3 (D+)
D-: R2.P$2 (2), U$2.3 (D-)
D-_IN: R2.P$1 (1), U$4.PIN$2 (D-)
GND: C1.2, C2.P$2 (2), C3.P$2 (2), C4.P$2 (2), C5.P$2 (2), C6.P$2 (2), C7.P$2 (2), Q1.P$2, Q1.P$4, S1.P$1, U$2.5 (UGND), U$2.15 (GND), U$2.23 (GND1), U$2.35 (GND2), U$2.43 (GND3), U$2.PAD@1 (PAD), U$2.PAD@2 (PAD), U$2.PAD@3 (PAD), U$2.PAD@4 (PAD), U$2.PAD@5 (PAD), U$2.PAD@6 (PAD), U$2.PAD@7 (PAD), U$2.PAD@8 (PAD), U$2.PAD@9 (PAD), U$2.PAD@10 (PAD), U$2.PAD@11 (PAD), U$2.PAD@12 (PAD), U$2.PAD@13 (PAD), U$2.PAD@14 (PAD), U$2.PAD@15 (PAD), U$2.PAD@16 (PAD), U$4.PIN$5 (GND), U$7.P$1, U$9.GND, U$9.GND1 (GND), U$9.GND_1 (GND), U$9.GND_2 (GND), U$13.P$1
LED_DATA: R3.P$2 (2), U$9.DATA, U$9.DATA1 (DATA), U$9.DATA_1 (DATA), U$9.DATA_2 (DATA)
MISO: U$1.P$1, U$2.11 ((PD0/MISO/PCINT3)PB3)
MOSI: U$2.10 ((PDI/MOSI/PCINT2)PB2), U$3.P$1
unnamed: C5.P$1 (1), U$2.6 (UCAP)
unnamed: C6.P$1 (1), Q1.P$3 (2), U$2.16 (XTAL2)
unnamed: C7.P$1 (1), Q1.P$1 (1), U$2.17 (XTAL1)
RST: U$2.13 (RESET), U$6.P$1
SCK: U$2.9 ((SCLK/PCINT1)PB1), U$5.P$1
SHIELD: U$4.PAD$1 (SHIELD), U$4.PAD$2 (SHIELD), U$4.PAD$3 (SHIELD), U$4.PAD$4 (SHIELD), U$4.PAD$5 (SHIELD), U$4.PAD$6 (SHIELD), U$4.PAD$7 (SHIELD), U$4.PAD$8 (SHIELD), U$4.PAD$9 (SHIELD), U$4.PAD$10 (SHIELD)
VCC: C1.1, C2.P$1 (1), C3.P$1 (1), C4.P$1 (1), U$2.2 (UVCC), U$2.7 (VBUS), U$2.14 (VCC), U$2.24 (AVCC), U$2.34 (VCC1), U$2.44 (AVCC1), U$4.PIN$1 (VCC), U$8.P$1, U$9.5V, U$9.5V1 (5V), U$9.5V_1 (5V), U$9.5V_2 (5V), U$12.P$1

Notes on the sheet:
BlinkyTape LED controller RevH
http://blinkinlabs.com/blinkytape
CC 2.5 BY-SA
Bypass caps
ICSP vias
Extra I/O Pads
LED strip interface (top and bottom)

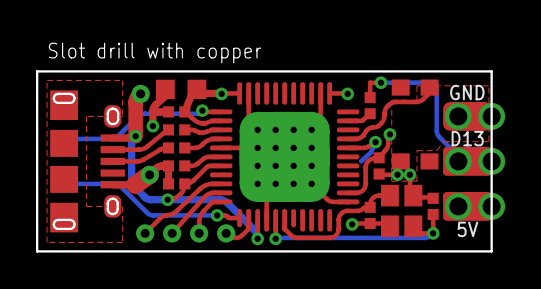
[picture p99: board BlinkyLabs-BlinkyBoard.brd from above]

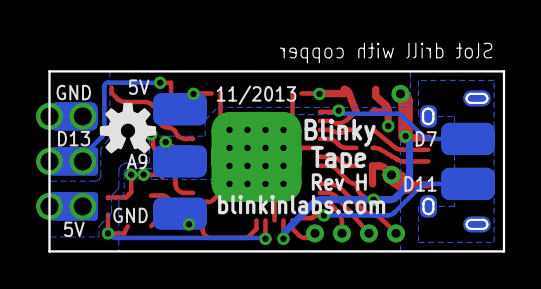
[picture p100: board BlinkyLabs-BlinkyBoard.brd from below]

Board: 2 copper layers, 25.2 x 10.0 mm, 27 parts (7 on the bottom side), 20 nets.

Other parts of the board:
U$15: OSHW-LOGO-S
