PaxInstruments/t400-electronics/referenceDesigns/Arduino-leonardo.brd

## EAGLE design referenceDesigns/Arduino-leonardo.brd (continued)



Board: 2 copper layers, 68.6 x 53.3 mm, 51 parts (2 on the bottom side), 51 nets.
