PaxInstruments/t400-electronics/(commit log)

2014-08-28 - Updated the LCD controller data sheet 0.1 —> 1.3
2014-09-01 - Added eagle files - Updated Sitronix data sheet. This is directly from Sitronix
    [PaxInstrument-T400.brd, PaxInstrument-T400.sch]
2014-09-01 - Added battery data sheet
2014-09-02 - Added reference designs
    [Arduino-leonardo.brd, Arduino-leonardo.sch, Arduino-lilypad-USB.brd, Arduino-lilypad-USB.sch, BlinkyLabs-BlinkyBoard.brd, BlinkyLabs-BlinkyBoard.sch, Freetronics-LeoStick.brd, Freetronics-LeoStick.sch]
2014-09-03 - Removed pressure and humidity sensors - updated .gitignore
    [PaxInstrument-T400.brd, PaxInstrument-T400.sch]
2014-09-04 - Removed buzzer - Removed some traces - Nudged and schematic symbols
    [PaxInstrument-T400.brd, PaxInstrument-T400.sch]
2014-09-07 - Change the MCP73831 programming resistor 2k, so it will charge at 500 mA. - Buzzer pin reassigned to VBAT_EN. Bring VBAT_EN to measure VBAT. - LCD_BL now drains rather than sources LCD backlight po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
    [PaxInstrument-T400.brd, PaxInstrument-T400.sch]
2014-09-07 - Removed TEMP_INT
    [PaxInstrument-T400.brd, PaxInstrument-T400.sch]
2014-09-09 - Updated part numbers. There may be some 0804 parts sourced at 0603. Fix this.
    [PaxInstrument-T400.brd, PaxInstrument-T400.sch]
2014-09-16 - Added digikey info
    [PaxInstrument-T400.brd, PaxInstrument-T400.sch]
2014-10-06 - Added PSI flash datasheet - Added SPI flash to charlespax library - Added SPI flash to T400 schematic - updated .gitignore
    [PaxInstrument-T400.brd, PaxInstrument-T400.sch]
2014-10-06 - Moved headers apart https://github.com/PaxInstruments/t400-electronics/issues/75
    [PaxInstrument-T400.brd, PaxInstrument-T400.sch]
2014-10-07 - Moved switches a little
    [PaxInstrument-T400.brd, PaxInstrument-T400.sch]
2014-10-16 - Still laying out board
    [PaxInstrument-T400.brd, PaxInstrument-T400.sch]
2014-11-07 - updated flash chip
    [PaxInstrument-T400.brd, PaxInstrument-T400.sch]
2014-11-13 - All items on the board should stay as-is
    [PaxInstrument-T400.brd, PaxInstrument-T400.sch]
2014-11-13 - battery moved to correct location
    [PaxInstrument-T400.brd, PaxInstrument-T400.sch]
2014-11-18 PCB layout and schematic update by Sam
    -Swapped I/O for PCB layout
    -Swapped ADC channel for PCB layout
    -Bug fixed Flash_CS pin unconnected and replaced DATA3
    - ICSP changed USBVCC to N$20
    - ICSP1 removed DATA3
    [PaxInstrument-T400.brd, PaxInstrument-T400.sch]
2014-11-18 - added TC connector prototype
    [tc-connector.SLDPRT]
2014-11-19 fixed 'regulator' spelled wrong on schematic
    Minor bug fixed in schematic
    [PaxInstrument-T400.sch]
2014-11-20 - Moved buttons 0.04 inches closer to the edge. This is to better fit the enclosure. - Renamed ICSP power in to VBUS_IN - Added labels to the SMT headers - Updated pin assignments on silkscreen
    [PaxInstrument-T400.brd, PaxInstrument-T400.sch]
2014-11-20 Swapped IO pins assignment
    - Pin 22 assigned for TXLED
    - Pin 36 assigned for LCD_CS
    - Pin 37 assigned for FLASH_CS
    - Pin 38 assigned for SD_CS
    - Pin 39 assigned for VBAT_EN
    - Pin 40 assigned for SW_D
    - Pin 41 assigned for SW_E
    [PaxInstrument-T400.brd, PaxInstrument-T400.sch]
2014-11-21 - Updated pin assignments on silkscreen - Added Pax Instruments to silkscreen - Approved DRC switch issues
    [PaxInstrument-T400.brd, PaxInstrument-T400.sch]
2014-11-26 - Added connector drawing
    [tc-connector.SLDDRW]
2014-11-26 - Ignoring .dri and .gpi files. There are created when eagle generates gerber files.
2014-11-26 - Added electronics version 0.7 schematic pdf.
2014-11-29 - Flipped the PCB. Now it is easier see the layout and to make prototypes.
    [PaxInstrument-T400.brd]
2014-12-02 Generate these information to collect quotation from factory
    [PaxInstrument-T400.sch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]
2014-12-05 - Added a jumper
    [PaxInstrument-T400.brd, PaxInstrument-T400.sch]
2014-12-11 update PCB and Schematic for Rev 0.9
    -Added test point for USBVCC, VBUSIN, VBUS, 3.3V, VBAT
    -Added Test hook for GND
    -Added indentation on the side of PCB for LCD cable
    -Removed battery charging PTC fuse
    -Swap "toogle channels" and "Logging start/stop" (not complete layout)
    -Swap "Backlight ON/OFF" and " Logging Delta T" (Not complete layout)
    -Keep components away from the standoff at least 7mm
    -Added jumper between VBUS and PWR_ONOFF
    -Removed carbon pad contact
    -Add jumper inline with the battery to measure the current
    -Changed Solder mask for ATmega32U4 QFN component
    [PaxInstrument-T400.brd, PaxInstrument-T400.sch]
2014-12-14 update PCB for Rev 0.9
    - Fixed RTC battery in LCD keepout area (issue #89)
    - Fixed Place current test jumper on back side of PCB (issue #90)
    [PaxInstrument-T400.brd, PaxInstrument-T400.sch]
2014-12-15 Update PCB for 0.9
    - Rerouted the trace nearby the MCU
    - Modify the position of the battery connector (fixed issue #83)
    - Added milled slot at USB connector outside the PCB
    - Added Panel design recommendation document
    [PaxInstrument-T400.brd, PaxInstrument-T400.sch]
2014-12-16 Updated Rev 0.8 BOM list
    - Corrected part number
    - Added brand name of each components
    [t400-0.8 BOM.xls]
2014-12-18 Update PCB for Rev 0.9
    - Changed ATmega32U4 package with GND under IC
    - Changed TC connector (Keystone P/N: 3572)
    - Changed SD connector (SeeedStudio P/N: ST-TF-003A) (issue #79)
    - Changed I/O pin assignment
    - Changed debug port assignment
    - All air wire completed routing
    [PaxInstrument-T400.brd, PaxInstrument-T400.sch]
2014-12-22 Update PCB for Rev 0.9
    Fixed TC footprint mills through silkscreen #103
    [PaxInstrument-T400.brd, PaxInstrument-T400.sch]
2014-12-22 Updated PCB for Rev 0.9
    - Fixed incorrect SPI flash pin assignment
    - Updated SPI flash package to <208mil SOIC> (#104)
    [PaxInstrument-T400.brd]
2014-12-22 Updated PCB for Rev 0.9
    - Update pinmap silkscreen documentation (#102)
    [PaxInstrument-T400.brd]
2014-12-22 Updated PCB for Rev 0.9
    Remove unnecessary i2c addresses on label (issue #99)
    [PaxInstrument-T400.brd]
2014-12-22 Updated PCB for Rev 0.9
    Label GND test hook on both sides #98
    [PaxInstrument-T400.brd]
2014-12-22 Updated PCB for Rev 0.9
    Updated Micro SD card position and reach enclosure edge (issue #79)
    [PaxInstrument-T400.brd]
2014-12-22 Updated PCB and library for Rev 0.9
    - Updated test point library for both side solder mask (issue #106)
    [PaxInstrument-T400.brd, PaxInstrument-T400.sch]
2014-12-22 Updated PCB and Library for Rev 0.9
    - Update test hook dill size for test hook (issue #38)
    [PaxInstrument-T400.brd, PaxInstrument-T400.sch]
2014-12-22 Gerber file for Rev 0.9
    [PaxInstrument-T400.sch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]
2014-12-23 Added Arduino Leonardo photos
2014-12-23 Updated PCB and Library for Rev 0.9
    -Updated Thermocouple connector milled slots close to footprint edge
    (issue #111)
    -Added restricted area under milled slots to prevent short circuit
    -modify milling slot (> 0.8mm) to meet PCB factory capability
    [PaxInstrument-T400.brd, PaxInstrument-T400.sch]
2014-12-23 Updated Gerber file for Rev 0.9
    [CopperBottom.GBL, CopperTop.GTL, Dimension.GKO, SoldermaskTop.GTS, SolderpasteTop.GTP]
2014-12-24 Updated Gerber and PCB for Rev 0.9
    [PaxInstrument-T400.brd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]
2015-01-07 Remove fiducials for Rev 0.10
    Fix issue Remove fiducials #125
    [PaxInstrument-T400.brd, PaxInstrument-T400.sch]
2015-01-07 Changed Longer soler pads on 2x3 header footprint for Rev 0.10
    Changed Longer soler pads on 2x3 header footprint #122
    [PaxInstrument-T400.brd, PaxInstrument-T400.sch]
2015-01-07 Switch to 0603
    Switch to 0603 #121
    [PaxInstrument-T400.brd, PaxInstrument-T400.sch]
2015-01-11 Updated Rev 0.10 schematic and library
    - What test points are needed? #37 (Added test point for BATT_STAT,
    VBAT_SENSE, VBAT_EN -3V3EN in schematic)
    - New soft power circuit #134 (Updated schematic only)
    [PaxInstrument-T400.brd, PaxInstrument-T400.sch]
2015-01-11 Updated schematic for Rev 0.10
    - see Use smaller diodes #14 (added supervision IC and Mosfet in Battery
    charging circuit)
    [PaxInstrument-T400.brd, PaxInstrument-T400.sch]
2015-01-16 Updated for Rev 0.10
    - Power on/off output low #118
    - Adjust the thermal-couple connector width #138
    - Add backlight test point #133
    - Add FLASH_CS test point #132
    - Add SD_CS test point #131
    [PaxInstrument-T400.brd, PaxInstrument-T400.sch]
2015-01-16 Updated for Rev 0.10
    - Fixed Some capacitor still using 0805 package (Switch to 0603 #121)
    [PaxInstrument-T400.brd, PaxInstrument-T400.sch]
2015-01-22 Updated for Rev 0.10
    - Align 2x3 headers and enclosure cutouts #97
    - Longer solder pads on 2x3 header footprint #122 (Change back to nomal
    size)
    - Add both QFN and TQFP footprints for the 32u4 #68
    [PaxInstrument-T400.brd, PaxInstrument-T400.sch]
2015-01-23 Updated for Rev 0.10
    - Completed all Air wire
    [PaxInstrument-T400.brd, PaxInstrument-T400.sch]
2015-01-25 Graphics
    - Added a directory with the logo
    [logo.dxf]
2015-01-25 Update for Rev 0.10
    - Fixed Pax Instruments logo missing #27
    - Added Two LCD connector footprints #140
    - Added LCD connector 1.0 mm footrpint #137
    - Fixed Resistors are close together #120
    - Fixed Resistors are close to RTC battery #119
    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
    [PaxInstrument-T400.brd, PaxInstrument-T400.sch]
2015-01-25 Updated for Rev 0.10
    - Fixed PCB mounting holes #139
    [PaxInstrument-T400.brd, PaxInstrument-T400.sch]
2015-01-25 Updated for Rev 0.10
    -Fixed Inductor between isothermal plane and GND #123
    - Backlight brightness levels #109 (LCD_BL assigned to D6)
    - Updated LCD backlight resistor to 3.3R #108
    - Properly ground isothermal plane #59 (3.3V regulator place nearby
    Analog circuit)
    - What are the effects of input voltage on the 32u4 internal reference
    voltage? #43 (Disconnected 3.3V from ARef pin)
    [PaxInstrument-T400.brd, PaxInstrument-T400.sch]
2015-01-25 Added test Point for ISOTHERMAL
    - What test points are needed? #37
    [PaxInstrument-T400.brd, PaxInstrument-T400.sch]
2015-01-27 Gerber file for Rev 0.10
    [CopperBottom.GBL, CopperTop.GTL, Dimension.GKO, SikscreenBottom.GBO, SilkscreenTop.GTO, SolderPasteBottom.GBP, SoldermaskBottom.GBS, SoldermaskTop.GTS]
2015-01-27 Fixed the solder mask/paste bug of 0.1 LCD connector
    [PaxInstrument-T400.brd, PaxInstrument-T400.sch]
2015-02-06 Updated schematic
    - Charging status unstable while No battery installed #147
    [PaxInstrument-T400.brd, PaxInstrument-T400.sch]
2015-02-27 Added more via in isothermal plane
    Isothermal plane vias #157
    [PaxInstrument-T400.brd]
2015-02-27 Move I2C bus running on top layer in isothermal plane
    Fixed Isothermal plane lateral heat transfer #158
    [PaxInstrument-T400.brd]
2015-02-27 Updated Silkscreen on ICSP header
    Silkscreen on ICSP header misleading #151
    [PaxInstrument-T400.brd]
2015-02-27 Added slots to aid the assembly process
    PCB locating feature #154
    [PaxInstrument-T400.brd]
2015-02-27 Updated MicroSD card position and LCD connector PCB package in library
    MicroSD card overhang #144
    [PaxInstrument-T400.brd, PaxInstrument-T400.sch]
2015-03-04 Updated Soft power and Battery detect circuit design
    - bug fix issue #152
    [PaxInstrument-T400.brd, PaxInstrument-T400.sch]
2015-03-09 Update on PCB layout
    [PaxInstrument-T400.brd, PaxInstrument-T400.sch]
2015-03-14 Updated T-Flash connector and Remove unused 0.5 mm LCD connector
    - Fixed issue MicroSD card footprint #145
    - Remove unused 0.5 mm LCD connector #141
    [PaxInstrument-T400.brd, PaxInstrument-T400.sch]
2015-03-19 Added Tully's connector.
    [Clip-03-flat.igs, Clip-03-flat.stp, Clip-03.igs, Clip-03.stp]
2015-03-19 Added TC connector 3D file.
    [clip.SLDPRT]
2015-03-29 Added datasheet. Added new thermocouple 3D model.
    [Clip-03.SLDPRT, Clip-05.SLDPRT, Clip-05.igs, Clip-05.stl, Part2.SLDPRT, tc-connector-2.SLDDRW, tc-connector-2.SLDPRT]
2015-03-29 Added dimensions.
    [tc-connector-2.SLDDRW]
2015-04-04 Update on Schematic
    - MCP9800 part number #161
    - Bug in soft Power circuit #160
    [PaxInstrument-T400.brd, PaxInstrument-T400.sch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]
2015-04-04 Added flip-flop datasheet. Added prototype thermocouple connectors.
    [tc-connector-3.SLDPRT, tc-connector-4.SLDPRT]
2015-04-08 Added new thermocouple connector design.
    [tc-connector-5-iges.SLDPRT]
2015-04-08 Now I'm uploading the file. The previous commit was the original iges model.
    [tc-connector-5.SLDPRT]
2015-04-15 Update on PCB layout, schematic and library
    [PaxInstrument-T400.brd, PaxInstrument-T400.sch]
2015-04-18 Update ON PCB layout and library
    [PaxInstrument-T400.brd, PaxInstrument-T400.sch]
2015-04-19 Adding the two most recent TC connector designs.
    [tc-connector-5.SLDPRT, tc-connector-6.SLDPRT, tc-connector-7.SLDPRT, tube-02-STEP-AP-203.stp, tube-02-STEP-AP-214.stp, tube-02.igs]
2015-04-19 Added a solidowrks model of the newest connector design.
    [tc-connector-7.SLDPRT]
2015-04-20 Updated PCB layout and schematic
    - Update material list #168
    - Battery polarity silkscreen #165
    - LCD connector placement #164
    - LCD connector #162
    - Connect buttons to interrupt pins #143
    - Battery charging rate #163
    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
    [PaxInstrument-T400.brd, PaxInstrument-T400.sch]
2015-06-04 Update filter resistor value #53
    [PaxInstrument-T400.brd, PaxInstrument-T400.sch]
2015-06-04 Update material list #168
    Updated battery connector part number (MPN)
    [PaxInstrument-T400.brd, PaxInstrument-T400.sch]
2015-06-18 Added new TC connector
    Thermocouple connector footprint #170
    [PaxInstrument-T400.brd, PaxInstrument-T400.sch]
2015-06-18 Added the latest version of the connector. 3D files and PDF.
    [Clip-03-flat.igs, Clip-03-flat.stp, Clip-03.SLDPRT, Clip-03.igs, Clip-03.stp, Clip-05.SLDPRT, Clip-05.igs, Clip-05.stl]
2015-07-28 Added a text board for the custom thermocouple.
    [tc connecor test spacing.brd, tc connecor test spacing.sch]
2015-07-31 Inside and outside draft versions chosen.
    [tc connecor test spacing.brd, tc connecor test spacing.sch]
2015-07-31 This could be the production footprint.:
    [tc connecor test spacing.brd, tc connecor test spacing.sch]
2015-08-02 Added a new test file.
    [tc connecor test spacing 2.brd, tc connecor test spacing 2.sch]
2015-08-05 Fuse removed
    Fuse temperature #172
    - Heat generated by fuse causing problem
    [PaxInstrument-T400.brd, PaxInstrument-T400.sch]
2015-08-10 Updated Atmega32U4 parts in library
    -fixed issue in MCU VBAT_SENSE on PD6 is not Analog Pin A10 #169
    [PaxInstrument-T400.sch]
2015-08-10 Updated TC connector
    Changed Keystone connector to thermo-Clip2 designed by Pax instrument.
    (Thermocouple connector placement #179)
    [PaxInstrument-T400.brd, PaxInstrument-T400.sch]
2015-08-10 Connect MCU VBUS pin to USB connector - VBUS_IN #183
    Updated schematic and it allows firmware using VBUS pin on MCU to detect
    USB power supply connection status.
    [PaxInstrument-T400.brd, PaxInstrument-T400.sch]
2015-08-11 Added a third TC connector test.
    [tc connecor test spacing 3.brd, tc connecor test spacing 3.sch]
2015-08-12 Updated PCB and Schematic
    -Thermocouple connector placement #179
    [PaxInstrument-T400.brd, PaxInstrument-T400.sch]
2015-08-12 Updated battery detect circuit in Sch and PCB layout
    - Internal analog reference voltage #156
    [PaxInstrument-T400.brd, PaxInstrument-T400.sch]
2015-08-18 updated schematic
    - Add 4.7k pulldown to VBUS input #188
    - DPN pull-up resisors #191
    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
    [PaxInstrument-T400.brd, PaxInstrument-T400.sch]
2015-08-18 Updated SCH and PCB
    [PaxInstrument-T400.brd, PaxInstrument-T400.sch]
2015-08-21 Updated PCB layout
    [PaxInstrument-T400.brd, PaxInstrument-T400.sch]
2015-08-25 Updated PCB
    - Move RTC_INT to PD3(INT3) and SW_B to PE6(INT6) #186
    - Move SW_PWR off of PB0/SS #184
    - Verify PCB version #182
    - Verify pin map #181
    - Fuse temperature #172
    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
    [PaxInstrument-T400.brd]
2015-08-25 Updated Schematic
    updated version number on schematic
    [PaxInstrument-T400.sch]
2015-08-26 Gerber file for Rev 0.13
    [PaxInstrument-T400.brd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]
2015-08-31 Updated PCB layout
    Traces through LCD slots #194
    Logo update #196
    Silkscreen overlap #195
    [PaxInstrument-T400.brd, PaxInstrument-T400.sch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]
2015-09-26 Extended the PCB to move the thermocouple connectors up. Changed the TC footprint.
    [PaxInstrument-T400.brd, PaxInstrument-T400.sch]
2015-09-26 Swapped thermocouple connectors for the new part. Closes #97. Extended top of PCB to hold TC connectors. Moved routing up.
    [PaxInstrument-T400.brd, PaxInstrument-T400.sch]
2015-10-03 Moved MicroSD card in 0.5 mm. Closes #205.
    [PaxInstrument-T400.brd]
2015-10-03 Added a bunch move vias to isothermal plane. Extended isothermal plane to match extended PCB. Closes #201
    [PaxInstrument-T400.brd]
2015-10-03 Closes #188.
    [PaxInstrument-T400.brd, PaxInstrument-T400.sch]
2015-10-04 Added 0.12 files to directory.
    [PaxInstrument-T400.brd, PaxInstrument-T400.sch]
2015-10-04 Added 0.13 files to directory.
    [PaxInstrument-T400.brd, PaxInstrument-T400.sch]
2015-12-11 Version 0.14 ready to order prototypes.
    [PaxInstrument-T400.brd, PaxInstrument-T400.sch]
2015-12-16 Added company logo, closes #206. Large logo on board, closes #180. Added URL, closes #207.
    [PaxInstrument-T400.brd]
2015-12-16 Updated the gerber files that include larger fonts on the silkscreen.
    [PaxInstrument-T400.brd]
2015-12-20 Added production notes and a board photograph.
2016-01-05 Added the start of an AT90USB version.
    [PaxInstrument-T400-at90usb.brd, PaxInstrument-T400-at90usb.sch]
2016-01-05 Added T400 location PDF. Moved component names on PCB file.
    [PaxInstrument-T400-at90usb.brd, PaxInstrument-T400-at90usb.sch, PaxInstrument-T400.brd]
