PaxInstruments/t400-electronics/(notices)

Notices in the files:
solidworks/old/tc-connector-7/tube-02.igs:
3D InterOp IGES (Version 21 0 3), Spatial Corp. Copyright (c) 1999-2007.S 1
parts and their libraries:
SparkFun-Sensors: Licensing: CC v3.0 Share-Alike You are welcome to use this library for commercial purposes.
SparkFun-Aesthetics: Released under the Creative Commons Attribution Share-Alike 3.0 License
SparkFun-Aesthetics: http://creativecommons.org/licenses/by-sa/3.0
